Laxilef/OTGateway/assets/2D_PCB_bottom.png

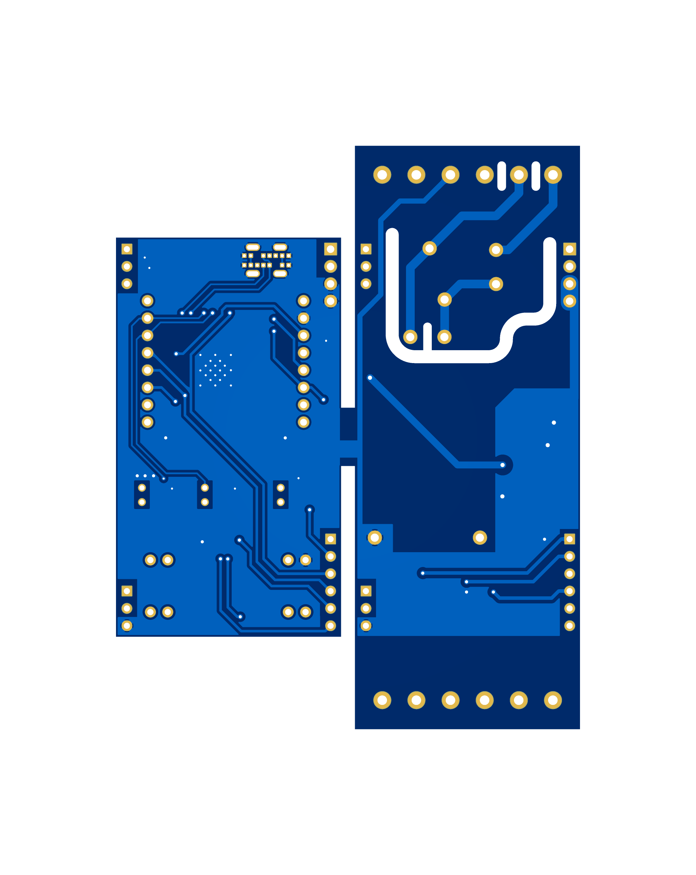
assets/2D_PCB_bottom.png
