Laxilef/OTGateway/assets/2D_PCB_top.png

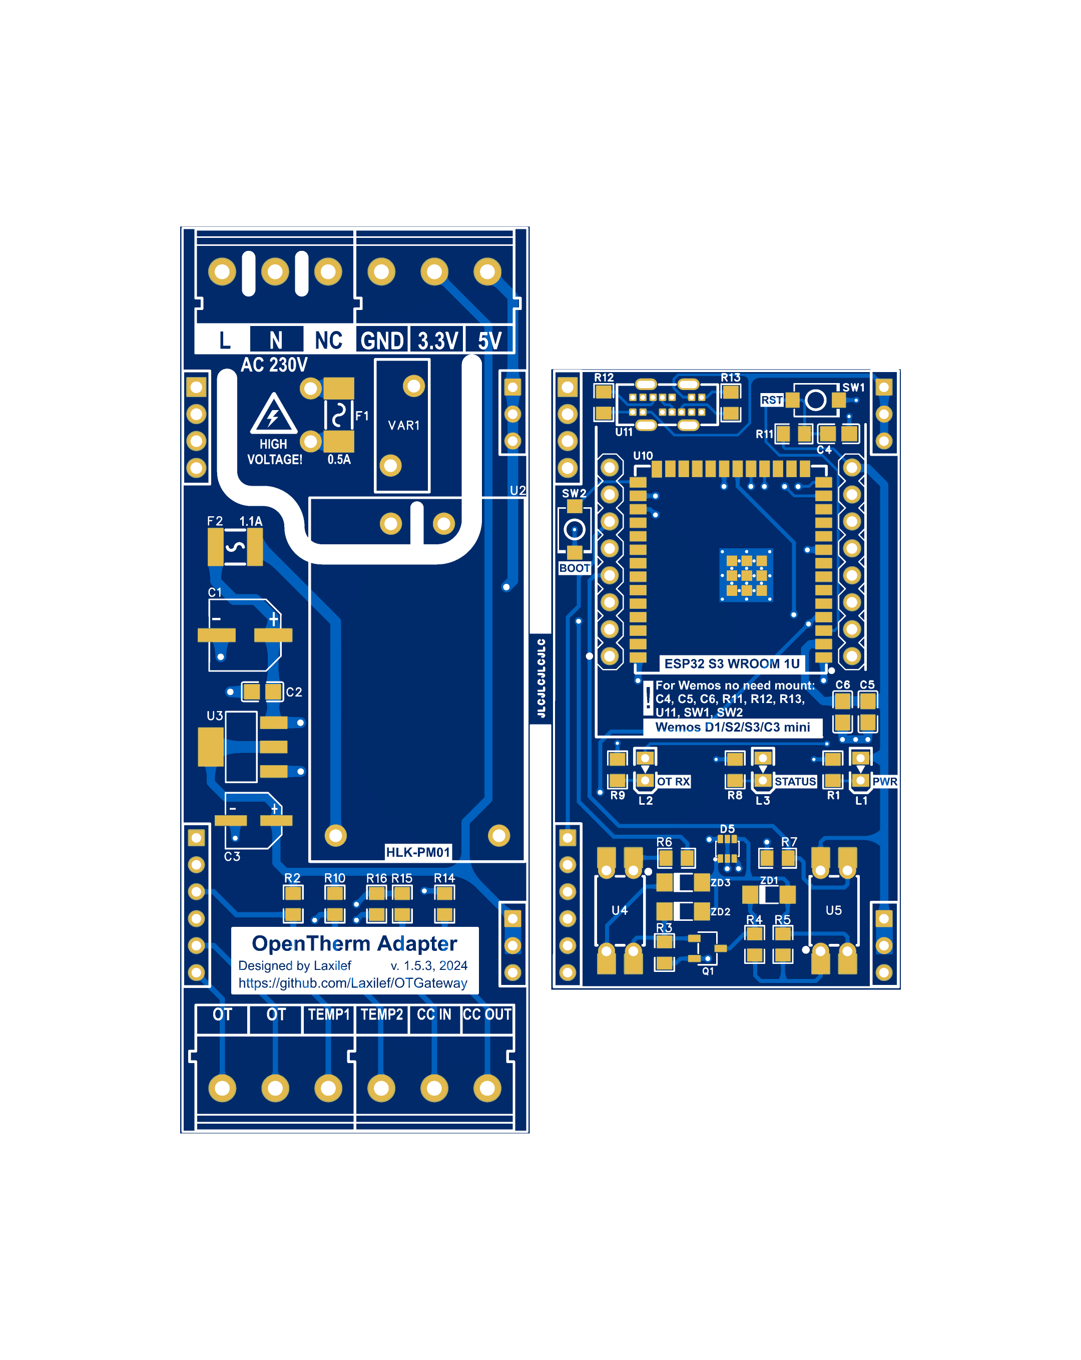
assets/2D_PCB_top.png
