Laxilef/OTGateway/assets/3D_PCB.png

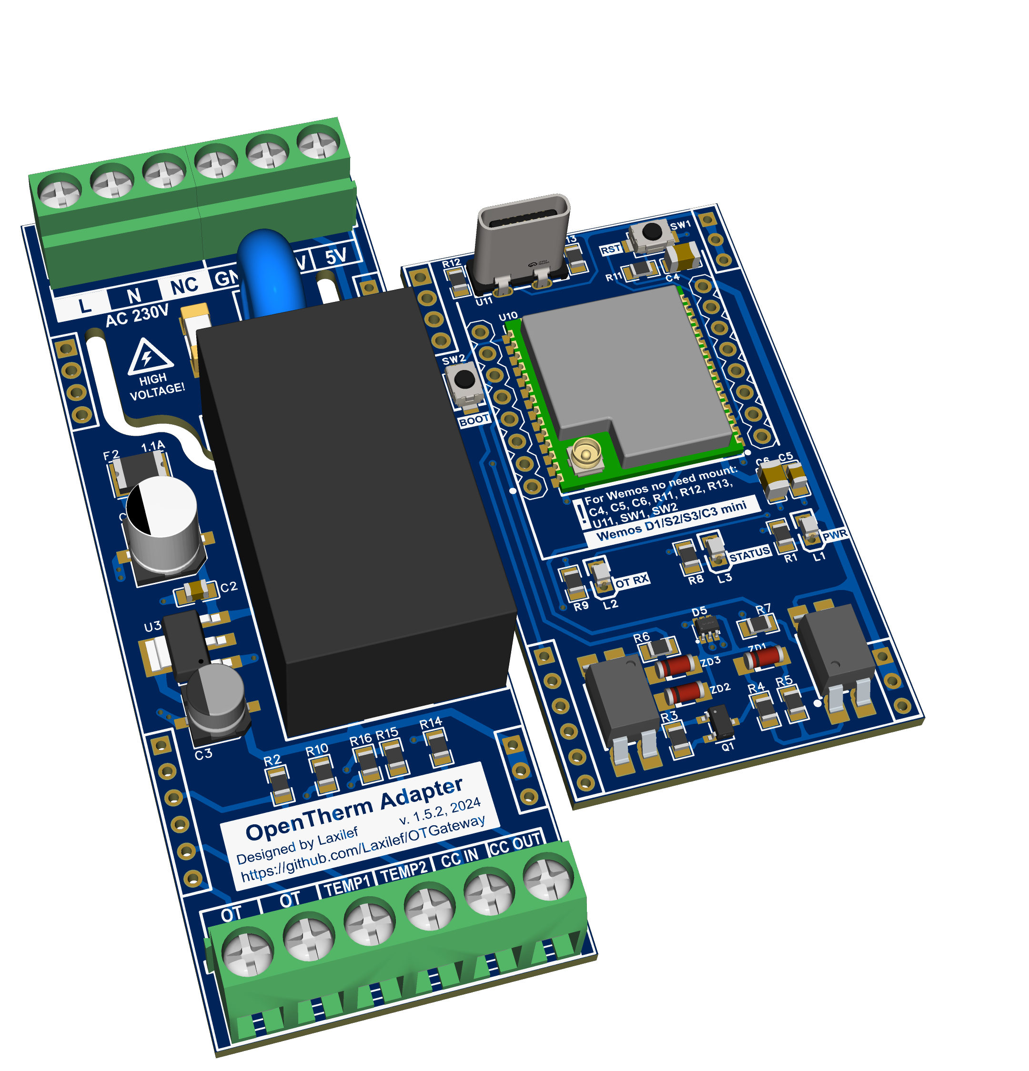
assets/3D_PCB.png
