Laxilef/OTGateway/assets/adapter_schematic_o.png

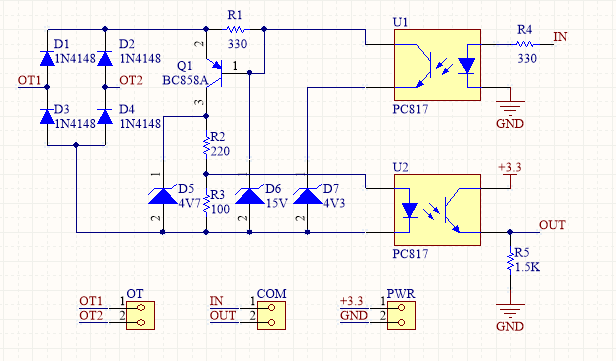
assets/adapter_schematic_o.png
