Laxilef/OTGateway/assets/connection.png

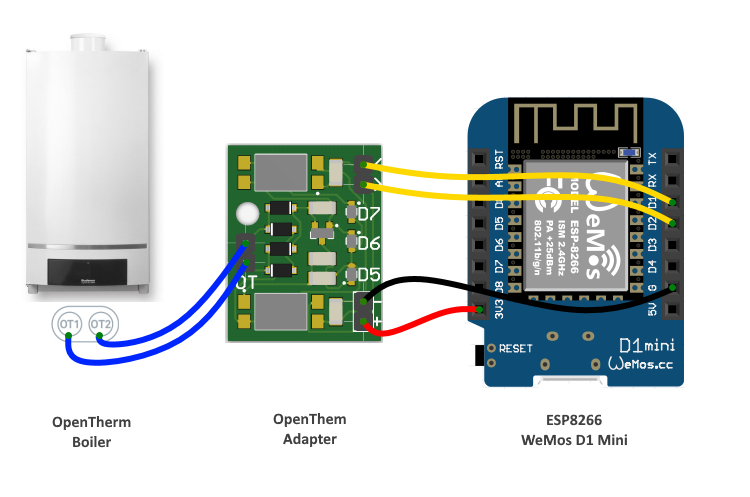
assets/connection.png
