Laxilef/OTGateway/assets/dhw_meter.png

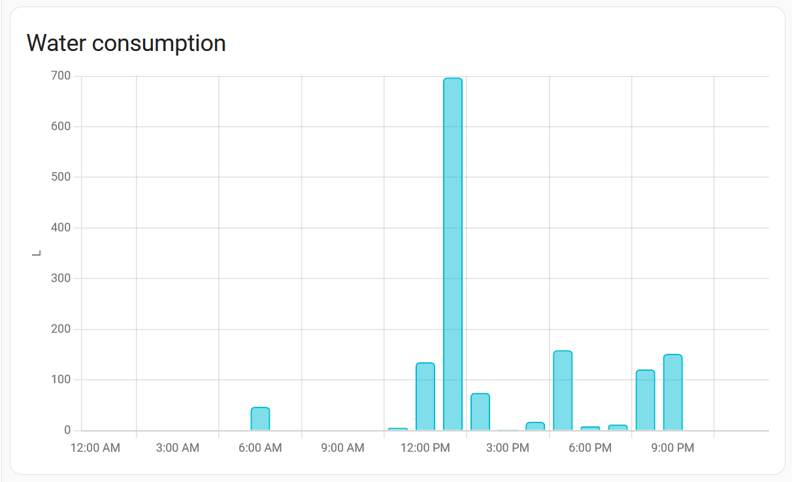
assets/dhw_meter.png
