Laxilef/OTGateway/assets/BOM.xlsx

No. | Designator | Quantity | Footprint | Value | Manufacturer Part | Supplier Part | Supplier | Comment | Add into BOM
1 | C1 | 1 | CAP-SMD_BD6.3-L6.6-W6.6-LS7.2-FD | 100uF | RVT1C101M0605 | C37308 | LCSC | 100uF | yes
2 | C2,C4,C6 | 3 | C0805 | 100nF | GRM21BR71H104KA01L | C77082 | LCSC | 100nF | yes
3 | C3 | 1 | CAP-SMD_BD5.0-L5.3-W5.3-LS6.3-FD | 22uF | RVT1V220M0505 | C72504 | LCSC | 22uF | yes
4 | C5 | 1 | C0805 | 10uF | GRM21BR61C106KE15L | C77075 | LCSC | 10uF | yes
5 | D5 | 1 | SOT-363_L2.0-W1.3-P0.65-LS2.1-TL |  | BAV99S,115 | C96225 | LCSC | BAV99S,115 | yes
6 | F1 | 1 | FUSE-SMD_L6.1-W2.5 | 0.5A | S6125-M2-0.5A | C136377 | LCSC | S6125-M2-0.5A | yes
7 | F2 | 1 | F1812 | 1.1A | MF-MSMF110/16-2 | C210834 | LCSC | MF-MSMF110/16-2 | yes
8 | L1,L2,L3 | 3 | LED0805-R-RD_GREEN |  | SZYY0805YG | C434435 | LCSC | SZYY0805YG | yes
9 | Q1 | 1 | SOT-23-3_L2.9-W1.6-P1.90-LS2.8-BR |  | BC858A | C8583 | LCSC | BC858A | yes
10 | R1,R5,R8,R9 | 4 | R0805 | 100Ω | 0805W8F1000T5E | C17408 | LCSC | 100Ω | yes
11 | R2,R10 | 2 | R0805 | 4.7kΩ | 0805W8F4701T5E | C17673 | LCSC | 4.7kΩ | yes
12 | R3,R6 | 2 | R0805 | 330Ω | 0805W8F3300T5E | C17630 | LCSC | 330Ω | yes
13 | R4,R14,R15 | 3 | R0805 | 220Ω | 0805W8F2200T5E | C17557 | LCSC | 220Ω | yes
14 | R7 | 1 | R0805 | 1.5kΩ | 0805W8F1501T5E | C4310 | LCSC | 1.5kΩ | yes
15 | R11,R12,R13,R16 | 4 | R0805 | 5.1kΩ | 0805W8F5101T5E | C27834 | LCSC | 5.1kΩ | yes
16 | SW1,SW2 | 2 | SW-SMD_L3.9-W3.0-P4.45 |  | TS-1088R-02026 | C455280 | LCSC | TS-1088R-02026 | yes
17 | U2 | 1 | PWRM-TH_HLK-PM01 |  | HLK-PM01 | C209903 | LCSC | HLK-PM01 | yes
18 | U3 | 1 | SOT-223-3_L6.4-W3.5-P2.30-LS7.0-BR |  | AMS1117-3.3 | C2992570 | LCSC | AMS1117-3.3 | yes
19 | U4,U5 | 2 | SMD-4(6.5X4.58) |  | PC817X3NIP1B | C169111 | LCSC | PC817 | yes
20 | U6,U7,U8,U9 | 4 | KLS2-300-5.00-03P-2S |  | XY126V-5.0-3P | C557647 | LCSC | XY126V-5.0-3P | yes
21 | U10 | 1 | WIRELM-SMD_ESP32-S3-WROOM-1U |  | ESP32-S3-WROOM-1U-N4 | C2980296 | LCSC | ESP32-S3-WROOM-1U-N4 | yes
22 | U11 | 1 | USB-C-TH_SHOUHAN_TYPE-C-14PLC-H10.0 |  | TYPE-C 14PLC-H10.0 | C3151746 | LCSC | TYPE-C 14PLC-H10.0 | yes
23 | VAR1 | 1 | RES-TH_L12.5-W5.1-P7.50-D1.2-S2.20 |  | VDR-10D391K | C283937 | LCSC | VDR-10D391K | yes
24 | ZD1 | 1 | SOD-80_L3.5-W1.5-RD | 4.7V | BZV55C4V7 | C545325 | LCSC | BZV55C4V7 | yes
25 | ZD2 | 1 | SOD-80_L3.5-W1.5-RD | 15V | BZV55C15 | C545332 | LCSC | BZV55C15 | yes
26 | ZD3 | 1 | SOD-80_L3.5-W1.5-RD | 4.3V | BZV55C4V3 | C545324 | LCSC | BZV55C4V3 | yes
27 | For manual assembly | 2 | PBS-4 |  | DS1023-1*4S21 |  |  |  | no
28 |  | 2 | PBS-3 |  | DS1023-1*3S21 |  |  |  | no
29 |  | 2 | PBS-8 |  | DS1023-1*8S21 |  |  |  | no
30 |  | 2 | PLS-8 |  | DS1021-1*8SF11-B |  |  |  | no
31 |  | 3 | PLS-10 |  | DS1021-1*10SF112-B |  |  | TYPE 12! Length >= 12mm | no
32 |  | 1 | BOX |  | Gainta D2MG |  |  |  | no
