Laxilef/OTGateway/assets/after_assembly.png

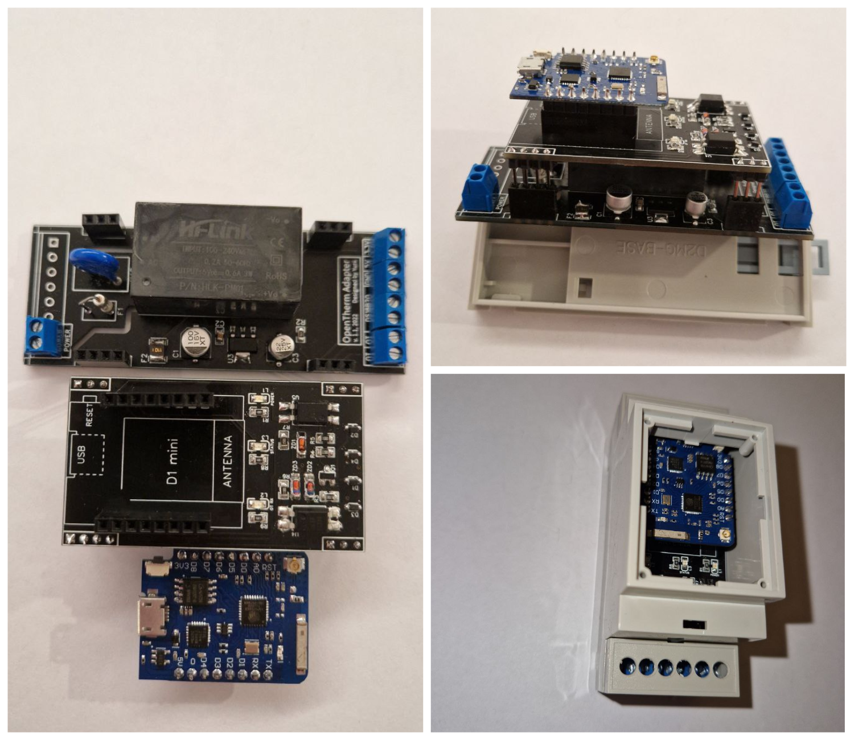
assets/after_assembly.png
