Laxilef/OTGateway/(threads)

Thread 2 (2023-09-19):

Set maximum supply temperature

theelog, 2023-09-19:
Is there a way to control the maximum central heating supply temperature.

It might be an artificial cap on the heating setpoint.
All commercially available thermostats have this feature.

OpenTherm documentatio v.2.2 states this:
`The master decides the actual range over which the control setpoint is defined. The default range is
assumed to be 0 to 100.`

I think I found it in the Settings.h, `heatingMaxTemp` (currently set to 90).

It would be perfect if it were able to be set using Home Assistant.

Laxilef, 2023-09-19:
The controller tries to get the min and max heating temperature from the boiler, if it supports it
https://github.com/Laxilef/OTGateway/blob/3cafcde58c21fbfbba2f645143a325f814e402b8/src/OpenThermTask.h#L319

In variables "vars.parameters.heatingMinTemp" & "vars.parameters.heatingMaxTemp" values by default

theelog, 2023-09-19:
Is the retrieved max reported somewhere?

Laxilef, 2023-09-19:
Via mqtt explorer
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

Laxilef, 2023-09-19:
Maybe later add entities to HA

theelog, 2023-09-19:
Nice, that's even better. I knew I've configured it in the furnace menu at one time.
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

Just sharing a quick way to get it into Home Assistant:
```
mqtt:
  sensor:
    - unique_id: opentherm_heating_max_temp
      name: Opentherm Heating Max Temp
      state_topic: "opentherm/state"
      value_template: "{{ value_json.parameters.heatingMaxTemp }}"
      device_class: temperature
      unit_of_measurement: "%C"
```

Laxilef, 2023-09-21:
Hi
I added new parameters for min and max temperature to the firmware. They now native show in Home Assistant. And now you can set them yourself, but within the limits receive from boiler.

Pls test it

Laxilef, 2023-09-21:
And if you want to receive the indoor temperature from a diyless board, you can set the "Indoor sensor pin" parameter to 14 in the settings (web). After that, in the home assistant, select "Indoor temperature source" = External

Closed 2023-10-08.

Thread 3 (2023-09-21):

Boilers compatibility

Laxilef, 2023-09-21:
Please write here the name of your boiler and its compatibility features (what works, what doesn’t work).
I will add to the table in READ ME.

This will be very useful for other people.

filipjurik, 2023-10-06:
My Baxi Nuvola DUO-TEC HT 16 boiler works well
I'm using Chinese WEMOS D1 MINI + DIYLESS ESP8266 THERMOSTAT SHIELD.
Everything works fine but I have one question.
I don't use equitherm.
Target temperature (heating) is the temperature of the water in the system.. right?

If I have heating turn on (climate.opentherm_heating), but boiler don't heating (i use ON/OFF + zone heating valves), the pump is still running.
Is possible set target temperature in the house, and when it is reached, turning off circulation pump, and using "climate.opentherm_heating" only to control and setting the heating water temperature ?

Laxilef, 2023-10-07:
> My Baxi Nuvola DUO-TEC HT 16 boiler works well
Thanks for the info!

> Is possible set target temperature in the house, and when it is reached, turning off circulation pump, and using "climate.opentherm_heating" only to manually control and set the temperature of the heating water?
Hmm, I think you can turn off the heating using automation in the home assistant. Turning off the heating should turn off the pump.

In my system, just like yours, installed electric valves to accurately regulate the temperature in the zones. And I use equitherm mode. This prevents the heating system from swinging. Try this.

dante1613, 2023-10-16:
Котел: **Ferroli DOMIcompact C 24** (плата **MF08FA**)

Master Member ID: **211**

Конфиг: [WEMOS D1 MINI](https://www.aliexpress.com/item/32863218532.html?spm=a2g0o.order_list.order_list_main.4.e2c41802oCWMlQ) + [DIYLESS Master OpenTherm Shield](https://diyless.com/product/master-opentherm-shield) + датчик [Xiaomi LYWSD03MMC](https://www.aliexpress.com/item/1005004446445069.html?spm=a2g0o.order_list.order_list_main.22.63f81802zOuhX9) (через MQTT [отсылаю](https://github.com/Laxilef/OTGateway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) температуру в топик) + [DS18B20](https://www.aliexpress.com/item/32467815969.html?spm=a2g0o.order_detail.order_detail_item.19.551bf19cngqpsI) на улице (так же в топик через MQTT). Ссылки кликабельные, для тех кто решит повторить мой опыт с таким же котлом

Логика работы: Эквитерм (PID не пробовал)

Не работающие сенсоры и кнопки: **Pressure** (показывает нули) и **Fault code** (ну или нужно дождаться появления ошибок?), **Use equitherm in emergency**

Все остальное работает корректно:

- мин и макс температура для отопления и горячей воды (как в паспорте котла)
- включение и выключение отопления отопления и горячей воды
- отключение горячей воды через выключатель
- показывает процент модуляции
- статус включения обогрева и горячей воды
- статус пламени горелки
- установка температуры для воды и отопления
- установка гистерезиса
- турбо режим (я так понимаю для его работы нужно разница как минимум 1 градус между температурой в доме и установленной на термостате в режиме эквитерм? Так как иногда кнопка отключается и не меняется точка нагрева)

Баг или фича: показывает две **Outdoor temperature source**

<details><summary>Скриншот из Home assistant</summary>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</details>

Работает просто отлично, я прям не ожидал что будет все так просто (котел то довольно старый, 2005 год, думал что вообще не заведется). Сначала прошил собранную прошивку 1.3.1, но не сохранялись настройки MQTT после перезагрузки (еще до того как вы выложили по d1 mini), потом досмотрел что это для d1 mini pro и собрал через Platformio, стало все нормально. Раньше до этого пользовался реле с сухими контактами, а сейчас уже 5 день как пользуюсь вашей прошивкой, так что статистики пока мало. Да и холодов особо не было, до 5 градусов максимум. но температуру держит хорошо, теперь главное как с расходом.
<details><summary>Оффтоп по потреблению</summary>По замерам на минимуме модуляции (2%) потребляет где-то 0.75 куба газа в час, на максимуме (100%) выходит 1.5 куба (хотя по паспорту должно до 2.73 куба, то ли газ такой сейчас в Украине, то ли так настроена подача газа в котле). Теперь как бы сделать сенсор в Home assistant, который будет рассчитывать потребление газа брав данные из сенсора модуляции, по логике: с 2% до 50% модуляции это 0,75 куба, а с 50 до 100% это уже 1.5 куба, так как счетчика отдельного на котел нет и замеры проводились с секундомером и точно не могу посчитать, так как нет возможности самому регулировать модуляцию и точно высчитать сколько газа потребляет в на каждой ступеньке с 2 до 100%, а так хоть будет примерное понимание. Сейчас сделал по <a href="https://seanblanchfield.com/2022/02/virtual-gas-meters-home-assistant">гайду</a> (настраивал еще под реле с сухими контактами) и поставил 1 куб в час при работе отопления и горелки. Кстати по его же <a href="https://seanblanchfield.com/2022/02/virtual-gas-meters-home-assistant">методике</a> балансировал радиаторы отопления</details>

<hr>

Большое спасибо за ваш труд!

Laxilef, 2023-10-16:
@dante1613 спасибо за отзыв!

Давление к сожалению не все котлы показывают. Мои Baxi тоже ничего не возвращают.
Чтобы проверить чтение ошибок можно перекрыть газ во время работы котла, котел должен упасть в ошибку, соответственно потом посмотреть в HA. Если ошибок нет, то сущность недоступна.
Use equitherm in emergency доступен только если выбран датчик уличной температуры External или Boiler. Для расчёта необходима уличная температура, а если мы её передаём из HA, то при отвале Mqtt её больше никто передавать не будет.

Селектор Outdoor temperature source должен быть один,  странно. Id у второго какой?

Что касается расхода газа, посмотрите в сторону съёма показаний с счётчика. Котел может по своим алгоритмом регулировать подачу газа несмотря на показания модуляции.

dante1613, 2023-10-17:
Проверил на чтение ошибок по вашему способу, работает. Сначала показал ошибку E00, а потом сменил статус на E01, который соответствует нужной неисправности (судя по данным с [интернета](https://www.freeboilermanuals.com/ferroli/fault-codes/), хотя там А01 указывают, возможно это для более новых моделей, не могу сказать, так как на моем котле нет экрана чтобы точно узнать). После теста отключил термостат в home assistant и включил заново, после этого котел стал работать как обычно, а Fault code сменился обратно на недоступно.
<details><summary>Скриншоты</summary>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</details>

Касаемо расхода газа, съем показаний с счетчика не подходит, так как он считает не только расход на отопление но и расход на подогрев воды, а так же газовую плиту. Мне то не так важны сами показания в home assistant, а больше как показатель работы системы отопления, чтобы смотреть какой алгоритм более комфортный и экономичный. Про opentherm вроде бы как говорят что с ним больше экономии, чем с термостатом с сухими контактами и в основном это говорилось про PID регулирование, а с ПЗА информации нет. Вот расход газа и показал бы наглядно, экономней это или на том же уровне но с большим комфортом.
А касаемо модуляции, то я в течении 5 дней смотрел и периодически замерял и точно получается что при 2 % потребление 0.75, а при 100% 1.5 куба, показания не меняются. Но эти цифры не линейные, взять 2 % 0,75 за точку отсчета не получится. Примерно с 2 до 50 % это 0,75, а с 50 до 100% уже 1,5. Опять все что не 2 и не 100, трудно выловить, так как чаще всего я вижу котел с этими процентами. По этому и появилась идея, чтобы сделать сенсор, который будет смотреть модуляцию и пересчитывать потом по формуле, но как это сделать я пока не знаю. Мне бы хватило и примерной точности, всяко лучше чем усредненный 1 куб, который сейчас считается на группе сенсоров отопления и горелки и времени их работы.

По поводу Outdoor temperature source, вот что показывает в home assistant:
<details><summary>Скриншоты</summary>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</details>

Еще хотел бы вас попросить, не могли бы вы скинуть скриншоты своих настроек эквитерм режима и графиков работы термостата, чтобы было более понятно правильно ли у меня ПЗА работает или нет. Или может мне стоит еще поиграться с выставлением N K и Т. Это все конечно индивидуально, от площади, утепления дома, температуры на улицы, но хотя бы примерно будет понятно в каком направлении оно должно работать

<details><summary>Скриншоты</summary>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</details>

На график с 11 до 18.30 не обращайте внимания, на улице было больше +15 градусов, по этому я выключил котел. Ну и там где много пробелов, это включался подогрев воды. Гистерезис стоит 0.2 (по 0.1 в каждую сторону верно?)

dante1613, 2023-10-17:
Вот что еще заметил, если к примеру у меня стоит на термостате 23 градуса и в комнате 23, котел на минимальной модуляции (2%) поддерживает температуру 43 градуса (Heating setpoint). Если повысить температуру термостата до 26 градусов, Heating setpoint поменяется на 65, котел включит горелку на 100 % и начнется набор температуры, но если поменять температуру на термостате обратно на 23 градуса, Heating setpoint вернется обратно к 43 градусам, но котел все так же продолжит набирать температуру со 100% модуляцией, помогает только выключение и включение обратно термостата, либо уменьшение температуры на термостате, к примеру с 23 до 22, тогда термостат его отключит сам. Вряд ли кто-то будет использовать в таком режиме, переключая туда-обратно, но заметил такой момент. Не понятно в чем именно причина, в прошивке или в мозгах котла или просто особенность работы такая.

dante1613, 2023-10-17:
Нашел причину, почему у меня два **Outdoor temperature source**. Перед тем как собрать прошивку через Platformio, я перепробовал все версии прошивок из релизов, от 1.2.1. до 1.3.1, думал дело в них или то что у меня глючит d1 mini, так как я ее снял с самодельного пульта для кондиционера (в запасе не было еще одной d1 mini, пульт для кондера до лета и не нужен). От в 1.2.1 и был этот селектор, а так как базовый топик один и тот же, то MQTT его сохранила, а я этого не заметил, так как когда пробовал прошивки, то только проверял их на сохранение данных MQTT и не запомнил какие именно должны быть настройки. Через MQTT Explorer нашел топик и там указана прошивка 1.2.1, после этого я уже вспомнил что менял их. Удалил этот топик, пропал селектор и больше не появляется
<details><summary>Скриншот</summary>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</details>

Balaganoff, 2023-10-17:
Котёл AEG GBA124 - все завелось с первого раза. Не показывает только давление в системе, хотя ошибку по давлению показывает. Скорее всего в котле просто датчик который выдает дискретный сигнал при понижении порогового давления, а верхний предел сбрасывает клапан.
Спасибо за работу!!
 Ждем продолжения и расширенного функционала у автономного устройства. Мало-ли что с компьютером в зиму случится )) Хотелось бы чтобы HomeAssistant выполнял контролирующие функции и автоматику. А основное бы работало на ESP. Я имею ввиду чтобы можно было регулировать и просматривать через веб интерфейс.
 Типа такого
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

Laxilef, 2023-10-17:
> Еще хотел бы вас попросить, не могли бы вы скинуть скриншоты своих настроек эквитерм режима и графиков работы термостата, чтобы было более понятно правильно ли у меня ПЗА работает или нет. Или может мне стоит еще поиграться с выставлением N K и Т. Это все конечно индивидуально, от площади, утепления дома, температуры на улицы, но хотя бы примерно будет понятно в каком направлении оно должно работать

Хорошо, когда будут морозы - выложу. Сейчас у меня котел включается раз в несколько дней, там не оч интересные графики :)
Судя по вашим графикам, у вас с N коэф. перебор. Проще всего его подобрать установив гистерезис в 0, K = 0, T = 0, установить 20 градусов и подбирать коэф. N так, чтобы стабильно поддерживалось 20 градусов. Ночные показатели оптимальнее, т.к. солнцем не догревает помещения.

После этого крутить K коэф. для поддержания температур отличных от 20 градусов. T коэф. отвечает за резкость регулирования. А после подбора этих коэф. можно включить гистерезис, чтобы отключать нагрев, когда днем солнце нагревает помещение.

> но если поменять температуру на термостате обратно на 23 градуса, Heating setpoint вернется обратно к 43 градусам, но котел все так же продолжит набирать температуру со 100% модуляцией

Котел со 100% модуляцией греет теплоноситель до 43 или до 65?

> Мало-ли что с компьютером в зиму случится )) Хотелось бы чтобы HomeAssistant выполнял контролирующие функции и автоматику. А основное бы работало на ESP.

Сейчас так и есть. Если контроллер не сможет подключиться к mqtt серверу или не сможет подключиться к wifi, то он переходит в аварийный режим (emergency mode) и будет поддерживать заданную для emergency mode температуру в заданном режиме. Но вот менять параметры температуры не получится.

Добавить регулировку температуры из веба можно, но при отвале wifi это не решит проблему)

dante1613, 2023-10-17:
> Судя по вашим графикам, у вас с N коэф. перебор

N сначала использовал по дефолту 0.7, потом до 0.8 поднял, значит нужно опустить?

> Котел со 100% модуляцией греет теплоноситель до 43 или до _65?_

До 65 градусов

Balaganoff, 2023-10-17:
> Добавить регулировку температуры из веба можно, но при отвале wifi это не решит проблему)

Почему ? ESP ведь сама в качестве точки доступа и web сервера может

Laxilef, 2023-10-17:
> N сначала использовал по дефолту 0.7 (как в рекомендации по настройке), потом до 0.8 поднял, значит нужно опустить?

Попробуйте поставить N=0.7-0.8, K = 0, T = 0. Если будет поддерживать 20 +- 0.2 ночью, тогда K уменьшать. T выше 2.5 не рекомендую, будет раскачивать систему, только если нужно резко нагреть дом, но для этого есть "турбо режим", он задирает коэф. T.

> До 65 градусов

Такого не должно быть. Возможно, котел игнорирует частую установку температуры. Добавил в мастер ветку принудительную установку температуры раз в минуту. Попробуйте скомпилить прошивку из мастер ветки и проверить.

> Почему ? ESP ведь сама в качестве точки доступа и web сервера может

Если вы постоянно находитесь рядом с контроллером, то м.б. и выход. Но в этом случае проще починить сеть и/или mqtt сервер на HA. Если не рядом, то при отключении wifi вы к хотспоту не сможете же подключиться.

menuet88, 2023-10-17:
Hello,
Basically I've use this software with custom board to control the Thermet Ecocondens Silver 35kW boiler. First impression - it works. The **boiler doesn't report the water pressure** (there is no sensor for that), all other functions works ok. In the logs also requests 126 and 127 are invalid. I've just start testing it, for sure I came back to write my suggestions.

One question: is there any particular reason why you set DHW temperature to zero when DHW is off? It would be nice to have this reading all the time, because in my case it shows the water reservoir temperature.
And suggestion: Maybe, if the boiler doesn't support some features over opentherm (report INVALID) there is a chance to count this invalid response for request and if is for example 10 then remove this request? I know that this doesn't change anything, but I don't like when something throwing errors :)

Best regards,
Menuet88

Laxilef, 2023-10-17:
@menuet88, thanks for the info!

> One question: is there any particular reason why you set DHW temperature to zero when DHW is off?

I'll fix this in the next version.

> And suggestion: Maybe, if the boiler doesn't support some features over opentherm (report INVALID) there is a chance to count this invalid response for request and if is for example 10 then remove this request? I know that this doesn't change anything, but I don't like when something throwing errors :)

I thought about it. But I decided to leave it as is. Because different boilers have different software. We can break the logic of the controller on boilers that do not fully implement the opentherm specification.

Rolex48, 2023-11-04:
Baxi duo-tec compact 1.24 пока не выходит подключить, плату проверили по схеме несколько раз - всё в норме.(собрана на макетке)
Откуда берёте "Идентификатор главного участника"? ЕСП прошилась адекватно и настроилась.
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

Laxilef, 2023-11-05:
Даже с некорректным member master id котёл должен отвечать на базовые запросы. Подбирают методом перебора, но это необходимо только в том случае, если котлом не получается управлять (менять температуру и т.п.)

Если у вас вообще котел не отвечает, проверьте в настройках пины OT. Иногда помогает поменять их местами.

bigbrother72, 2023-11-06:
> Что касается расхода газа, посмотрите в сторону съёма показаний с счётчика.

Здравствуйте
Я два года уже пользуюсь для подсчета расхода газа проектом
https://github.com/jomjol/AI-on-the-edge-device

Данные берутся с фото счетчика, оцифровываются и выгружаются по mqtt в HA. Можно смотреть статистику по часам, дням, неделям, месяцам, годам..

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

По OTGateway.
Можно добавить в список совместтимости BAXI LUNA-3.

Данные о внешней температуре получаю с датчика котла.
Внутренняя температура через автоматизацию в HA с датчика esphome.

Также немного переделал код в части встроенного датчика температуры на контроллере Opentherm. У меня DS18B20 примотан к трубе обратки около самого котла и в HA передается температура обратки тоже.
Было бы неплохо ка-то предусмотреть в проекте такой вариант.

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

Laxilef, 2023-11-06:
@bigbrother72, благодарю за информацию. А зачем снимать температуру обратки, если мы на нее нигде не ориентируемся?

aurelmarius, 2023-11-20:
Viessmann Vitodens 0-50w, working nicely.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

Laxilef, 2023-11-22:
@aurelmarius thanks for the info!

kulisau, 2023-11-23:
Boiler: **Radiant r2k 24**
Everything but the pressure sensor works.
DHW is working without the heating on only if the following settings are disabled:
- Opentherm CH2 enabled
- Opentherm heating CH1 to CH2
- Opentherm DHW to CH2

And the following enabled:
- Opentherm DHW present
- Opentherm summer/winter mode

kerajkeraj, 2023-11-23:
Hello All,
i am using gas boiler BAXI duotec 24, current setup is:
dyiless gateway hw - master, slave and wemos d1 mini esp8266.
Boiler part and master part works as expected - i can manage temp of CH and DHW in homeassistant.

I am facing issues with existing thermostat BAXI connected to slave shield - it reports error 83 as can be seen on attached photos:

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

Anyone could help on slave-thermostat side?

Thank you for your help

Laxilef, 2023-11-26:
@kerajkeraj it won't work the way you want.  The baxi thermostat is the master, the firmware from this repository is also the master, and the boiler is the slave.
2 masters will conflict. Because in this firmware use algorithms to calculate the heating temperature. But your thermostat doesn't know about it. And the thermostat will try to overwrite the temperature that the controller set.

kulisau, 2023-11-28:
Boiler: Radiant R2KA
Central heating works out of the box, DHW requires the "Modulation sync with heating" setting toggled in controller's settings.
The pressure and DHW flow sensors are unavailable.

michielbeijer, 2023-12-06:
Intergas Kombi Kompakt working fine with Diyless Thermostat shield. Combi boiler, so hot water is on demand only. All parameter (relevant to me) reporting / being set correctly. Master ID = 0.

strk90, 2023-12-10:
Baltur Tesis 24 works.
Сontrol board - Nordgas 5002001904.
Thank a lot!

MikelillOi, 2023-12-12:
I have assembled a DIYLESS Thermostat shield with a D1 Mini and installed version 1.3.3

It works with my Domusa Bioclass HM 16 pellet boiler. I have left the master ID with value 0 (default)

Almost everything works, DHW, correct. Diagnostics, fault messages, etc. ok. But I don't see the % modulation, my old Tado showed me that value. Is there any way to see it? I'm interested to see if the modulation works well. I don't see the value of pressure either.

On the other hand, wouldn't it be more correct to show the HW controller in HA as water_heater entity and not as climate?

Laxilef, 2023-12-12:
@MikelillOi modulation and pressure entities are not activated by default. You need to [activate them](https://github.com/Laxilef/OTGateway/wiki/FAQ-&-Troubleshooting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) in Home Assistant.

MikelillOi, 2023-12-12:
> @MikelillOi thanks for the info! Modulation and pressure entities are not activated by default. You need to [activate them](https://github.com/Laxilef/OTGateway/wiki/FAQ-&-Troubleshooting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) in Home Assistant.

Thank you! Now I see both data. But modulation still at 0. An the boiler heating is always turning on, and off

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

I read about "Modulation sync with heating" parameter, but I can´t find it. Will this solve the problem I mentioned?

Laxilef, 2023-12-12:
When the burner is on, the entity "flame" is displayed on?
Does the burner really turn off when the status is heating=off?

Suxsem, 2023-12-12:
Ferroli Kalis 24C, ALL SENSORS AND CONFIGS work perfectly. Default master member id. Boiler does not have a builtin external temperature sensor so I'm using weather forecasts with automation to copy the external temperature value.

Awesome project, I just replaced (and sold) my 150€ "ferroli connect" thermostat with a 15€ board that gives me lots of flexibility, thank you!!

MikelillOi, 2023-12-12:
> When the burner is on, the entity "flame" is displayed on? Does the burner really turn off when the status is heating=off?

i'm not at home now and I can't check if the boiler really turn off. Then, when I arrive at home I will make some tests.

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

Here you have the 3 sensors, heating, flame and modulation

Laxilef, 2023-12-12:
Your "flame" is always on, even when heating = off.
I don't know why this could be, but it's not right. The request for get modulation is standard.  If it is always 0, then the boiler does not support this request.

MikelillOi, 2023-12-12:
> Your "flame" is always on, even when heating = off. I don't know why this could be, but it's not right. The request for get modulation is standard. If it is always 0, then the boiler does not support this request.

I can confirm that the boiler continues to work even though it appears as off in the integration.

The comercial Tado thermostat showed the modulation percentage correctly. Can we read any log or something to investigate it?

DeadlySin2, 2024-01-19:
> Также немного переделал код в части встроенного датчика температуры на контроллере Opentherm. У меня DS18B20 примотан к трубе обратки около самого котла и в HA передается температура обратки тоже. Было бы неплохо ка-то предусмотреть в проекте такой вариант.
>
А можно спросить где конкретно и какой код правили?

hoddl, 2024-01-29:
Thank you for the Projekt. Very Helpfull.
It works at an Remeha Avanta Plus, an older Gateway Module from DIYLESS with  D1 Mini.
My DHW has no tank, it works as flow heatig  so wenn the DHW themp is set to 40° and on, the heating try to reach 40° so i have to switch off the DHW or is ther any chance to report the temperatur of the flow DHW?

Pressure sensor is not supported. (I found the entity and activated it)
I didn't found the DHW flow entity?

Laxilef, 2024-01-30:
@hoddl try unchecking "CH2 always enabled". DHW flow rate is supported from 1.4.0, you can build the firmware [from sources](https://github.com/Laxilef/OTGateway/wiki#build-firmware).

DeadlySin2, 2024-01-31:
Can confirm that this firmware works with Baxi Luna 3 Comfort.
I have three-way valve instaled with with an indirect heating boiler so i swithced the folowing parametrs:
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

hoddl, 2024-01-31:
Thank you. I try to build version 1.4.0-rc-12 from Github. At the configuration screen at 192.168.4.1 comes "The Filesystem is not flashed". The precompiled version 1.3.3 works fine.

PavelTelnov, 2024-01-31:
Можно добавbть Navien NCB700
Собрал плату, прошил, подключил к котлу, подключил к HA. Наблюдаю работу в Grafana.
Котел регулирует температуру по обратке.
Панель Opentherm Gateway Heating - при изменении настроек температуры, на дисплее котла ничего не меняется.
Панель Opentherm Gateway DHW - при изменении настроек температуры, на дисплее котла ничего не меняется.
Так и должно быть?
Задача: управлять температурой горячей воды через HA. Стоит планшет в ванной, для себя хочу налить погорячее, для детей похолоднее. Не хочется бегать в котельную.
Вопрос 2: отображение температуры обратки можно реализовать?
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

Maximper, 2024-02-01:
Пробую с котлом Buderus u072 24. Собирал в platformioпоследнюю версию.  Плата ESP32-WROOM-32D. Подключился, можно устанавливать температуру отопления и бойлера. Вижу температуру контура отопления, с датчика бойлера через котел информация не приходит. Через некоторое время связь отвалилась, попробовал старый ot адаптер который стоял до этого с версией esphome и точно работал, тоже самое.
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

Laxilef, 2024-02-01:
@DeadlySin2 thanks for info!

@Maximper попробуйте сейчас собрать прошивку, поправил тайминги в последних коммитах. О проблемах лучше в отдельном issue.

Laxilef, 2024-02-04:
@andrey150960 после изменения флагов ESP перезагружали? Откройте отдельный issue.

andrey150960, 2024-02-04:
https://github.com/Laxilef/OTGateway/issues/3#issuecomment-1925822816
После д.бого изменения делал перезагрузку. В настройках котла поставил режим "1" -это термостат или ПДУ.
При отключенном ПДУ ( без ESP32) термостат (сухой контакт)  работает.

Maximper, 2024-02-06:
Buderus U072 18 и Buderus U072 24 прекрасно работают! Спасибо! пробовал и на esp32 и на wemos d1 mini. Можно ставить в совместимость. Работает управление отоплением полностью, воды только выставляем температуру до которой греется, датчика бойлера не видно. Максимальные и минимальные значения температуры отопления/гвс только в режиме просмотра. Показывает % модуляции. Можно просмотреть и сбросить ошибку котла.

Druid336, 2024-02-12:
Котел Baxi ECO Life 1.24F работает прекрасно на прошивке 1.4.0 rc14
надо поиграться с настройками ПЗА и вывести на идеал, очень доволен. Спасибо за быстрый отклик в телеграм-канале и решение проблем.
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

DeadlySin2, 2024-02-13:
Changed parametrs for Baxi Luna3 Comfort на Dublicate DHW to CH2. With previous hot warter does'nt work when heating is disabled. (I have edited my previous message)

MrDogYar, 2024-02-29:
Работает.
Котел bosch gaz 6000 w wbn 6000-24
(Wemos D1 mini) - firmware_d1_mini_1.4.0-rc.13
Внешние датчики температуры

На 15 релизе не работает. Датчики уличной и комнатной температуры каждые 5 секунд обнуляються.
Котел каждые 2 секунды включаеться и выключаеться.

Laxilef, 2024-02-29:
@MrDogYar спасибо за информацию! Проблема с датчиками исправлена в rc16.

MrDogYar, 2024-03-10:
BAXI eco4s не завелось :-(
Invalid response after setBoilerStatus: TIMEOUT
Беглый опрос гугл показал, что там protocol OpenTherm v2.2

Laxilef, 2024-03-11:
@MrDogYar откройте issue и приложите логи с момента старта esp, напишите какой адаптер, какая esp и какая версия прошивки. Протокол от версии к версии не менялся настолько, чтобы сломать обратную совместимость. TIMEOUT - нет ответа от котла.

MrDogYar, 2024-03-11:
Добрый день!
Завел Issue по проблеме отсутствия связи с котлом.
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

Thread 4 (2023-10-09):

ESP32 compatibility

Nedjumiiro, 2023-10-09:
Will there be ESP32 support?

Laxilef, 2023-10-09:
Didn't check. I think it won't work because the ESP8266Scheduler library is used

Closed 2023-10-17.

Thread 5 (2023-10-10):

Работа в режиме PID

bigbrother72, 2023-10-10:
Если включен PID режим, то температура вычисляется, только когда котел набирает температуру
Функция getPidTemp() вызывается только в одну сторону.
```

    if (settings.pid.enable && vars.states.heating) {
      float pidResult = getPidTemp(....

```
По достижении температуры, котел просто отключается, и setpoint далее не меняется.

Потом когда температура в помещении упадет меньше заданной, то котел  опять включается и начинает работать с предыдущей температуры - т.е .просто дискретный термостат on/off

И это еще не всё. После нескольких циклов что-то зависает и далее просто не включается отопление.

Установлено 21 градусов целевая температура.
Сегодня утром проснулся. Дома холодно - 20.4 градусов,

Перезагрузил openterm  контроллер около 10 утра

В течении дня несколько раз набирало эту температур.
Сейчас до +20,8 уже упало.
Через telnet вижу, что
[INFO] Heating enabled: 1

Но отопление не включается

Все видно на графиках

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

Скорее всего в коде openthermtask.h не работает ветка, так как heatingSetpoint  постоянно один и тот же

    // Температура отопления
    if (heatingEnable && fabs(vars.parameters.heatingSetpoint - currentHeatingTemp) > 0.0001) {
      INFO_F("Setting heating temp = %u \n", vars.parameters.heatingSetpoint);

      // Записываем заданную температуру
      if (ot->setBoilerTemperature(vars.parameters.heatingSetpoint)) {
        currentHeatingTemp = vars.parameters.heatingSetpoint;

      } else {
        WARN("Failed set heating temp");
      }
    }

После того как я поменял через температуру с +75 обогрева на 72 градуса, то сработала эта ветка и в телнете увидел:
[INFO] Setting heating temp = 72
[INFO] Heating enabled: 1

и обогрев начался.

Laxilef, 2023-10-11:
Какой у вас котёл? Какое значение параметра hysteresis?
Предполагается, что vars.states.heating должен быть true даже если горелка котла выключена.

Laxilef, 2023-10-11:
Проверьте

https://github.com/Laxilef/OTGateway/releases/tag/1.3.1

bigbrother72, 2023-10-11:
> Какой у вас котёл? Какое значение параметра hysteresis? Предполагается, что vars.states.heating должен быть true даже если горелка котла выключена.

Котел Baxi Luna 3.
hysteresis =0.1

Еще вопрос:

В нижеуказанном коде наверное надо поменять лимиты 0-100 на vars.parameters.heatingMinTemp, vars.parameters.heatingMaxTemp, так как котел не может выдавать от 0 до 100 градусов температуру отопления.
```
    newTemp = round(newTemp);
    newTemp = constrain(newTemp, 0, 100);
    return newTemp;
```

bigbrother72, 2023-10-11:
> Проверьте. Должно быть исправлено. После обновления настройки сбросятся на дефолтные, сохраните их перед обновлением, чтобы потом заново выставить.
>
> https://github.com/Laxilef/OTGateway/releases/tag/1.3.1

завтра попробую.

Laxilef, 2023-10-11:
> В нижеуказанном коде наверное надо поменять лимиты 0-100 на vars.parameters.heatingMinTemp, vars.parameters.heatingMaxTemp, так как котел не может выдавать от 0 до 100 градусов температуру отопления.

Там несколько лимитов дальше идет, последний:
https://github.com/Laxilef/OTGateway/blob/6d3172b73b2033a36a3b7c643ee0d3380d3fc5f4/src/RegulatorTask.h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

Symon84, 2025-01-22:
Hello, in my case I have both the PID and EQUITHERM active..
The hysteresis value is set to 0.5.I note that the PID calculates the value with respect to the setpoint temperature, i.e.: 20.5 degrees. Therefore, when the ambient temperature drops to 20.4 degrees, the PID increases the supply setpoint, but the boiler still has to start because it will start at 20 degrees.
As a result, every time the boiler turns on at 20 degrees, the flow temperature setpoint is always at maximum (PID + EQUITHERM), and then gradually lowers as the ambient temperature rises.
Is it possible to synchronize the PID with the boiler start-up?
Or with the desired room temperature setpoint - the hysteresis value?
It would be great if this thing could be enabled with a flag like "PID hysteresis sync"

Laxilef, 2025-01-23:
Hi @Symon84
Can you show the graph of ``sensor.opentherm_heating_temp``, ``sensor.opentherm_heating_setpoint_temp`` and ``binary_sensor.opentherm_flame``?

Symon84, 2025-01-23:
> Hi [@Symon84](https://github.com/Symon84) Can you show the graph of `sensor.opentherm_heating_temp`, `sensor.opentherm_heating_setpoint_temp` and `binary_sensor.opentherm_flame`?

Yes:

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

and this is a detail with indoor temp:

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

Closed 2023-10-21.

Thread 6 (2023-10-13):

Проблемы с настройками.

Balaganoff, 2023-10-13:
С моим котлом AEG GBA124 прошивка не работает. Хотя другие (тасмота+опентерм и пр.) видят мой котел и регулируют.
Тут использована какая-то урезанная библиотека ?

Вот ниже прилагаю лог из работающей Tasmota+opentherm

16:10:29.055 MQT: Подписаться на cmnd/tasmota_FD7A71/#
16:10:29.056 MQT: Подписаться на cmnd/tasmotas/#
16:10:29.058 MQT: Подписаться на cmnd/DVES_FD7A71_fb/#
16:10:29.061 MQT: tele/tasmota_FD7A71/INFO1 = {"Info1":{"Module":"Generic","Version":"13.1.0(TasmoCompiler-esp82664M)","FallbackTopic":"cmnd/DVES_FD7A71_fb/","GroupTopic":"cmnd/tasmotas/"}}
16:10:29.070 MQT: tele/tasmota_FD7A71/INFO2 = {"Info2":{"WebServerMode":"Admin","Hostname":"tasmota-FD7A71-6769","IPAddress":"192.168.1.4"}}
16:10:29.084 MQT: tele/tasmota_FD7A71/INFO3 = {"Info3":{"RestartReason":"Software/System restart","BootCount":5}}
16:10:29.096 TFS: File 'autoexec.bat' not found
16:10:29.222 [OTH]: perform handshake
16:10:29.665 [OTH]: Processing response. Status=SUCCESS, Response=0xC0030129
16:10:29.666 [OTH]: getLastResponseStatus SUCCESS. Slave Cfg: C0030129
16:10:30.122 SRC: MQTT
16:10:30.124 CMD: Grp 0, Cmd 'STATUS', Idx 1, Len 1, Pld 1, Data '1'
16:10:30.130 MQT: stat/tasmota_FD7A71/STATUS1 = {"StatusPRM":{"Baudrate":115200,"SerialConfig":"8N1","GroupTopic":"tasmotas","OtaUrl":"","RestartReason":"Software/System restart","Uptime":"0T00:00:08","StartupUTC":"2023-10-13T15:10:22","Sleep":50,"CfgHolder":4617,"BootCount":4,"BCResetTime":"2023-10-13T15:52:54","SaveCount":14,"SaveAddress":"1000"}}
16:10:30.172 SRC: MQTT
16:10:30.175 CMD: Grp 0, Cmd 'STATUS', Idx 1, Len 2, Pld 11, Data '11'
16:10:30.181 MQT: stat/tasmota_FD7A71/STATUS11 = {"StatusSTS":{"Time":"2023-10-13T16:10:30","Uptime":"0T00:00:08","UptimeSec":8,"Heap":23,"SleepMode":"Dynamic","Sleep":50,"LoadAvg":28,"MqttCount":1,"Wifi":{"AP":1,"SSId":"MiHome","BSSId":"74:4D:28:BF:88:1C","Channel":11,"Mode":"11n","RSSI":54,"Signal":-73,"LinkCount":1,"Downtime":"0T00:00:05"}}}
16:10:30.316 QPC: Reset
16:10:30.351 [OTH]: Processing response. Status=SUCCESS, Response=0x40000200
16:10:30.354 SRC: MQTT
16:10:30.357 CMD: Grp 0, Cmd 'STATUS', Idx 1, Len 2, Pld 10, Data '10'
16:10:30.365 MQT: stat/tasmota_FD7A71/STATUS10 = {"StatusSNS":{"Time":"2023-10-13T16:10:30","DS18B20":{"Id":"00000215ECB7","Temperature":24.9},"OPENTHERM":{"conn":"READY","settings":3,"SLAVE":{"FAULT":0,"CH":0,"DHW":0,"FL":0,"COOL":0,"CH2":0,"DIAG":0,"RAW":1073742336}},"TempUnit":"C"}}
16:10:30.452 [OTH]: Setting Boiler Temp. Old: 0, New: 85, Force: N
16:10:30.903 [OTH]: Processing response. Status=SUCCESS, Response=0xD0015500
16:10:31.005 [OTH]: Setting Hot Water Temp. Old: 0, New: 36
16:10:31.489 [OTH]: Processing response. Status=SUCCESS, Response=0xD0382400
16:10:32.095 [OTH]: Processing response. Status=SUCCESS, Response=0xC0050000
16:10:32.195 APP: Количество загрузок 5
16:10:32.952 CFG: Сохранено во флэш-память 3FB, Подсчет 15, Байт 4096
16:10:32.959 [OTH]: Processing response. Status=INVALID, Response=0x70730000
16:10:33.165 MQT: tele/tasmota_FD7A71/STATE = {"Time":"2023-10-13T16:10:33","Uptime":"0T00:00:11","UptimeSec":11,"Heap":23,"SleepMode":"Dynamic","Sleep":50,"LoadAvg":55,"MqttCount":1,"Wifi":{"AP":1,"SSId":"MiHome","BSSId":"74:4D:28:BF:88:1C","Channel":11,"Mode":"11n","RSSI":58,"Signal":-71,"LinkCount":1,"Downtime":"0T00:00:05"}}
16:10:33.196 MQT: tele/tasmota_FD7A71/SENSOR = {"Time":"2023-10-13T16:10:33","DS18B20":{"Id":"00000215ECB7","Temperature":24.9},"OPENTHERM":{"conn":"BUSY","settings":3,"SLAVE":{"FAULT":0,"CH":0,"DHW":0,"FL":0,"COOL":0,"CH2":0,"DIAG":0,"RAW":1073742336},"BTMP":{"FAULT":0,"REQ":85.0,"ACT": 85.0},"HWTMP":{"REQ":36.0,"ACT": 36.0},"ASFF":{"FC":0,"OFC":0}},"TempUnit":"C"}
16:10:33.583 [OTH]: Processing response. Status=SUCCESS, Response=0xC0110000
16:10:33.640 HTP: Управление
16:10:34.135 [OTH]: Processing response. Status=SUCCESS, Response=0x40191800
16:10:34.736 [OTH]: Processing response. Status=SUCCESS, Response=0x401A1700
16:10:35.340 [OTH]: Processing response. Status=INVALID, Response=0x601B0000
16:10:35.748 HTP: Консоль
16:10:35.971 [OTH]: Processing response. Status=INVALID, Response=0x701C0000
16:10:36.521 [OTH]: Processing response. Status=SUCCESS, Response=0x40382400
16:10:37.126 [OTH]: Processing response. Status=SUCCESS, Response=0xC0390000
16:10:37.734 [OTH]: Processing response. Status=SUCCESS, Response=0xC00A0C00
16:10:38.204 MQT: tasmota/discovery/3C6105FD7A71/config = {"ip":"192.168.1.4","dn":"Tasmota","fn":["Tasmota",null,null,null,null,null,null,null],"hn":"tasmota-FD7A71-6769","mac":"3C6105FD7A71","md":"Generic","ty":0,"if":0,"ofln":"Offline","onln":"Online","state":["OFF","ON","TOGGLE","HOLD"],"sw":"13.1.0","t":"tasmota_FD7A71","ft":"%prefix%/%topic%/","tp":["cmnd","stat","tele"],"rl":[0,0,0,0,0,0,0,0,0,0,0,0,0,0,0,0,0,0,0,0,0,0,0,0,0,0,0,0,0,0,0,0],"swc":[-1,-1,-1,-1,-1,-1,-1,-1,-1,-1,-1,-1,-1,-1,-1,-1,-1,-1,-1,-1,-1,-1,-1,-1,-1,-1,-1,-1],"swn":[null,null,null,null,null,null,null,null,null,null,null,null,null,null,null,null,null,null,null,null,null,null,null,null,null,null,null,null],"btn":[0,0,0,0,0,0,0,0,0,0,0,0,0,0,0,0,0,0,0,0,0,0,0,0,0,0,0,0,0,0,0,0],"so":{"4":0,"11":0,"13":0,"17":0,"20":0,"30":0,"68":0,"73":0,"82":0,"114":0,"117":0},"lk":0,"lt_st":0,"bat":0,"dslp":0,"sho":[],"sht":[],"ver":1} (нераспред.)
16:10:38.218 MQT: tasmota/discovery/3C6105FD7A71/sensors = {"sn":{"Time":"2023-10-13T16:10:38","DS18B20":{"Id":"00000215ECB7","Temperature":24.9},"OPENTHERM":{"conn":"BUSY","settings":3,"SLAVE":{"FAULT":0,"CH":0,"DHW":0,"FL":0,"COOL":0,"CH2":0,"DIAG":0,"RAW":1073742336},"BTMP":{"FAULT":0,"REQ":85.0,"ACT": 85.0},"HWTMP":{"REQ":36.0,"ACT": 36.0},"ASFF":{"FC":0,"OFC":0},"FLM":0.0,"TB":24.0,"TDHW":23.0,"DHWS":36.0,"TMAX":0.0,"OT10":{"lo":0,"hi":0}},"TempUnit":"C"},"ver":1} (нераспред.)
16:10:38.336 [OTH]: Processing response. Status=INVALID, Response=0xF00C0000
16:10:38.942 [OTH]: Processing response. Status=INVALID, Response=0x700E0000
16:10:39.545 [OTH]: Processing response. Status=INVALID, Response=0xF00F0000
16:10:40.149 [OTH]: Processing response. Status=INVALID, Response=0xF0120000
16:10:40.753 [OTH]: Processing response. Status=INVALID, Response=0x70130000
16:10:41.359 [OTH]: Processing response. Status=INVALID, Response=0xF0210000
16:10:41.972 [OTH]: Processing response. Status=INVALID, Response=0xF0740000
16:10:42.533 [OTH]: Processing response. Status=INVALID, Response=0x70750000
16:10:43.139 [OTH]: Processing response. Status=INVALID, Response=0xF0780000
16:10:43.744 [OTH]: Processing response. Status=INVALID, Response=0x70790000
16:10:44.416 [OTH]: Processing response. Status=SUCCESS, Response=0x40000200
16:10:45.253 [OTH]: Processing response. Status=SUCCESS, Response=0xC0050000
16:10:45.864 [OTH]: Processing response. Status=INVALID, Response=0x70730000
16:10:46.415 [OTH]: Processing response. Status=SUCCESS, Response=0xC0110000
16:10:47.020 [OTH]: Processing response. Status=SUCCESS, Response=0x40191800
16:10:47.623 [OTH]: Processing response. Status=SUCCESS, Response=0xC01A1600
16:10:47.811 WIF: Проверка соединения...
16:10:48.227 [OTH]: Processing response. Status=INVALID, Response=0x601B0000
16:10:48.835 [OTH]: Processing response. Status=INVALID, Response=0x701C0000
16:10:49.423 [OTH]: Processing response. Status=SUCCESS, Response=0x40382400
16:10:50.054 [OTH]: Processing response. Status=SUCCESS, Response=0xC0390000

Я правильно понял - можно по-русски?

Laxilef, 2023-10-13:
Опишите что не работает: не регулирует температуру, не получает значения с датчиков и т.д.
У тасмоты такая же библиотека от Игоря Мельника.
Пины правильные в настройках вписаны?

Balaganoff, 2023-10-13:
Спасибо за ответ разобрался ! У меня пины не так распаяны (осталось от другого проекта) как на вашей схеме.
В настройках изменения не сохраняются. По крайней мере как я ни старался не получилось. Пришлось пересобрать из исходников по свои пины и котел ответил ! Я почти счастлив ! ))
Еще один вопрос - как заставить работать 18b20 чтобы температуру внутри помещения учитывало именно с него ?
Датчик точно подключен правильно и работает.
struct {
      // 1 - manual, 2 - ds18b20
      byte type = 2;
      byte pin = 12;
      float offset = 0.0f;
    } indoor;

Я даже попытался установить тип 2 , но это мне не помогло.
opentherm_indoor_temp можно регулировать только вручную, а хотелось-бы с подключенного датчика
(так скоро освою программирование на старости лет :)))

Laxilef, 2023-10-14:
После сборки из исходников настройки сохраняются?

Balaganoff, 2023-10-14:
> После сборки из исходников настройки сохраняются?

Я не пробовал ( Я просто поправил в исходниках под свои пины и все заработало.
Буду рядом еще раз попробую и доложу результат.  Ждем новых версий ! Спасибо за работу !

Laxilef, 2023-10-14:
Выложил билды для разных esp8622: https://github.com/Laxilef/OTGateway/releases/tag/1.3.1
Возможно у вас wemos с 4мб памяти, а вы залили билд для wemos 16мб, поэтому и не сохраняются настройки :)
Попробуйте залить firmware_d1_mini.bin или, если не поможет, firmware_d1_mini_lite.bin

Напишите потом пожалуйста по результатам.

Balaganoff, 2023-10-16:
> Выложил билды для разных esp8266: https://github.com/Laxilef/OTGateway/releases/tag/1.3.1 Возможно у вас wemos с 4мб памяти, а вы залили билд для wemos 16мб, поэтому и не сохраняются настройки :) Попробуйте залить firmware_d1_mini.bin или, если не поможет, firmware_d1_mini_lite.bin
>
> Напишите потом пожалуйста по результатам.

Да, у меня wemos d1 mini  с 4мб. Пока перезаписать прошивку нет возможности.
А кроме несохранения настроек различия в объеме памяти еще на что-то влияет?

Laxilef, 2023-10-16:
Нет, не влияет. Но сохранение настроек - весьма важная функция :)

Laxilef, 2023-10-16:
По работе с котлом AEG GBA124 все нормально? Могу в список совместимых добавить?

ananyevgv, 2023-10-17:
Baxi Nuvola-3 необходимо включить ch_2,  иначе горячая вода не работает

Balaganoff, 2023-10-17:
> По работе с котлом AEG GBA124 все нормально? Могу в список совместимых добавить?

Да этот котел все отображает (кроме давления)  и реагирует корректно.

Laxilef, 2023-10-17:
> Baxi Nuvola-3 необходимо включить ch_2, иначе горячая вода не работает

Он всегда включен:
```c++
    localResponse = ot->setBoilerStatus(
      heatingEnabled,
      settings.opentherm.dhwPresent && settings.dhw.enable,
      false, false, true/* <<< ch2 */, false, false
    );
```

Closed 2023-11-05.

Thread 7 (2023-10-14):

FAQ

Balaganoff, 2023-10-14:
1. Какая логика в подключении датчиков,
  - Экспериментально я выяснил так:
  **External** - это датчик непосредственно подключенный к ESP
  **Boiler**  - ??
  **Manual**  - это внешний датчик, привязываемый через автоматизацию Home Assistant.  Не совсем понят смыл ручной регулировки. Зачем это сделано? Ведь при просмотре со смартфона можно нечаянно установить неверную температуру и нарушить логику работы.

Я правильно понял или где-то можно подробнее прочитать?

Laxilef, 2023-10-14:
External - внешний DS18B20 или аналог, который физически подключен
Boiler - съем с котла по opentherm. Некоторые котлы позволяют подключать датчик внешней температуры или имеют датчик на приточке
Manual - для передачи температуры контроллеру через автоматизацию, например с zigbee датчика,  который висит на улице
Сбить можно,  но автоматизация должна потом все равно установить реальную температуру

Balaganoff, 2023-10-16:
> Manual - для передачи температуры контроллеру через автоматизацию, например с zigbee датчика, который висит на улице
> Сбить можно, но автоматизация должна потом все равно установить реальную температуру.

А зачем это это реализовано ? Если все равно установится реальная температура. Мое - мнение ручная регулировка лишняя и вводит в заблуждение.

Balaganoff, 2023-10-16:
Шаг изменения температуры отопления в 1градус - это слишком грубо. Порог температурной чувствительности человека по разным источникам считается 0.2-0.4 градуса. Измерять мы можем с точностью 0.1. Почему-бы не использовать эту возможность?

В аналогичных теморегуляторах устанавливается с точностью от 0.1 до 0.5 градуса. (зависит от производителя)

Balaganoff, 2023-10-17:
Есть какой-то канал общения кроме гитхаба ? Форум или телеграмм ?

Laxilef, 2023-10-17:
@Balaganoff, пока только тут и на [форуме baxi](https://forum.baxi.ru/viewtopic.php?p=80598)

bigbrother72, 2023-10-19:
> Для climate.opentherm_heating установлен шаг 0.5 градуса.

пытался поменять в publishClimateHeating()

    doc[F("temp_step")] = 0.1;
    doc[F("target_temp_step")] = 0.1;

Не  помогает.

Balaganoff, 2023-10-19:
> Не помогает. Только на один градус шаг регулировки. А мне например 21 градус холодно, а 22 градуса уже жарко

Я для себя нашел выход - через автоматизаию пихаю нужное значение в number.opentherm_heating_target - тогда воспринимает половину градуса и работает по этому значению. Правда на карточке объекта округляет.
Вот пример установки 24.5 и ночной 22. ( такие высокие значения т.к. датчик пока стоит у котла)
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

RYZHOP, 2023-10-19:
А можешь скинуть файл .yaml со всеми настроенными датчиками.

Laxilef, 2023-10-19:
Попробуйте [mini-climate-card](https://github.com/artem-sedykh/mini-climate-card), через HACS ставится.
Конфиг:
```yaml
type: custom:mini-climate
entity: climate.opentherm_heating
target_temperature:
  step: 0.5
secondary_info:
  type: hvac-action
fan_mode:
  hide: true
hvac_mode:
  hide: true
  source:
    heat:
      name: Включено
    'off':
      name: Выключено
buttons:
  boost:
    icon: mdi:rocket-launch-outline
    location: bottom
    state:
      attribute: preset_mode
      mapper: 'state => (state == ''boost'' ? ''on'': ''off'')'
    toggle_action: >
      (state, climate_entity) => this.call_service('climate', 'set_preset_mode',
      { entity_id: climate_entity.entity_id, preset_mode:
      (this.toggle_state(state) == 'on' ? 'boost' : 'none') })
  heat:
    icon: mdi:power
    location: bottom
    state:
      mapper: 'state => (state == ''heat'' ? ''on'': ''off'')'
    toggle_action: >
      (state, entity, climate_entity) => this.call_service('climate',
      'set_hvac_mode', { entity_id: climate_entity.entity_id, hvac_mode:
      (this.toggle_state(state) == 'on' ? 'heat' : 'off') })

```

Balaganoff, 2023-10-20:
> Попробуйте [mini-climate-card](https://github.com/artem-sedykh/mini-climate-card), через HACS ставится.
Да. регулирует с шагом 0.5
Правда на основной карточке округляет, что не очень красиво ;)
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

Balaganoff, 2023-10-20:
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

После этого наверное надо добавить:
name: Отопление

Laxilef, 2023-10-20:
В стандартной карточке шаг будет работать в следующей версии.

Rolex48, 2023-11-03:
Подскажите почему минимальный порог кривой "N" с 0.3 ? Есть возможность начинать с 0.1? (дело в том что отопление тёплыми полами котлом без подмеса в диапазоне 25-40°)

"N - heating curve coefficient. The coefficient is selected individually, depending on the insulation of the room, the heated area, etc.
Range: 0.3...10, default: 0.7, step 0.01"

Laxilef, 2023-11-03:
Через HA можете установить любое значение, начиная с 0.001.
В документации исправлю.

filipjurik, 2023-11-17:
Hi,
I have one question.
Would it be possible to control the modulation level ?

Laxilef, 2023-11-17:
Hi,
@filipjurik no, the modulation is controlled by the boiler software. Openterm supports limiting the modulation level. But not all boilers support this function.

filipjurik, 2023-11-17:
Being able to limit the modulation would help me quite a bit. My boiler starts the flame and modulates to 50% and does not have time to adjust the modulation to maintain the temperature of the water in the heating, so the flame goes out. the boiler cycles. I would need to start it with 10-20% modulation and add it later as needed.How i do this?thakns for you replyFilip ***@***.***ňa 17. 11. 2023 o 16:07 užívateľ Laxilef ***@***.***> napísal:
Hi,
@filipjurik no, the modulation is controlled by the boiler software. Openterm supports limiting the modulation level. But not all boilers support this function.

—Reply to this email directly, view it on GitHub, or unsubscribe.You are receiving this because you were mentioned.Message ID: ***@***.***>

Laxilef, 2023-11-17:
I will try to add this setting in the next version. But, if I’m not mistaken, this parameter can be changed through the boiler’s engineering menu.

filipjurik, 2023-11-18:
Thank you for your response. yes, it is possible to change the maximum allowed heating power in the boiler, but I only need to change it in certain cases. I already have it set to 50%, but I need to temporarily set it to less.

Laxilef, 2023-12-16:
@filipjurik, this feature will appear in release 1.4.0, but now it is already in the master branch. Pls test it.

filipjurik, 2023-12-16:
Thanks, I'll test it and let you know if it works

Closed 2024-01-06.

Thread 8 (2023-11-04):

Wemos S2 mini (ESP32) support?

mutasim, 2023-11-04:
Does this project support ESP32 boards? I have the DIYLESS adapter and an S2 mini ESP32 board

Laxilef, 2023-11-04:
Didn't check. I think it won't work because used ESP8266Scheduler library

Laxilef, 2023-11-06:
I think I'll add support for esp32 soon

kotjaraxx, 2023-11-08:
> Думаю, скоро я добавлю поддержку esp32. Сейчас у меня нет платы ESP32. Если вы готовы протестировать свою плату, я могу опубликовать прошивку здесь.

Я сегодня вечером получу свой адаптер, готов тестировать

kotjaraxx, 2023-11-08:
Это готовый контролер Smarttherm, контролер используется Esp-wroom-32, но бывает так же на 8266, тот работает на вашей прошивке

kotjaraxx, 2023-11-08:
https://github.com/Evgen2/SmartTherm
Вот проект на гит

Laxilef, 2023-11-08:
Ок. Попробуйте зашить. Пины OT не забудьте настроить и перезагрузить.

[firmware_nodemcu_32s_1.3.3.zip](https://github.com/Laxilef/OTGateway/files/13299148/firmware_nodemcu_32s_1.3.3.zip)

kotjaraxx, 2023-11-09:
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

Пока неуспешно, прошилась плата без ошибок, но на связь не выходит теперь, ну тут наверное я где то ошибся. Какие только прошивки не заливал, теперь она, не коннектится к wifi. Вечером сегодня продолжу эксперименты

Laxilef, 2023-11-09:
Странно. Вот билд с выводом всех сообщений в сериал порт. Скиньте логи после загрузки esp.

[firmware_nodemcu_32s_1.3.3_debug.zip](https://github.com/Laxilef/OTGateway/files/13305331/firmware_nodemcu_32s_1.3.3_debug.zip)

kotjaraxx, 2023-11-09:
> Странно. Вот вывод всех сообщений в последовательный порт, а не в телнет. Скиньте логи после загрузки, особенно.
>
> [прошивка_nodemcu_32s_1.3.3_debug.zip](https://github.com/Laxilef/OTGateway/files/13306150/firmware_nodemcu_32s_1.3.3_debug.zip)

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

Laxilef, 2023-11-09:
Это лог процесса прошивки) Нужен лог из сериал порта. Если platformio или arduino ide нет, можно через putty, скорость 115200.

p.s. попробуйте прошиться через https://github.com/marcelstoer/nodemcu-pyflasher/releases
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

kotjaraxx, 2023-11-10:
> Это регистрация процесса прошивки) Нужен лог из порта порта. Если Platformio или arduino ide нет, можно через putty, скорость 115200.
>
> ps форма прошиться через https://github.com/marcelstoer/nodemcu-pyflasher/releases 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

Command: esptool.py --port COM5 --baud 115200 --after no_reset write_flash --flash_size detect --flash_mode dio 0x00000 C:\firmware_nodemcu_32s_1.3.3.bin --erase-all

esptool.py v3.0
Serial port COM5
Connecting....
Detecting chip type... ESP32
Chip is ESP32-D0WD-V3 (revision 3)
Features: WiFi, BT, Dual Core, 240MHz, VRef calibration in efuse, Coding Scheme None
Crystal is 40MHz
MAC: 48:e7:29:ac:ae:7c
Uploading stub...
Running stub...
Stub running...
Configuring flash size...
Auto-detected Flash size: 4MB
Erasing flash (this may take a while)...
Chip erase completed successfully in 9.5s
Compressed 994752 bytes to 608303...
Wrote 994752 bytes (608303 compressed) at 0x00000000 in 53.7 seconds (effective 148.2 kbit/s)...
Hash of data verified.

Leaving...
Staying in bootloader.

Firmware successfully flashed. Unplug/replug or reset device
to switch back to normal boot mode.

kotjaraxx, 2023-11-10:
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

kotjaraxx, 2023-11-10:
Вот что шлет прошитая плата в Arduino IDE

07:31:08.298 -> rst:0x10 (RTCWDT_RTC_RESET),boot:0x13 (SPI_FAST_FLASH_BOOT)
07:31:08.343 -> invalid header: 0x69646172
07:31:08.389 -> invalid header: 0x69646172
07:31:08.436 -> invalid header: 0x69646172
07:31:08.483 -> invalid header: 0x69646172
07:31:08.530 -> invalid header: 0x69646172
07:31:08.577 -> invalid header: 0x69646172
07:31:08.631 -> invalid header: 0x69646172
07:31:08.671 -> invalid header: 0x69646172
07:31:08.671 -> ets Jul 29 2019 12:21:46

Laxilef, 2023-11-10:
Я думаю у вас что-то с платой или с памятью на плате. Сегодня мне пришла плата nodemcu c модулем еsр-wrооm-32е, прошил через platformio, у меня работает. Но opentherm смогу проверить позже.

Laxilef, 2023-11-10:
Прошу прощения, бинарь не содержал загрузчик и разделы.
Объединил. Шить через [ESP Flash Download Tool](https://www.espressif.com/en/support/download/other-tools) в адрес 0x0. Telnet в этом билде не используется.
[firmware_nodemcu_32s_1.3.3_debug_full.zip](https://github.com/Laxilef/OTGateway/files/13322571/firmware_nodemcu_32s_1.3.3_debug_full.zip)

kotjaraxx, 2023-11-11:
> Прошу прощения, бинарь не содержал загрузчик и разделы. Объединил. Шить можно через тот же NodeMCU PyFlasher или через [ESP Flash Download Tool](https://www.espressif.com/en/support/download/other-tools) в адрес 0x0.
>
> [build.zip](https://github.com/Laxilef/OTGateway/files/13323960/build.zip)

Спасибо, завтра протестирую, отпишусь о результате)

Laxilef, 2023-11-11:
Ок. Свежий билд.
[build.zip](https://github.com/Laxilef/OTGateway/files/13326242/build.zip)

kotjaraxx, 2023-11-12:
> Ок. Свежий билд. [build.zip](https://github.com/Laxilef/OTGateway/files/13327137/build.zip)

18:03:01.097 -> ets Jul 29 2019 12:21:46
18:03:01.097 ->
18:03:01.097 -> rst:0x1 (POWERON_RESET),boot:0x13 (SPI_FAST_FLASH_BOOT)
18:03:01.097 -> configsip: 0, SPIWP:0xee
18:03:01.097 -> clk_drv:0x00,q_drv:0x00,d_drv:0x00,cs0_drv:0x00,hd_drv:0x00,wp_drv:0x00
18:03:01.097 -> mode:DIO, clock div:2
18:03:01.097 -> load:0x3fff0030,len:1184
18:03:01.097 -> load:0x40078000,len:13232
18:03:01.097 -> load:0x40080400,len:3028
18:03:01.097 -> entry 0x400805e4

Результат загрузки последнего релиза

Laxilef, 2023-11-12:
Ошибок нет. Должна появиться точка доступа, подключитесь к ней и дальше по инструкции из readme.

kotjaraxx, 2023-11-14:
> Ошибок нет. Должна появиться точка доступа, подключитесь к ней и дальше по инструкции из readme.

Теперь все работает, ну плата у меня все равно какая то кривая)) Wifi ловит максимум на расстоянии метра от роутера. Разбираюсь теперь с этим

kotjaraxx, 2023-11-15:
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

OpenTherm да, работает, ну о корректности не могу судить пока) Температуру воды и отопления, регулирует. Не видно датчиков температуры внешних, вроде пины корректно выставил в прошивке..

kotjaraxx, 2023-11-15:
Сразу вопрос задам, отключение опентерм как производить? Не отключая питания дёрнул провод, получил ошибку е31, ну по питанию перезагрузил, все заработало. Кнопки управления котлом не работают когда провод подключен, поэтому с кнопки выключить не смог)

Laxilef, 2023-11-15:
Ок, благодарю за информацию.

> Не видно датчиков температуры внешних, единственное что, хотя вроде пины корректно выставил в прошивке..

15 и 26 пины установили? В настройках External поставили?

> Сразу вопрос задам, отключение опентерм как производить? Не отключая питания дёрнул провод, получил ошибку е31, ну по питанию перезагрузил, все заработало. Кнопки управления котлом не работают когда провод подключен, поэтому с кнопки выключить не смог)

Все обесточить и вернуть как было. Программно - никак. Котел без перемычки будет слейвом и управляться через с родной панели вряд ли будет.

kotjaraxx, 2023-11-16:
> External

External выставил, заработал датчик)
Котел у меня Baxi Eco Home 24f, получается что все работает.

kotjaraxx, 2023-11-16:
> > External
>
> External выставил, заработал датчик) Котел у меня Baxi Eco Home 24f, почему то не работает диагностика
![Uploading Screenshot_20231116_071759_Home Assistant.jpg…]()

Laxilef, 2023-11-16:
Скрин не грузится

kotjaraxx, 2023-11-16:
> Скрин не грузится

Поправил

Laxilef, 2023-11-16:
На baxi ampera у меня так же было изначально. С чем связано не разобрался, ни на что не влияет.

kotjaraxx, 2023-11-24:
Я решительно не понимаю что происходит)
У меня оставалась единственная нерешеная проблема, не был виден второй датчик температуры, при этом на родной прошивке производителя моего устройства-все работало.
Пока все это делал, все поломалось, wifi не работал, и прочее. Ну там были проблемы по питанию ESP32, теперь все хорошо с этим, НО. Ваша прошивка теперь не видит ни датчики температуры, ни OT. При этом прошивка производителя железа-работает.
Я не исключаю что я не то прошиваю, можете скинуть последнюю рабочую прошивку для ESP32?

Laxilef, 2023-11-24:
Здравствуйте
1.3.3 была рабочей на esp32. Датчики температуры, однако, не проверял - жду s2 mini.

По обоим датчикам нужно использовать External, если это DS18B20

kotjaraxx, 2023-11-26:
> Здравствуйте 1.3.3 была рабочей на esp32. Датчики температуры, однако, не проверял - жду s2 mini.
>
> По обоим датчикам нужно использовать External, если это DS18B20

Да, датчики температуры я выставлял, и одме из них работал, до того как я перепрошил его.
Я могу предпринять что то, чтоб вы помогли мне?

kotjaraxx, 2023-11-26:
> Напишите свой логин в telegram.

@AVL87

SimplyKot, 2023-12-06:
Нет, у меня плата собственной разработки на D1 mini . Пробросил в Умный Дом Яндекса, все через колонку тоже отлично управляется.

DeadlySin2, 2024-01-28:
Плата Smartherm, такая же как на фото выше. Почему-то не работает с Baxi Luna-3 комфорт. Светодиод мигает 3 раза, а значит проблема в Opentherm. При этом подключено все внрно, т.к. с родной прошивкой протокол виден и работает. Может я шью как-то неправильно или не той прошивкой? Шил NodeMCU Pyflasher. Прошивка -

Laxilef, 2024-01-28:
@DeadlySin2 прошейте 1.4.0 из мастер ветки.

DeadlySin2, 2024-01-28:
А можно ссылочку или инструкцию. Не могу найти :(

Laxilef, 2024-01-28:
https://github.com/Laxilef/OTGateway/wiki#build-firmware

DeadlySin2, 2024-01-29:
Не смог сделать прошивку. Выбираю Nodemcu32 выбираю Build. Дальше папку built найти не могу, вернее могу, но в папке .pio/built. Видимо я должен прошить Firmware.factory.bin, но после прошивки вместо привычной веб морды вижу The filesystem is not flashed. Видимо я что-то делаю не так.

yanhanxing, 2024-02-18:
> Здравствуйте 1.3.3 была рабочей на esp32. Датчики температуры, однако, не проверял - жду s2 mini.
>
> По обоим датчикам нужно использовать External, если это DS18B20

Your project is fantastic. I am currently using the ESP32-WROOM version to burn the code for ESP32-S. Currently, during the testing phase, I have not yet connected the wall mounted boiler. During the testing, I encountered the following issues. I am not sure if it is due to the wrong firmware version I have selected or a setup issue? I will provide the firmware for the most commonly used development version of ESP32.
I connected the DS18B20 temperature sensor to the GPIO-18 pin and was able to view the temperature value normally in the OpenTherm gateway. However, displaying the outdoor temperature sensor as unavailable in homeassist.
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

Laxilef, 2024-02-18:
Hi @yanhanxing
Thanks! I looked, it's a bug in the code. The temperature entity is not available if there is no connection to opentherm, I will fix this later.

yanhanxing, 2024-02-19:
Okay, I look forward to your revised version and I will continue testing it.

Laxilef, 2024-02-20:
Hi @yanhanxing
Try [rc15](https://github.com/Laxilef/OTGateway/releases/tag/1.4.0-rc.15)

Laxilef, 2024-02-29:
Hi @yanhanxing
Try [rc16](https://github.com/Laxilef/OTGateway/releases/tag/1.4.0-rc.16)

Closed 2024-04-06.

Thread 10 (2023-11-11):

Begginer's frustration...

kulisau, 2023-11-11:
Hi,
I very recently started using the Home assistant and bought Igor's wemos hat, assembled it and was about to install it and then it clicked that I don't even know how to set the desired room temperature using OpenTherm.
I can't find any quides online for OpenTherm in particular. I was looking at DYILESS guide, but they assume I have an MQQT sensor.
My current setup is a Shelly relay inside of my boiler and Sonoff zigbee thermometer in my living room working in ZHA mode .
From my understanding generic_thermostat isn't suitable for the OpenTherm as it's just a relay controller.

Apologies if this is something obvious :)

Laxilef, 2023-11-11:
Hi,
Does your boiler support OpenTerm?
If it is supported, you can flash your ESP8266 with this firmware and the boiler will be integrated into your home assistant.

Just don't forget to install Mosquitto broker :)

kulisau, 2023-11-11:
Yes, it does :)
My boiler is Radiant R2KA.
I already have flashed the wemos and soldered all the headers needed.
I do have mosquitto container running.
My question is how can I setup a card/thermometer to set the desired temperature at the room?

Laxilef, 2023-11-11:
If I understand correctly, then you need to create a "thermostat" card and select the entity "climate.opentherm_heating" there

kulisau, 2023-11-11:
Can you please provide any example how to use that with a zigbee thermometer in mind?

Laxilef, 2023-11-11:
Have you created an automation that transfers temperature from a zigbee sensor to a controller?

kulisau, 2023-11-11:
Not yet. I haven't even connected the OT solution to my boiler as I don't understand how to set the desired inside temp up.

Laxilef, 2023-11-11:
You need to flash your ESP, configure it: set pins and mqtt (server IP, login and password). Then create automation as written in the example and configure the PID or equitherm algorithm in the device settings in HA.

The controller itself will maintain the set temperature in the house by adjusting the coolant temperature.

bigbrother72, 2023-11-12:
Hi
I think you need to disconnect Shelly  relay and connect the Opentherm controller instead.
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

After that you must connect to Opentherm contorller and make some settings for MQTT etc
https://github.com/Laxilef/OTGateway#quick-start

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

After that in HA go to MQTT intergartions
192.168.xxx.xxx:8123/config/integrations/dashboard

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

Then MQTT

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

Then Devices

Choose Opentherm controller

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

Then add controls to dashboard:
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

kulisau, 2023-11-12:
Thank you for your answers!
The biggest question is how to set the desired temperature of the room. Is it possible to use a card like generic_thermostat to set the temperature?
Or maybe this isn't possible at all and the software always tries to keep 23 degrees?

Laxilef, 2023-11-12:
You can change the temperature using the thermostat "climate.opentherm_heating"

bigbrother72, 2023-11-12:
you will see the control elements after completing the last point of my previous message.

like this:
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

kulisau, 2023-11-18:
I just now found some time to get back to this...
So I do have another problem. I can flash D1 mini firmware no problem, the device boots ok, I connect to it and setup wifi, so far so good, however, as soon as I set MQQT and pins (D5 out and D6 in) for OT communication device keeps boot looping. I tried different firmwares but to no avail. My board is cheap Wemos D1 mini clone from the Aliexpress. I can confirm the board is  working as I also tried Tasmota firmware and it managed to communicate with the boiler ok.

Laxilef, 2023-11-18:
What firmware file did you flash?

Can you attach a log from the serial port at the time of the cyclic reboot?

kulisau, 2023-11-18:
I tried 1.3.3, 1.3.2 and one older for d1 mini lite and pro versions.
The output is a bit mangled (not really sure which port speed I should use. 115200 seemed the best fit):
`▒▒▒g▒{▒▒g|▒l
▒d`c▒
|{▒d▒o▒▒n▒
l`▒▒;▒d▒l▒
▒
 ets Jan  8 2013,rst cause:4, boot mode:(3,6)

wdt reset
load 0x4010f000, len 3424, room 16
tail 0
chksum 0x2e
load 0x3fff20b8, len 40, room 8
tail 0
chksum 0x2b
csum 0x2b
v000703c0
~ld
▒▒▒'▒r▒▒o|▒
l▒
l c▒▒|s▒l▒n▒
▒g▒$`▒▒{▒l▒d▒
`

Laxilef, 2023-11-19:
Hmm, this is strange. Try flashing this build and please send the logs from the serial port here.
[firmware_d1_mini_1.3.4_debug.zip](https://github.com/Laxilef/OTGateway/files/13402706/firmware_d1_mini_1.3.4_debug.zip)

kulisau, 2023-11-19:
Flashed it, configured PINs and MQQT. Serial output:
%▒▒w▒B▒Y.+▒h▒

             )▒\5▒▒PKT- )dУ▒    5Y
                                  )L▒A▒ ▒▒T▒/▒[▒P9▒▒Z%  )l▒@▒▒!NZ       HHi▒9▒D▒ҭ9▒F▒PED ▒▒
                                                                                           rf cal sector: 1020
freq trace enable 0
rf[112] : 0▒

Laxilef, 2023-11-19:
This is not the full log. Without a full log, I can’t understand where to look for the error.

kulisau, 2023-11-19:
I turned off flow control and getting this now:

 ets Jan  8 2013,rst cause:4, boot mode:(3,6)

wdt reset
load 0x4010f000, len 3424, room 16
tail 0
chksum 0x2e
load 0x3fff20b8, len 40, room 8
tail 0
chksum 0x2b
csum 0x2b
v00070090
~ld
▒▒▒▒n▒s▒▒o|▒d
▒d`c▒
|;▒d▒g▒▒o▒
d`▒▒s▒$▒l
▒

kulisau, 2023-11-19:
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

Laxilef, 2023-11-19:
Ooops. I made a mistake. This build (new) should display all logs.
[firmware_d1_mini_1.3.4_debug.zip](https://github.com/Laxilef/OTGateway/files/13402899/firmware_d1_mini_1.3.4_debug.zip)

kulisau, 2023-11-19:
a step further now...
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
I have extremely long MQTT pass, might that be a problem?

Laxilef, 2023-11-19:
Maybe. The password in the config is limited to 32 characters:
```
    char user[32];
    char password[32];
```

kulisau, 2023-11-19:
dang it :D
About a month or so ago when I installed MQTT and tried to attach a Tasmota switch with short (5-6 chars) pass, Tasmota refused to work. I read somewhere that the pass is suppose to be super long...
I'll give a shorter pass a try and will let you know how that went

kulisau, 2023-11-19:
It connected to MQTT now, however, it still boot looping...
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

Laxilef, 2023-11-19:
I think this is a problem with the library PubSubClient =\
If I'm right, then this build will work.
[firmware_d1_mini_1.3.4_debug.zip](https://github.com/Laxilef/OTGateway/files/13402954/firmware_d1_mini_1.3.4_debug.zip)

kulisau, 2023-11-19:
still the same...

Laxilef, 2023-11-19:
Ok, I need to think. I'll come back here a little later.

kulisau, 2023-11-19:
I re-flashed the board again. This time I haven't changed MQTT settings at all, just changed PIN accordingly and it started boot looping.
Can it be that some GPIOs are in-use and overlaps with those PINs I describe?
I use the Ihor's Melnyk master shield. Reboots takes place regardless shield is installed on the Wemos board or not

Laxilef, 2023-11-19:
What pins do you use?

kulisau, 2023-11-19:
Out - 5
In - 6
Internal temp - 7
External temp - I leave as is

Laxilef, 2023-11-19:
But on the wemos d1 mini there is no pin number 6 & 7: https://www.wemos.cc/en/latest/d1/d1_mini.html

Or did you mean D5 and D6?

Laxilef, 2023-11-19:
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
D5 = GPIO14
D6 = GPIO12
D7 = GPIO13

kulisau, 2023-11-19:
Yes, I meant D5, D6 and D7. What has to be provided in PIN fields, D or GPIO values?

Laxilef, 2023-11-19:
GPIO

kulisau, 2023-11-19:
I adjusted GPIO values and it no longer reboots! Thanks!
Will try to connect the shield to the boiler later today.
P.S. I'd suggest using GPIO instead of PIN in the settings to avoid confusion 😀

kulisau, 2023-11-19:
Great success!
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

Laxilef, 2023-11-19:
Nice)

kulisau, 2023-11-19:
Something interesting is happening at home 😀 I can't get the boiler to calm down. Initially I turned on the Equitherm and PID and the HA decided to turn my flat into a terrarium (30+ C). I understand it  probably was required for PID calculations. I turned both of these options off.
I read that a super precise thermometer is required for this PID tuning, right?
Mine is a sonoff zigbee one with a display. What temperature sensor would you recommend? I heard the xiomi ble could be a good choice.
And one more question. Now that I turned off both of those options I can only select a heating setpoint. Is it still possible to use this opentherm solution as a dumb thermostat until I get a proper temp sensor in my possession?

Laxilef, 2023-11-20:
The maximum temperature can be configured through the entity "number.opentherm_heating_max_temp".  If it is not activated, then it must be activated in the entity settings.

kulisau, 2023-11-20:
It worked. Thanks!

Laxilef, 2023-11-20:
I saw your post regarding the overheating of the house.
Start by setting the equitherm mode. In most cases it regulates better than PID.
There is no need for any precise temperature sensors. You can read how to set up equitherm mode in the readme.

kulisau, 2023-11-20:
Will try that, thanks!
Btw, I noticed that when DHW is being used, the flame modulation varies between 50-70%, however, when the heating kicks in, it's always 100%. Does it depend on Equitherm/PID settings or something else?
I was under the impression that the OpenTherm should regulate the modulation to keep it as low as possible.

Laxilef, 2023-11-20:
Modulation is controlled by the boiler software

kulisau, 2023-11-21:
First of all, the excel spreadsheet is amazing! I hope I understood it correctly, though 😄
Not sure what's wrong, but second night in the row the software just gives up during the night. Last night I had to physically pull the plug of the boiler out of the socket because the wemos (it's connected internally inside of the boiler) wasn't responding, this morning I woke up by 17 degrees in the room. Had to turn the turbo heating to bring the temperature to somewhat liveable. I can't figure out why
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

Laxilef, 2023-11-21:
Does the controller continue to send data to the mqtt server?  Show graphs "Heating setpoint", "Heating temperature", "Heating" (on/off)

Laxilef, 2023-11-21:
> P.S. I use automations to update internal and external temperatures.

And graphs of external and internal temperatures.

kulisau, 2023-11-21:
Outdoor temp:
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
Indoor temp:
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
I enabled the heating setpoint only yesterday, hence less data:
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
Heating temp:
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

Laxilef, 2023-11-21:
This is interesting :)
Although I see that setpoint is correct.

Can you also show a graph of the "binary_sensor.opentherm_heating" entity?

kulisau, 2023-11-21:
binary_sensor.opentherm_heating has no graphs, only log. You're probably looking for this one. Let me know if that's not the case
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

kulisau, 2023-11-21:
Any idea why those intermittent dips to 0 takes place in previous graphs?

Balaganoff, 2023-11-21:
У меня тоже такие "прострелы" до нуля на графиках температур как у автора выше ((
Из-за этого увеличивается масштаб и плохо видно реальные изменения. Надо наверное какие-то фильтры-условия при сохранении прописать .
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

Laxilef, 2023-11-21:
Please make such a data sample. This can be done on the "history" tab.
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

Balaganoff, 2023-11-21:
> @Balaganoff перезагрузок esp не было? Аптайм посмотрите на вкладке Info.

Да именно тогда и была перезагрузка. Непонятно почему. Все остальное не перезагружалось.

Laxilef, 2023-11-21:
Last reset reason на той же вкладке

kulisau, 2023-11-21:
Here you go:
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
I haven't checked my wemos uptime, but there's no point of doing that as I manually had to reboot the whole boiler, but I'll keep an eye on it. In my case I have installed inline power socket (single socket power extension thingy), then plugged iphone charger into it, then USB-A to USB-C cable and just then it connects to the wemos board. I have a feeling that socket is dodgy as I had to wiggle the charger one time for it to work.
It looks like this:
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

kulisau, 2023-11-21:
I edited the post with added heating and flame entities. You might have seen the non-updated version.
Which entities you're missing?

Laxilef, 2023-11-21:
I see it, thanks. For some reason, your boiler has stopped heating the coolant, although a command to heat was sent to the boiler.
I will check the code, thank you.

Do you think the boiler could display an error after the ESP was rebooted?

kulisau, 2023-11-21:
Hmm.. I don't think it displays/generates any error. The only think differs on the display when the controller is inaccessible by the boiler is missing "recycling" icon (indicates the OT connectivity) and that's it. The boiler falls back to the manual working mode and restores heating and DHW (temp) settings to the previously set ones. I will monitor the uptime. Thanks

Laxilef, 2023-11-21:
Try to simulate the loss of connection with the ESP.
When the burner is running on the boiler, reboot the ESP and check whether the boiler will heat the water after resetting the ESP.

kulisau, 2023-11-21:
I just tried to restart via the wemos via the browser while it was in action. It took a minute or so and it resumed heating without a hiccup. Another thing I observe is now for whatever reason it does not reach the desired temp at home.

kulisau, 2023-11-22:
It happened again this night. The board disappeared from the ether at 4:35 in the morning. Boiler didn't indicate OT connection. Had to physically disconnect the boiler from the mains power.
I'm thinking maybe this night I should run power to the board from the laptop, run putty to log what's happening.

Laxilef, 2023-11-22:
It is not normal.
Do you have the opportunity to test this with another ESP8266/ESP32 board?
If the board freezes, WDT must reboot it. And I couldn’t get my boards to behave the same way as yours.

Laxilef, 2023-11-22:
If you want to check on this board, you can flash this build, enable debug ("switch.opentherm_debug" entity in HA) and connect via telnet.
[build.zip](https://github.com/Laxilef/OTGateway/files/13441395/build.zip)

Balaganoff, 2023-11-22:
> Last reset reason на той же вкладке

Last reset reason
    Hardware Watchdog

Зачем произошла перезагрузка? И опять появилась нулевая температура внешнего датчика

Laxilef, 2023-11-22:
> Last reset reason Hardware Watchdog
>
> Зачем произошла перезагрузка? И опять появилась нулевая температура внешнего датчика

Watchdog перезагружает МК. Что-то вызывает зависание. Попробуйте билд из поста выше залить.

kulisau, 2023-11-22:
It turns out there was a reason why my mom stopped using that power adapter. The usb socket was flaky. Even a slightest movement interrupted power. I replaced it with a new one and I have high hopes this was the culprit

Balaganoff, 2023-11-22:
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

ОК! Залил.  Понаблюдаю.

Laxilef, 2023-11-22:
> It turns out there was a reason why my mom stopped using that power adapter. The usb socket was flaky. Even a slightest movement interrupted power. I replaced it with a new one and I have high hopes this was the culprit

Hmm. Power quality is quite important for an ESP board. If there is a voltage drop, a freeze may occur.

Balaganoff, 2023-11-22:
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

Вернул назад на 1.3.3
С 1.3.4 opentherm_heating_setpoint установился в ноль и ни на какие регулировки не реагировало.

Laxilef, 2023-11-22:
> С 1.3.4 opentherm_heating_setpoint установился в ноль и ни на какие регулировки не реагировало.
Min/max heating temp поменяйте и max modulation = 100

@kulisau after upgrade to 1.3.4 you need to change the min/max heating temperature entities and the modulation level = 100. If these entities are turned off, turn them on.

kulisau, 2023-11-22:
I probably will hit every edge case possible 😀 now the DHW does work. The room has finally reached the set temperature and DHW just refuses to heat up. For some reason DHW and heating temperatures correlate a lot. As soon as I turn open the tap, water temp dropped from ~40 to 28C. The boiler pretends that it tries to heat the water, turns the flame at minimum power, but the water remains barely warm.
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

Balaganoff, 2023-11-22:
> > С 1.3.4 opentherm_heating_setpoint установился в ноль и ни на какие регулировки не реагировало.
>
> Min/max heating temp поменяйте и max modulation = 100

Это не помогло. И еще заметил выставил min max допустим 40 и 70. Через время max = "пусто"  min=90
Повторил несколько раз. Отопление не включается
В терминале периодически только это

[MAIN][INFO] Settings updated (EEPROM) - Это не вредно для памяти так часто перезаписывать ?
[OT][DHW][INFO] Set temp = 55  Почему все время передается если ничего не менялось?
[OT][HEATING][INFO] Set temp = 0
[OT][DHW][INFO] Set temp = 55
[OT][HEATING][INFO] Set temp = 0
[OT][DHW][INFO] Set temp = 55
[OT][HEATING][INFO] Set temp = 0

Laxilef, 2023-11-22:
Ok guys, changing the settings structure was a bad idea :) Please check this build. After upgrade pls check the min/max heating temperature entities and the modulation level.
[build.zip](https://github.com/Laxilef/OTGateway/files/13444100/build.zip)

kulisau, 2023-11-22:
The DHW is set to 47 degrees, btw.
I just set the desired room temperature to above than it really is to turn the heating on and boom, the DHW started running hot as it should, reduced heating temperature to below than it is and DHW started running cold. 🤦‍♂️

Laxilef, 2023-11-22:
WTF. Post the log (from telnet)

Balaganoff, 2023-11-22:
> Ok guys, changing the settings structure was a bad idea :) Please check this build. After upgrade pls check the min/max heating temperature entities and the modulation level. [build.zip](https://github.com/Laxilef/OTGateway/files/13444100/build.zip)

С этим релизом все встало на место с регулировками !

[REGULATOR][INFO] New target: 25.000000
[REGULATOR][EQUITHERM][INFO] New result: 51 (50.509998)

opentherm_heating_**min/ma**x_temp и модуляция тоже нормально сохраняет !

Laxilef, 2023-11-22:
Ok.

> [MAIN][INFO] Settings updated (EEPROM) - Это не вредно для памяти так часто перезаписывать ?

Вредно. Как и все в нашем мире. Но там запись в память не чаще 1 раза в 30 секунд.

> [OT][DHW][INFO] Set temp = 55 Почему все время передается если ничего не менялось?

Некоторые котлы требуют присылать температуру раз в какой-то интервал времени. Тут реализовано раз в минуту.

kulisau, 2023-11-22:
`[OT][TRACE] OT REQUEST ID:   57   Request: 90394100   Response: 50394100   Attem                                                                             pt:  1   Status: SUCCESS
[OT][TRACE] OT REQUEST ID:   18   Request:   120000   Response: f0120000   Attem                                                                             pt:  1   Status: INVALID
[OT][TRACE] OT REQUEST ID:   17   Request:   110000   Response: c0110000   Attem                                                                             pt:  1   Status: SUCCESS
[OT][TRACE] OT REQUEST ID:   26   Request: 801a0000   Response: 401a1a4c   Attempt:  1   Status: SUCCESS
[OT][TRACE] OT REQUEST ID:   25   Request: 80190000   Response: c0191be6   Attempt:  1   Status: SUCCESS
[OT][DHW][INFO] Set temp = 48
[OT][TRACE] OT REQUEST ID:    3   Request:    30000   Response: c0030129   Attempt:  1   Status: SUCCESS
[OT][TRACE] OT REQUEST ID:    2   Request: 90020029   Response: 50020029   Attempt:  1   Status: SUCCESS
[OT][TRACE] Slave member id code: 41
[OT][TRACE] Master member id code: 41
[OT][TRACE] OT REQUEST ID:    0   Request:     1200   Response: c0001200   Attempt:  1   Status: SUCCESS
[OT][TRACE] OT REQUEST ID:   14   Request: 100e0000   Response: d00e0000   Attempt:  1   Status: SUCCESS
[OT][TRACE] OT REQUEST ID:   18   Request:   120000   Response: f0120000   Attempt:  1   Status: INVALID
[OT][TRACE] OT REQUEST ID:   17   Request:   110000   Response: c0110000   Attempt:  1   Status: SUCCESS
[OT][TRACE] OT REQUEST ID:   26   Request: 801a0000   Response: 401a1a4c   Attempt:  1   Status: SUCCESS
[OT][TRACE] OT REQUEST ID:   25   Request: 80190000   Response: c0191be6   Attempt:  1   Status: SUCCESS
[OT][TRACE] OT REQUEST ID:    3   Request:    30000   Response: c0030129   Attempt:  1   Status: SUCCESS
[OT][TRACE] OT REQUEST ID:    2   Request: 90020029   Response: 50020029   Attempt:  1   Status: SUCCESS
[OT][TRACE] Slave member id code: 41
[OT][TRACE] Master member id code: 41
[OT][TRACE] OT REQUEST ID:    0   Request:     1200   Response: c0001200   Attempt:  1   Status: SUCCESS
[OT][TRACE] OT REQUEST ID:   14   Request: 100e0000   Response: d00e0000   Attempt:  1   Status: SUCCESS
[OT][TRACE] OT REQUEST ID:   18   Request:   120000   Response: f0120000   Attempt:  1   Status: INVALID
[OT][TRACE] OT REQUEST ID:   17   Request:   110000   Response: c0110000   Attempt:  1   Status: SUCCESS
[OT][TRACE] OT REQUEST ID:   26   Request: 801a0000   Response: c01a1a66   Attempt:  1   Status: SUCCESS
[OT][TRACE] OT REQUEST ID:   25   Request: 80190000   Response:        0   Attempt:  1   Status: TIMEOUT
[OT][TRACE] OT REQUEST ID:   25   Request: 80190000   Response: c0191be6   Attempt:  2   Status: SUCCESS
[OT][TRACE] OT REQUEST ID:    3   Request:    30000   Response: c0030129   Attempt:  1   Status: SUCCESS
[OT][TRACE] OT REQUEST ID:    2   Request: 90020029   Response: 50020029   Attempt:  1   Status: SUCCESS
[OT][TRACE] Slave member id code: 41
[OT][TRACE] Master member id code: 41
[OT][TRACE] OT REQUEST ID:    0   Request:     1200   Response: c0001200   Attempt:  1   Status: SUCCESS
[OT][TRACE] OT REQUEST ID:   14   Request: 100e0000   Response: d00e0000   Attempt:  1   Status: SUCCESS
[OT][TRACE] OT REQUEST ID:   18   Request:   120000   Response: f0120000   Attempt:  1   Status: INVALID
[OT][TRACE] OT REQUEST ID:   17   Request:   110000   Response: c0110000   Attempt:  1   Status: SUCCESS
[OT][TRACE] OT REQUEST ID:   26   Request: 801a0000   Response: c01a1be6   Attempt:  1   Status: SUCCESS
[OT][TRACE] OT REQUEST ID:   25   Request: 80190000   Response: c0191be6   Attempt:  1   Status: SUCCESS
[OT][TRACE] OT REQUEST ID:    3   Request:    30000   Response: c0030129   Attempt:  1   Status: SUCCESS
[OT][TRACE] OT REQUEST ID:    2   Request: 90020029   Response: 50020029   Attempt:  1   Status: SUCCESS
[OT][TRACE] Slave member id code: 41
[OT][TRACE] Master member id code: 41
[OT][TRACE] OT REQUEST ID:    0   Request:     1200   Response: 40001204   Attempt:  1   Status: SUCCESS
[OT][TRACE] OT REQUEST ID:   14   Request: 100e0000   Response: d00e0000   Attempt:  1   Status: SUCCESS
[OT][TRACE] OT REQUEST ID:   18   Request:   120000   Response: f0120000   Attempt:  1   Status: INVALID
[OT][TRACE] OT REQUEST ID:   17   Request:   110000   Response: c0110000   Attempt:  1   Status: SUCCESS
[OT][TRACE] OT REQUEST ID:   26   Request: 801a0000   Response: 401a1c19   Attempt:  1   Status: SUCCESS
[OT][TRACE] OT REQUEST ID:   25   Request: 80190000   Response: 40191c4c   Attempt:  1   Status: SUCCESS
[OT][TRACE] OT REQUEST ID:    3   Request:    30000   Response: c0030129   Attempt:  1   Status: SUCCESS
[OT][TRACE] OT REQUEST ID:    2   Request: 90020029   Response: 50020029   Attempt:  1   Status: SUCCESS
[OT][TRACE] Slave member id code: 41
[OT][TRACE] Master member id code: 41
[OT][TRACE] OT REQUEST ID:    0   Request:     1200   Response: 40001204   Attempt:  1   Status: SUCCESS
^C[OT][TRACE] OT REQUEST ID:   14   Request: 100e0000   Response: d00e0000   Attempt:  1   Status: SUCCESS
[OT][TRACE] OT REQUEST ID:   18   Request:   120000   Response: f0120000   Attempt:  1   Status: INVALID
[OT][TRACE] OT REQUEST ID:   17   Request:   110000   Response: c0110000   Attempt:  1   Status: SUCCESS
[OT][TRACE] OT REQUEST ID:   26   Request: 801a0000   Response: 401a1b66   Attempt:  1   Status: SUCCESS
[OT][TRACE] OT REQUEST ID:   25   Request: 80190000   Response: c0191acc   Attempt:  1   Status: SUCCESS
[OT][TRACE] OT REQUEST ID:    3   Request:    30000   Response: c0030129   Attempt:  1   Status: SUCCESS
[OT][TRACE] OT REQUEST ID:    2   Request: 90020029   Response: 50020029   Attempt:  1   Status: SUCCESS
[OT][TRACE] Slave member id code: 41
[OT][TRACE] Master member id code: 41
[OT][TRACE] OT REQUEST ID:    0   Request:     1200   Response: c0001200   Attempt:  1   Status: SUCCESS
[OT][TRACE] OT REQUEST ID:   14   Request: 100e0000   Response: d00e0000   Attempt:  1   Status: SUCCESS
[OT][TRACE] OT REQUEST ID:   18   Request:   120000   Response: f0120000   Attempt:  1   Status: INVALID
[OT][TRACE] OT REQUEST ID:   17   Request:   110000   Response: c0110000   Attempt:  1   Status: SUCCESS
[OT][TRACE] OT REQUEST ID:   26   Request: 801a0000   Response: 401a1b66   Attempt:  1   Status: SUCCESS
[OT][TRACE] OT REQUEST ID:   25   Request: 80190000   Response: c0191a66   Attempt:  1   Status: SUCCESS
[OT][TRACE] OT REQUEST ID:    3   Request:    30000   Response: c0030129   Attempt:  1   Status: SUCCESS
[OT][TRACE] OT REQUEST ID:    2   Request: 90020029   Response: 50020029   Attempt:  1   Status: SUCCESS
[OT][TRACE] Slave member id code: 41
[OT][TRACE] Master member id code: 41
[OT][TRACE] OT REQUEST ID:    0   Request:     1200   Response: c0001200   Attempt:  1   Status: SUCCESS
[OT][TRACE] OT REQUEST ID:   14   Request: 100e0000   Response: d00e0000   Attempt:  1   Status: SUCCESS
[OT][TRACE] OT REQUEST ID:   18   Request:   120000   Response: f0120000   Attempt:  1   Status: INVALID
[OT][TRACE] OT REQUEST ID:   17   Request:   110000   Response: c0110000   Attempt:  1   Status: SUCCESS
[OT][TRACE] OT REQUEST ID:   26   Request: 801a0000   Response: 401a1b66   Attempt:  1   Status: SUCCESS
[OT][TRACE] OT REQUEST ID:   25   Request: 80190000   Response: c0191acc   Attempt:  1   Status: SUCCESS
[OT][TRACE] OT REQUEST ID:    3   Request:    30000   Response: c0030129   Attempt:  1   Status: SUCCESS
[OT][TRACE] OT REQUEST ID:    2   Request: 90020029   Response: 50020029   Attempt:  1   Status: SUCCESS
[OT][TRACE] Slave member id code: 41
[OT][TRACE] Master member id code: 41
[OT][TRACE] OT REQUEST ID:    0   Request:     1200   Response: c0001200   Attempt:  1   Status: SUCCESS
[OT][TRACE] OT REQUEST ID:   14   Request: 100e0000   Response: d00e0000   Attempt:  1   Status: SUCCESS
[MAIN][VERB] Free heap size: 18208 of 81920 bytes, min: 11040 bytes (diff: 0 bytes)
[OT][TRACE] OT REQUEST ID:   18   Request:   120000   Response: f0120000   Attempt:  1   Status: INVALID
[OT][TRACE] OT REQUEST ID:   17   Request:   110000   Response: c0110000   Attempt:  1   Status: SUCCESS
[OT][TRACE] OT REQUEST ID:   26   Request: 801a0000   Response: c01a1b80   Attempt:  1   Status: SUCCESS
[OT][TRACE] OT REQUEST ID:   25   Request: 80190000   Response: 40191a80   Attempt:  1   Status: SUCCESS
[OT][TRACE] OT REQUEST ID:    3   Request:    30000   Response: c0030129   Attempt:  1   Status: SUCCESS
[OT][TRACE] OT REQUEST ID:    2
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

Thread 11 (2023-11-22):

Wishes

Balaganoff, 2023-11-22:
У платы Wemos / ESP осталось много свободных портов. В связи с этим есть такое пожелание на будущее.
1. Подключить по IC2 OLED дисплей на который вывести хотя-бы основные 4цифры - заданные температуры ГВС и отопления и текущие данные. Библиотеки как я понимаю под это дело уже готовы. Ну и из фантастики поуправлять автономно этими цифрами спомощью кнопок  ))
2. Управлять насосами. Хотелось-бы отключать насосы во время остановки обогрева.

Laxilef, 2023-11-22:
Если говорить про esp8266, то не все они безопасны для использования: https://randomnerdtutorials.com/esp8266-pinout-reference-gpios/
И в рамках esp8266, там уже размер кучи (RAM) критично мал, т.к. используются task'и для параллельной работы. Когда остается менее 10кб esp8266 работает не очень стабильно.

Для управления насосами нужны реле или мощные мосфеты, это лучше выносить отдельным блоком с отдельным питанием на какой-нибудь attiny и общаться по i2c/spi с esp8266.
На esp32 можно сделать, но у меня таких задач пока нет, можете добавить PR с реализацией.

Balaganoff, 2023-11-22:
> Для управления насосами нужны реле или мощные мосфеты, это лучше выносить отдельным блоком ...... из HA с помощью автоматизации вкл/выкл их, отслеживая статус parameters.heatingEnabled.

Связка разных блоков через HA  делает систему более нестабильной.  ИМХО роль HA должна быть в дополнительном сервисе, анализе и регулирования. А все остальное блок должен делать автономно.  В конце концов я почти уверен "переезд" с 8266 на esp32 не станет "камнем преткновения" ни в финансовом, ни в техническом вопросе, - ни в первом, ни во втором сложностей не должно возникнуть.

Balaganoff, 2023-11-22:
А у светодиода L3 "Status" какая логика работы?
Я лампочки не задействовал и может это то что нужно мне для управления дополнительным насосом ?

Laxilef, 2023-11-22:
https://github.com/Laxilef/OTGateway#leds

Balaganoff, 2023-11-22:
> https://github.com/Laxilef/OTGateway#leds
>
> Я могу добавить пин, который будет подтянут к питанию, когда котёл должен греть теплоноситель. Но не оч рекомендую без опторазвязки туда что-то подключать.

Это было-бы здорово!
А по поводу развязки - все реализовано внутри недорогих твердотельных реле на семисторах
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

Laxilef, 2023-11-22:
Ок. Но вам нужно будет собрать прошивку самостоятельно через platformio.

Laxilef, 2023-11-22:
Добавил в мастер ветку.

Сборка в вашем случае будет с доп build_flags: -D HEATING_STATUS_PIN=НОМЕР_GPIO, т.е. например:
```yaml
[env:d1_mini]
platform = ${esp8266_defaults.platform}
board = d1_mini
lib_deps = ${esp8266_defaults.lib_deps}
lib_ignore = ${esp8266_defaults.lib_ignore}
extra_scripts = ${esp8266_defaults.extra_scripts}
build_flags =
	${esp8266_defaults.build_flags}
	-D OT_IN_PIN_DEFAULT=4
	-D OT_OUT_PIN_DEFAULT=5
	-D SENSOR_OUTDOOR_PIN_DEFAULT=12
	-D SENSOR_INDOOR_PIN_DEFAULT=14
	;-D LED_STATUS_PIN=13
	;-D LED_OT_RX_PIN=15
	-D USE_TELNET=1
	-D HEATING_STATUS_PIN=13
```

Balaganoff, 2023-11-23:
> Ок. Но вам нужно будет собрать прошивку самостоятельно через platformio.

Я думаю, что смогу это сделать )  Спасибо! Буду пробовать.

Laxilef, 2023-12-06:
@Balaganoff добавил нормальное управление внешним насосом. На странице сетап новые параметры:
* Use external pump
* External pump GPIO
* External pump post circulation time (время в секундах)
* External pump anti stuck interval (время в секундах)
* External pump anti stuck time (время в секундах)

Скомпилируйте из мастер ветки, проверьте у себя. После обновления сбросятся настройки, сохраните их перед обновлением.

Balaganoff, 2023-12-07:
> @Balaganoff добавил нормальное управление внешним насосом. На странице сетап новые параметры:
...
> Скомпилируйте из мастер ветки, проверьте у себя. После обновления сбросятся настройки, сохраните их перед обновлением.

Спасибо ! Вечером попробую!

Laxilef, 2023-12-07:
Проверьте режим выбега насоса после отключения отопления и режим антизалипания. Для проверки тайминги можно временно установить меньше.

Balaganoff, 2023-12-07:
> Проверьте режим выбега насоса после отключения отопления и режим антизалипания. Для проверки тайминги можно временно установить меньше.

Выбег и интервальные запуски нормально работают! НО! Прошивка получилась нестабильна. Через время появляются перезапуски - это я увидел по графику температуры, а потом устройство вообще пропадает из сети и свою точку не поднимает. При этом котел видит связь и даже происходит регулирование. Помогает только ручной перезапуск.
Включу debug режим и попробую поймать этот момент в терминале

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

Laxilef, 2023-12-07:
У себя тоже наблюдаю перезагрузки. Похоже, что из-за телнета. Попробуйте собрать прошивку без него и понаблюдайте.

Balaganoff, 2023-12-07:
Все ! Без включенного "Debug" завис через несколько минут

Laxilef, 2023-12-07:
Поправил одну мелочь, может быть поможет. Проверьте у себя пожалуйста.

Balaganoff, 2023-12-07:
> Поправил одну мелочь, может быть поможет. Проверьте у себя пожалуйста.

ок ! Телнет включить при сборке ?

Laxilef, 2023-12-07:
Нужно через сериал порт смотреть что там происходит.
Займусь на выходных.

Laxilef, 2023-12-09:
Проверьте пожалуйста у себя с учетом последних коммитов.

Closed 2023-12-30.

Thread 12 (2023-11-25):

Diyless Thermostat with Wemos D1 Mini ESP32

mennodegraaf, 2023-11-25:
Great project! I would love to make it run on my Diyless Thermostat, which uses a Wemos D1 Mini ESP32. After adjusting the `platformio.ini` file to use `wemos_d1_mini32` it compiles. I have adjusted the pin mapping to use `OT_IN_PIN_DEFAULT=21`, `OT_OUT_PIN_DEFAULT=22` and `SENSOR_INDOOR_PIN_DEFAULT=18`, which should be correct as I have tested it with https://github.com/diyless/esp32-wifi-thermostat.

I noticed some issues however:
* OpenTherm does not work, it times out, although it is connected and configured correctly
* The DS18B20 temp sensor does not give output
* Settings `USE_TELNET=1` does not work at all (exception after startup)

Can you point me in some direction what I can try to get it to work?

Laxilef, 2023-11-25:
Thanks! Try using the build "firmware_nodemcu_32s_1.3.3.factory.bin" from the releases page.
You can set up pins on the "setup" page. If the OT does not respond, try swapping the input and output pins in the settings.
To read temperature from DS18B20 sensors in the device settings in Home Assistant, you need to select “External” for temperature sensors.

mennodegraaf, 2023-11-25:
I tried release `firmware_nodemcu` before, but that did not work on the Wemos D1 Mini32. So I compiled it myself after adding the following section to `platformio.ini`:

```
[env:wemos_d1_mini32]
platform = ${esp32_defaults.platform}
board = wemos_d1_mini32
lib_deps = ${esp32_defaults.lib_deps}
lib_ignore = ${esp32_defaults.lib_ignore}
extra_scripts = ${esp32_defaults.extra_scripts}
build_flags =
	${esp32_defaults.build_flags}
	-D OT_IN_PIN_DEFAULT=21
	-D OT_OUT_PIN_DEFAULT=22
	-D SENSOR_INDOOR_PIN_DEFAULT=18
	;-D WOKWI=1
	-D USE_TELNET=0
	;-D DEBUG_BY_DEFAULT=1
	;-D WM_DEBUG_MODE=3
```

Laxilef, 2023-11-25:
Hmm, it should work.
But I don't have this board to check.
I think we need to start by checking the GPIO. Upload a photo of the board with the shield installed.

mennodegraaf, 2023-11-25:
I will and can make a PR of the changes to `platformio.ini` if that helps. I can also provide some output of the error cases.

Laxilef, 2023-11-25:
That would be great!

Laxilef, 2023-11-26:
I think it would be better if you make a fork on Github, make changes and create a PR.

mennodegraaf, 2023-11-26:
Today I spent some more time on it. I also tested the same code on a Wemos D1 mini ESP8266 and Opentherm was working there. Comparing the ESP32 with ESP8266 over the web interface and Telnet, it turned out that the ESP32 version was very very slow. So it might have to do with some issues in the ESP32 scheduler.

mennodegraaf, 2023-11-27:
Indeed, Opentherm does NOT work on the D1 mini ESP32, but does work on the D1 mini ESP8266. As said, the difference might be caused by the scheduler as the ESP32 is very slow.

Laxilef, 2023-11-27:
OK thanks. I'll check this out soon.

mennodegraaf, 2023-11-27:
Great, btw I also noticed that when building with DEBUG_BY_DEFAULT it is stored in `settings.debug` and put in EEPROM once. At time at startup, this variable is retrieved from EEPROM. However, there is no way to change the configuration from the web interface, so if you have once set it to `false` or `true`, you can not change it later anymore with the build flag.

Laxilef, 2023-11-28:
You can change the debug value in the device settings in the Home Assistant

mennodegraaf, 2023-11-28:
Enabled debug and noticed an issue with shared data on the ESP32. The telnet output is very hard to read, which I think is caused by the ESP32 having 2 cores so the different tasks really run in parallel and may access shared data simultaneously unless this is prevented with a mutex. This happens a lot with the `TinyLogger::print` functions, but may also happen with other data shared between tasks (like data shared between OT and MQTT task).

Laxilef, 2023-11-29:
You're right. ESP32Scheduler was written only for code compatibility with the ESP32 platform. I really didn’t go deep into mutex and other features FreeRTOS, because the tasks code is not very related to each other.

I'll fix the logger, thanks.

mennodegraaf, 2023-12-01:
@Laxilef I managed to get the Opentherm functionality working! After investigating the interval and cycle times of the various tasks, it did not make sense (some tasks like OT were never executed). After I changed `xTaskCreatePinnedToCore()` to `xTaskCreate()` hereby letting the scheduler determine itself how to distribute the tasks over the cores it was ok. So there seems to be an issue with the `PinnedToCore` method.

Laxilef, 2023-12-01:
Hmm, that's interesting! Am I correct in understanding that the Opentherm Task was never executed on your board? Were there messages in the logs from Opentherm Task with debug enabled?

mennodegraaf, 2023-12-01:
Indeed, the Opentherm task was (almost) never executed. And the funny thing is that the same happened also to the MQTT task, so I could not enable debug.

I am not sure if changing the delay from 10ms to 1ms makes such a difference as another task will be executed anyway which likely take a bit longer than that. Btw, by not setting a yield callback it will use `yield` by default.

mennodegraaf, 2023-12-01:
If you are interested, I stored the `millis()` in `Task.h` before entering `loop()` and computed cycle time (time that loop is busy) and interval time (between current and previous start of loop) and logged the result. This is how it should be with `xTaskCreate` and you can see clearly that tasks are allocated to different cores (whatever is available).
```
[OpenTherm][TRACE] Loop on core 1, interval [6082/7035]
[Main][TRACE] Loop on core 1, interval [6/115]
[WifiManager][TRACE] Loop on core 1, interval [2/118]
[Mqtt][TRACE] Loop on core 1, interval [606/106]
[Main][TRACE] Loop on core 0, interval [5/114]
[WifiManager][TRACE] Loop on core 1, interval [2/113]
[Mqtt][TRACE] Loop on core 1, interval [0/712]
[Main][TRACE] Loop on core 0, interval [3/112]
[WifiManager][TRACE] Loop on core 0, interval [2/111]
[Mqtt][TRACE] Loop on core 1, interval [0/107]
[Main][TRACE] Loop on core 0, interval [3/110]
```

Laxilef, 2023-12-01:
Hmm. MqttTask had to run on core 0, together with WifiManagerTask. And other tasks on 1 core. It's strange that only MqttTask and OpenThermTask were not executed. However, I was unable to achieve this behavior on my nodemcu 32s.

Laxilef, 2023-12-01:
Yes, there is, but I did not connect it to the boiler, I am waiting for the delivery of the mini version.
It is impossible to assign higher priority to tasks, they block the core and the watchdog is triggered, because some tasks are executed without interval.
Of course, we can run tasks on both cores and let the scheduler independently decide on which core to run the tasks. I'll probably do that, thanks for the info!

Laxilef, 2023-12-02:
I found S2 mini for testing. Indeed, some tasks are never performed or are rarely performed. It’s strange that on nodemcu 32s it works differently, as if there is a built-in algorithm for interleaving tasks with the same priority. Most likely I need to correct the scheduler and add queues there.

Laxilef, 2023-12-02:
It looks like I understand what the problem is. Since freertos uses time slicing, if task1 used 100ms of CPU time, then until other tasks with the same priority also use 100ms of CPU time, the scheduler will not start task1.
Even though I try to switch context in long tasks, there are third party libraries that block the task until the action is completed. For example, a library for working with mqtt. It contains functions that send data to the mqtt server, and it’s probably impossible to switch the context in the write cycle.
Based on this information, we need to make task switching a simple interleaving method. However, when time slicing is disabled, the scheduler will simply launch any task that is ready without interleaving, which also does not suit us. Changing task priorities did not produce the desired result.

@mennodegraaf do you have any ideas?

mennodegraaf, 2023-12-02:
If I look at the source code, it seems the cooperative way of scheduling is assumed and tasks are not preempted by the scheduler, but they execute a `yield` or `delay` themselves after the `loop` (and some tasks even do it during the loop). Not sure if and how that could be adjusted on ESP-IDF?!

I would expect that tasks with strict timing requirements (like sensor, opentherm, regulator) need to run at a higher priority, so the scheduler first selects them when they are `Ready` to run. It is vital for these high prio tasks that they are periodic and the execution time is very limited, so there is enough time left to run low prio tasks (like wifi and mqtt). I have played a bit with this, but did not get it working well enough. Reasons could be:

- The execution time of the opentherm task is very high at the moment, which might be caused by waiting for results from an interrupt routine that checks the OT pin changes.
- There is a high number of yields in this task, which transfers control back to the scheduler (however if the prio is high I would expect that the scheduler than selects the OT task again immediately).
- The Logger is executed at the priority of the task that calls it, maybe a separate (low prio) tasks for that would be better.

Laxilef, 2023-12-02:
Yeah, you were right about priorities. I managed to run all the tasks on the c2 mini and, looking at the logs, everything works fine.
I've committed the changes, but now I need to check that openterm is working. You can also check it yourself using the latest version of the code.

Laxilef, 2023-12-02:
For debug the scheduler i used this task code:
```C++
#pragma once
#include <Arduino.h>
#include "AbstractTask.h"

class Task : public AbstractTask {
public:
  Task(bool enabled = true, unsigned long interval = 0) : AbstractTask(enabled, interval) {}

  void enable() override {
    AbstractTask::enable();
    begin();
    vTaskResume(tHandle);
  }

  void disable() override {
    AbstractTask::disable();
    vTaskSuspend(tHandle);
  }

  void yield() override {
    //Serial.printf("TASK '%s' YIELD START, CORE: %d, PRIORITY: %d\r\n", this->getTaskName(), xPortGetCoreID(), uxTaskPriorityGet(this->tHandle));

    this->estimated += micros() - this->loopStart;
    taskYIELD();
    this->entryCount++;

    if (millis() - this->prevReportYield > 1000) {
      Serial.printf("TASK '%12s' YIELD END\tCORE: %2d PRIORITY: %2d, ESTIMATED: %d\r\n", this->getTaskName(), xPortGetCoreID(), uxTaskPriorityGet(this->tHandle), (unsigned long) (this->estimated / 1000));
      this->prevReportYield = millis();
    }

    this->loopStart = micros();
  }

  void delay(unsigned long ms) override {
    //Serial.printf("TASK '%s' DELAY START, CORE: %d, PRIORITY: %d\r\n", this->getTaskName(), xPortGetCoreID(), uxTaskPriorityGet(this->tHandle));
    this->estimated += micros() - this->loopStart;
    vTaskDelay((ms == 0 || ms < portTICK_PERIOD_MS) ? 1 : ms / portTICK_PERIOD_MS);
    this->entryCount++;

    if (millis() - this->prevReportDelay > 1000) {
      Serial.printf("TASK '%12s' DELAY END\tCORE: %2d PRIORITY: %2d, ESTIMATED: %d\r\n", this->getTaskName(), xPortGetCoreID(), uxTaskPriorityGet(this->tHandle), (unsigned long) (this->estimated / 1000));
      this->prevReportDelay = millis();
    }

    this->loopStart = micros();
  }

protected:
  virtual const char* getTaskName() {
    return "";
  }

  virtual BaseType_t getTaskCore() {
    return tskNO_AFFINITY;
  }

  virtual uint32_t getTaskStackSize() {
    return 10000;
  }

  virtual int getTaskPriority() {
    return 1;
  }

  void static xLoopWrapper(void* pvParameters) {
    Task* task = static_cast<Task*>(pvParameters);
    while (true) {
      task->loopWrapper();
    }
  }

  void begin() override {
    if (!enabled || tHandle != nullptr) {
      return;
    }

    BaseType_t coreId;
    if (getTaskCore() == tskNO_AFFINITY || ESP.getChipCores() == 1 || getTaskCore() > (ESP.getChipCores() - 1)) {
      coreId = tskNO_AFFINITY;

    } else {
      coreId = getTaskCore();
    }

    xTaskCreatePinnedToCore(
      this->xLoopWrapper,
      getTaskName(),
      getTaskStackSize(),
      this,
      getTaskPriority(),
      &tHandle,
      coreId
    );
  }

  void loopWrapper() override {
    if (!setupDone) {
      setup();
      setupDone = true;
      yield();
    }

    if (millis() - this->prevReport > 1000) {
      Serial.printf("TASK '%12s' LOOP START\tCORE: %2d PRIORITY: %2d\r\n", this->getTaskName(), xPortGetCoreID(), uxTaskPriorityGet(this->tHandle));
    }
    this->estimated = 0;
    this->loopStart = micros();
    loop();
    this->estimated += micros() - this->loopStart;
    if (millis() - this->prevReport > 1000) {
      Serial.printf("TASK '%12s' LOOP END\tCORE: %2d PRIORITY: %2d, ENTRY COUNT: %d, ESTIMATED: %d\r\n", this->getTaskName(), xPortGetCoreID(), uxTaskPriorityGet(this->tHandle), this->entryCount, (unsigned long) (this->estimated / 1000));
      this->prevReport = millis();
    }

    if (interval == 0) {
      yield();

    } else {
      delay(interval);
    }
  }

private:
  TaskHandle_t tHandle = nullptr;
  unsigned int entryCount = 0;
  unsigned long prevReport = 0;
  unsigned long prevReportYield = 0;
  unsigned long prevReportDelay = 0;
  unsigned long estimated = 0;
  unsigned long loopStart = 0;
};
```

Laxilef, 2023-12-02:
Yes! I see that it works. But not ideal: many requests with a timeout response.

Laxilef, 2023-12-03:
As I continued debugging, I noticed some unusual behavior. If we switch context using yield() or delay(10) in a CustomOpenTherm::sendRequest() loop, then most requests fail. However, if we use delayMicroseconds(10000), then everything starts to work correctly.
Now I see that when switching context, interrupts are not processed or some interrupts are skipped.

Laxilef, 2023-12-04:
Any task is just an endless loop. At the end of each iteration, yield/delay is called to perform other tasks, that is, at the end of each iteration there is a context change (almost always). When we see that the iteration may take a long time, we call yield/delay and give control to the scheduler.
However, interrupts have higher priority. Any task must be suspended at the moment of interruption. This should happen, but I see that after a context switch the interrupt handler is not called/is not always called.

A few days ago I tried enabling/disabling configUSE_PREEMPTION, configUSE_TIME_SLICING, configIDLE_SHOULD_YIELD. This does change the behavior of the scheduler, but espressif does not recommend doing this.

mennodegraaf, 2023-12-05:
Well done! I hope to give it a try this evening.

mennodegraaf, 2023-12-05:
Gave it a try and it seems no OT timeouts are present anymore.
```
[SENSORS][INDOOR][INFO] New temp: 24.940001
[MAIN][VERB] Free heap size: 150972 of 291436 bytes, min: 150972 bytes (diff: 140464 bytes)
[OT][TRACE] OT REQUEST ID:    0   Request: 80000100   Response: 4000010a   Attempt:  1   Status: SUCCESS
[MAIN][VERB] Free heap size: 149960 of 291436 bytes, min: 149960 bytes (diff: 1012 bytes)
[OT][TRACE] OT REQUEST ID:   17   Request:   110000   Response: 40111f00   Attempt:  1   Status: SUCCESS
[MAIN][VERB] Free heap size: 147580 of 291436 bytes, min: 147580 bytes (diff: 2380 bytes)
[OT][TRACE] OT REQUEST ID:   25   Request: 80190000   Response: c0192000   Attempt:  1   Status: SUCCESS
[MAIN][VERB] Free heap size: 145264 of 291436 bytes, min: 145264 bytes (diff: 2316 bytes)
[SENSORS][INDOOR][TRACE] Raw temp: 25.062500
[MAIN][VERB] Free heap size: 145140 of 291436 bytes, min: 145140 bytes (diff: 124 bytes)
[OT][TRACE] OT REQUEST ID:    0   Request: 80000100   Response: 4000010a   Attempt:  1   Status: SUCCESS
[MAIN][VERB] Free heap size: 143560 of 291436 bytes, min: 143560 bytes (diff: 1580 bytes)
[OT][TRACE] OT REQUEST ID:   17   Request:   110000   Response: 40111f00   Attempt:  1   Status: SUCCESS
[OT][TRACE] OT REQUEST ID:   25   Request: 80190000   Response: c0192000   Attempt:  1   Status: SUCCESS
[OT][HEATING][INFO] Set temp = 35
[OT][TRACE] OT REQUEST ID:    1   Request: 90012300   Response: 50012300   Attempt:  1   Status: SUCCESS
[OT][TRACE] OT REQUEST ID:    0   Request: 80000100   Response: 4000010a   Attempt:  1   Status: SUCCESS
[SENSORS][INDOOR][TRACE] Raw temp: 25.062500
[OT][TRACE] OT REQUEST ID:   17   Request:   110000   Response: 40111f00   Attempt:  1   Status: SUCCESS
[OT][TRACE] OT REQUEST ID:   25   Request: 80190000   Response: c0192000   Attempt:  1   Status: SUCCESS
```

mennodegraaf, 2023-12-05:
A few observations still:

- The OT task does not run close to every 1s, but more like once every 5s
- Setting master/slave version on my boiler fails, same for setting master config. Does that matter much?
- The TelnetStream logger seems to be (a lot) slower on ESP32 than on ESP8266
- Having (relative) timestamps in the log would be very helpful for debugging

mennodegraaf, 2023-12-05:
Another thought. My DS18B20 temp sensor reports a way too high temperature (more than 6 deg too high). The ESP32 has bluetooth support and the Diyless thermostat comes with an accurate BLE temperature sensor. Would it be interesting to add support for Bluetooth sensors?

Laxilef, 2023-12-05:
> The OT task does not run close to every 1s, but more like once every 5s

That's right. Executing requests does take time, after each request there is a task switch so that other tasks execute correctly.

> Setting master/slave version on my boiler fails, same for setting master config. Does that matter much?

If your boiler does not support these IDs, then they are not important to it.

> The TelnetStream logger seems to be (a lot) slower on ESP32 than on ESP8266

I noticed this too. I think this is a feature of the TCPServer implementation on ESP32. It may be worth adding a buffer, because now it is sending one character at a time. The same thing happened with the mqtt client, and when I added a buffer, the speed of sending the response increased greatly.

> Having (relative) timestamps in the log would be very helpful for debugging

Good idea

> My DS18B20 temp sensor reports a way too high temperature (more than 6 deg too high).

To correct the temperature you can use **number.opentherm_outdoor_sensor_offset** and **number.opentherm_indoor_sensor_offset**

> The ESP32 has bluetooth support and the Diyless thermostat comes with an accurate BLE temperature sensor. Would it be interesting to add support for Bluetooth sensors?

That would be great, but I have no experience with BLE.

mennodegraaf, 2023-12-06:
> That would be great, but I have no experience with BLE.

I can have a look into the BLE temp sensor.

mennodegraaf, 2023-12-06:
Another feature that is of great interest to me, is multi-zone support. So, one OT interface, but multiple rooms each with a sensor and a regulator class. The heat demand of each room is combined and sent over OT. With the possibility to control a valve (on a radiator or underfloor divider) the heat can be sent only to the rooms that need it.

Do you have some thoughts on this?

Laxilef, 2023-12-06:
> The heat demand of each room is combined and sent over OT.

How? Using OT, we can simply transmit the desired coolant temperature.

Additional adjustments in rooms can be made using the generic thermostat integration in the Home Assistant.
How I did it:
1. A zigbee temperature sensor is installed in each room
2. There is an individual pipe from the collector for each room
3. STOUT STE-0010 valves are installed on the collector for pipe each room
4. Valves are connected to a multichannel zigbee relay. For example 8 channel DIY relay from modkam
5. Generic thermostats are created for each valve in the home assistant.

mennodegraaf, 2023-12-07:
> I can have a look into the BLE temp sensor.

I managed to read the battery level, temperature and humidity from the BLE sensor. The default BLE stack size is huge however, so it does not fit in flash and ram anymore. Switching to NimBLE instead and try to get it to fit all together.

martinarva, 2023-12-21:
I have the Diyless kit: https://diyless.com/product/opentherm-thermostat

Managed to flash it to the latest OTGateway. Everything except OT works.

From debug:
```
 2   Status: TIMEOUT                                                    
[DEBUG] OT REQUEST ID:    3   Request:    30000   Response:        0   Attempt:
 3   Status: TIMEOUT                                                    
```
Tried to swap the in and out pins in the settings but no luck.

Laxilef, 2023-12-21:
1.3.3? Build the firmware from the master branch and flash your esp.

martinarva, 2023-12-21:
I used this: [firmware_nodemcu_32s_1.3.3.factory.bin](https://github.com/Laxilef/OTGateway/releases/download/1.3.3/firmware_nodemcu_32s_1.3.3.factory.bin)

Laxilef, 2023-12-21:
Build the firmware from sources via platformio. Or wait for the release of 1.4.0

martinarva, 2023-12-21:
I don't know if its important, but just checked whats under the cover and it's ESP-WROOM-32 not D1 Mini.

martinarva, 2023-12-21:
And seems that i'm not up to task building firmware my own. Would it be possible you can do this for me @Laxilef?

Laxilef, 2023-12-21:
> I don't know if its important, but just checked whats under the cover and it's ESP-WROOM-32 not D1 Mini.

Upload the board photo

martinarva, 2023-12-21:
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

Thanks! Everything works now!

martinarva, 2024-11-21:
Hi! Old topic, but i tried to upgrade my ESP-WROOM-32 (D1 mini?) to new version.

I used the factory firmware for filesystem: v3.4.0.0 ESP32-MINI-1-AT-V3.4.0.0.zip (Recommended)

and latest firmware: firmware_d1_mini32_1.4.6.factory.bin

It did flash correctly and everyhting was verified, but device has only red light and the hotspot is not available.

@Laxilef , could you please check into it? Maybe i use wrong image or some other issue? As you can see here, last time you sent the correct firmware and it was working for more than a year.

Laxilef, 2024-11-22:
Hi @martinarva,

> I used the factory firmware for filesystem: v3.4.0.0 ESP32-MINI-1-AT-V3.4.0.0.zip (Recommended)

What is this? You need to use the filesystem file from the release 1.4.6:
https://github.com/Laxilef/OTGateway/releases/download/1.4.6/filesystem_d1_mini32_1.4.6.bin

martinarva, 2024-11-23:
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

I was reffering this quide https://github.com/Laxilef/OTGateway/wiki#build-firmware and specifically this "For ESP32 use factory images!"

now tried with
filesystem_d1_mini32_1.4.6.bin 0x0
firmware_d1_mini32_1.4.6.bin 0x3700

What steps i did:

1. Erase - esptool.py --chip esp32 --port /dev/tty.wchusbserial567E0542441 erase_flash
     This went well
2. esptool.py --chip esp32 --port /dev/tty.wchusbserial567E0542441 write_flash -z 0x0 ~/Downloads/esp/filesystem_d1_mini32_1.4.6.bin
     This went well
 3. esptool.py --chip esp32 --port /dev/tty.wchusbserial567E0542441 write_flash -z 0x370000 ~/Downloads/esp/firmware_d1_mini32_1.4.6.bin
    `A fatal error occurred: File /Users/martinarva/Downloads/esp/firmware_d1_mini32_1.4.6.bin (length 1500464) at offset 3604480 will not fit in 4194304 bytes of flash. Use --flash-size argument, or change flashing address.`

 my system
 Chip is ESP32D0WDQ5 (revision 3)
Features: WiFi, BT, Dual Core, 240MHz, VRef calibration in efuse, Coding Scheme None
Crystal is 40MHz
MAC: e0:5a:1b:d0:81:20
Uploading stub...
Running stub...
Stub running...
Manufacturer: 5e
Device: 4016
Detected flash size: 4MB

Looks like i have 4mb version and it runs out of memory. Could it be possible to have lower the adress offset to something lower than 0x370000 or is my 4b just too low to run OT Gateway?

Laxilef, 2024-11-24:
For the firmware need to use address ``0x0``, and for the filesystem address ``0x370000``. Not the other way around. Factory images can be found on the releases page.

Closed 2024-01-10.

Thread 14 (2023-11-28):

Request: Send MSG ID24 Room Temperature and ID27 Outside Temperature

aurelmarius, 2023-11-28:
Hello,
Do you think is possible to send Room Temperature and Outside Temperature from HA to opentherm ? I'm running nodoshop's opentherm gateway in conjuction with your OTGateway and it supports ID24 and 27 from master device.
Also MsgID 57 Max CH water Setpoint that i set in OTGateway it is not sent to boiler, i had to set it manualy.
Thanks.
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

Laxilef, 2023-11-28:
Hi,
Yes, ID 23 and 24 can be sent. But why is this necessary?
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

ID57 must be sent:
https://github.com/Laxilef/OTGateway/blob/ead8c64e925812ef27b3dc7517a04b07b2e89b5b/src/OpenThermTask.h#L216

Laxilef, 2023-11-28:
I think this can be added.
P.S. What kind of display?

aurelmarius, 2023-11-28:
It is a waveshare epaper 7.5 screen hooked up to esp32.
If it is too hard to implement this, i will eventualy flash the screen with esphome and get sensor data from homeassistant.

Closed 2023-12-24.

Thread 15 (2023-12-01):

Adapter compatibility ESP32 S3 + DIYLESS

critictidier, 2023-12-01:
Great project, thank you!

I’m currently using https://diyless.com/product/opentherm-thermostat2 based on ESP32 S3 and original firmware.

Please advise if I can use your latest release in that setup? I wouldn’t expect the display of that board to be compatible and it’s not important in my scenario.

Laxilef, 2023-12-01:
Hi, thanks!
Now I'm working on stability on the esp32 platform. It should work on S3 too, but I haven't tested it. When the next version comes out, you can test it. But the display and BLE sensors are not supported.

For tests, you need to find out which GPIOs are connected to opentherm.

Closed 2024-01-10.

Thread 16 (2023-12-07):

Report temperature from forecast doesn't work

SimplyKot, 2023-12-07:
Use this instruction:
https://github.com/Laxilef/OTGateway/wiki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

On saving integration get error:
"Message malformed: Entity {{ source_entity }} is neither a valid entity ID nor a valid UUID for dictionary value @ data['entity_id'"

Attributes is present:
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

Делаю по инструкции и после копирования и редактирования скрипта автоматизации получаю ошибку:
"Message malformed: Entity {{ source_entity }} is neither a valid entity ID nor a valid UUID for dictionary value @ data['entity_id'"

При этом атрибуты в объекте weather.home есть.

Версия HA core 2023.2.2

telegram: @simply_kot

Laxilef, 2023-12-07:
Обновил

SimplyKot, 2023-12-07:
Сохранился нормально.
При ручном запуске срабатывает норамльно, но при автоматическом запуске не выполнятеся.
Спотыкается о
`condition:
  - condition: template
    value_template: "{{ has_value(source_entity) and has_value(target_entity) }}"`

С формулировкой
Error: In 'template' condition: UndefinedError: 'has_value' is undefined

Трассировка:
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

Laxilef, 2023-12-07:
Какая версия HA? Функция has_value появилась с 2023.4

SimplyKot, 2023-12-07:
Версия HA core 2023.2.2
На праздниках обновлюсь. Спасибо.

Laxilef, 2023-12-07:
has_value можно заменить временно на
```
source_entity not in ['0', 'unavailable']
```
Аналогично в других участках кода.

Laxilef, 2023-12-07:
обновил, вернул совместимость с предыдущими версиями HA

Closed 2023-12-07.

Thread 18 (2023-12-08):

In some conditions OTGateway reports 0 for setpoint and outdoor temperature

SimplyKot, 2023-12-08:
In some conditions OTGateway reports 0 for setpoint and outdoor temperature

При некоторых условиях с контроллера проходят нули в параметрах "Установленная темпервтура" и  "Вненшяя температура".
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

SimplyKot, 2023-12-11:
Прошивка 1.3.3
Данные о внешней темературе переправлены с gismeteo
Ошибка наблюдается при первом вклбчении шлюза.

Кроме того, есть проблема в определении досупности шлюза.

При потери wifi переходит в аварийный режим с предустановленной температурой (что просто отлично), но  в HA остается активным.
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
Тут в 15-00 отлючен роутер.

При этом термостат отображается активным и показывает постоянный нагрев.
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

SimplyKot, 2023-12-11:
Провел тестирование на отсутствие связи и на отсутствие питания
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

Вывод - OpenTherm Status - всегда выдает ОК, хотя Status определяет состояние правильно.

Laxilef, 2023-12-11:
Спасибо! Поправлю.

Laxilef, 2023-12-15:
Исправлено в мастер ветке, проверьте.

Closed 2024-01-12.

Thread 20 (2023-12-09):

Opentherm Gateway Heating

strk90, 2023-12-09:
Подскажите как установить на термостате Heating  целевую температуру 23,0 °C?
На термостате можно установить минимальную температуру 35°C.
Термостат контролирует температуру теплоносителя (heating temperature),  а не температуру в доме (indoor)?

(https://github.com/Laxilef/OTGateway/assets/119970190/9fda951b-f219-4945-a931-cf3f69fa9acc)

Laxilef, 2023-12-09:
Как и любой другой термостат, он регулирует температуру теплоносителя. Для расчета температуры теплоносителя для поддержки желаемой температуры в доме используется ПЗА (погодозависимое регулирование, equitherm) или PID.
Если ни один из этих режимов не включен, то температуру теплоносителя нужно устанавливать самостоятельно.
Почитайте quick start в wiki.

strk90, 2023-12-09:
Поскажите как задать желаемую температуру в доме?
Нужно какой-то дополнительный термостат написать?

Laxilef, 2023-12-09:
Включить и настроить Equitherm, настроить датчики внешней и внутренней температуры и установить желаемую температуру в термостате в home assistant.
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

strk90, 2023-12-09:
Все я так сделал.
Почему-то у меня целевой параметр, который отвечает за желаемую температуру, устанавливает желаемую температуру теплоносителя.
Может проблема в моем котле?
Модель котла baltur tesis 24.

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

strk90, 2023-12-09:
> Включить и настроить Equitherm, настроить датчики внешней и внутренней температуры и установить желаемую температуру в термостате в home assistant. 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

Буду разбираться.
Спасибо!

Laxilef, 2023-12-09:
Странно, после включения Equitherm через некоторое время конфигурация термостата ``climate.opentherm_heating`` должна была обновиться, в т.ч. нижний и верхний предел устанавливаемых температур. Попробуйте esp перезагрузить.
Версия 1.3.3 прошита?

strk90, 2023-12-09:
Да, версия 1.3.3.
Попробую прошить другую esp.

Laxilef, 2023-12-09:
Это последняя стабильная версия, всё нормально.
Попробуйте esp перезагрузить. После перезагрузки вся конфигурация сущностей должна обновиться.

strk90, 2023-12-10:
Заработало!
Спасибо!

Closed 2023-12-10.

Thread 21 (2023-12-13):

Domusa Bioclass HM 16

Laxilef, 2023-12-13:
I have assembled a DIYLESS Thermostat shield with a D1 Mini and installed version 1.3.3

It works with my Domusa Bioclass HM 16 pellet boiler. I have left the master ID with value 0 (default)

Almost everything works, DHW, correct. Diagnostics, fault messages, etc. ok. But I don't see the % modulation, my old Tado showed me that value. Is there any way to see it? I'm interested to see if the modulation works well. I don't see the value of pressure either.

On the other hand, wouldn't it be more correct to show the HW controller in HA as water_heater entity and not as climate?

_Originally posted by @MikelillOi in https://github.com/Laxilef/OTGateway/issues/3#issuecomment-1851397379_

> Your "flame" is always on, even when heating = off. I don't know why this could be, but it's not right. The request for get modulation is standard. If it is always 0, then the boiler does not support this request.

I can confirm that the boiler continues to work even though it appears as off in the integration.

The comercial Tado thermostat showed the modulation percentage correctly. Can we read any log or something to investigate it?

Laxilef, 2023-12-13:
@MikelillOi I think we should continue in another issue.
You can listen to the communication between the boiler and thermostat using the firmware monitor from Ihor Melnyk: https://github.com/ihormelnyk/opentherm_library/blob/master/examples/OpenThermGatewayMonitor_Demo/OpenThermGatewayMonitor_Demo.ino

Your boiler may be using non-specific IDs for communication.

MikelillOi, 2023-12-14:
Thank you for open a new issue.

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

Here you have 4 sensor history graphic. Heater, DHW, Flame and modulation.

In my old Tado, there was only one option to configure OpenTherm, which makes me think that the boiler will use the predefined message to indicate the modulation.

Another strange thing, as we saw, is that the "heating" sensor turns off and on, and the boiler doesn't really stop.

At the afternoon, I will make somo test with OTMonitorDemo, and compiling the latest build of yout project.

Laxilef, 2023-12-14:
> Another strange thing, as we saw, is that the "heating" sensor turns off and on, and the boiler doesn't really stop.

Try turning on "Modulation sync with heating"

Laxilef, 2023-12-19:
I think you should start by listening to the communication between the boiler and the Tado thermostat.

MikelillOi, 2023-12-20:
> I think you should start by listening to the communication between the boiler and the Tado thermostat.

Can I do it with Tasmota or other firmware?  So I don't have to buy more hardware

Laxilef, 2023-12-20:
No, the slave needs another board.

Closed 2024-01-09.

Thread 23 (2023-12-15):

Предложения по работе с PID

bigbrother72, 2023-12-15:
Здравствуйте

У меня включена работа по ПЗА и ПИД.

По ПЗА температура выставляется достаточно грубо в зависимости только от температуры внешней. Не учитывается ветер, влажность итд.  Т.е. у меня в доме например при -25 градусах на улице и без ветра температура в СО может быть 60-65 градусов для температуры в комнате где стоит термосенсор.
А если с ветром - то и +75 можно загонять в батареи, чтобы было дома +21 градус.  Поэтому более точная регулировка осуществляется через PID.

В ваш код добавил немного модификаций.

1. Для того, чтобы PID не вычислялся каждые несколько секунд, нужно ввести задержку в несколько минут, так как процесс сильно инерционный и D коэффициент не отрабатывает, если вызывать слишком быстро расчет ПИД . Я у себя поставил раз в три минуты вызов вычисления пид .

В функции
```
  float getPidTemp(int minTemp, int maxTemp) {
    pidRegulator.Kp = settings.pid.p_factor;
    pidRegulator.Ki = settings.pid.i_factor;
    pidRegulator.Kd = settings.pid.d_factor;

// задержка для вычисления пид 3 минуты
    pidRegulator.setDt(180000);

......

//заменяем getResultNow на getResultTimer
    //return pidRegulator.getResultNow();
    return pidRegulator.getResultTimer();
```

И в src\MqttTask.h и в src\HomeAssistantHelper.h надо расширить диапазон возможных значений для P,I,D.
У меня например P=50, I=0.006, D=10000

Также установить гистерезис побольше например 1 градус - ПИД сам будет держать заданную температуру, без отключения котла по превышению гистерезиса.

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

Laxilef, 2023-12-15:
Изучу, спасибо!

Laxilef, 2023-12-15:
pidRegulator.setDt(180000) не сработает, он принимает тип signed short, куда влезает [-32767, +32767]. Надо в репо открыть issue, чтобы поменяли тип на unsigned int

Laxilef, 2023-12-15:
> По ПЗА температура выставляется достаточно грубо в зависимости только от температуры внешней. Не учитывается ветер, влажность итд. Т.е. у меня в доме например при -25 градусах на улице и без ветра температура в СО может быть 60-65 градусов для температуры в комнате где стоит термосенсор.
> А если с ветром - то и +75 можно загонять в батареи, чтобы было дома +21 градус. Поэтому более точная регулировка осуществляется через PID.

А вы комнатный датчик не используете? ПЗА же корректирует температуру теплоносителя в т.ч. и по комнатному датчику.

bigbrother72, 2023-12-16:
> pidRegulator.setDt(180000) не сработает, он принимает тип signed short, куда влезает [-32767, +32767]. Надо в репо открыть issue, чтобы поменяли тип на unsigned int

да. забыл про это написать. я уже месяц примерно назад это сделал.
там тоже поставил другой тип.
Может быть даже поставить изменяемый через интерфейс HA параметр - Интервал подсчета ПИД. А то у каждого он может быть разный. Я начинал от 10 минут, потом 5 минут. Остановился на трех минутах - за это время есть какая-то осмысленная разница между предыдущим значением и текущим и проходит достаточно времени, чтобы ПИД понять мог.

bigbrother72, 2023-12-16:
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

Комнатный датчик на esphome у меня стоит в самой холодной комнате. Через автоматизацию в HA потом передаю в opentherm контролер. Насколько понял эта температура не учитывается в эквитермических функциях. Только наружная учитывается.

Laxilef, 2023-12-16:
> Насколько понял эта температура не учитывается в эквитермических функциях. Только наружная учитывается.

Очень даже учитывается. Коэф. Т.

Laxilef, 2023-12-20:
@bigbrother72 добавил в мастер ветку возможность редактирования Dt и, надеюсь временно, заменил библиотеку на форк для корректной работы с Dt свыше 32 секунд. Протестируйте у себя.

bigbrother72, 2024-01-03:
вы добавили определение
GyverPID<int, unsigned long> pidRegulator(0, 0, 0);

а надо
GyverPID<float,  unsigned long> pidRegulator(0, 0, 0);

иначе в целых числах там идет расчет

Closed 2024-01-12.

Thread 25 (2023-12-21):

Gas Consumption over OpenTherme

martinarva, 2023-12-21:
I have Vitodens 100W gas heater and just have set up OTGateway. Great work and thank you for that. I have both gas heater and heat-water pump and now i'm able to automate between them so i can head my house most cost effective way.

Opening my gas heater to smart world made me think that is there a way to get gas consumption information from Vitodens over opentherm?

Laxilef, 2023-12-21:
Hi, thanks!
The boiler does not report gas consumption. You can try to calculate the gas consumption using the modulation level.

martinarva, 2023-12-21:
> Hi, thanks! The boiler does not report gas consumption. You can try to calculate the gas consumption using the modulation level.

Modulation is an option yes, but i don't have a clue how much it consumes in different levels.

Laxilef, 2023-12-21:
In the specification for the boiler you can see the gas consumption at 100% modulation :)

martinarva, 2023-12-22:
> In the specification for the boiler you can see the gas consumption at 100% modulation :) If the values are linear, then you can create a sensor in Home Assistant.

great idea, i'll look into it

martinarva, 2023-12-23:
@Laxilef , can i pick your brain a little bit?

It was not easy to find information about gas consumption of my gas heater but i found somehting:

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

So do i understand correctly that in 100% modulation consumption is 3.31 m2/h?

Laxilef, 2023-12-23:
Yes, it looks like it
Check this with your gas meter. You can look at the consumption per minute at 100% modulation and multiply this value by 60.
To check linearity, repeat this for modulation 75, 50, 25%

martinarva, 2024-02-21:
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

I did it like this:

`#Gas heater consumption and cost

  - platform: template
    sensors:
      current_gas_consumption:
        friendly_name: "Current Gas Consumption"
        unit_of_measurement: 'W'
        value_template: >-
          {% set modulation_level = states('sensor.opentherm_modulation_level') %}
          {% set max_power = 3310 %}
          {% if modulation_level not in ['unknown', 'unavailable', 'none'] and modulation_level | float >= 0 %}
            {{ (max_power * modulation_level | float / 100) | round(0) }}
          {% else %}
            0
          {% endif %}

  - platform: template
    sensors:
      current_gas_cost:
        friendly_name: "Current Gas Cost"
        unit_of_measurement: 'EUR'
        value_template: >-
          {% set price_per_kwh = states('sensor.total_gas_price_kwh_vat') %}
          {% set current_power = states('sensor.current_gas_consumption') %}
          {% if price_per_kwh not in ['unknown', 'unavailable', 'none'] and current_power not in ['unknown', 'unavailable', 'none'] %}
            {{ (price_per_kwh | float * current_power | float / 1000) | round(2) }}
          {% else %}
            0
          {% endif %}`
  
First sensor calculates the current gas consumption in watts (W) based on the modulation level of the gas heater. It uses the OpenTherm modulation level as a reference to determine the current power output, with a maximum power parameter set at 3310W, which is my heater max on full load (perumably 100% modulation).

Complementing the consumption sensor, the Current Gas Cost sensor provides an estimation of the current cost of gas consumption in euros (EUR). It calculates the cost by taking the current gas consumption data and the price per kilowatt-hour (kWh), including VAT, to provide a real-time estimation of gas expenses.

But seems that this method does not work and consumption is off. Here is comparison with my gas provider numbers:
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

Laxilef, 2024-02-21:
Template:
```yaml
{% set level = 3 %}
{% set matrix = {
100: 3.60,
95: 3.47, 90: 3.27,
85: 3.10, 80: 2.97,
75: 2.79, 70: 2.62,
65: 2.43, 60: 2.28,
55: 2.09, 50: 1.92,
45: 1.74, 40: 1.57,
35: 1.43, 30: 1.27,
25: 1.06, 20: 0.88,
15: 0.70, 10: 0.52,
5: 0.33, 1: 0.23,
0: 0.00
}
%}
{% set ns = namespace(consumption = 0, prevValue = 0, prevModLevel = 0) %}
{% if level in matrix %}
  {% set ns.consumption = matrix[level] %}
{% else %}
  {% for modLevel in matrix|sort(reverse = False) %}
    {% set value = matrix[modLevel] %}

    {% if ns.consumption == 0 %}
      {% if level > modLevel %}
        {% set ns.prevValue = matrix[modLevel] %}
        {% set ns.prevModLevel = modLevel %}
      {% else %}
        {% set dividend = value - ns.prevValue %}
        {% set divisor = modLevel - ns.prevModLevel %}
        {% set delta = level - ns.prevModLevel %}
        {% set ns.consumption = (delta * dividend) / divisor + ns.prevValue %}
      {% endif %}
    {% endif %}
  {% endfor %}
{% endif %}

{{ ns.consumption|round(2) }}
```

vespadrift, 2024-02-21:
@Laxilef, it works, thank you!

martinarva, 2025-02-14:
Old topic, but i can see that there is a power entity in the newer versions
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

@Laxilef , can you plese tell what it is and can I use it to calculate the gas consumption?

Closed 2023-12-22.

Thread 26 (2023-12-22):

Heating max temp is not set

martinarva, 2023-12-22:
Hi!

I have set the heating max temp to 45 degrees, as i have under floor heating and more is not recommenced.

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

But in the diagnostic section it's still 80 degrees
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

Using the latest 1.4.0-rc.5

Laxilef, 2023-12-22:
The "Current heating max temp" is the maximum temperature that can be set in the boiler.  Often the value of this parameter can be changed through the boiler service menu.

However, "Heating max temp" will be used when calculating the heating temperature. This is easy to test: set the temperature to 30 degrees with PID/Equitherm enabled and see what maximum temperature is set in the "Heating setpoint".

These 2 parameters are not related to each other.  Except that you cannot set "Heating max temp" greater than "Current heating max temp".

Closed 2024-01-11.

Thread 27 (2023-12-23):

Hot Water start and stop

martinarva, 2023-12-23:
I have set domestic hot water to 46 degrees. It stopped heating on 49.5 degrees
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

In my heat pump i can set heating start and stop. For example start heating when it's under 42 and stop at 46.

What is the logic here with this? When I select 46 on the thermostat in HA, what are the start and stop degrees in OTGateway and Gas Heater?

Laxilef, 2023-12-23:
When you set 46 degrees, the controller simply send this value to the boiler. The boiler itself decides when to turn on and off DHW heating.

blitzu, 2023-12-27:
I have noticed a strange behavior: if the set temperature for domestic hot water (DHW) is lower than the set temperature for heating supply, when the set DHW temperature is exceeded, the flame stops because the DHW temperature has reached its limit. Normally, the heating of the thermal agent should continue until the set room temperature is reached.

Laxilef, 2023-12-27:
The burner is controlled by the boiler, not the controller. However, on a boiler, DHW most often has a higher priority than heating if DHW is turned on (DHW tap is open).

blitzu, 2023-12-27:
> The burner is controlled by the boiler, not the controller. However, on a boiler, DHW most often has a higher priority than heating if DHW is turned on (DHW tap is open).

the behavior appears with tap closed

Laxilef, 2023-12-28:
@blitzu hmm, that's strange. Which version are you using?

Closed 2024-01-17.

Thread 28 (2023-12-23):

Monitoring mode only ?

0BuRner, 2023-12-23:
Hello,
Just wanted to know if it's possible to avoid sending any data to the data bus, but only listening on it ?
I don't want to interfere with my manual wireless thermostat that comes with my boiler...
I'm using this OT gateway: https://diyless.com/product/esp8266-opentherm-gateway with Wemos D1 Mini ESP32

Laxilef, 2023-12-24:
Hi,
No, it's not implemented, but I was thinking about it

0BuRner, 2024-01-02:
Do you think it will require lot of work ?
If you already had an idea on how to do it, maybe you can describe here what's your vision on how to implement that and I can give it a try in my free times

Laxilef, 2024-01-02:
It is not difficult. But this requires additional hardware, which I don’t have: a slave shield and a thermostat.

I think it should work like this:
* a thermostat must be connected to the slave shield
* the boiler must be connected to the master shield

The controller receives commands from the thermostat and sends them to the boiler, having received a response from the boiler, the controller sends it to the thermostat. This can be done in the ``OpenthermTask``.

However, I wouldn't want to just do a transparent proxy of commands. We need to leave the option to use PID and Equitherm modes. To do this, you need to filter the commands received from the thermostat.

Thus, if one of these modes is enabled on the controller, having received a command from the thermostat to set the temperature, we must either ignore this command or set this value as the desired room temperature.

7oxicshadow, 2024-01-11:
+1 on this. I have the same gateway board as @0BuRner and it sounds like we have the same goal. To be able to monitor the opentherm traffic between a thermostat and boiler without interference from the arduino interface.

I will also take a look at the source to see if I can understand how Tx and Rx are working.

0BuRner, 2024-04-13:
Hi,
Any news on this ? I looked a bit to the code the other day but unfortunately I'm not comfortable enough with it to be able to make such change...

Laxilef, 2024-04-13:
Hi,
No news. I do not have a thermostat and slave shield for testing.

7oxicshadow, 2024-04-13:
@0BuRner I have created a basic project which seems stable over the past couple of months usage. Its a bit bare bones and was not designed with flexibility in mind but might be good enough as a reference project for you.

I am afraid it is customised to my boiler (baxi)  / stat (ESi) combination

https://github.com/7oxicshadow/openThermGateway_HA

Closed 2024-01-31.

Thread 29 (2024-01-07):

Start/stop heating with HA automation instead of temp control

martinarva, 2024-01-07:
I hav now used OTGetaway for few weeks with equitherm logic and it works well.

However I have floor heating and using Uponor Smatrix collector control solution which is quite smart and can predict thermal inertia etc.

When collectors are in closed state it’s does not have a point for gas heater to be on as the hot water is not flowing in the under floor heating.

So I would like to turn on gas heater only when any of the floor heating contours are in open state. I have this information in Home Assitant. For example one:
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

Idle means off and heating means on. I can group all contours together so that if any of them is on I can make automation to turn on the gas heater.

But now I need some idea for a solution to turn gas heater on/off but at same time retain the heating temp vs outside temp logic. So basically use only heating curve and gas heater on/off will be controlled by automation.

martinarva, 2024-01-07:
Here are all my collectors and as you can se the need for heat is quite different
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

at the moment only living room temp is used in OTgateway.

Would be nice to switch heating on from any of the collectors instead

martinarva, 2024-01-07:
workaround for time being.

I made a template sensor that will show state "heating" if any of the collectors are heating and "idle" if none. Also added "error" state if collectors are for some reason unavailable.
`  - platform: template
    sensors:
      overall_hvac_action:
        friendly_name: "Collectors Overall HVAC Action"
        value_template: >
          {% set error_states = ['unknown', 'unavailable'] %}
          {% if is_state('sensor.alumine_korrus_hvac_action', 'heating')
             or is_state('sensor.saun_hvac_action', 'heating')
             or is_state('sensor.garaaz_hvac_action', 'heating')
             or is_state('sensor.2_korruse_trepihall_hvac_action', 'heating')
             or is_state('sensor.vannituba_hvac_action', 'heating')
             or is_state('sensor.magamituba_hvac_action', 'heating')
             or is_state('sensor.marloni_tuba_hvac_action', 'heating')
             or is_state('sensor.mathiase_tuba_hvac_action', 'heating') %}
            heating
          {% elif is_state('sensor.alumine_korrus_hvac_action', error_states)
             or is_state('sensor.saun_hvac_action', error_states)
             or is_state('sensor.garaaz_hvac_action', error_states)
             or is_state('sensor.2_korruse_trepihall_hvac_action', error_states)
             or is_state('sensor.vannituba_hvac_action', error_states)
             or is_state('sensor.magamituba_hvac_action', error_states)
             or is_state('sensor.marloni_tuba_hvac_action', error_states)
             or is_state('sensor.mathiase_tuba_hvac_action', error_states) %}
            error
          {% else %}
            idle
          {% endif %}`

When collectors are heating i raise the climate.opentherm_heating to 25 degrees, so it's quite sure heating kicks in. When idle, I lower climate.opentherm_heating to 20 degrees, so its quite sure heating will stop. When error i put it to 22 degrees so that normal heating will continue. Also added a trigger for home assistant restart to check what to do.

`alias: Gas Heater Collectors Automation
description: Turn on/off gas heater from collectors states
trigger:
  - platform: state
    entity_id:
      - sensor.overall_hvac_action
    to: heating
    id: heating
  - platform: state
    entity_id:
      - sensor.overall_hvac_action
    to: idle
    id: idle
  - platform: state
    entity_id:
      - sensor.overall_hvac_action
    to: error
    id: error
  - platform: homeassistant
    event: start
    id: restart
condition: []
action:
  - choose:
      - conditions:
          - condition: trigger
            id:
              - heating
        sequence:
          - service: climate.set_temperature
            metadata: {}
            data:
              temperature: 24
            target:
              entity_id: climate.opentherm_heating
      - conditions:
          - condition: trigger
            id:
              - idle
        sequence:
          - service: climate.set_temperature
            metadata: {}
            data:
              temperature: 21
            target:
              entity_id: climate.opentherm_heating
      - conditions:
          - condition: trigger
            id:
              - error
        sequence:
          - service: climate.set_temperature
            metadata: {}
            data:
              temperature: 22
            target:
              entity_id: climate.opentherm_heating
          - service: notify.mobile_app_iphone
            metadata: {}
            data:
              title: HVAC
              message: Collectors Error, switching Gas Heater to 22c
      - conditions:
          - condition: trigger
            id:
              - restart
        sequence:
          - choose:
              - conditions:
                  - condition: state
                    entity_id: sensor.overall_hvac_action
                    state: heating
                sequence:
                  - service: climate.set_temperature
                    metadata: {}
                    data:
                      temperature: 25
                    target:
                      entity_id: climate.opentherm_heating
              - conditions:
                  - condition: state
                    entity_id: sensor.overall_hvac_action
                    state: idle
                sequence:
                  - service: climate.set_temperature
                    metadata: {}
                    data:
                      temperature: 19.8
                    target:
                      entity_id: climate.opentherm_heating
              - conditions:
                  - condition: state
                    entity_id: sensor.overall_hvac_action
                    state: error
                sequence:
                  - service: climate.set_temperature
                    metadata: {}
                    data:
                      temperature: 22
                    target:
                      entity_id: climate.opentherm_heating
                  - service: notify.mobile_app_iphone
                    metadata: {}
                    data:
                      title: HVAC
                      message: Collectors Error, switching Gas Heater to 22c
mode: single
`

This should cover my needs for now. I also changed Equitherm factors to quite minimum (k=0.1, t=0.1), as my collectors will handle the on/off and heatcurve N to 0.2 which shoul be enough looking at the heat curve. If needed i will raise it.

Laxilef, 2024-01-23:
Try this:
1. Send the temperature inside the house to the controller from this sensor:
```yaml
- platform: min_max
  name: min_temperature_rooms
  unique_id: min_temperature_rooms
  type: min
  entity_ids:
    - sensor.room1
    - sensor.room2
    - sensor.room3
    - sensor.room4
    - sensor.room5
    - sensor.room6
```
2. Send to the controller the value of this sensor as the desired temperature:
```yaml
- platform: min_max
  name: max_desired_temperature_rooms
  unique_id: max_desired_temperature_rooms
  type: max
  entity_ids:
    - sensor.room1_setpoint
    - sensor.room2_setpoint
    - sensor.room3_setpoint
    - sensor.room4_setpoint
    - sensor.room5_setpoint
    - sensor.room6_setpoint
```

Of course, the code needs to be modified to suit your config. But I think the algorithm is clear. In this algorithm, you should not use very cold rooms such as a garage.

Closed 2024-02-13.

Thread 30 (2024-01-12):

Wifi Watchdog

blitzu, 2024-01-12:
Hello, is possible to implement an watchdog for wifi or maybe for mqtt connection? If it cant't connect to mqtt for some time the board should reboot.

Laxilef, 2024-01-12:
Hi. What for? The board will connect automatically when possible.
In addition, this will disrupt the emergency mode.

blitzu, 2024-01-13:
Because is second time when my device get offline. It doesn't connect back even if restarted my wifi router. The signal is high. The device reconnected after power cycle

Laxilef, 2024-01-13:
Version 1.3.3?

blitzu, 2024-01-13:
V 1.4.0-rc 5

Laxilef, 2024-01-13:
Can you test this on version 1.4.0-rc.9?

aurelmarius, 2024-01-13:
> Can you test this on version 1.4.0-rc.9?

Compiled 1.4.0-rc.9, can't connect to wifi hotspot anymore. I had to manually reflash esp with older version.
![Uploading Screenshot 2024-01-13 at 10.51.50.png…]()

Laxilef, 2024-01-13:
Oh, I forgot to say that starting from version rc9 it is necessary to flash the file system via platformio.

aurelmarius, 2024-01-13:
> Oh, I forgot to say that starting from version rc9 it is necessary to flash the file system via platformio.

There is separate file for fs or flash just bin via platformio ?

Laxilef, 2024-01-13:
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

aurelmarius, 2024-01-14:
> 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
>
>

Future versions after 1.4.0-rc.9 will support ota ?

Laxilef, 2024-01-14:
Yes. There is already an "Upgrade" page there.

aurelmarius, 2024-01-15:
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
Up and running. Thanks for the info.

aurelmarius, 2024-01-15:
After 4 hours it became unavailable and boiler reported F95 error (no ot connection). Running on d1_mini. Moved back to rc5 for now. I also noticed i get random reboots with rc5 but not hang ups.
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

aurelmarius, 2024-01-16:
> Can you save the logs on the latest version and upload them here? I'm interested in what happens at the moment of freezing and after.

Sure, but i don’t know how to get the logs.

Laxilef, 2024-01-16:
You need to connect the ESP to your computer via USB, connect to the port using a serial client and configure recording to a file.
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

Laxilef, 2024-01-16:
I also noticed that some users have similar problems when using DHCP. Can you try using a static ip for your esp?

Closed 2024-02-06.

Thread 31 (2024-01-16):

Intergrating TRV's

nekocentral, 2024-01-16:
At the moment i'm looking at replacing my Tado thermostat with the OTGateway mainly as i want to be able to intergrate heating a bit more with zigbee TRV's, do you have some idea's on how to do this or i can just make a heating call using home assistant but ignore the temp sensor?

Laxilef, 2024-01-17:
Zigbee trv are not good regulators as they rely on a temperature sensor that is installed in them. The temperature near radiators will always be higher than in the rest of the room.
To delicately regulate the temperature in the rooms, I use thermal heads installed on the collector group. These thermal heads are connected to relays, and the relays are controlled by the ``generic_thermostat`` component in the home assistant.
In this config, thermal heads and OTGateway are not connected to each other. OTGateway still controls the temperature in the house, but the thermal heads allow you to slightly reduce or increase the temperature in individual rooms.

nekocentral, 2024-01-17:
Interesting
I was thinking of using 2 sensors per room the trv and a secondary sensor on the other side. And maybe make it so I can use the average of them to trigger heating on or off. Or even set a temperature offset calculated of the second one.

Laxilef, 2024-01-17:
You have to try. But I was unable to get any of the zigbee trvs available on Aliexpress to work properly.

nekocentral, 2024-01-17:
> You have to try. But I was unable to get any of the zigbee trv available on Aliexpress to work properly.

I'm going to try the sonoff trv's just need to see if I can tell my radiator to just keep pumping heat untill I say stop

Laxilef, 2024-01-17:
Despite the convenience of using zigbee trv, I would recommend using electric thermal heads with relays.
I used zigbee trv in my apartment for about 2 years, but they did not maintain the normally set temperature and I had to change the batteries 2 times during the winter. If there are only 2-3 radiators in the house, then this is probably acceptable, but when there are 10 or more, it’s tiring :)

nekocentral, 2024-01-17:
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

I need to check if I can even properly do that due to the design of the heating in my house,
All rooms atm have a radiator with a complete dumb valve and I can't sadly run power to all of them across multiple floors.

Laxilef, 2024-01-17:
Hmm. Do you have a collector group installed?
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

nekocentral, 2024-01-18:
> Hmm. Do you have a collector group installed?
> 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
>

Not exactly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

This is how the lines from my boiler leave
One is to all radiators, other one return
And the only lvl of controll per room I have is this
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

Laxilef, 2024-01-18:
In this case, it makes sense to try zigbee trv. But you shouldn’t expect precise regulation from them :)
p.s. It seems you have taps installed, not valves. They may not fit the thermal heads.

Closed 2024-02-07.

Thread 32 (2024-01-17):

CPL file for PCB order

tkolik, 2024-01-17:
Hello.

Can I ask for CPL file to share? I was not able to find it unfortunately. It is not possible to order PCB assembly without this file.

Thanks in advance for sharing.

Laxilef, 2024-01-17:
Hi,
Uploaded to ``assets`` folder.
Pay great attention to the selection of components. Some of them can be replaced by cheaper ones of a suitable form factor.

Thread 33 (2024-01-18):

Можно ли использовать как замену термостату?

DeadlySin2, 2024-01-18:
В данный момент на котле Baxi Luna-3 Comfort стоит панель (штатная на котле) и HomeAssistant через умную розетку и реле с сухим контактом управляет термостатом в котле.
Логика простая - если никакая батарея не греет в текущий момент - терморегулятор выключается, если какая-либо включена - терморегулятор включается.
Есть несколько вопросов:
1. Возможно ли управлять термостатом оборудованием с данной прошивкой?
2. Если поставить OTGGateway будет ли работать штатная панель или ее необходимо будет отключить?
3. Будет ли работать OTGGateway совместно с терморегулятором (как сейчас, только информация по работе котла будет в НА)

DeadlySin2, 2024-01-19:
У меня по другому не получится. В разьем на котле вставлен штекер в который подключена панель. Тут или параллельно подключать блок или отключать панель и подключать блок.
Я думаю отключить панель, чтобы что-нибудь не случилось...

Laxilef, 2024-01-19:
На сайте зонта есть [схема подключения](https://www.tvp-electro.ru/wp-content/uploads/2023/05/baxi-luna-3-tsifrovoe-podklyuchenie-smart-i-smart-2.0-dineco-1.jpg) вашего котла. Тут она тоже применима.

DeadlySin2, 2024-01-19:
Спасибо. Читал, у меня немного по другому но разберусь. Прибор заказал буду экспериментировать. Спасибо еще раз

alexkoh1, 2024-01-22:
А будет ли возможность управлять котлом прямо из веб интерфейса прошивки, без ha? :) Задать целевые значения, посмотреть статус.

alexkoh1, 2024-01-22:
> Если у вас есть возможность, можете создать отдельную страницу dashboard с необходимыми полями для настройки всех значений и открыть PR. Все параметры, которые можно менять через mqtt, можно менять и через http api.

А можете примерно подсказать в какую сторону ковырять? :) Возможно справлюсь!

Laxilef, 2024-01-22:
В data лежат html файлы страниц, в src_data/app.js есть готовые функции загрузки данных и функции сохранения форм, в PortalTask.h handler'ы страниц.

Closed 2024-02-11.

Thread 34 (2024-01-26):

Opentherm gateway Homeassistant parametars

DeadlySin2, 2024-01-26:
It is not a bug, but i can't understant some parametrs in HomeAssistant:

1. Emergency target tempetature - as i anderstand it is a temperature when the boilel starts heating if the Use Emergency slider is on?
Like Frost Protection mode in Baxi???
2. Turning slader - What this function is suppose to do?
3. Turning regulator - What this function is suppose to do?
4. Use equitherm in emergency - What this function is suppose to do?

Laxilef, 2024-01-27:
> Emergency mode. If the Wi-Fi connection is lost or the gateway cannot connect to the MQTT server, the mode will turn on. This mode will automatically maintain the set temperature and prevent your home from freezing. In this mode it is also possible to use equithermal curves (weather-compensated control).

Closed 2024-02-16.

Thread 35 (2024-01-30):

Invalid values for number.opentherm_pid_p and number.opentherm_pid_d

Pajuris, 2024-01-30:
Logger: homeassistant.components.mqtt.number
Source: components/mqtt/number.py:194
Integration: MQTT ([documentation](https://www.home-assistant.io/integrations/mqtt), [issues](https://github.com/home-assistant/core/issues?q=is%3Aissue+is%3Aopen+label%3A%22integration%3A+mqtt%22))
First occurred: 07:38:02 (382 occurrences)
Last logged: 10:07:49

    Invalid value for number.opentherm_pid_p: 50.0 (range 0.001 - 10.0)
    Invalid value for number.opentherm_pid_d: 10000.0 (range 0.0 - 10.0)

Device: https://diyless.com/product/opentherm-thermostat
Firmware: firmware_nodemcu_32s_1.4.0-rc.5
Boiler Wiessmann Vitodens 100-W B1KC 26 kW

I use 1.4.0 firmware because 1.3.3 firmware does not have Summer/winter mode, Heating CH1 to CH2 and Modulation sync with heating options. Without these options my boiler does not respond to setting the heating temperature.

Laxilef, 2024-01-30:
This has been fixed in the latest RC. Build the firmware [from sources](https://github.com/Laxilef/OTGateway/wiki#build-firmware).

Pajuris, 2024-01-30:
Buid, install... but something is wrong. Can not connect to OpenTherm Gateway with password otgateway123456.

Laxilef, 2024-01-30:
Why? Did you flash the filesystem?

Pajuris, 2024-01-30:
I dont know why :) Yes, I flashed system with the new firmware and after reboot device lost connection to my wifi and appears wifi name: OpenTherm Gateway.  And I can not connect to OpenTherm Gateway with password otgateway123456. (WIndows or Mac show, the password is wrong).

Laxilef, 2024-01-30:
In addition to the firmware, you need to flash the file system. Has it been done?

Pajuris, 2024-01-30:
Ups... no... sorry... :)

Pajuris, 2024-01-30:
file system image is littlefs.bin?
Error: Detected overlap at address: 0x37 for file .... /littlefs.bin

Pajuris, 2024-01-30:
Flashed file system image via PlatformIO.
Blogadariu za pomasc, Laxilef. :)

DeadlySin2, 2024-01-31:
Can confirm this issue. The only way to flash the filesystem file is to use PlatformIO, anothe flashers send an error message

Laxilef, 2024-02-01:
documentation fixed.

Thread 36 (2024-01-31):

navien NCB700 конденсатный

PavelTelnov, 2024-01-31:
Спасибо за проделанную работу.
Собрал плату, прошил, подключил к котлу, подключил к HA. Наблюдаю работу в Grafana.
 Данные которые получаю с котла в приложении.
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
Котел регулирует температуру по обратке.
Панель Opentherm Gateway Heating - при изменении настроек температуры, на дисплее котла ничего  не меняется.
Панель Opentherm Gateway DHW - при изменении настроек температуры, на дисплее котла ничего  не меняется.
Так и должно быть?
Задача: управлять температурой горячей воды через HA. Стоит планшет в ванной, для себя хочу налить погорячее, для детей похолоднее. Не хочется бегать в котельную.
Вопрос 2: отображение температуры обратки можно реализовать?

Laxilef, 2024-02-01:
> Так и должно быть?

Скорее всего да. Если температура ГВС и отопления меняется согласно установленным в HA. При подключении термостатов по opentherm через панель, как правило, нельзя менять температуру, только зайти в сервисный режим.

> Вопрос 2: отображение температуры обратки можно реализовать?

Еще не встречал, чтобы хоть один котел эту температуру возвращал по OT. Поэтому еще на первых версиях удалил этот параметр для опроса.

Closed 2024-01-31.

Thread 37 (2024-02-03):

'L/min' is not a valid unit for the device class ('volume')

Pajuris, 2024-02-03:
In every start, HA reporting there two warnings:

Firmware compiled few days ago.

Logger: homeassistant.components.sensor
Source: components/sensor/init.py:551
Integration: Jutiklis ([documentation](https://www.home-assistant.io/integrations/sensor), [issues](https://github.com/home-assistant/core/issues?q=is%3Aissue+is%3Aopen+label%3A%22integration%3A+sensor%22))
First occurred: 17:38:04 (1 occurrences)
Last logged: 17:38:04
Entity sensor.opentherm_dhw_flow_rate (<class 'homeassistant.components.mqtt.sensor.MqttSensor'>) is using state class 'measurement' which is impossible considering device class ('volume') it is using; expected None or one of 'total', 'total_increasing'; Please update your configuration if your entity is manually configured, otherwise create a bug report at https://github.com/home-assistant/core/issues?q=is%3Aopen+is%3Aissue+label%3A%22integration%3A+mqtt%22

and

Logger: homeassistant.components.sensor
Source: components/sensor/init.py:714
Integration: Jutiklis (documentation, issues)
First occurred: 17:38:04 (1 occurrences)
Last logged: 17:38:04

Entity sensor.opentherm_dhw_flow_rate (<class 'homeassistant.components.mqtt.sensor.MqttSensor'>) is using native unit of measurement 'L/min' which is not a valid unit for the device class ('volume') it is using; expected one of ['gal', 'mL', 'fl. oz.', 'm³', 'L', 'ft³', 'CCF']; Please update your configuration if your entity is manually configured, otherwise create a bug report at https://github.com/home-assistant/core/issues?q=is%3Aopen+is%3Aissue+label%3A%22integration%3A+mqtt%22

Closed 2024-02-04.

Thread 38 (2024-02-04):

delfis ctfs 24" nova florida no heating control

andrey150960, 2024-02-04:
Приветствую. Мой котел "delfis ctfs 24" nova florida,  фирмы "findital". Плата esp32 прошивка 1.4.0-rc.12 PlatformIO.
При подключении почти все параметры получаю. Управление ГВС работает, а управление отоплением нет. Т.е. не работает термостат. Пробовал играться с настройками, как рекомендовано https://github.com/Laxilef/OTGateway/wiki/FAQ-&-Troubleshooting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. Ни каких результатов
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
При подключении к котлу ESP32, на самом котле регулировка ГВС не регулируется , а температура в помещении поддается регулированию в ручную.
Что можете посоветовать  для исправления

Laxilef, 2024-02-04:
1. Если отключить PID и Equitherm и попробовать установить температуру 50 градусов, например, котёл как-то реагирует?
2. Запишите логи через telnet или serial порт.

andrey150960, 2024-02-04:
Нет ни какой реакции, живет своей жизнью.
Вот чего получаю, с отключенными PID и Equitherm и вкл. Equitherm
[00:10:08][OT][HEATING][WARN] Failed set max modulation 100%
[00:10:11][OT][HEATING][INFO] Set temp = 35
[00:10:24][OT][DHW][INFO] Set temp = 41
[00:10:25][OT][DHW][WARN] Failed set ch2 temp
[00:11:10][REGULATOR][INFO] New target: 50.00
[00:11:10][OT][HEATING][INFO] Set temp = 50
[00:11:12][OT][HEATING][WARN] Failed set max modulation 100%
[00:11:26][OT][DHW][INFO] Set temp = 41
[00:11:27][OT][DHW][WARN] Failed set ch2 temp
[00:12:06][SETTINGS][INFO] Updated
[00:12:12][OT][HEATING][INFO] Set temp = 50
[00:12:14][OT][HEATING][WARN] Failed set max modulation 100%
[00:12:27][OT][DHW][INFO] Set temp = 41
[00:12:28][OT][DHW][WARN] Failed set ch2 temp
[00:13:13][OT][HEATING][INFO] Set temp = 50
[00:13:17][OT][HEATING][WARN] Failed set max modulation 100%
[00:13:28][OT][DHW][INFO] Set temp = 41
[00:13:29][OT][DHW][WARN] Failed set ch2 temp
[00:14:14][OT][HEATING][INFO] Set temp = 50
[00:14:20][OT][HEATING][WARN] Failed set max modulation 100%
[00:14:29][OT][DHW][INFO] Set temp = 41
[00:14:30][OT][DHW][WARN] Failed set ch2 temp
[00:15:00][REGULATOR][INFO] New target: 22.00
[00:15:00][OT][HEATING][INFO] Set temp = 39
[00:15:01][OT][HEATING][INFO] Disabled
[00:15:01][OT][HEATING][WARN] Failed set max modulation 100%
[00:15:32][OT][DHW][INFO] Set temp = 41
[00:15:32][OT][DHW][WARN] Failed set ch2 temp

Laxilef, 2024-02-05:
Судя по логам, CH2 у вас там либо не используется, либо котел запрещает установку. А вот температура отопления устанавливается нормально. Странно, что котёл не реагирует.
Стоит попробовать перебрать Master Member ID от 1 до 255, возможно в прошивке залочено управление отоплением только под определенные термостаты. Из флагов можно оставить только DHW present.

andrey150960, 2024-02-05:
Спасибо попробую перебирать ID. Прикладываю telnet c различными режимами.
Странно при включении PID показывает  [HEATING][INFO] Set temp = 78, а при вкл.  Equitherm эти показания не вижу.
Пробовал прошить ESP8266 [1.4.0-rc.13] не шьется, а [v1.3.3] на ура.
[новый 1.txt](https://github.com/Laxilef/OTGateway/files/14160748/1.txt)

andrey150960, 2024-02-05:
Вроде разобрался , заработало. По наблюдаю несколько дней , отпишусь.

Laxilef, 2024-02-05:
> Вроде разобрался , заработало.

Вы хоть напишите что сделали и что помогло.

> Подскажите как вытащить параметр "Modulation:" на панель Home Assistant , т.е. каким запросом в MQTT

Объект с уровнем модуляции и так существует, посмотрите карточку устройства в HA.

andrey150960, 2024-02-05:
Как говорят " Ларчик открывался просто. Включаем котел , заходим в режим программирования. Нажатием одновременно
"Reset" и "минус отопления", устанавливаем P17-TSP17 в режим "1" (термостат/или ПДУ). Выходим из программирования. Выключаем котел. Отключаем на плате котла перемычку между  "1" и "2". Подключаем  "open therm" к контактам "3" и "4".
Подаем питание на "open therm" и после этого включаем котел (это важно). На экране котла появляется надпись " Con".
Все, котел управляется "open therm".

> Объект с уровнем модуляции и так существует, посмотрите карточку устройства в HA.

не увидел
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

andrey150960, 2024-02-06:
> > Еще бы насос отключался и была бы "песня"
>
> При использовании Equitherm и/или PID и гистерезиса контроллер отключает отопление при достижении заданной комнатной температуры по opentherm (но в HA это не видно). При отключении отопления котел должен отключить насос, но это работает не со всеми котлами.

Да спасибо, Котел работает с отключением насоса, просто нужно было  подождать пока выйдет на режим. Пока настраивал t упала до 19 градусов, а нужно 23.

Closed 2024-02-05.

Thread 39 (2024-02-05):

sensor.opentherm_dhw_flow_rate unavailable

Pajuris, 2024-02-05:
Newest firmware: 1.4.0-rc.13

Logger: homeassistant.components.mqtt.mixins
Source: components/mqtt/mixins.py:324
Integration: MQTT (documentation, issues)
First occurred: 16:06:20 (4 occurrences)
Last logged: 16:10:24

Error 'expected SensorDeviceClass or one of 'date', 'enum', 'timestamp', 'apparent_power', 'aqi', 'atmospheric_pressure', 'battery', 'carbon_monoxide', 'carbon_dioxide', 'current', 'data_rate', 'data_size', 'distance', 'duration', 'energy', 'energy_storage', 'frequency', 'gas', 'humidity', 'illuminance', 'irradiance', 'moisture', 'monetary', 'nitrogen_dioxide', 'nitrogen_monoxide', 'nitrous_oxide', 'ozone', 'ph', 'pm1', 'pm10', 'pm25', 'power_factor', 'power', 'precipitation', 'precipitation_intensity', 'pressure', 'reactive_power', 'signal_strength', 'sound_pressure', 'speed', 'sulphur_dioxide', 'temperature', 'volatile_organic_compounds', 'volatile_organic_compounds_parts', 'voltage', 'volume', 'volume_storage', 'water', 'weight', 'wind_speed' for dictionary value @ data['device_class']' when processing MQTT discovery message topic: 'homeassistant/sensor/opentherm/dhw_flow_rate/config', message: '{'availability': {'topic': 'opentherm/status'}, 'enabled_by_default': False, 'unique_id': 'opentherm_dhw_flow_rate', 'object_id': 'opentherm_dhw_flow_rate', 'entity_category': 'diagnostic', 'device_class': 'volume_flow_rate', 'state_class': 'measurement', 'unit_of_measurement': 'L/min', 'name': 'DHW flow rate', 'icon': 'mdi:water-pump', 'state_topic': 'opentherm/state', 'value_template': '{{ value_json.sensors.dhwFlowRate|float(0)|round(2) }}', 'expire_after': 120, 'device': {'identifiers': ['opentherm'], 'sw_version': '1.4.0-rc.13', 'model': 'OpenTherm Gateway', 'name': 'OpenTherm Gateway', 'configuration_url': 'http://xxx.xxx.x.xxx/'}, 'platform': 'mqtt'}'

Laxilef, 2024-02-05:
On which version of Home Assistant does this occur?

Pajuris, 2024-02-05:
Latest...  core 2024.1.6

Laxilef, 2024-02-05:
This will [start working](https://github.com/home-assistant/core/commit/cece117c93c35ecdf0f7c1624cb6db6d445b57a1) with release 2024.2

Pajuris, 2024-02-07:
Thank's. Now working...

Closed 2024-02-07.

Thread 40 (2024-02-07):

Permanent connection to the BLE sensor, fast discharge

Laxilef, 2024-02-07:
Hi @mennodegraaf!
I received information from users that in the current implementation, the connection to BLE sensors is permanent. Because of this, the device's battery quickly drains.

Users have provided an example [implementation in OpenMQTTGateway](https://github.com/1technophile/OpenMQTTGateway/blob/development/main/ZgatewayBLEConnect.ino), which seems to use a slightly different method for polling sensors. Do you think it is possible to port this implementation?

mennodegraaf, 2024-02-08:
Not sure yet, how different the implementation is, but I can have a look.

Laxilef, 2024-02-10:
If I understand correctly, OpenMQTTGateway uses a subscription to events (messages) from BLE sensors, rather than connecting and reading the value. Are you using a BLE sensor currently? How's it going with the battery drain?

Laxilef, 2024-02-20:
Implemented in rc15. Closed.

Closed 2024-02-20.

Thread 41 (2024-02-08):

Can't get the correct values   for the Heating temp and setpoint

vespadrift, 2024-02-08:
Good evening everyone,
I can't get the correct values   for the Heating temperature and setpoint. I try to change the Master MemberID code without result...
I have a Radiant r2k and i use the esp8266 with the OpenTherm Adapter by https://github.com/ihormelnyk
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

And on home assistant I can't adjust the temperature under 30°...but the value can be set between 30 and 80°
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
Any solution? thanks

Laxilef, 2024-02-08:
If you are not using PID or equitherm mode, then everything is correct. In your case, you can set the temperature from 30 to 80 degrees.

vespadrift, 2024-02-08:
Thank you so much! It works!

Closed 2024-02-08.

Thread 42 (2024-02-08):

Request: exhaust temperature

Pajuris, 2024-02-08:
My  gas boiler: Viessmann Vitodens W-100 B1KC 26 kW has exhaust temperature sensor. Would be great to see this information in opentherm gateway...

Laxilef, 2024-02-10:
Where can this be useful? I didn't add this sensor because I don't see where it can be used.

Pajuris, 2024-02-10:
It's important for gas consumption. If exhaust temperature is high (50-55 C or more), condensing gas boiler not working in condensing mode.

Laxilef, 2024-03-29:
Hi @Pajuris
Pls test it

Pajuris, 2024-03-30:
Hello
Installed 1.4.0-rc.18m but no new sensors appears... I must compile manually?

Laxilef, 2024-03-30:
Yes, you need to compile from source.

> And... my previos version was 1.4.0-rc.14. So it worked much better. RC.18 version runs much slower:
> for example modulation value appears only ~30-40 seconds after real flame turn on.
> I could see DHW flow rate 5-7 l/min and flame on, but modulation show 0% another 20-30 seconds.

Can you upload the logs?

Pajuris, 2024-03-31:
OK, compiled and installed...
OpenTherm Gateway Exhaust temperature and OpenTherm Gateway Heating return temperature appears.
OpenTherm Gateway Heating return temperature always show 0.
OpenTherm Gateway Exhaust temperature show wrong values 0.1-0.2 C
What logs do you need? From where I must take it?

Laxilef, 2024-03-31:
> OpenTherm Gateway Exhaust temperature show wrong values 0.1-0.2 C

Fixed it in the last commit. Please recompile the firmware and test it now.

> What logs do you need? From where I must take it?

Connect to ESP using telnet or serial port and save the logs.

Pajuris, 2024-03-31:
OK, Exhaust temperature seems to work corectly.
Logs attached.
[ZOC2403_Telnet Connection Example0109.log](https://github.com/Laxilef/OTGateway/files/14817249/ZOC2403_Telnet.Connection.Example0109.log)
[ZOC2403_Telnet Connection Example0107.log](https://github.com/Laxilef/OTGateway/files/14817250/ZOC2403_Telnet.Connection.Example0107.log)

Laxilef, 2024-03-31:
Thanks for the tests. Looking at the logs, the data is updated without delay. I don’t see random INVALID or TIMEOUT response statuses. Except ID 28, it is not supported by your boiler.

> for example modulation value appears only ~30-40 seconds after real flame turn on.
> I could see DHW flow rate 5-7 l/min and flame on, but modulation show 0% another 20-30 seconds.

In fact, the modulation can be 0% and this does not mean that the flame does not burn. 0% is the minimum level. It would have been more correct to make the minimum level 1%, but the manufacturers decided otherwise.

Pajuris, 2024-03-31:
When DHW turns on (mixer is full open), boiler modulation when I look on boiler display, is more than 50 % and changes. But modulation in HA show 0 % and does not changes about 30 seconds.
Anyway, I will do more tests tomorrow.

Laxilef, 2024-03-31:
Try looking at these parameters on the portal page, the data is updated there every 10 seconds

Pajuris, 2024-03-31:
On portal page modulation is 0 % too. When portal start showing modulation value, after few secons value appears and on HA.

Laxilef, 2024-03-31:
Well, I don’t know why the boiler can send data with such a delay. In the logs you can see the "raw" data of communication between the ESP and the boiler. In the response, you should be interested in the first 16 bits.

Pajuris, 2024-04-02:
OK... 1.4.0-rc.14 version modulation value appears with delay too. It's Viessmann boiler problem.
Thanks Laxilef for new, exhaust value sensor. Good job.

Closed 2024-04-02.

Thread 43 (2024-02-09):

delay() в библиотеках DallasTemperature и OpenTherm

BCometto, 2024-02-09:
В библиотеках **DallasTemperature** и **OpenTherm** присутствуют вызовы функции **delay()**, которые подвешивают исполнение всего кода. В **DallasTemperature** функция **delay()** вызывается в **blockTillConversionComplete()** для ожидания выполнения расчетов датчиком и, в зависимости от **bitResolution**, составляет от 94 до 750 миллисекунд. В **OpenTherm** функция **delay()** вызывается в **activateBoiler()** на 1 секунду. Не знаю насколько это критично в Вашем проекте, но я при использовании библиотеки **DallasTemperature** избавлялся от этого **прописав в функции millisToWaitForConversion() нули во всех return и используя библиотеку SimpleTimer** для задания периодичности чтения данных с датчика. Хотя, можно тоже самое сделать установив **waitForConversion = false** и **checkForConversion = false** в функции **setOneWire()** и использовать таймер для считывания показаний с датчика.

Laxilef, 2024-02-10:
Здравствуйте.
В коде используется ``setWaitForConversion(false)``:
https://github.com/Laxilef/OTGateway/blob/1a031172578cdbce7b52d7b954fd1dadd11e17d8/src/SensorsTask.h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

и неблокирующее ожидание:
https://github.com/Laxilef/OTGateway/blob/1a031172578cdbce7b52d7b954fd1dadd11e17d8/src/SensorsTask.h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

В opentherm некоторые тайминги должны строго соблюдаться, поэтому целесообразно использовать блокирующее ожидание.

BCometto, 2024-02-10:
Спасибо! Замечательный проект!

Closed 2024-03-01.

Thread 45 (2024-02-09):

noob request

vespadrift, 2024-02-09:
I can't set the indoor temperature with mqtt. I paste the report_temp_to_controller.yaml in config file like this, but doesn't work:
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
thanks

blitzu, 2024-02-09:
Content of https://github.com/Laxilef/OTGateway/blob/master/assets/ha/report_temp_to_controller.yaml you have to create an automation with it

Closed 2024-02-09.

Thread 46 (2024-02-10):

DHW temperature high when the DHW is not running

vespadrift, 2024-02-10:
The DHW temperature is often high when I’m not using the hot water:
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

Thank you

Laxilef, 2024-02-10:
It's normal. Probably the DHW sensor is located somewhere near the heat exchanger.

Closed 2024-02-10.

Thread 52 (2024-02-29):

Outdoor and Indoor temp MQTT does not work properly

shaggee, 2024-02-29:
Im using 1.4.0-rc.15 and when HomeAssistant reports indoor or outdoor temp via MQTT, its always changing back to 0 after few seconds.
Outdoor and indoor settings is switched to manual.

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

Laxilef, 2024-02-29:
Pls try [rc16](https://github.com/Laxilef/OTGateway/releases/tag/1.4.0-rc.16)

shaggee, 2024-03-01:
rc16 fixed problem

Closed 2024-03-01.

Thread 53 (2024-02-29):

Losing connection with boiler

shaggee, 2024-02-29:
Im using 1.4.0-rc.15 on Wemos D1 mini with Termet Ecocondens 25 Integra II boiler. The connection works well but after couple hours, the connection with boiler is lost.

Manually restart OTGateway - no results
Manually power cycle OTGateway - no results
Manually power cycle boiler - connection established again

How can I check the connection logs? Any advice to resolve this problem?

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

Laxilef, 2024-02-29:
Connect via telnet and save logs when the problem occurs.
This may be due to the boiler settings or the wiring. What is the length of the wire? What wire is used? Are there power wires near the opentherm wire?

shaggee, 2024-03-01:
> Connect via telnet and save logs when the problem occurs. This may be due to the boiler settings or the wiring. What is the length of the wire? What wire is used? Are there power wires near the opentherm wire?

The wire is arround 30cm length. Yes the are power cables near opentherm wire. I will move the board and wires and test it again.

Laxilef, 2024-03-08:
Hi @shaggee
Did you find the problem?

shaggee, 2024-03-08:
> Hi @shaggee Did you find the problem?

What I did:
1. Shortened the cable to 15cm. The cable is a simple 2x1,5mm2 speaker cable.
2. Moved the Wemos D1 and OT adapter away from electric cables

After this upgrades, im still losing the connection

Im recording the logs since yesterday 14:00 . So far the connection is stable. Strange.

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

shaggee, 2024-03-13:
Strange. I saved the telnet logs for 4 days without any connection lose.
Today I turned off logging and tadam. After 10 hours connection losed:

[00:01:22][MQTT][TRACE] Successfully publish 0 of 0 bytes to topic: opentherm/state/set
[00:01:22][MQTT][TRACE] Successfully publish 6 of 6 bytes to topic: opentherm/status
[00:01:22][OT][TRACE] ID:    0   Request:     1200   Response:        0   Attempt:  4   Status: TIMEOUT
[00:01:23][MQTT][TRACE] Successfully publish 474 of 474 bytes to topic: opentherm/state
[00:01:24][OT][TRACE] ID:    0   Request:     1200   Response:        0   Attempt:  5   Status: TIMEOUT
[00:01:24][OT][WARN] Invalid response after setBoilerStatus: TIMEOUT
[00:01:25][MAIN][VERB] Free heap size: 25056 of 81920 bytes (min: 20776, diff: 0), max free block: 22296 (min: 15016, diff: 0, frag: 11%)
[00:01:26][OT][TRACE] ID:    0   Request:     1200   Response:        0   Attempt:  1   Status: TIMEOUT
[00:01:27][OT][TRACE] ID:    0   Request:     1200   Response:        0   Attempt:  2   Status: TIMEOUT
[00:01:28][OT][TRACE] ID:    0   Request:     1200   Response:        0   Attempt:  3   Status: TIMEOUT
[00:01:29][OT][TRACE] ID:    0   Request:     1200   Response:        0   Attempt:  4   Status: TIMEOUT
[00:01:30][OT][TRACE] ID:    0   Request:     1200   Response:        0   Attempt:  5   Status: TIMEOUT
[00:01:30][OT][WARN] Invalid response after setBoilerStatus: TIMEOUT
[00:01:32][OT][TRACE] ID:    0   Request:     1200   Response:        0   Attempt:  1   Status: TIMEOUT
[00:01:33][OT][TRACE] ID:    0   Request:     1200   Response:        0   Attempt:  2   Status: TIMEOUT
[00:01:34][OT][TRACE] ID:    0   Request:     1200   Response:        0   Attempt:  3   Status: TIMEOUT
[00:01:36][OT][TRACE] ID:    0   Request:     1200   Response:        0   Attempt:  4   Status: TIMEOUT
[00:01:37][OT][TRACE] ID:    0   Request:     1200   Response:        0   Attempt:  5   Status: TIMEOUT
[00:01:37][OT][WARN] Invalid response after setBoilerStatus: TIMEOUT
[00:01:38][MQTT][TRACE] Successfully publish 6 of 6 bytes to topic: opentherm/status
[00:01:38][MQTT][TRACE] Successfully publish 474 of 474 bytes to topic: opentherm/state

Seems I need to set up the server for 24/7 telnet logging to get it 100% work.

blitzu, 2024-03-13:
Try to reflash firmware, I had the same problem

shaggee, 2024-03-13:
> Try to reflash firmware, I had the same problem

I tried. It doesnt help

Laxilef, 2024-03-14:
I think it is necessary to save the log at the moment of connection loss. Perhaps sending some request breaks the openterm on the boiler.

shaggee, 2024-03-14:
Okay give me one week to record the logs 24/7.

Closed 2024-04-11.

Thread 54 (2024-02-29):

Request: Multiple PID based Climates for multi-room purposes?

GravitySandwichh, 2024-02-29:
I currently heat all my rooms seperately with often different set temps. Having a single climate entity would cause OpenTherm to sometimes throw my heater at 100% because the living room temperature is low, but the room i'm actually heating is only 0.5c off from where it needs to be. Having multiple climates that check each room individually together with their assigned temperature sensors would solve this issue. Is this something that could be implemented? So far i have not seen a single solution that makes it possible.

blitzu, 2024-02-29:
I have trv in every room. I made an node red script that checks every climate if it needs heat. If multiple climate need heat I find the lowest current temperature and the highest set point and send that values to opentherm as setpoint and interior temperature. If none of my climate need heat I send 15 degree as setpoint and 30 degree as current temperature.

Laxilef, 2024-02-29:
Yes, this is the solution. But instead of setting temperatures, you can simply turn off the climate entity.

GravitySandwichh, 2024-03-02:
> I have trv in every room. I made an node red script that checks every climate if it needs heat. If multiple climate need heat I find the lowest current temperature and the highest set point and send that values to opentherm as setpoint and interior temperature. If none of my climate need heat I send 15 degree as setpoint and 30 degree as current temperature.

Any possibility to share this node-red flow?

blitzu, 2024-03-02:
> > I have trv in every room. I made an node red script that checks every climate if it needs heat. If multiple climate need heat I find the lowest current temperature and the highest set point and send that values to opentherm as setpoint and interior temperature. If none of my climate need heat I send 15 degree as setpoint and 30 degree as current temperature.
>
> Any possibility to share this node-red flow?

[
    {
        "id": "ea96edc559a48086",
        "type": "tab",
        "label": "Incalzire",
        "disabled": false,
        "info": "",
        "env": []
    },
    {
        "id": "924bf21a0fc0a186",
        "type": "function",
        "z": "ea96edc559a48086",
        "name": "Gaseste temperatura interioara",
        "func": "// Obține datele de stare ale entităților \"climate\"\nvar climateEntities = msg.payload.filter(entity => entity.entity_id.startsWith('climate.'));\n\n// Inițializare variabile pentru a ține evidența celei mai mari diferențe\nvar maxDifference = -Infinity;\nvar entityWithMaxDifference = null;\n\n// Iterează prin entitățile \"climate\"\nclimateEntities.forEach(entity => {\n    // Calculează diferența dintre temperature și current_temperature\n    var temperature = parseFloat(entity.attributes.temperature);\n    var currentTemperature = parseFloat(entity.attributes.current_temperature);\n    var difference = Math.abs(temperature - currentTemperature);\n\n    // Actualizează valoarea maximă și entitatea corespunzătoare\n    if (difference > maxDifference) {\n        maxDifference = difference;\n        entityWithMaxDifference = entity;\n    }\n});\n\n// Verifică dacă a fost găsită o entitate cu diferența maximă\n\n    // Verifică dacă a fost găsită o entitate cu diferența maximă\n    if (entityWithMaxDifference) {\n         // Trimite current_temperature la entitatea number.opentherm_indoor_temp\n        msg.payload = parseFloat(entityWithMaxDifference.attributes.current_temperature);\n       \n        // Setează serviciul pentru Home Assistant\n        msg.service = \"number.set_value\";\n    } else {\n        // Dacă nu s-a găsit nicio entitate, setează un mesaj de eroare\n        msg.payload = 30;\n\n        // Restul codului care nu necesită delay\n        // ...\n    }\n\n    return msg;\n // 5000 milisecunde = 5 secunde",
        "outputs": 1,
        "timeout": 0,
        "noerr": 0,
        "initialize": "",
        "finalize": "",
        "libs": [],
        "x": 210,
        "y": 240,
        "wires": [
            [
                "10d7d4b3cd2a2c1a"
            ]
        ]
    },
    {
        "id": "7f67b377f2a74528",
        "type": "cronplus",
        "z": "ea96edc559a48086",
        "name": "Cronometru",
        "outputField": "payload",
        "timeZone": "",
        "storeName": "",
        "commandResponseMsgOutput": "output1",
        "defaultLocation": "",
        "defaultLocationType": "fixed",
        "outputs": 1,
        "options": [
            {
                "name": "schedule1",
                "topic": "topic1",
                "payloadType": "default",
                "payload": "",
                "expressionType": "cron",
                "expression": "*/10 * * * * * *",
                "location": "",
                "offset": "0",
                "solarType": "all",
                "solarEvents": "sunrise,sunset"
            }
        ],
        "x": 150,
        "y": 40,
        "wires": [
            [
                "0a1f393bc0ecc888"
            ]
        ]
    },
    {
        "id": "1e80635bfed65ad0",
        "type": "function",
        "z": "ea96edc559a48086",
        "name": "Gaseste temperatura maxim ceruta",
        "func": "// Funcție pentru a găsi valoarea cea mai mare de la temperature\nfunction findMaxTemperature(entities) {\n    // Inițializare variabilă pentru a ține evidența celei mai mari valori\n    var maxTemperature = -Infinity;\n\n    // Iterează prin entități\n    entities.forEach(entity => {\n        if (!isNaN(parseFloat(entity.attributes.temperature))) {\n            var temperature = parseFloat(entity.attributes.temperature);\n\n            // Actualizează valoarea maximă\n            maxTemperature = Math.max(maxTemperature, temperature);\n        }\n    });\n\n    // Returnează valoarea maximă\n    return maxTemperature;\n}\n\n// Obține datele de stare ale entităților \"climate\"\nvar climateEntities = msg.payload.filter(entity => entity.entity_id.startsWith('climate.'));\n\n// Folosește funcția pentru a găsi valoarea cea mai mare\nvar maxTemperatureValue = findMaxTemperature(climateEntities);\n\n// Afișează valoarea cea mai mare în debug (poate fi eliminată în producție)\n\n\n// Restul codului pentru a trimite current_temperature la entitatea number.opentherm_indoor_temp\n// și a seta serviciul pentru Home Assistant, dacă este cazul.\n// ...\n\n// Pregătește mesajul cu rezultatul\n\nif (maxTemperatureValue!= -Infinity) {\n    // Trimite current_temperature la entitatea number.opentherm_indoor_temp\n    msg.payload = maxTemperatureValue;\n    \n    // Setează serviciul pentru Home Assistant\n    \n} else {\n    // Dacă nu s-a găsit nicio entitate, setează un mesaj de eroare\n    msg.payload = '15';\n}\nreturn msg;\n",
        "outputs": 1,
        "timeout": 0,
        "noerr": 0,
        "initialize": "",
        "finalize": "",
        "libs": [],
        "x": 700,
        "y": 260,
        "wires": [
            [
                "f1aa5cf0b1813fd0"
            ]
        ]
    },
    {
        "id": "138e093077965fa9",
        "type": "debug",
        "z": "ea96edc559a48086",
        "name": "debug 1",
        "active": true,
        "tosidebar": true,
        "console": false,
        "tostatus": false,
        "complete": "false",
        "statusVal": "",
        "statusType": "auto",
        "x": 460,
        "y": 640,
        "wires": []
    },
    {
        "id": "10d7d4b3cd2a2c1a",
        "type": "api-call-service",
        "z": "ea96edc559a48086",
        "name": "Seteaza temperatura interioara in Opentherm",
        "server": "d01d6bb5.176d08",
        "version": 5,
        "debugenabled": false,
        "domain": "number",
        "service": "set_value",
        "areaId": [],
        "deviceId": [],
        "entityId": [
            "number.opentherm_indoor_temp"
        ],
        "data": "{\"value\":\"{{payload}}\"}",
        "dataType": "json",
        "mergeContext": "",
        "mustacheAltTags": false,
        "outputProperties": [
            {
                "property": "payload",
                "propertyType": "msg",
                "value": "",
                "valueType": "data"
            }
        ],
        "queue": "none",
        "x": 270,
        "y": 540,
        "wires": [
            [
                "138e093077965fa9"
            ]
        ]
    },
    {
        "id": "f1aa5cf0b1813fd0",
        "type": "api-call-service",
        "z": "ea96edc559a48086",
        "name": "Seteaza temperatura tinta OT",
        "server": "d01d6bb5.176d08",
        "version": 5,
        "debugenabled": false,
        "domain": "climate",
        "service": "set_temperature",
        "areaId": [],
        "deviceId": [],
        "entityId": [
            "climate.opentherm_heating"
        ],
        "data": "{\"temperature\":\"{{payload}}\"}",
        "dataType": "json",
        "mergeContext": "",
        "mustacheAltTags": false,
        "outputProperties": [],
        "queue": "none",
        "x": 650,
        "y": 480,
        "wires": [
            [
                "138e093077965fa9"
            ]
        ]
    },
    {
        "id": "0a1f393bc0ecc888",
        "type": "ha-get-entities",
        "z": "ea96edc559a48086",
        "name": "Citeste starea entitatilor",
        "server": "d01d6bb5.176d08",
        "version": 1,
        "rules": [
            {
                "property": "entity_id",
                "logic": "includes",
                "value": "climate.dormitor_parinti,climate.dormitor_copii,climate.baie,climate.hol,climate.salon,climate.terasa,climate.hol,climate.termostat_baie",
                "valueType": "str"
            },
            {
                "property": "attributes.hvac_action",
                "logic": "is",
                "value": "heating",
                "valueType": "str"
            },
            {
                "property": "state",
                "logic": "is",
                "value": "heat",
                "valueType": "str"
            }
        ],
        "outputType": "array",
        "outputEmptyResults": true,
        "outputLocationType": "msg",
        "outputLocation": "payload",
        "outputResultsCount": 1,
        "x": 390,
        "y": 120,
        "wires": [
            [
                "924bf21a0fc0a186",
                "1e80635bfed65ad0"
            ]
        ]
    },
    {
        "id": "d01d6bb5.176d08",
        "type": "server",
        "name": "Home Assistant",
        "version": 5,
        "addon": true,
        "rejectUnauthorizedCerts": true,
        "ha_boolean": "y|yes|true|on|home|open",
        "connectionDelay": true,
        "cacheJson": true,
        "heartbeat": false,
        "heartbeatInterval": 30,
        "areaSelector": "friendlyName",
        "deviceSelector": "friendlyName",
        "entitySelector": "friendlyName",
        "statusSeparator": "at: ",
        "statusYear": "hidden",
        "statusMonth": "short",
        "statusDay": "numeric",
        "statusHourCycle": "h23",
        "statusTimeFormat": "h:m",
        "enableGlobalContextStore": true
    }
]

Laxilef, 2024-03-03:
Automation in HA:

```yaml
alias: Sync TRV with boiler
description: ""
trigger:
  - platform: time_pattern
    seconds: /30
condition: []
action:
  - variables:
      current_actions: "{{ thermostats | map('state_attr', 'hvac_action') | list }}"
      current_action: "{{ iif('heating' in current_actions, 'heat', 'off') }}"
      max_target_temp: >-
        {{ thermostats | map('state_attr', 'temperature') | list | max |
        float(0) | round(2) }}
      min_current_temp: >-
        {{ thermostats | map('state_attr', 'current_temperature') | list | min |
        float(0) | round(2) }}
  - if:
      - condition: template
        value_template: "{{ states(target_thermostat) != current_action }}"
    then:
      - service: |-
          {% if current_action == 'heat' %}
            climate.turn_on
          {% else %}
            climate.turn_off
          {% endif %}
        target:
          entity_id: "{{ target_thermostat }}"
  - if:
      - condition: template
        value_template: >-
          {{ (state_attr(target_thermostat, 'temperature') | float(0) -
          max_target_temp) | abs | round(2) > 0.1 }}
    then:
      - service: climate.set_temperature
        target:
          entity_id: "{{ target_thermostat }}"
        data:
          temperature: "{{ max_target_temp }}"
  - if:
      - condition: template
        value_template: >-
          {{ (states(indoor_temp_entity) | float(0) - min_current_temp) | abs |
          round(2) > 0.1 }}
    then:
      - service: number.set_value
        target:
          entity_id: "{{ indoor_temp_entity }}"
        data:
          value: "{{ min_current_temp }}"
variables:
  thermostats:
    - climate.bedroom_1
    - climate.bedroom_2
    - climate.bathroom
    - climate.livingroom
  target_thermostat: climate.opentherm_heating
  indoor_temp_entity: number.opentherm_indoor_temp
mode: single
```

Edit before saving:
```yaml
variables:
  thermostats:
    - climate.bedroom_1
    - climate.bedroom_2
    - climate.bathroom
    - climate.livingroom
  target_thermostat: climate.opentherm_heating
  indoor_temp_entity: number.opentherm_indoor_temp
```

SanFable, 2024-03-05:
I did similar but much simpler,

I have 6 smart TRVs with 6 xiaomi temperature sensors as their temp input
TRVs are doing the job to heat up to desired temperature.
TRVs are reporting "PI heating demand" - the percentage of needle insertion (0 is closed, 100 is fully open)

I did simple automation:
If sum of all these is over 41 that means there is a heating demand -> heating on
If sum of all these is under 20 that means we heated up enough -> heating off

values 41 and 20 are my experimentable but it seems to work fine.

If i Will have to heat only one room, it will for sure open thermostat for more than 40%, so "all the heat" will go into this one.
If 3 rooms will request 16% for just little heat up, boiler will turn on.

Closed 2024-03-25.

Thread 55 (2024-03-02):

Request: Ethernet connection support

pksoft585, 2024-03-02:
Thank you for your project. Now I'm using Wemos D1 Mini32 board (& Tindie Opentherm master shield).

It will be great if your gateway could support Ethernet connection instead of wi-fi. It is more reliable and especially with PoE it can be used for power supply. I think (when you don't use **_Wifi-Manager_** for configuration) it could be maybe simpler now.

I like more complex Ethernet board with **LAN8720** as **WT32-ETH01**, **Olimex ESP32-POE** or simple module with SPI as **Wiznet W5500**.

What do you thinkin about it? Unfortunately my skills aren't to high to fork your project and modify it for Ethernet. Maybe someone else...

Laxilef, 2024-03-03:
Hi,

I thought about it, but now I don’t have free time and devices with an Ethernet port for testing. The project code for working with the network is not complicated. If you have experience in programming, try to add this feature and create a PR.

Closed 2025-02-19.

Thread 56 (2024-03-07):

Baxi Ampera не включается

c0dr1ver, 2024-03-07:
Прошивка: v1.4.0-rc.16

Установил согласно документации ID 4
сущности в HA прокинулись, вижу температуру теплоносителя, могу через HA изменять уставку, но котел всегда на паузе.

OpenTherm settings:
V - Sync modulation with heating
все остальное выключено, поигрался с другими флагами, но результат такой же.

Сенсор в HA OpenTherm Gateway Diagnostic показывает проблему.
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

Не подскажите какие еще настройки нужно произвести и как на котле правильно выбрать термостат?

c0dr1ver, 2024-03-07:
вывод telnet :
```
[00:06:13][OT][TRACE] ID:   57   Request: 90395500   Response: 60390000   Attempt:  1   Status: INVALID
[00:06:13][OT][TRACE] ID:   18   Request:   120000   Response: f0120000   Attempt:  1   Status: INVALID
```

Всё остальные ID - Status: SUCCESS

Laxilef, 2024-03-07:
В настройках котла включили opentherm? Там это называется zont connect.

c0dr1ver, 2024-03-08:
> В настройках котла включили opentherm? Там это называется zont connect. После изменения master member id перезагрузили esp?

Да, а не подскажете какой у вас сенсор выбран, там в настройках Zont/OT на котле есть 3 варианта

Laxilef, 2024-03-08:
Никакой. Не стал их использовать.
Попробуйте эти master member id: 4, 260, 516, 772, 1028

c0dr1ver, 2024-03-09:
> Никакой. Не стал их использовать. Попробуйте эти master member id: 4, 260, 516, 772, 1028

можете прислать фото настроек и что котел на главном экране в итоге отображает, я настраиваю его удаленно и мне нужнен какой-то референс

у меня при установке в HA меняются значения уставки в графе котел, но что бы я не пробовал из ID и других настроек, по данным я вижу что котел не стартует. Вот как мой экран выглядит

Если указать какой-то из датчиков ZONT
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
Если не указывать номер используемых датчиков ZONT
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

Если я ставлю температуру снаружи в нутри через mqtt она не появляется на экране, но уставка на многих ID переключается без проблем.

Laxilef, 2024-03-09:
Температуру с датчиков в амперу не пробрасывал, т.к. не видел в этом смысла.
Рядом с котлом буду на неделе, сделаю фото.
По памяти, все так же, но у меня нет индикации ГВС, потому что не использую. Загрузите логи, посмотрю. Интересует ID 0, 1, 14.

Настройки:
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

c0dr1ver, 2024-03-10:
> По памяти, все так же, но у меня нет индикации ГВС, потому что не использую. Загрузите логи, посмотрю. Интересует ID 0, 1, 14.

```
[12:26:17][OT][TRACE] ID:    0   Request: 80000100   Response: 40000142   Attempt:  1   Status: SUCCESS
[12:26:17][OT][TRACE] ID:   17   Request:   110000   Response: c0110000   Attempt:  1   Status: SUCCESS
[12:26:17][OT][TRACE] ID:   25   Request: 80190000   Response: c0192c00   Attempt:  1   Status: SUCCESS
[12:26:19][OT][TRACE] ID:    0   Request: 80000100   Response: 40000142   Attempt:  1   Status: SUCCESS
[12:26:19][OT][TRACE] ID:   17   Request:   110000   Response: c0110000   Attempt:  1   Status: SUCCESS
[12:26:19][OT][TRACE] ID:   25   Request: 80190000   Response: c0192c00   Attempt:  1   Status: SUCCESS
[12:26:20][OT][TRACE] ID:    0   Request: 80000100   Response: 40000142   Attempt:  1   Status: SUCCESS
[12:26:20][OT][TRACE] ID:   14   Request: 900e6400   Response: 500e6400   Attempt:  1   Status: SUCCESS
[12:26:21][OT][HEATING][SILENT] Set max modulation 100%
[12:26:21][OT][TRACE] ID:   49   Request: 80310000   Response: 4031551e   Attempt:  1   Status: SUCCESS
[12:26:21][OT][TRACE] ID:   57   Request: 90395500   Response: 60390000   Attempt:  1   Status: INVALID
[12:26:22][MQTT][TRACE] Successfully publish 6 of 6 bytes to topic: ot-electro/status
[12:26:22][OT][TRACE] ID:   18   Request:   120000   Response: f0120000   Attempt:  1   Status: INVALID
[12:26:22][MQTT][TRACE] Successfully publish 470 of 470 bytes to topic: ot-electro/state
[12:26:22][OT][TRACE] ID:   17   Request:   110000   Response: c0110000   Attempt:  1   Status: SUCCESS
[12:26:23][OT][TRACE] ID:   25   Request: 80190000   Response: c0192c00   Attempt:  1   Status: SUCCESS
[12:26:24][OT][TRACE] ID:    0   Request: 80000100   Response: 40000142   Attempt:  1   Status: SUCCESS
[12:26:24][OT][TRACE] ID:   17   Request:   110000   Response: c0110000   Attempt:  1   Status: SUCCESS
[12:26:24][OT][TRACE] ID:   25   Request: 80190000   Response: c0192c00   Attempt:  1   Status: SUCCESS
[12:26:25][OT][TRACE] ID:    0   Request: 80000100   Response: 40000142   Attempt:  1   Status: SUCCESS
[12:26:26][OT][TRACE] ID:   17   Request:   110000   Response: c0110000   Attempt:  1   Status: SUCCESS
[12:26:26][OT][TRACE] ID:   25   Request: 80190000   Response: c0192c00   Attempt:  1   Status: SUCCESS
[12:26:27][OT][TRACE] ID:    0   Request: 80000100   Response: 40000142   Attempt:  1   Status: SUCCESS
[12:26:27][OT][TRACE] ID:   17   Request:   110000   Response: c0110000   Attempt:  1   Status: SUCCESS
[12:26:28][OT][TRACE] ID:   25   Request: 80190000   Response: c0192c00   Attempt:  1   Status: SUCCESS
[12:26:28][MQTT][TRACE] Successfully publish 6 of 6 bytes to topic: ot-electro/status
[12:26:28][MQTT][TRACE] Successfully publish 470 of 470 bytes to topic: ot-electro/state
[12:26:29][OT][TRACE] ID:    0   Request: 80000100   Response: 40000142   Attempt:  1   Status: SUCCESS
[12:26:29][OT][TRACE] ID:   17   Request:   110000   Response: c0110000   Attempt:  1   Status: SUCCESS
[12:26:29][OT][TRACE] ID:   25   Request: 80190000   Response: c0192c00   Attempt:  1   Status: SUCCESS
[12:26:30][OT][TRACE] ID:    0   Request: 80000100   Response: 40000142   Attempt:  1   Status: SUCCESS
[12:26:31][OT][TRACE] ID:   17   Request:   110000   Response: c0110000   Attempt:  1   Status: SUCCESS
[12:26:31][OT][TRACE] ID:   25   Request: 80190000   Response: c0192c00   Attempt:  1   Status: SUCCESS
[12:26:32][MQTT][MSG][TRACE] Topic: ot-electro/settings/set
>  {"heating": {"target" : 56.0}}

[12:26:33][OT][TRACE] ID:    0   Request: 80000100   Response: 40000142   Attempt:  1   Status: SUCCESS
[12:26:34][MQTT][TRACE] Successfully publish 0 of 0 bytes to topic: ot-electro/settings/set
[12:26:34][OT][TRACE] ID:   17   Request:   110000   Response: c0110000   Attempt:  1   Status: SUCCESS
[12:26:34][MAIN][VERB] Free heap size: 89148 of 237956 bytes (min: 37452, diff: 0), max free block: 69620 (min: 25588, diff: 0, frag: 21%)
[12:26:35][OT][TRACE] ID:   25   Request: 80190000   Response: c0192c00   Attempt:  1   Status: SUCCESS
[12:26:35][MQTT][TRACE] Successfully publish 6 of 6 bytes to topic: ot-electro/status
[12:26:36][MQTT][TRACE] Successfully publish 470 of 470 bytes to topic: ot-electro/state
[12:26:36][OT][TRACE] ID:    0   Request: 80000100   Response: 40000142   Attempt:  1   Status: SUCCESS
[12:26:36][MQTT][TRACE] Successfully publish 555 of 555 bytes to topic: ot-electro/settings
[12:26:36][OT][TRACE] ID:   17   Request:   110000   Response: c0110000   Attempt:  1   Status: SUCCESS
[12:26:37][OT][TRACE] ID:   25   Request: 80190000   Response: c0192c00   Attempt:  1   Status: SUCCESS
[12:26:38][OT][TRACE] ID:    0   Request: 80000100   Response: 40000142   Attempt:  1   Status: SUCCESS
[12:26:38][OT][TRACE] ID:   17   Request:   110000   Response: c0110000   Attempt:  1   Status: SUCCESS
[12:26:38][OT][TRACE] ID:   25   Request: 80190000   Response: c0192c00   Attempt:  1   Status: SUCCESS
[12:26:39][OT][TRACE] ID:    0   Request: 80000100   Response: 40000142   Attempt:  1   Status: SUCCESS
[12:26:39][OT][TRACE] ID:   17   Request:   110000   Response: c0110000   Attempt:  1   Status: SUCCESS
[12:26:40][OT][TRACE] ID:   25   Request: 80190000   Response: c0192c00   Attempt:  1   Status: SUCCESS
[12:26:40][REGULATOR][INFO] New target: 56.00
[12:26:41][OT][TRACE] ID:    0   Request: 80000100   Response: 40000142   Attempt:  1   Status: SUCCESS
[12:26:41][OT][TRACE] ID:   17   Request:   110000   Response: c0110000   Attempt:  1   Status: SUCCESS
[12:26:41][MQTT][TRACE] Successfully publish 6 of 6 bytes to topic: ot-electro/status
[12:26:41][OT][TRACE] ID:   25   Request: 80190000   Response: c0192c00   Attempt:  1   Status: SUCCESS
[12:26:42][OT][HEATING][INFO] Set temp = 56
[12:26:42][MQTT][TRACE] Successfully publish 470 of 470 bytes to topic: ot-electro/state
[12:26:42][OT][TRACE] ID:    1   Request: 90013800   Response: 50013800   Attempt:  1   Status: SUCCESS
```

c0dr1ver, 2024-03-10:
Я могу лишь предположить что шлюз меняет значение уставки внутреннего термостата, но при подключении OT котел переходит именно на термостат ОТ, а судя по индикации - по ОТ он температуру не видит(прочерки) и по этому собственно не стартует

Laxilef, 2024-03-10:
В настройках котла погодозависимое управление случайно не включено?
У меня практически все настройки те, что были по заводу, за исключением включенного opentherm. Т.е. котел не использует никакие датчики для управления нагревом.

c0dr1ver, 2024-03-10:
Да, вы совершенно правы. Оказывается включён был внешний термостат вместе с zont’ом.

Все работает. Спасибо

Closed 2024-03-10.

Thread 57 (2024-03-11):

Baxi eco 4s + WeMos D1 sheld. [OT][WARN] Invalid response after setBoilerStatus: TIMEOUT

MrDogYar, 2024-03-11:
Добрый день!
Связка Baxi eco 4s + WeMos D1 sheld.
Нет связи с котлом. [OT][WARN] Invalid response after setBoilerStatus: TIMEOUT
Меняли местами OT PIN без результатно

Часть Log
Основной в аттаче
[Log_BaxiEco4s+WenosD1 Shield .txt](https://github.com/Laxilef/OTGateway/files/14562595/Log_BaxiEco4s%2BWenosD1.Shield.txt)

00:00:00][NETWORK][TRACE] Set hostname 'zelenay19': success
[00:00:05][SENSORS][OUTDOOR][INFO] Starting on gpio 12...
[00:00:05][SENSORS][OUTDOOR][TRACE] Devices on bus: 1, DS18* devices: 1
[00:00:05][SENSORS][OUTDOOR][INFO] Started
[00:00:06][PORTAL][WEBSERVER][TRACE] Started: AP up or STA connected
[00:00:06][MQTT][INFO] Enabled
[00:00:06][MQTT][INFO] Started
[00:00:06][OT][INFO] Started. GPIO IN: 4, GPIO OUT: 5
[00:00:07][MAIN][VERB] Free heap size: 27440 of 81920 bytes (min: 27440, diff: 4294939856), max free block: 27144 (min: 27144, diff: 4294940152, frag: 1%)
[00:00:07][NETWORK][INFO] Connected, downtime: 7 s., IP: 192.168.0.107, RSSI: -73
[00:00:08][OT][TRACE] ID:    0   Request:     2200   Response:        0   Attempt:  1   Status: TIMEOUT
[00:00:09][OT][TRACE] ID:    0   Request:     2200   Response:        0   Attempt:  2   Status: TIMEOUT
[00:00:10][REGULATOR][INFO] New target: 25.00
[00:00:10][REGULATOR][EQUITHERM][INFO] New result: 59 (59.38)
[00:00:10][MAIN][VERB] Free heap size: 27216 of 81920 bytes (min: 27216, diff: 224), max free block: 27144 (min: 27144, diff: 0, frag: 0%)
[00:00:10][SENSORS][OUTDOOR][TRACE] Raw temp: 27.437500
[00:00:10][SENSORS][OUTDOOR][INFO] New temp: 27.430000
[00:00:10][OT][TRACE] ID:    0   Request:     2200   Response:        0   Attempt:  3   Status: TIMEOUT
[00:00:12][OT][TRACE] ID:    0   Request:     2200   Response:        0   Attempt:  4   Status: TIMEOUT
[00:00:13][OT][TRACE] ID:    0   Request:     2200   Response:        0   Attempt:  5   Status: TIMEOUT
[00:00:13][OT][WARN] Invalid response after setBoilerStatus: TIMEOUT
[00:00:15][SENSORS][OUTDOOR][TRACE] Raw temp: 27.687500
[00:00:15][OT][TRACE] ID:    0   Request:     2200   Response:        0   Attempt:  1   Status: TIMEOUT
[00:00:15][MQTT][INFO] Connecting to 91.203.125.214:1883...
[00:00:15][MAIN][VERB] Free heap size: 26944 of 81920 bytes (min: 26944, diff: 272), max free block: 26752 (min: 26752, diff: 392, frag: 0%)
[00:00:16][MQTT][INFO] Connected (downtime: 16 s.)
[00:00:16][OT][TRACE] ID:    0   Request:     2200   Response:        0   Attempt:  2   Status: TIMEOUT
[00:00:17][OT][TRACE] ID:    0   Request:     2200   Response:        0   Attempt:  3   Status: TIMEOUT
[00:00:18][OT][TRACE] ID:    0   Request:     2200   Response:        0   Attempt:  4   Status: TIMEOUT
[00:00:19][OT][TRACE] ID:    0   Request:     2200   Response:        0   Attempt:  5   Status: TIMEOUT
[00:00:19][OT][WARN] Invalid response after setBoilerStatus: TIMEOUT
[00:00:20][REGULATOR][EQUITHERM][INFO] New result: 40 (40.00)
[00:00:20][SENSORS][OUTDOOR][TRACE] Raw temp: 27.437500
[00:00:21][OT][TRACE] ID:    0   Request:     2200   Response:        0   Attempt:  1   Status: TIMEOUT
[00:00:22][OT][TRACE] ID:    0   Request:     2200   Response:        0   Attempt:  2   Status: TIMEOUT
[00:00:24][OT][TRACE] ID:    0   Request:     2200   Response:        0   Attempt:  3   Status: TIMEOUT
[00:00:25][SENSORS][OUTDOOR][TRACE] Raw temp: 27.500000
[00:00:25][OT][TRACE] ID:    0   Request:     2200   Response:        0   Attempt:  4   Status: TIMEOUT
[00:00:26][OT][TRACE] ID:    0   Request:     2200   Response:        0   Attempt:  5   Status: TIMEOUT
[00:00:26][OT][WARN] Invalid response after setBoilerStatus: TIMEOUT
[00:00:28][OT][TRACE] ID:    0   Request:     2200   Response:        0   Attempt:  1   Status: TIMEOUT
[00:00:29][OT][TRACE] ID:    0   Request:     2200   Response:        0   Attempt:  2   Status: TIMEOUT
[00:00:30][SENSORS][OUTDOOR][TRACE] Raw temp: 27.562500
[00:00:30][OT][TRACE] ID:    0   Request:     2200   Response:        0   Attempt:  3   Status: TIMEOUT
[00:00:31][MQTT][TRACE] Successfully publish 6 of 6 bytes to topic: zelenay19/status
[00:00:31][MAIN][VERB] Free heap size: 26784 of 81920 bytes (min: 26784, diff: 160), max free block: 25368 (min: 25368, diff: 1384, frag: 5%)
[00:00:31][MQTT][TRACE] Successfully publish 471 of 471 bytes to topic: zelenay19/state
[00:00:31][MAIN][VERB] Free heap size: 26296 of 81920 bytes (min: 26296, diff: 488), max free block: 24864 (min: 24864, diff: 504, frag: 5%)
[00:00:31][MQTT][TRACE] Successfully publish 553 of 553 bytes to topic: zelenay19/settings
[00:00:31][OT][TRACE] ID:    0   Request:     2200   Response:        0   Attempt:  4   Status: TIMEOUT
[00:00:32][MAIN][VERB] Free heap size: 26088 of 81920 bytes (min: 26088, diff: 208), max free block: 24704 (min: 24704, diff: 160, frag: 5%)
[00:00:32][MQTT][TRACE] Successfully publish 633 of 633 bytes to topic: homeassistant/switch/zelenay19/emergency/config
[00:00:32][MAIN][VERB] Free heap size: 24640 of 81920 bytes (min: 24640, diff: 1448), max free block: 24104 (min: 24104, diff: 600, frag: 2%)
[00:00:32][MQTT][TRACE] Successfully publish 692 of 692 bytes to topic: homeassistant/number/zelenay19/emergency_target/config
[00:00:32][MAIN][VERB] Free heap size: 24448 of 81920 bytes (min: 24448, diff: 192), max free block: 23848 (min: 23848, diff: 256, frag: 2%)
[00:00:32][MQTT][TRACE] Successfully publish 820 of 820 bytes to topic: homeassistant/switch/zelenay19/emergency_use_equitherm/config
[00:00:32][MAIN][VERB] Free heap size: 24376 of 81920 bytes (min: 24376, diff: 72), max free block: 24056 (min: 23848, diff: 0, frag: 1%)
[00:00:33][MQTT][TRACE] Successfully publish 783 of 783 bytes to topic: homeassistant/switch/zelenay19/emergency_use_pid/config
[00:00:33][OT][TRACE] ID:    0   Request:     2200   Response:        0   Attempt:  5   Status: TIMEOUT
[00:00:33][OT][WARN] Invalid response after setBoilerStatus: TIMEOUT
[00:00:33][MQTT][TRACE] Successfully publish 649 of 649 bytes to topic: homeassistant/switch/zelenay19/heating/config
[00:00:33][MQTT][TRACE] Successfully publish 676 of 676 bytes to topic: homeassistant/switch/zelenay19/heating_turbo/config
[00:00:34][MQTT][TRACE] Successfully publish 688 of 688 bytes to topic: homeassistant/number/zelenay19/heating_hysteresis/config
[00:00:34][MQTT][TRACE] Successfully publish 615 of 615 bytes to topic: homeassistant/sensor/zelenay19/heating_setpoint/config
[00:00:34][MQTT][TRACE] Successfully publish 774 of 774 bytes to topic: homeassistant/sensor/zelenay19/boiler_heating_min_temp/config
[00:00:35][MQTT][TRACE] Successfully publish 772 of 772 bytes to topic: homeassistant/sensor/zelenay19/boiler_heating_max_temp/config
[00:00:35][OT][TRACE] ID:    0   Request:     2200   Response:        0   Attempt:  1   Status: TIMEOUT
[00:00:35][SENSORS][OUTDOOR][TRACE] Raw temp: 27.437500
[00:00:35][MQTT][TRACE] Successfully publish 691 of 691 bytes to topic: homeassistant/number/zelenay19/heating_min_temp/config
[00:00:35][MQTT][TRACE] Successfully publish 690 of 690 bytes to topic: homeassistant/number/zelenay19/heating_max_temp/config
[00:00:36][MQTT][TRACE] Successfully publish 689 of 689 bytes to topic: homeassistant/number/zelenay19/heating_max_modulation/config
[00:00:36][OT][TRACE] ID:    0   Request:     2200   Response:        0   Attempt:  2   Status: TIMEOUT
[00:00:36][MQTT][TRACE] Successfully publish 589 of 589 bytes to topic: homeassistant/switch/zelenay19/pid/config
[00:00:37][MQTT][TRACE] Successfully publish 579 of 579 bytes to topic: homeassistant/number/zelenay19/pid_p_factor/config
[00:00:37][MQTT][TRACE] Successfully publish 578 of 578 bytes to topic: homeassistant/number/zelenay19/pid_i_factor/config
[00:00:37][OT][TRACE] ID:    0   Request:     2200   Response:        0   Attempt:  3   Status: TIMEOUT
[00:00:37][MQTT][TRACE] Successfully publish 577 of 577 bytes to topic: homeassistant/number/zelenay19/pid_d_factor/config
[00:00:38][MQTT][TRACE] Successfully publish 595 of 595 bytes to topic: homeassistant/number/zelenay19/pid_dt/config
[00:00:38][MQTT][TRACE] Successfully publish 671 of 671 bytes to topic: homeassistant/number/zelenay19/pid_min_temp/config
[00:00:38][MQTT][TRACE] Successfully publish 670 of 670 bytes to topic: homeassistant/number/zelenay19/pid_max_temp/config
[00:00:38][OT][TRACE] ID:    0   Request:     2200   Response:        0   Attempt:  4   Status: TIMEOUT
[00:00:39][MQTT][TRACE] Successfully publish 629 of 629 bytes to topic: homeassistant/switch/zelenay19/equitherm/config
[00:00:39][MQTT][TRACE] Successfully publish 611 of 611 bytes to topic: homeassistant/number/zelenay19/equitherm_n_factor/config
[00:00:39][MAIN][VERB] Free heap size: 24280 of 81920 bytes (min: 24280, diff: 96), max free block: 24104 (min: 23848, diff: 0, frag: 0%)
[00:00:39][MQTT][TRACE] Successfully publish 606 of 606 bytes to topic: homeassistant/number/zelenay19/equitherm_k_factor/config
[00:00:39][PORTAL][WEBSERVER][TRACE] Request /api/settings 216 bytes: {"opentherm":{"inPin":4,"outPin":5,"memberIdCode":0,"dhwPresent":true,"modulationSyncWithHeating":true,"summerWinterMode":false,"heatingCh2Enabled":false,"heatingCh1ToCh2":false,"dhwToCh2":false,"dhwBlocking":false}}
[00:00:39][MAIN][VERB] Free heap size: 23296 of 81920 bytes (min: 23296, diff: 984), max free block: 22728 (min: 22728, diff: 1120, frag: 2%)
[00:00:39][OT][TRACE] ID:    0   Request:     2200   Response:        0   Attempt:  5   Status: TIMEOUT
[00:00:39][OT][WARN] Invalid response after setBoilerStatus: TIMEOUT

Laxilef, 2024-03-12:
Какой адаптер используется?

MrDogYar, 2024-03-12:
Собран самостоятельно по вашей схеме только без светодиодной индикации. 
https://github.com/Laxilef/OTGateway/blob/master/assets/Schematic.pdf
 
Вчера вечером подключил к своему котлу Bocsh Gaz6000. Плата работает. :-(
 
 
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
 
 
С уважением,
Денис Титов
***@***.***
 

Laxilef, 2024-03-12:
Значит аппаратную часть адаптера исключаем.
На [сайте зонта](https://www.tvp-electro.ru/wp-content/uploads/2023/05/baxi-eco-4s-tsifrovoe-podklyuchenie-smart-2.0-dineco-1.jpg) eco 4s заявлен как совместимый, значит opentherm там работает.

Подключали вместо перемычки? Настройки котла пробовали сбрасывать?

MrDogYar, 2024-03-12:
Да. Перемычку удаляем и на ее место подключаем ОТ
 
Настройки не меняли и не сбрасывали.
 
 
 
Но что еще меня смутило. После удаления перемычки на контактах ОТ-котла 110 вольт.
С подключенным  к ОТ контроллера падает до 1-2 вольт.
 
У меня на Bosch без подключения ОТ 30 вольт, с подключеным ОТ 6-8 вольт.

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
 
 
С уважением,
Денис Титов
***@***.***
 

MrDogYar, 2024-03-12:
А вот это интересно. Получаеться, что надо удалить перемычку, но подключаться не в нее как на всех котлах, а в разъем X6 

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
 
 
С уважением,
Денис Титов
***@***.***
 

MrDogYar, 2024-03-12:
 
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
 
 
С уважением,
Денис Титов
***@***.***
 

Laxilef, 2024-03-12:
Это один и тот же разъем.
Проверьте корректность подключения питания котла. Судя по документации, один из контактов этой колодки соединен с нулем питания. И если там не ноль, а фаза, то ничего хорошего не будет.
110в там не должно быть, по спецификации OT до 45в, если не ошибаюсь.
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

MrDogYar, 2024-03-12:
Пообщался т техподдержкой БАКСИ.
 
*  Говорят, что ОТ разъем это как раз X6.
*  Перемычку надо удалить.
*  На ОТ должно быть 24 в.
 
Вечером пойдем с другом опять эксперементировать.
По итогам отпишусь.
 
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
 
 
С уважением,
Денис Титов
***@***.***
 

MrDogYar, 2024-03-12:
Добрый вечер!
Все заработало!
Можно добавлять в копилку BAXI ECO 4S + WemosD1 Shield.
Для подключения надо удалить перемычку, а ОТ контакты подсоединить к разъему X6 на плате.
 
Единственное. Почему-то постоянно показывает, что в ГВС есть проток
sensor.opentherm_dhw_flow_rate.
 
Но на функционал ни как не влияет.
 
Спасибо за техподдержку.!!!
 

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
 
 
С уважением,
Денис Титов
***@***.***
 

MrDogYar, 2024-03-12:
> В чем проблема была?

Перепутана L и N на котле. Плюс подключались к колодке термостата где была перемычка, а надо подключаться к разъему X6 на плате. (Он в низу)

MrDogYar, 2024-03-20:
Добрый день!
А возможно реализвать в прошивке локальный MQTT на примере
https://github.com/martin-ger/uMQTTBroker
что б контроллер заворачивал свои сообщения сам на себя?

Closed 2024-03-13.

Thread 58 (2024-04-12):

Viessmann Vitodens 100-W DHW temperature is displayed as Heating in opentherm.

nedievas, 2024-04-12:
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

Laxilef, 2024-04-12:
Please describe the problem in more detail.

nedievas, 2024-04-13:
I made a custom scheme of OpenTherm Gateway. Here's the schematics:
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
Constructed something like this:
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
Flashed with 1.4.0-rc.20.
Results are that LED does not work. Maybe faulty schematics (please inspect if have time). Managed to connect to my Viessmann Vitodens 100-W boiler. Observing that hot water temperature on the boiler is displayed as heating temperature in mqtt. Here the photos:
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
My boiler settings are: 55 degrees for hot water and 21 (not real temperature but the curve value for heating according to outside temperature) for heating. Here's the graph of this curve:
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
I suppose that is something like Equitherm. I did not activate this function. Though I tried to activate 'DHW flow rate' and 'Pressure', but I see 0.0 all the time.
Do not understand if it's working as supposed to work. Please advise:)

Laxilef, 2024-04-14:
Your heating temperature is set to 30 degrees. According to the table you provided, this is about 60 degrees at an outside temperature of 10 degrees. I don’t know what delta your boiler has, but perhaps this is normal behavior. Can you set 21 degrees on the heating thermostat in Home Assistant?

nedievas, 2024-04-14:
> Your heating temperature is set to 30 degrees. According to the table you provided, this is about 60 degrees at an outside temperature of 10 degrees. I don’t know what delta your boiler has, but perhaps this is normal behavior. Can you set 21 degrees on the heating thermostat in Home Assistant?

Updated to [v1.4.0-rc.22](https://github.com/Laxilef/OTGateway/releases/tag/1.4.0-rc.22). Still...
I am able to change DHW and heating temperature in HA, but these changes does not change on the boiler. I am able to turn on/off heating in HA which affects the boiler - it just calms or resumes it's work, but on the boiler menu it still show 21 for heating, and  55 for DHW /should show OFF as per manual/. Turning on/off DHW on HA does not show any signs on the boiler.

Laxilef, 2024-04-15:
Hmm. It looks like we have to use other IDs to set the temperature if the curve mode on the boiler is enabled.
For now, I can suggest disabling this mode on the boiler and enabling equitherm in the firmware to calculate the temperature.

nedievas, 2024-04-17:
> Hmm. It looks like we have to use other IDs to set the temperature if the curve mode on the boiler is enabled. For now, I can suggest disabling this mode on the boiler and enabling equitherm in the firmware to calculate the temperature.
To disable this mode on the boiler I have to detach the outside temperature sensor from boiler. The boiler then automatically sets higher temperature for heating, as per manual.
Tried this (+ enabling equitherm), and I can not put more than 30 degrees in HA, and heating temp from opentherm is 0. Here is the photo:
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
If Equitherm is deactivated, then the temperature is back  and I may set it higher than 30. Also, after I attached the Opentherm gateway to the boiler and tried to sync temperature settings on HA with boiler settings, I've got the house cold, but DHW as usual.
>
> Does the boiler react to changes in the DHW temperature from the home assistant?
As I mentioned in previous post, I may change it in HA, but it does not change on the boiler. Though, I observe that when I lower the DHW temperature on HA then the temperature is displayed on the right, the DHW on the boiler turns off, if I set it higher, then turns on! It just does not change the set temperatures on the boiler display itself. So the opentherm affects the boiler job, but I am not able to sync if it works as it should:)

Laxilef, 2024-04-17:
So, let's go in order:

1. When PID or/and Equitherm is turned on, the temperature on the thermostat in the home assistant is limited to 5..30 because this is the target indoor temperature.
2. When PID or/and Equitherm is turned on, the current temperature on the thermostat in the home assistant is the indoor temperature. If 0 is displayed, it means there is no sensor or automation is not configured to transmit indoor temperature.
3. If the "curve mode" is enabled on the boiler, then we cannot transfer the desired heat carrier temperature to the boiler. I think that in this mode the boiler expects the setpoint **indoor** temperature in ID 16, 23, but this is not currently supported in the firmware.

I'll think about what can be done, but not right now. Now I see this solution:
1. Disable "curve mode" (by turning off the sensor or in the service menu).
2. Installation of the outdoor sensor DS18B20 and connecting it to the ESP (for Equtherm). You can transmit the indoor temperature [using automation](https://github.com/Laxilef/OTGateway/wiki#reporting-indooroutdoor-temperature-from-any-home-assistant-sensor).
3. Using PID or Equitherm.

nedievas, 2024-04-17:
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

Did add the internal temperature via automation just after my post.

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
What about Danfoss thermostats that are used for setting separate room temperatures. I was expecting Opentherm for fault troubleshooting, and not for room temperature control. Or is OpenTherm still better option than original boiler settings? If no, is it possible for Opentherm gateway not to control the boiler heating, just DHW and reset boiler on F2 fault via HA automation?

Laxilef, 2024-04-17:
Let's start by testing my hypothesis. Try disabling the "curve mode" and check if the boiler will respond correctly to changes in setpoint temp.
Equitherm is the same curve mode, but more flexibly customizable.

Laxilef, 2024-04-19:
Any news?
I added the ability to use the temperature controller built into the boiler, but it needs to be tested. If my hypothesis is correct, then I will commit the changes.

nedievas, 2024-04-19:
> Any news? I added the ability to use the temperature controller built into the boiler, but it needs to be tested. If my hypothesis is correct, then I will commit the changes.

Now I am testing Equitherm and am at 2. point, where N=0,7, and K, and T are 0-es. Now going for K to set on 2 and test.
Would like to test your hypothesis, but let's calibrate my equitherm as per your excel_calc this weekend.

nedievas, 2024-04-19:
> Ok thx With the curve mode disabled, does the boiler correctly accept the heating temp and heat to the set temperature? Pls upload a screenshot of the graph `sensor.opentherm_heating_setpoint` and `sensor.opentherm_heating_temp`

I did not change anything on HA except setting  N to 0.7, and later today adding K with 2.0 , just set all rooms including garage temperature to 23 on Danfoss Link.

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

My current outputs in HA:
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

Laxilef, 2024-04-19:
``sensor.opentherm_heating_temp`` looks strange. This value should be smoother, example:
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

I have no experience with Danfoss Link, is it also connected to the opentherm bus?

nedievas, 2024-04-19:
> `sensor.opentherm_heating_temp` looks strange. This value should be smoother, example: ![Screenshot_7](https://private-user-images.githubusercontent.com/34578544/324063556-a2e63561-5a2b-4a45-b486-5be3e0261a10.png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)
>
> I have no experience with Danfoss Link, is it also connected to the opentherm bus?

No. It controls thermostats for floor heating and two radiators in the boiler room and garage.

Laxilef, 2024-04-19:
Ok. After the weekend, please upload screenshots of these graphs again.

Pajuris, 2024-04-21:
@nedievas Kas tau neveikia su tuo boileriu? Aš turiu tokį pat ir pas mane viskas gerai veikia. Sorry neturiu laiko į šį topiką įsigilinti ir viską išanalizuoti, tad jei gali trumpai mestelk info. Temperatūra kaip rašai pirmam poste taip pat veikė ir pas mane blogai, bet atrodo įjungus PID (būtent PID) viskas buvo tvarkoj. Taip pat su nustatymai reiktų pažaisti, uždėti varneles. Pas mane (žr. screeną)
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

nedievas, 2024-04-21:
> Ok. After the weekend, please upload screenshots of these graphs again.

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

Feel a lot chiller than before :)

> @nedievas Kas tau neveikia su tuo boileriu? Aš turiu tokį pat ir pas mane viskas gerai veikia. Sorry neturiu laiko į šį topiką įsigilinti ir viską išanalizuoti, tad jei gali trumpai mestelk info. Temperatūra kaip rašai pirmam poste taip pat veikė ir pas mane blogai, bet atrodo įjungus PID (būtent PID) viskas buvo tvarkoj. Taip pat su nustatymais reiktų pažaisti, uždėti varneles. Pas mane: ![Screenshot 2024-04-21 at 09 56 13](https://private-user-images.githubusercontent.com/156599470/324228885-bf93f4bc-5876-4c9e-8a52-7fbac6a6d4d8.png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)

O kaip atrodo visi settings? PID ir panašiai... pas mane grindinis šildymas per Danfoss Link kuris su HA nekalba ir boileris buvo pajungtas per lauko temp daviklį. Tai kaip ir viskas veikė, bet F2 kodą mesdavo kai staiga lauko temp nukrisdavo, tai užmačiau Opentherm gateway - pasigaminau ir bandau pajungti tam kad per HA turėčiau galimybę reset jei tas F2 išlenda, bet čia jis perima valdymą, todėl bandau prisiderinti.

Pajuris, 2024-04-21:
Nustatymai iš HA:

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
Kai pajungti termostatą, katilas nebereaguoja į lauko temperatūrą. Taigi, tai nebeaktualu. Be to ir nebereikalinga, nes per HA gali geriau susidėlioti automatikas, nei Viessmann sugalvojo kreives.
Beje, jei kartais norėtum, galiu pigiai perleisti ir Viessmann originalų termostatą su OT jungtimi. Veikia ir integracija į HA. Tik aišku valdymo tiek nebus, kiek tarkim su termostatu ir šituo firmware.

nedievas, 2024-04-21:
> Nustatymai iš HA:
>
> ![Screenshot 2024-04-21 at 21 57 51](https://private-user-images.githubusercontent.com/156599470/324273467-746eae17-113b-496a-9e42-71ce82e74640.png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) ![Screenshot 2024-04-21 at 21 58 11](https://private-user-images.githubusercontent.com/156599470/324273470-f7ccd4eb-02a3-4389-af3f-0d41c325907e.png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) Kai pajungti termostatą, katilas nebereaguoja į lauko temperatūrą. Taigi, tai nebeaktualu. Be to ir nebereikalinga, nes per HA gali geriau susidėlioti automatikas, nei Viessmann sugalvojo kreives. Beje, jei kartais norėtum, galiu pigiai perleisti ir Viessmann originalų termostatą su OT jungtimi. Veikia ir integracija į HA. Tik aišku valdymo tiek nebus, kiek tarkim su termostatu ir šituo firmware.

Tai mano termostatai yra danfoss, kiekvienam kambariui atskiras. Juos gal pakeisiu į ESP32 HA, bet dabar šį OT bandau. Įjungiau PID - nesiskiria nustatymai nuo jūsų. Tik ar jus reguliuojate per HA boilerio temperatūrą ar per kitus termostatus?

Pajuris, 2024-04-21:
Pas mane gridinis 1 aukšte ir radiatoriai - 2. Visur Danfoss pavaros, zigbee jungikliai jas junginėja ir temperatūros jutikliai kiekviena kambary. Viskas suintegruota į HA.
Šalčiausio kambario temperatūros jutiklis, termostate nurodytas kaip vidaus temperatūra, lauko temperatūros jutiklis, kaip lauko temperatūra.
Viską valdau per HA ir per HA automatikas. Ten pat nurodau maks temperatūras, kitus parametrus, kuriuos leidžia termostato firmware.

Pajuris, 2024-04-21:
> Tik ar jus reguliuojate per HA boilerio temperatūrą ar per kitus termostatus?

Tai katilo temperatūra tik per HA termostato valdymą ir tesireguliuoja. Daugiau nėra būdų.
Ar klausi apie  kambarių temperatūrą? Kiekvienam kambariui norima temperatūra, reguliuojasi per HA virtualius termostatus (ima duomenis iš temperatūros daviklių ir reguliuoja zigbee jungiklius per kuriuos įjungia\išjungia Danfoss pavaras).

nedievas, 2024-04-21:
> Pas mane gridinis 1 aukšte ir radiatoriai - 2. Visur Danfoss pavaros, zigbee jungikliai jas junginėja ir temperatūros jutikliai kiekviena kambary. Viskas suintegruota į HA. Šalčiausio kambario temperatūros jutiklis, termostate nurodytas kaip vidaus temperatūra, lauko temperatūros jutiklis, kaip lauko temperatūra. Viską valdau per HA ir per HA automatikas. Ten pat nurodau maks temperatūras, kitus parametrus, kuriuos leidžia termostato firmware.

Mano ir toks planas pasidaryti per jau esamas Danfoss pavaras. Kokius tam zigbee naudojate?

nedievas, 2024-04-21:
> > Tik ar jus reguliuojate per HA boilerio temperatūrą ar per kitus termostatus?
>
> Tai katilo temperatūra tik per HA termostato valdymą ir tesireguliuoja. Daugiau nėra būdų. Ar klausi apie kambarių temperatūrą? Kiekvienam kambariui norima temperatūra, reguliuojasi per HA virtualius termostatus (ima duomenis iš temperatūros daviklių ir reguliuoja zigbee jungiklius per kuriuos įjungia\išjungia Danfoss pavaras).

Tai aš supratau, kad katilas mano kaip buvo nustatytas - aš jo in nereguliavau, bet tas error F2 mane užkniso ir sugalvojau ieškoti sprendimų.

Pajuris, 2024-04-21:
Paprasčiausius.... tokius (yra LT jau):
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
Netobuli, bet veikia.
Manau kad temperatūros jutiklis grybą pjauna. Bet šiaip tos reguliuoti pagal lauko temperatūrą nėra gerai, gaila dujų. Ypač kai šalta lauke ir sukelia temperatūrą boileryje. Tada nebedirba kond. rėžimu ir netaupo dujų.
Perėjus prie vidaus termostato nuo lauko kreivių, aš pradėjau taupyti maždaug 1-2 kubo per parą. Perėjus prie šito termostatato firmwares ir tinkamų automatikų, dar po 2-3 kūbus pradėjau taupyti per dieną.

nedievas, 2024-04-21:
Tai tokius Zigbee aš apšvietimui naudoju :) Gal yra kur info kaip pasijungti kaip Jūsų? Galvojau apie tuos kinietiškus kur daug relių ant pcb ir esphome jungiasi., bet nenorėjau bandyti per šildymo sezoną.

Laxilef, 2024-04-21:
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
It looks like your boiler heats up to 80 degrees when set to ~40 degrees. It is not right. Try set the checkboxes as @Pajuris wrote.

Pajuris, 2024-04-22:
> Gal yra kur info kaip pasijungti kaip Jūsų?

Tai kad ten nereikia jokios info. Viskas labai paprasta. Ant kiekvieno kontūro montuoji Normaly closed galvą, ją pajungi prie pasirinkto jungiklio. Jungiklį prijungi prie HA. Kambariuose išmėtai pasirinktus temperatūros jutiklius. Juos taip pat prijungi prie HA. HA config faile, kuri virtualų termostatą, nurodai kad heateris yra tas galvą įijungiantis išjungiantis jungiklis, o temperatūros rodmenis imsi iš konkretaus kambario jutiklio. Viskas. Restartuoji HA, atsiranda termostatas, kurį gali valdyti kaip tinkamas.

Laxilef, 2024-04-22:
@nedievas could you then test the "Native heating control" option in 1.4.0-rc.24? This option must work with an outdoor temperature sensor connected to the boiler.
https://github.com/Laxilef/OTGateway/releases/tag/1.4.0-rc.24

nedievas, 2024-04-22:
> @nedievas could you then test the "Native heating control" option in [1.4.0-rc.24](https://github.com/Laxilef/OTGateway/releases/tag/1.4.0-rc.24)? This option must work with an outdoor temperature sensor connected to the boiler.

Before upgrade:
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

nedievas, 2024-04-22:
Upgraded. Connected external temperature sensor to boiler, disabled automation for outside temperature, equitherm and PID off. I am observing, that heating target is set to max 30 degrees??? Is it OK?

attaching the telnet log:
```Connected to 192.168.20.94.
Escape character is '^]'.
[00:11:52][MQTT][TRACE] Successfully publish 6 of 6 bytes to topic: opentherm/status
[00:11:52][OT][TRACE] ID:   33   Request:   210000   Response: 4021001f   Attempt:  1   Status: SUCCESS
[00:11:52][OT][HEATING][INFO] Set current indoor temp: 21.47 (converted: 21.47)
[00:11:52][MQTT][TRACE] Successfully publish 566 of 566 bytes to topic: opentherm/state
[00:11:52][OT][TRACE] ID:   24   Request: 10181578   Response: f0180000   Attempt:  1   Status: INVALID
[00:11:52][OT][HEATING][WARN] Failed set current indoor temp
[00:11:52][OT][HEATING][INFO] Set target indoor temp: 30.00 (converted: 30.00)
[00:11:52][OT][TRACE] ID:   16   Request: 10101e00   Response: 70100000   Attempt:  1   Status: INVALID
[00:11:52][OT][HEATING][WARN] Failed set target indoor temp
[00:11:53][OT][TRACE] ID:    0   Request:     3300   Response: 40003302   Attempt:  1   Status: SUCCESS
[00:11:54][OT][TRACE] ID:   26   Request: 801a0000   Response: 401a3b19   Attempt:  1   Status: SUCCESS
[00:11:54][OT][TRACE] ID:   19   Request: 80130000   Response: 70130000   Attempt:  1   Status: INVALID
[00:11:54][MAIN][VERB] Free heap size: 24256 of 81920 bytes (min: 19216, diff: 0), max free block: 23864 (min: 15488, diff: 0, frag: 1%)
[00:11:54][OT][TRACE] ID:   25   Request: 80190000   Response: c0192780   Attempt:  1   Status: SUCCESS
[00:11:55][OT][TRACE] ID:   28   Request: 801c0000   Response: 701c0000   Attempt:  1   Status: INVALID
[00:11:55][OT][TRACE] ID:   33   Request:   210000   Response: 4021001f   Attempt:  1   Status: SUCCESS
[00:11:55][OT][HEATING][INFO] Set current indoor temp: 21.47 (converted: 21.47)
[00:11:55][OT][TRACE] ID:   24   Request: 10181578   Response: f0180000   Attempt:  1   Status: INVALID
[00:11:55][OT][HEATING][WARN] Failed set current indoor temp
[00:11:55][OT][HEATING][INFO] Set target indoor temp: 30.00 (converted: 30.00)
[00:11:56][OT][TRACE] ID:   16   Request: 10101e00   Response: 70100000   Attempt:  1   Status: INVALID
[00:11:56][OT][HEATING][WARN] Failed set target indoor temp
[00:11:57][OT][TRACE] ID:    0   Request:     3300   Response: 40003302   Attempt:  1   Status: SUCCESS
[00:11:57][OT][TRACE] ID:   26   Request: 801a0000   Response: 401a3b19   Attempt:  1   Status: SUCCESS
[00:11:57][MQTT][MSG][TRACE] Topic: opentherm/state/set
>  {"temperatures": {"indoor":21.47}}

[00:11:57][MQTT][TRACE] Successfully publish 0 of 0 bytes to topic: opentherm/state/set
[00:11:57][OT][TRACE] ID:   19   Request: 80130000   Response: 70130000   Attempt:  1   Status: INVALID
[00:11:57][OT][TRACE] ID:   25   Request: 80190000   Response: c0192480   Attempt:  1   Status: SUCCESS
[00:11:58][MQTT][TRACE] Successfully publish 6 of 6 bytes to topic: opentherm/status
[00:11:58][OT][TRACE] ID:   28   Request: 801c0000   Response: 701c0000   Attempt:  1   Status: INVALID
[00:11:58][MQTT][TRACE] Successfully publish 566 of 566 bytes to topic: opentherm/state
[00:11:58][OT][TRACE] ID:   33   Request:   210000   Response: 4021001f   Attempt:  1   Status: SUCCESS
[00:11:58][OT][HEATING][INFO] Set current indoor temp: 21.47 (converted: 21.47)
[00:11:58][OT][TRACE] ID:   24   Request: 10181578   Response: f0180000   Attempt:  1   Status: INVALID
[00:11:58][OT][HEATING][WARN] Failed set current indoor temp
[00:11:58][OT][HEATING][INFO] Set target indoor temp: 30.00 (converted: 30.00)
[00:11:59][OT][TRACE] ID:   16   Request: 10101e00   Response: 70100000   Attempt:  1   Status: INVALID
[00:11:59][OT][HEATING][WARN] Failed set target indoor temp
[00:12:00][OT][TRACE] ID:    0   Request:     3300   Response: 40003302   Attempt:  1   Status: SUCCESS
[00:12:00][OT][TRACE] ID:   26   Request: 801a0000   Response: 401a3b19   Attempt:  1   Status: SUCCESS
[00:12:00][OT][TRACE] ID:   19   Request: 80130000   Response: 70130000   Attempt:  1   Status: INVALID
[00:12:01][OT][TRACE] ID:   25   Request: 80190000   Response: c01921b3   Attempt:  1   Status: SUCCESS
[00:12:01][OT][TRACE] ID:   28   Request: 801c0000   Response: 701c0000   Attempt:  1   Status: INVALID
[00:12:01][OT][TRACE] ID:   33   Request:   210000   Response: c021001e   Attempt:  1   Status: SUCCESS
[00:12:01][OT][HEATING][INFO] Set current indoor temp: 21.47 (converted: 21.47)
[00:12:02][OT][TRACE] ID:   24   Request: 10181578   Response: f0180000   Attempt:  1   Status: INVALID
[00:12:02][OT][HEATING][WARN] Failed set current indoor temp
[00:12:02][OT][HEATING][INFO] Set target indoor temp: 30.00 (converted: 30.00)
[00:12:02][OT][TRACE] ID:   16   Request: 10101e00   Response: 70100000   Attempt:  1   Status: INVALID
[00:12:02][OT][HEATING][WARN] Failed set target indoor temp
[00:12:03][OT][TRACE] ID:    0   Request:     3300   Response: 40003302   Attempt:  1   Status: SUCCESS
[00:12:03][MQTT][TRACE] Successfully publish 6 of 6 bytes to topic: opentherm/status
[00:12:04][MQTT][TRACE] Successfully publish 566 of 566 bytes to topic: opentherm/state
[00:12:04][OT][TRACE] ID:   26   Request: 801a0000   Response: 401a3b19   Attempt:  1   Status: SUCCESS
[00:12:04][OT][TRACE] ID:   19   Request: 80130000   Response: 70130000   Attempt:  1   Status: INVALID
[00:12:04][OT][TRACE] ID:   25   Request: 80190000   Response: c0191f33   Attempt:  1   Status: SUCCESS
[00:12:05][OT][TRACE] ID:   28   Request: 801c0000   Response: 701c0000   Attempt:  1   Status: INVALID
[00:12:05][OT][TRACE] ID:   33   Request:   210000   Response: c021001e   Attempt:  1   Status: SUCCESS
[00:12:05][OT][HEATING][INFO] Set current indoor temp: 21.47 (converted: 21.47)
[00:12:05][OT][TRACE] ID:   24   Request: 10181578   Response: f0180000   Attempt:  1   Status: INVALID
[00:12:05][OT][HEATING][WARN] Failed set current indoor temp
[00:12:05][OT][HEATING][INFO] Set target indoor temp: 30.00 (converted: 30.00)
[00:12:05][OT][TRACE] ID:   16   Request: 10101e00   Response: 70100000   Attempt:  1   Status: INVALID
[00:12:06][OT][HEATING][WARN] Failed set target indoor temp
[00:12:07][OT][TRACE] ID:    0   Request:     3300   Response: 40003302   Attempt:  1   Status: SUCCESS
[00:12:07][OT][TRACE] ID:   26   Request: 801a0000   Response: 401a3b19   Attempt:  1   Status: SUCCESS
[00:12:07][OT][TRACE] ID:   19   Request: 80130000   Response: 70130000   Attempt:  1   Status: INVALID
[00:12:07][OT][TRACE] ID:   25   Request: 80190000   Response: 40191d4d   Attempt:  1   Status: SUCCESS
[00:12:08][OT][TRACE] ID:   28   Request: 801c0000   Response: 701c0000   Attempt:  1   Status: INVALID
[00:12:08][OT][TRACE] ID:   33   Request:   210000   Response: c021001e   Attempt:  1   Status: SUCCESS
[00:12:08][OT][HEATING][INFO] Set current indoor temp: 21.47 (converted: 21.47)
[00:12:08][OT][TRACE] ID:   24   Request: 10181578   Response: f0180000   Attempt:  1   Status: INVALID
[00:12:08][OT][HEATING][WARN] Failed set current indoor temp
[00:12:08][OT][HEATING][INFO] Set target indoor temp: 30.00 (converted: 30.00)
[00:12:09][OT][TRACE] ID:   16   Request: 10101e00   Response: 70100000   Attempt:  1   Status: INVALID
[00:12:09][OT][HEATING][WARN] Failed set target indoor temp
[00:12:09][MQTT][TRACE] Successfully publish 6 of 6 bytes to topic: opentherm/status
[00:12:09][MQTT][TRACE] Successfully publish 566 of 566 bytes to topic: opentherm/state
[00:12:10][OT][TRACE] ID:    0   Request:     3300   Response: 40003302   Attempt:  1   Status: SUCCESS
[00:12:10][OT][TRACE] ID:   26   Request: 801a0000   Response: 401a3b19   Attempt:  1   Status: SUCCESS
[00:12:10][OT][TRACE] ID:   19   Request: 80130000   Response: 70130000   Attempt:  1   Status: INVALID
[00:12:11][OT][TRACE] ID:   25   Request: 80190000   Response: c0191bb3
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

Thread 61 (2024-05-01):

[noob question] can't connect to wifi

papinist, 2024-05-01:
Hi,
I know this sound as a stupid question, but I'm stuck in initial wifi setup and I cannot go past this.

I'm using a D1 mini (tried a D1 mini32 too, but I am not able to put it in bootloader mode so I can't flash it..) and a Diyless thermostat shield, Flashed with esp flash download tool, powered it and the opentherm gateway AP appears.
Connect with my phone and the main page appears. I then go to network page, it finds my wifi network (Home_wifi); now, touching network names does nothing (don't know if it is supposed to do something..), so I write the ssid in the corresponding field and the password. Click Save and wait.. opentherm AP goes away (so I think it is connected to my home wifi) but checking my router, I can't find it.
After some time the opentherm AP shows up again, reconnect with my phone and in the main page it reports my wifi ssid with signal 0%.

I think I'm missing something but can't figure out what it is...

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

Laxilef, 2024-05-05:
Hi
Do you use a 5 GHz network? If it is named the same as the 2 GHz network, then this will not work. You need to name the networks differently, for example Home_wifi_2g and Home_wifi_5g. This is due to the outdated SDK for ESP8266, which will probably never support 5 GHz networks.

papinist, 2024-05-05:
Thank you for your reply!
Yes, this exactly my case, I have a fritz!box and it defaults both 2.4 and 5ghz networks with the same name.
But I already have about 70 wifi devices, mostly esp8266 with tasmota or older shelly devices, or other d1 minis, and never had issues connecting to this same wifi network.
Is this somewhat different?

Laxilef, 2024-05-05:
Hm. No, Tasmota also uses the NonOS SDK and the Arduino framework. You can try to build the firmware with the ``PIO_FRAMEWORK_ARDUINO_LWIP2_LOW_MEMORY_LOW_FLASH`` flag instead of ``PIO_FRAMEWORK_ARDUINO_LWIP2_LOW_MEMORY`` (platformio.ini), but I have not tested this. Users have previously reported network problems on the ESP8266 when using 2G and 5G networks with the same name. What channel is used for the 2G network?

papinist, 2024-05-05:
Channel management in my fritzbox is set to auto, at this moment 2.4 ghz is using channel 1 and 5 ghz channel 36.

I'm not sure if I am able to build a firmware from scratch, my knowledge about that is very limited :-O

Laxilef, 2024-05-06:
Channel 1 - ok. Problems may occur on channels 12-14. Hmm, strange :) What is your board? Please write the exact name.

papinist, 2024-05-09:
It's a simple D1 mini bought on aliexpress. I have other boards of the same batch that I'm using in other projects (clocks and similar) that are working.
I tried many times the password, it's 10 digits all numbers so it's easy to remember.
No WPA3 here.. but as I said, I have all blinds (12) controlled by esp8266 boards (4-relay esp-12f boards), a dozen sonoff basici\mini for lights and for garden valves and many other 'smart' appliances mostly using esp8266 chip and never had issues.. so this is really strange.

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

Laxilef, 2024-05-10:
Ok, pls test this firmware with ``PIO_FRAMEWORK_ARDUINO_LWIP2_HIGHER_BANDWIDTH_LOW_FLASH``
[build_HIGHER_BANDWIDTH.zip](https://github.com/Laxilef/OTGateway/files/15269413/build_HIGHER_BANDWIDTH.zip)

If this does not help, could you try flashing any other firmware (tasmota for example) and try connecting to Wifi?

papinist, 2024-05-13:
Thanks!
Now I can't even flash it.. always get "com fail" from flash download tool... is there any special procedure to put the d1 mini in flash mode? I only have a 'reset' button but it seems to do nothing.

Laxilef, 2024-05-15:
No, 8266 are flashed normally without pressing any buttons. Upload a screenshot of the error.

SanFable, 2024-06-01:
Hello,

I had same problem with 1.4 RC versions, I tried different ESPs (32 and 8266) and finally discovered that v1.3.3 is working flawlessly, I'm on WPA3.

When I was connecting to wifi, following error popped out in serial logs:

ESP32 WIFI CONNECTION FAILED REASON 6

PS thank you for great project :)

Laxilef, 2024-06-02:
Hi @SanFable
Hm, very very strange, because SDK for esp8266 [does not support wpa3](https://github.com/esphome/issues/issues/3971)
Can you enable debug on 1.4.0, save logs to a file and upload?

SanFable, 2024-06-02:
My bad, Thank you for that info, by luck I finally landed on WPA2 for IoT network.
I will try to gather logs tomorrow

Laxilef, 2024-06-02:
Thx. WPA3 on esp32 with SDK 3.0.0 should work fine, I'll try to compile and upload the build for testing this week in this issue.

SanFable, 2024-06-03:
Hello @Laxilef,

I have gathered the logs, I have used esp32 nodemcu, two scenarios,
[Esp32WifiConnect_SpecifiedWifiSettings.txt](https://github.com/user-attachments/files/15533513/Esp32WifiConnect_SpecifiedWifiSettings.txt)
[Esp32WifiConnect_SpecifiedWifiAndStaticAddressSettings.txt](https://github.com/user-attachments/files/15533511/Esp32WifiConnect_SpecifiedWifiAndStaticAddressSettings.txt)

First one is first reboot after flash, Im connecting to AP, debug options are set already, going into wifi settings, writing SSID, password and channel.

In second logs I'm filling out the dhcp settings (but with marked DHCP anyway), I have tried without DHCP without any other result, just wanted to include two logs because I saw different error once:
Connection failed. Status: 3, reason: 7 vs Connection failed. Status: 2, reason: 6

Flashed factory file with filesystem
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

papinist, 2024-06-07:
> No, 8266 are flashed normally without pressing any buttons. Upload a screenshot of the error. As a workaround, you can update the firmware via OTA.

Sorry for the late reply.. I missed the "new message" notification.

This is the message I got:

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

SanFable, 2024-06-07:
@papinist check if you have installed drivers for built usb->serial adapter

@Laxilef Sorry for late reply, I have tried without success, after that I pressed reset button and same thing,
[NETWORK][TRACE] Connection failed. Status: 2, reason: 6
logs below
[esp32newsdk.txt](https://github.com/user-attachments/files/15745013/esp32newsdk.txt)

papinist, 2024-06-07:
> @papinist check if you have installed drivers for built usb->serial adapter and you are selecting correct COM device

Yes I have already flashed this exact 8266 with this pc and this program, and the COM port is correct.

Laxilef, 2024-06-08:
@papinist try run the flasher as admin and SPI MODE = DIO
@SanFable no idea... try this build
[nodemcu_32s_core_3+wifi_auto_policy.zip](https://github.com/user-attachments/files/15748344/nodemcu_32s_core_3%2Bwifi_auto_policy.zip)

papinist, 2024-06-09:
> @papinist try run the flasher as admin and SPI MODE = DIO

Already tried as admin, and with SPI MODE = DIO nothing changes

SanFable, 2024-06-09:
@Laxilef
LOL, I got it!
even I have tried standard 1.4.0 from release section and its working
You won't believe...

The problem is password forwarding from the form.

On my UniFi-IoT network I have password which has 10 numbers, starting with 0, like: **0**123123123
After i pass the wifi details in logs I see that only 123123123 is sent, so i get error like wrong password.

I have created another wifi network with any other random password like noobnoob123 it got connected.

So there must be something what got changed after 1.3.3 version regarding form and first password character (in my case) 0 is getting lost

@papinist Maybe its same issue in your case?

papinist, 2024-06-09:
> @papinist Maybe its same issue in your case?

my password is starting with "0" too!

Laxilef, 2024-06-11:
Hi guys
Thanks for researching the problem, it will be fixed in 1.4.1

Laxilef, 2024-06-11:
@papinist don’t know why you get an error when flashing, try [nodemcu-flasher](https://github.com/nodemcu/nodemcu-flasher) for esp8266

Laxilef, 2024-06-13:
Pls test build ver 1.4.1

papinist, 2024-06-13:
> @papinist don’t know why you get an error when flashing, try [nodemcu-flasher](https://github.com/nodemcu/nodemcu-flasher) for esp8266

Thank you, I finally managed to flash 1.4.1.. but same as before, after entering wifi password, I got disconnected from AP and then otgateway appears again, connecting to it I still see a red dot right to "connected" and signal 0%

Laxilef, 2024-06-13:
> Thank you, I finally managed to flash 1.4.1.. but same as before, after entering wifi password, I got disconnected from AP and then otgateway AP appears again, connecting to it I still see a red dot right to "connected" and signal 0%

I think the problem may be with your access point settings. I just tested version 1.4.1 on Mikrotik with WPA2/WPA3 and only WPA3 with password 00012345678.
Esp32 connects successfully. I also see in the logs that the password is saved correctly. I remind you that Esp8266 will not work with WPA3.

SanFable, 2024-06-14:
@Laxilef
Confirming, 1.4.1 successfully connected to my UniFi-IoT network.

Thank you very much for fix :)

papinist, 2024-06-14:
> I think the problem may be with your access point settings. I just tested version 1.4.1 on Mikrotik with WPA2+WPA3 and only WPA3 with password 00012345678. Esp32 connects successfully. I also see in the logs that the password is saved correctly. I remind you that Esp8266 will not work with WPA3 and will not work well with WPA2+WPA3.

I'm using a fritz!box 7530 with 3 repeater configured in a mesh network. I'm using only wpa2 and at this moment I have 76 devices connected, of which 27 are tasmotized devices, so sonoff or other board with esp8266 and a couple of esp32.
I really don't know what could be wrong only with this.

Laxilef, 2024-06-15:
Can you take a screenshot of your all wifi settings on fritz!box? Without passwords, of course.
In version 1.4.2 I added "disconnect raw reason" to the logs, please look at the number and write here.

Laxilef, 2024-06-29:
No details, removing the bug label and close issue.

Closed 2024-06-29.

Thread 62 (2024-05-06):

на прошивках выше filesystem_d1_mini32_1.4.0-rc.14 не видит котла

andrey150960, 2024-05-06:
Пробовал обновить прошивку с 14 на более, котел теряется и не подключается для управления.
Откатился на 14 все работает.
Котел Nova Florida delfis ctfs 24
Возможно прошивки нужно обновлять по порядку?
все разобрался, у меня не как у всех вх. и вых подключены.

Closed 2024-05-06.

Thread 63 (2024-05-11):

Счетчик импульсов

andrey150960, 2024-05-11:
Здравствуйте уважаемый.
Прошу вас если есть возможность добавить в прошивку "счетный вход"
К этому входу планирую  подключить геркон и считать импульсы с газового счетчика.
Т.е. имеем импульсы переводим в потребление газа.

Laxilef, 2024-05-12:
Здравствуйте.
Я думаю с этим прекрасно справится и [pulse counter](https://esphome.io/components/sensor/pulse_counter) в esphome. Добавлять этот же функционал в прошивку для управления котлом не вижу смысла.

andrey150960, 2024-05-26:
Да, согласен , но ставить вторую плату в эту же коробку как то не очень хочется. А так спасибо за вашу работу.

Closed 2024-06-15.

Thread 67 (2024-06-06):

Just a question about ESP32 hardware

iz8mbw, 2024-06-06:
Helllo.
I have just a question about hardware needed.
Why an ESP32 board cannot be directly connected using the GPIO PINs to the boiler?
So, if I connect the ESP32 board pins directly to the bolier it does not work?

Thanks!

Laxilef, 2024-06-06:
Hi
On the openterm bus the voltage is higher than 3.3 volts (up to 48 volts), the ESP will break down.

Closed 2024-06-22.

Thread 68 (2024-06-12):

Cannot compile any 8266 configuration.  ESP32 ok.

dee-mos, 2024-06-12:
It's a master branch archive  (https://github.com/Laxilef/OTGateway/archive/refs/heads/master.zip)

```
Executing task: C:\Users\user\.platformio\penv\Scripts\platformio.exe run --environment d1_mini_pro

Warning! Ignore unknown configuration option `version` in section [env]
Processing d1_mini_pro (platform: espressif8266; board: d1_mini_pro; framework: arduino)
----------------------------------------------------------------------------------------------------------------------------------------------------------------------------------Verbose mode can be enabled via `-v, --verbose` option
CONFIGURATION: https://docs.platformio.org/page/boards/espressif8266/d1_mini_pro.html
PLATFORM: Espressif 8266 (2.7.4+20221113) > WeMos D1 mini Pro
HARDWARE: ESP8266 80MHz, 80KB RAM, 16MB Flash
PACKAGES:
 - framework-arduinoespressif8266 @ 2.7.4+9
 - tool-esptoolpy @ 1.40301.221017 (4.3.1)
 - toolchain-xtensa @ 2.40802.200502 (4.8.2)
LDF: Library Dependency Finder -> https://bit.ly/configure-pio-ldf
LDF Modes: Finder ~ chain, Compatibility ~ soft
Found 48 compatible libraries
Scanning dependencies...
Dependency Graph
|-- ArduinoJson @ 7.0.4
|-- OpenTherm Library @ 1.1.5+sha.dab2c13
|-- ArduinoMqttClient @ 0.1.8
|-- ESP Telnet @ 2.2.1
|-- FileData @ 1.0.2
|-- GyverPID @ 3.3.2
|-- GyverBlinker @ 1.1.0
|-- OneWire @ 2.3.8+sha.72249e2
|-- DallasTemperature @ 3.11.0
|-- TinyLogger @ 1.1.0
|-- ESP8266Scheduler @ 1.2.0
|-- LittleFS(esp8266) @ 0.1.0
|-- NetworkUtils
|-- MqttWriter
|-- CustomOpenTherm
|-- BufferedWebServer
|-- DNSServer @ 1.1.1
|-- WebServerHandlers
|-- ESP8266WebServer @ 1.0
|-- Equitherm
|-- HomeAssistantHelper
Building in release mode
Compiling .pio\build\d1_mini_pro\src\main.cpp.o
Compiling .pio\build\d1_mini_pro\libe9f\ESP Telnet\ESPTelnetBase.cpp.o
Compiling .pio\build\d1_mini_pro\lib797\ESP8266Scheduler\Scheduler.cpp.o
Compiling .pio\build\d1_mini_pro\FrameworkArduino\Print.cpp.o
Compiling .pio\build\d1_mini_pro\FrameworkArduino\Schedule.cpp.o
Compiling .pio\build\d1_mini_pro\FrameworkArduino\StackThunk.cpp.o
Compiling .pio\build\d1_mini_pro\FrameworkArduino\Stream.cpp.o
Compiling .pio\build\d1_mini_pro\FrameworkArduino\StreamString.cpp.o
Compiling .pio\build\d1_mini_pro\FrameworkArduino\Tone.cpp.o
Compiling .pio\build\d1_mini_pro\FrameworkArduino\TypeConversion.cpp.o
Compiling .pio\build\d1_mini_pro\FrameworkArduino\Updater.cpp.o
Compiling .pio\build\d1_mini_pro\FrameworkArduino\WMath.cpp.o
In file included from .pio\libdeps\d1_mini_pro\ESP8266Scheduler\src\Scheduler.cpp:2:0:
.pio\libdeps\d1_mini_pro\ESP8266Scheduler\src\Task.h: In member function 'virtual void Task::yield()':
.pio\libdeps\d1_mini_pro\ESP8266Scheduler\src\Task.h:21:26: error: 'cont_suspend' was not declared in this scope
     cont_suspend(&context);
                          ^
Compiling .pio\build\d1_mini_pro\FrameworkArduino\WString.cpp.o
*** [.pio\build\d1_mini_pro\lib797\ESP8266Scheduler\Scheduler.cpp.o] Error 1
.pio\libdeps\d1_mini_pro\ESP Telnet\src\ESPTelnetBase.cpp: In member function 'void ESPTelnetBase::processClientConnection()':
.pio\libdeps\d1_mini_pro\ESP Telnet\src\ESPTelnetBase.cpp:39:32: error: 'using TCPServer = class WiFiServer' has no member named 'accept'
   TCPClient newClient = server.accept();
                                ^
*** [.pio\build\d1_mini_pro\libe9f\ESP Telnet\ESPTelnetBase.cpp.o] Error 1
In file included from src\main.cpp:9:0:
lib\NetworkUtils/NetworkMgr.h: In member function 'bool NetworkUtils::NetworkMgr::resetWifi()':
lib\NetworkUtils/NetworkMgr.h:178:34: error: no matching function for call to 'ESP8266WiFiClass::disconnect(bool, bool)'
       WiFi.disconnect(false, true);
                                  ^
lib\NetworkUtils/NetworkMgr.h:178:34: note: candidate is:
In file included from C:\Users\user\.platformio\packages\framework-arduinoespressif8266\libraries\ESP8266WiFi\src/ESP8266WiFi.h:34:0,
                 from C:\Users\user\.platformio\packages\framework-arduinoespressif8266\libraries\ESP8266WebServer\src/ESP8266WebServer.h:29,
                 from .pio\libdeps\d1_mini_pro\ESP Telnet\src/ESPTelnetBase.h:22,
                 from .pio\libdeps\d1_mini_pro\ESP Telnet\src/ESPTelnetStream.h:9,
                 from src\main.cpp:7:
C:\Users\user\.platformio\packages\framework-arduinoespressif8266\libraries\ESP8266WiFi\src/ESP8266WiFiSTA.h:50:14: note: bool ESP8266WiFiSTAClass::disconnect(bool)
         bool disconnect(bool wifioff = false);
              ^
C:\Users\user\.platformio\packages\framework-arduinoespressif8266\libraries\ESP8266WiFi\src/ESP8266WiFiSTA.h:50:14: note:   candidate expects 1 argument, 2 provided
In file included from src\main.cpp:9:0:
lib\NetworkUtils/NetworkMgr.h: In member function 'bool NetworkUtils::NetworkMgr::connect(bool, unsigned int)':
lib\NetworkUtils/NetworkMgr.h:214:36: error: no matching function for call to 'ESP8266WiFiClass::disconnect(bool, bool)'
         WiFi.disconnect(false, true);
                                    ^
lib\NetworkUtils/NetworkMgr.h:214:36: note: candidate is:
In file included from C:\Users\user\.platformio\packages\framework-arduinoespressif8266\libraries\ESP8266WiFi\src/ESP8266WiFi.h:34:0,
                 from C:\Users\user\.platformio\packages\framework-arduinoespressif8266\libraries\ESP8266WebServer\src/ESP8266WebServer.h:29,
                 from .pio\libdeps\d1_mini_pro\ESP Telnet\src/ESPTelnetBase.h:22,
                 from .pio\libdeps\d1_mini_pro\ESP Telnet\src/ESPTelnetStream.h:9,
                 from src\main.cpp:7:
C:\Users\user\.platformio\packages\framework-arduinoespressif8266\libraries\ESP8266WiFi\src/ESP8266WiFiSTA.h:50:14: note: bool ESP8266WiFiSTAClass::disconnect(bool)
         bool disconnect(bool wifioff = false);
              ^
C:\Users\user\.platformio\packages\framework-arduinoespressif8266\libraries\ESP8266WiFi\src/ESP8266WiFiSTA.h:50:14: note:   candidate expects 1 argument, 2 provided
In file included from src\main.cpp:9:0:
lib\NetworkUtils/NetworkMgr.h: In member function 'bool NetworkUtils::NetworkMgr::setWifiHostname(const char*)':
lib\NetworkUtils/NetworkMgr.h:395:23: error: 'class ESP8266WiFiClass' has no member named 'getHostname'
       if (strcmp(WiFi.getHostname(), hostname) == 0) {
                       ^
lib\NetworkUtils/NetworkMgr.h:399:19: error: 'class ESP8266WiFiClass' has no member named 'setHostname'
       return WiFi.setHostname(hostname);
                   ^
In file included from src\main.cpp:21:0:
.pio\libdeps\d1_mini_pro\ESP8266Scheduler\src/Task.h: In member function 'virtual void Task::yield()':
.pio\libdeps\d1_mini_pro\ESP8266Scheduler\src/Task.h:21:26: error: 'cont_suspend' was not declared in this scope
     cont_suspend(&context);
                          ^
In file included from src\MqttTask.h:2:0,
                 from src\main.cpp:23:
lib\MqttWriter/MqttWiFiClient.h: In member function 'virtual void MqttWiFiClient::stop()':
lib\MqttWriter/MqttWiFiClient.h:13:11: error: 'class MqttWiFiClient' has no member named 'abort'
     this->abort();
           ^
In file included from lib\CustomOpenTherm/CustomOpenTherm.h:2:0,
                 from src\OpenThermTask.h:1,
                 from src\main.cpp:24:
.pio\libdeps\d1_mini_pro\OpenTherm Library\src/OpenTherm.h: At global scope:
.pio\libdeps\d1_mini_pro\OpenTherm Library\src/OpenTherm.h:180:47: warning: 'deprecated' attribute directive ignored [-Wattributes]
     bool sendRequestAync(unsigned long request) {
                                               ^
In file included from src\PortalTask.h:12:0,
                 from src\main.cpp:27:
lib\WebServerHandlers/StaticPage.h:33:8: error: 'bool StaticPage::canHandle(HTTPMethod, const String&)' marked override, but does not override
   bool canHandle(HTTPMethod method, const String& uri) override {
        ^
lib\WebServerHandlers/StaticPage.h:41:8: error: 'bool StaticPage::handle(WebServer&, HTTPMethod, const String&)' marked override, but does not override
   bool handle(WebServer& server, HTTPMethod method, const String& uri) override {
        ^
lib\WebServerHandlers/StaticPage.h: In member function 'bool StaticPage::handle(WebServer&, HTTPMethod, const String&)':
lib\WebServerHandlers/StaticPage.h:52:16: error: 'using WebServer = using ESP8266WebServer = class esp8266webserver::ESP8266WebServerTemplate<WiFiServer>' has no member named '_eTagEnabled'
     if (server._eTagEnabled) {
                ^
lib\WebServerHandlers/StaticPage.h:53:18: error: 'using WebServer = using ESP8266WebServer = class esp8266webserver::ESP8266WebServerTemplate<WiFiServer>' has no member named '_eTagFunction'
       if (server._eTagFunction) {
                  ^
lib\WebServerHandlers/StaticPage.h:54:30: error: 'using WebServer = using ESP8266WebServer = class esp8266webserver::ESP8266WebServerTemplate<WiFiServer>' has no member named '_eTagFunction'
         this->eTag = (server._eTagFunction)(*this->fs, this->path);
                              ^
lib\WebServerHandlers/StaticPage.h:57:22: error: 'calcETag' is not a member of 'esp8266webserver'
         this->eTag = esp8266webserver::calcETag(*this->fs, this->path);
                      ^
lib\WebServerHandlers/StaticPage.h:89:16: error: 'using WebServer = using ESP8266WebServer = class esp8266webserver::ESP8266WebServerTemplate<WiFiServer>' has no member named '_eTagEnabled'
     if (server._eTagEnabled && this->eTag.length() > 0) {
                ^
In file included from src\PortalTask.h:13:0,
                 from src\main.cpp:27:
lib\WebServerHandlers/DynamicPage.h: At global scope:
lib\WebServerHandlers/DynamicPage.h:38:8: error: 'bool DynamicPage::canHandle(HTTPMethod, const String&)' marked override, but does not override
   bool canHandle(HTTPMethod method, const String& uri) override {
        ^
lib\WebServerHandlers/DynamicPage.h:46:8: error: 'bool DynamicPage::handle(WebServer&, HTTPMethod, const String&)' marked override, but does not override
   bool handle(WebServer& server, HTTPMethod method, const String& uri) override {
        ^
In file included from src\PortalTask.h:14:0,
                 from src\main.cpp:27:
lib\WebServerHandlers/UpgradeHandler.h:63:8: error: 'bool UpgradeHandler::canHandle(HTTPMethod, const String&)' marked override, but does not override
   bool canHandle(HTTPMethod method, const String& uri) override {
        ^
lib\WebServerHandlers/UpgradeHandler.h:71:8: error: 'bool UpgradeHandler::canUpload(const String&)' marked override, but does not override
   bool canUpload(const String& uri) override {
        ^
lib\WebServerHandlers/UpgradeHandler.h:79:8: error: 'bool UpgradeHandler::handle(WebServer&, HTTPMethod, const String&)' marked override, but does not override
   bool handle(WebServer& server, HTTPMethod method, const String& uri) override {
        ^
lib\WebServerHandlers/UpgradeHandler.h:97:8: error: 'void UpgradeHandler::upload(WebServer&, const String&, HTTPUpload&)' marked override, but does not override
   void upload(WebServer& server, const String& uri, HTTPUpload& upload) override {
        ^
lib\WebServerHandlers/UpgradeHandler.h: In member function 'void UpgradeHandler::upload(WebServer&, const String&, HTTPUpload&)':
lib\WebServerHandlers/UpgradeHandler.h:138:38: error: 'FS_end' was not declared in this scope
         begin = Update.begin((size_t)FS_end - (size_t)FS_start, U_FS);
                                      ^
lib\WebServerHandlers/UpgradeHandler.h:138:55: error: 'FS_start' was not declared in this scope
         begin = Update.begin((size_t)FS_end - (size_t)FS_start, U_FS);
                                                       ^
lib\WebServerHandlers/UpgradeHandler.h:152:32: error: 'class UpdaterClass' has no member named 'getErrorString'
         result->error = Update.getErrorString();
                                ^
lib\WebServerHandlers/UpgradeHandler.h:169:32: error: 'class UpdaterClass' has no member named 'getErrorString'
         result->error = Update.getErrorString();
                                ^
lib\WebServerHandlers/UpgradeHandler.h:193:32: error: 'class UpdaterClass' has no member named 'getErrorString'
         result->error = Update.getErrorString();
                                ^
In file included from src\main.cpp:27:0:
src\PortalTask.h: In member function 'virtual void PortalTask::setup()':
src\PortalTask.h:76:22: error: 'using WebServer = using ESP8266WebServer = class esp8266webserver::ESP8266WebServerTemplate<WiFiServer>' has no member named 'enableETag'
     this->webServer->enableETag(true);
                      ^
In file included from src\main.cpp:27:0:
src\PortalTask.h: In lambda function:
src\PortalTask.h:371:37: error: 'class ESP8266WiFiClass' has no member named 'getScanInfoByIndex'
         const bss_info* info = WiFi.getScanInfoByIndex(i);
                                     ^
src\PortalTask.h: In lambda function:
src\PortalTask.h:527:48: error: 'esp_is_8285' was not declared in this scope
       doc["system"]["chipModel"] = esp_is_8285() ? "ESP8285" : "ESP8266";
                                                ^
In file included from src\main.cpp:8:0:
.pio\libdeps\d1_mini_pro\TinyLogger\src/TinyLogger.h: In instantiation of 'void TinyLogger::printf(const __FlashStringHelper*, Args ...) [with Args = {const char*, String}]':
.pio\libdeps\d1_mini_pro\TinyLogger\src/TinyLogger.h:299:5:   required from 'void TinyLogger::printFormatted(TinyLogger::Level, ST, bool, MT, Args ...) [with ST = const __FlashStringHelper*; MT = const __FlashStringHelper*; Args = {const char*, String}]'
.pio\libdeps\d1_mini_pro\TinyLogger\src/TinyLogger.h:343:5:   required from 'void TinyLogger::serrorln(ST, MT, Args ...) [with ST = const __FlashStringHelper*; MT = const __FlashStringHelper*; Args = {const char*, String}]'
lib\WebServerHandlers/UpgradeHandler.h:198:112:   required from here
.pio\libdeps\d1_mini_pro\TinyLogger\src/TinyLogger.h:184:9: error: cannot pass objects of non-trivially-copyable type 'class String' through '...'
         stream->printf_P(reinterpret_cast<PGM_P>(msg), args...);
         ^
In file included from src\main.cpp:9:0:
lib\NetworkUtils/NetworkMgr.h: In member function 'bool NetworkUtils::NetworkMgr::setWifiHostname(const char*)':
lib\NetworkUtils/NetworkMgr.h:400:5: warning: control reaches end of non-void function [-Wreturn-type]
     }
     ^
*** [.pio\build\d1_mini_pro\src\main.cpp.o] Error 1
=========================================================================== [FAILED] Took 6.33 seconds ===========================================================================
Environment    Status    Duration
-------------  --------  ------------
d1_mini_pro    FAILED    00:00:06.325
```

Laxilef, 2024-06-13:
> framework-arduinoespressif8266 @ 2.7.4+9

You need to update the framework. Look at the platformio panel under Platforms > Updates.

dee-mos, 2024-06-13:
У меня была такая мысль, но именно в Platform -> Updates ничего не предлагалось. И какие-то апдейты накатывались во время запуска PlatformIO и первой компиляции...
А проблема решилась только ручным удалением старой платформы тут: Paltforms -> Installed- > Espressif 8266  (2.7.4)
с последующей установкой уже самой свежей Espressif 8266 (4.2.1)

Laxilef, 2024-06-13:
Уже внёс изменения в platformio.ini, должно нормально теперь подтягивать версию фреймворка 4.2.1 при сборке прошивки.

Closed 2024-06-19.

Thread 69 (2024-06-14):

BOM.xlsx, не хватает всех Manufacturer Part

RasimKalimullin, 2024-06-14:
Приветствую! хотел заказать pcb с монтажом, но по led(ряды 7-8), резисторам(10-15) и клеммам(23) не хватает Manufacturer Part. Я по ктаалогам попробую подобрать, но боюсь ошибиться, есть возможность добавить? Спасибо

RasimKalimullin, 2024-06-14:
[BOM_SPD.xlsx](https://github.com/user-attachments/files/15841647/BOM_SPD.xlsx)
Было бы хорошо, если проверили компоненты, спасибо!

Laxilef, 2024-06-14:
Резисторы и светодиоды подбираются по наличию в нужном размере (0805) и соответствующего номинала.
Проще брать из Basic списка - они дешевле. Но партномера там могут меняться дважды в день, поэтому в bom их нет и не будет.

Клеммы и прочие выводные детали лучше распаять самостоятельно.

Closed 2024-07-04.

Thread 76 (2024-06-26):

OpenTherm Settings inputs rollback to default after refresh

Quiss, 2024-06-26:
Hello @Laxilef, Thank you for the work, everything is just great.

I encountered a problem where after entering the settings - they are saved on the device, but reset in the settings panel to default values while other parameters remain unchanged. For example, in GPIO I use 7 / out 8, but after saving - I see 13 and 15 again, but the adjustment starts working!

This also applies to switches. It would be convenient to "modify" instead of entering again. Thank you!

Version: | 1.4.2
Env: nodemcu_8266
Date: Jun 15 2024 03:05:50
Core/SDK: 3.1.2

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

Laxilef, 2024-06-26:
Hi @Quiss, thanks!
GPIO 7 and 8 is not valid for nodemcu 8266, see pinout:
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

Most likely you meant D7 and D8, which are equal to GPIO 13 and 15?

Quiss, 2024-07-01:
@Laxilef why? (I don't understand microcontrollers)

When specifying 7 8 everything works, but as I said above - it resets to the default value

 [SmartTherm](https://www.ozon.ru/product/kontroller-kotla-otopleniya-smarttherm-808382394/) usage 7 and 8
https://drive.google.com/file/d/1Wv_77LTP45Vh3wCga1CM9oiGG6yuRg94/view
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

Laxilef, 2024-07-01:
Hi @Quiss,

See pinout
D7 = GPIO13
D8 = GPIO15

Quiss, 2024-07-01:
@Laxilef I'll have to learn this, Thanks!)

Closed 2024-06-26.

Thread 78 (2024-08-20):

Cannot flash Lolin D1 mini v4.0.0

gunarser, 2024-08-20:
I've been using OT GW for quite a while now on my ESP32-S3-DevKitC-1 module. Everything seems to work fine with it.
Yesterday I wanted to finish the testing phase and move the code to a recently acquired Lolin D1 mini v4.0.0 (https://www.wemos.cc/en/latest/d1/d1_mini.html) that has USB C connector.
I downloaded firmware_d1_mini_1.4.3.bin and filesystem_d1_mini_1.4.3.bin files and tried to flash them using Flash Download Tools V3.9.7 but the upload failed.
I tried to change baud rate and different other settings but it continued to fail. If I flashed only the firmware then everything finished fine but I could not connect to the OT GW web interface. The issue seems to be only with filesystem flashing.
I tried to flash another D1 mini module but it failed as well.
What could be the reason for fails and how could I resolve it?
Thanks!

Laxilef, 2024-08-20:
Hi @gunarser,
Maybe you are using the wrong address for the filesystem? What error occurs when writing?

Laxilef, 2024-08-20:
Is there anything connected to the ESP pins at the time of flashing? drivers for CH340 installed?

gunarser, 2024-08-20:
- No, there is nothing connected to the pins. These are brand new modules, nothing is soldered on them. I just tried to flash OT Gateway images.
- Yes, latest CH340 drivers are installed.
- With 115200 baud rate nothing improves.
Tested on both D1 minis. On both it fails with the filesystem image.

Laxilef, 2024-08-20:
Strange, try via Chrome/Edge: https://espressif.github.io/esptool-js/

gunarser, 2024-08-20:
With https://espressif.github.io/esptool-js the same thing, i.e. filesystem flash fails. But it succeeded with https://esp.huhn.me web tool.
Thank you for the suggestion! Now my D1 mini is running the OT GW image and ready for production :)
Perhaps Espressif tools just don't like Windows 11...

Laxilef, 2024-08-20:
> Perhaps Espressif tools just don't like Windows 11...

I also use Win 11, the firmware is written normally using ESP download tool 🤷🏻‍♂️

Closed 2024-08-21.

Thread 81 (2024-09-18):

Boiler goes into fault mode when heating is off

mcmaier, 2024-09-18:
> Please create an issue and upload logs.

Basically the interface seems to work: It reads out values and the burner goes on, when a temperature is set. But when heating is turned off, after a few minutes a fault occures: "External control not available".
Also not sure if settings are correct (master member ID?) Is there a possibility to get more info out of the attached log? Will provide more logs soon.
Thanks in advance.

 [1m[00:05:37] [22m [1m[OT] [22m [1m[TRACE] [22m [m ID:   56   Request: 90383700   Response: 60383700   Attempt:  1   Status: INVALID
 [1m[00:05:37] [22m [1m[OT] [22m [1m[DHW] [22m [1m[WARN] [22m [m Failed set temp
 [1m[00:05:38] [22m [1m[MAIN] [22m [1m[VERB] [22m [m Free heap size: 24488 of 81920 bytes (min: 18976, diff: 0), max free block: 23584 (min: 16152, diff: 0, frag: 3%)
 [1m[00:05:38] [22m [1m[OT] [22m [1m[TRACE] [22m [m ID:    0   Request:      300   Response: c000030a   Attempt:  1   Status: SUCCESS
 [1m[00:05:38] [22m [1m[OT] [22m [1m[TRACE] [22m [m ID:   17   Request:   110000   Response: c0110c00   Attempt:  1   Status: SUCCESS
 [1m[00:05:39] [22m [1m[OT] [22m [1m[TRACE] [22m [m ID:   26   Request: 801a0000   Response: 401a363c   Attempt:  1   Status: SUCCESS
 [1m[00:05:39] [22m [1m[OT] [22m [1m[TRACE] [22m [m ID:   19   Request: 80130000   Response: e0130000   Attempt:  1   Status: INVALID
 [1m[00:05:39] [22m [1m[OT] [22m [1m[TRACE] [22m [m ID:   25   Request: 80190000   Response: c01925f0   Attempt:  1   Status: SUCCESS
 [1m[00:05:39] [22m [1m[OT] [22m [1m[TRACE] [22m [m ID:   28   Request: 801c0000   Response: 401c1cf4   Attempt:  1   Status: SUCCESS
 [1m[00:05:39] [22m [1m[SENSORS] [22m [1m[INDOOR] [22m [1m[TRACE] [22m [m Raw temp: 19.875000
 [1m[00:05:39] [22m [1m[OT] [22m [1m[TRACE] [22m [m ID:   33   Request:   210000   Response: 60210000   Attempt:  1   Status: INVALID
 [1m[00:05:39] [22m [1m[OT] [22m [1m[DHW] [22m [1m[INFO] [22m [m Set temp: 55.00 (converted: 55.00)
 [1m[00:05:40] [22m [1m[OT] [22m [1m[TRACE] [22m [m ID:   56   Request: 90383700   Response: 60383700   Attempt:  1   Status: INVALID
 [1m[00:05:40] [22m [1m[OT] [22m [1m[DHW] [22m [1m[WARN] [22m [m Failed set temp
 [1m[00:05:41] [22m [1m[OT] [22m [1m[TRACE] [22m [m ID:    0   Request:      300   Response: c000030a   Attempt:  1   Status: SUCCESS
 [1m[00:05:41] [22m [1m[OT] [22m [1m[TRACE] [22m [m ID:   17   Request:   110000   Response: c0110c00   Attempt:  1   Status: SUCCESS
 [1m[00:05:41] [22m [1m[OT] [22m [1m[TRACE] [22m [m ID:   26   Request: 801a0000   Response: 401a363c   Attempt:  1   Status: SUCCESS
 [1m[00:05:41] [22m [1m[MQTT] [22m [1m[TRACE] [22m [m Successfully publish 6 of 6 bytes to topic: opentherm/status
 [1m[00:05:41] [22m [1m[OT] [22m [1m[TRACE] [22m [m ID:   19   Request: 80130000   Response: e0130000   Attempt:  1   Status: INVALID
 [1m[00:05:42] [22m [1m[OT] [22m [1m[TRACE] [22m [m ID:   25   Request: 80190000   Response: 40192788   Attempt:  1   Status: SUCCESS
 [1m[00:05:42] [22m [1m[MQTT] [22m [1m[TRACE] [22m [m Successfully publish 704 of 704 bytes to topic: opentherm/state
 [1m[00:05:42] [22m [1m[OT] [22m [1m[TRACE] [22m [m ID:   28   Request: 801c0000   Response: 401c1cd0   Attempt:  1   Status: SUCCESS
 [1m[00:05:42] [22m [1m[OT] [22m [1m[TRACE] [22m [m ID:   33   Request:   210000   Response: 60210000   Attempt:  1   Status: INVALID
 [1m[00:05:42] [22m [1m[OT] [22m [1m[DHW] [22m [1m[INFO] [22m [m Set temp: 55.00 (converted: 55.00)
 [1m[00:05:42] [22m [1m[OT] [22m [1m[TRACE] [22m [m ID:   56   Request: 90383700   Response: 60383700   Attempt:  1   Status: INVALID
 [1m[00:05:42] [22m [1m[OT] [22m [1m[DHW] [22m [1m[WARN] [22m [m Failed set temp
 [1m[00:05:44] [22m [1m[SENSORS] [22m [1m[INDOOR] [22m [1m[TRACE] [22m [m Raw temp: 19.875000
 [1m[00:05:44] [22m [1m[OT] [22m [1m[TRACE] [22m [m ID:    0   Request:      300   Response:        0   Attempt:  1   Status: TIMEOUT
 [1m[00:05:45] [22m [1m[OT] [22m [1m[TRACE] [22m [m ID:    0   Request:      300   Response: c000030a   Attempt:  2   Status: SUCCESS
 [1m[00:05:45] [22m [1m[OT] [22m [1m[TRACE] [22m [m ID:   17   Request:   110000   Response: c0110c00   Attempt:  1   Status: SUCCESS
 [1m[00:05:45] [22m [1m[OT] [22m [1m[TRACE] [22m [m ID:   26   Request: 801a0000   Response: 401a363c   Attempt:  1   Status: SUCCESS
 [1m[00:05:45] [22m [1m[OT] [22m [1m[TRACE] [22m [m ID:   19   Request: 80130000   Response: e0130000   Attempt:  1   Status: INVALID
 [1m[00:05:46] [22m [1m[OT] [22m [1m[TRACE] [22m [m ID:   25   Request: 80190000   Response: c01929cc   Attempt:  1   Status: SUCCESS
 [1m[00:05:46] [22m [1m[OT] [22m [1m[TRACE] [22m [m ID:   28   Request: 801c0000   Response: c01c1cac   Attempt:  1   Status: SUCCESS
 [1m[00:05:46] [22m [1m[OT] [22m [1m[TRACE] [22m [m ID:   33   Request:   210000   Response: 60210000   Attempt:  1   Status: INVALID
 [1m[00:05:46] [22m [1m[OT] [22m [1m[DHW] [22m [1m[INFO] [22m [m Set temp: 55.00 (converted: 55.00)
 [1m[00:05:46] [22m [1m[OT] [22m [1m[TRACE] [22m [m ID:   56   Request: 90383700   Response: 60383700   Attempt:  1   Status: INVALID
 [1m[00:05:46] [22m [1m[OT] [22m [1m[DHW] [22m [1m[WARN] [22m [m Failed set temp
 [1m[00:05:47] [22m [1m[OT] [22m [1m[TRACE] [22m [m ID:    0   Request:      300   Response: c000030a   Attempt:  1   Status: SUCCESS
 [1m[00:05:47] [22m [1m[OT] [22m [1m[TRACE] [22m [m ID:   17   Request:   110000   Response: c0110c00   Attempt:  1   Status: SUCCESS
 [1m[00:05:48] [22m [1m[OT] [22m [1m[TRACE] [22m [m ID:   26   Request: 801a0000   Response: 401a363c   Attempt:  1   Status: SUCCESS
 [1m[00:05:48] [22m [1m[OT] [22m [1m[TRACE] [22m [m ID:   19   Request: 80130000   Response: e0130000   Attempt:  1   Status: INVALID
 [1m[00:05:48] [22m [1m[OT] [22m [1m[TRACE] [22m [m ID:   25   Request: 80190000   Response: c0192b20   Attempt:  1   Status: SUCCESS
 [1m[00:05:48] [22m [1m[OT] [22m [1m[TRACE] [22m [m ID:   28   Request: 801c0000   Response: c01c1cac   Attempt:  1   Status: SUCCESS
 [1m[00:05:48] [22m [1m[OT] [22m [1m[TRACE] [22m [m ID:   33   Request:   210000   Response: 60210000   Attempt:  1   Status: INVALID
 [1m[00:05:48] [22m [1m[OT] [22m [1m[DHW] [22m [1m[INFO] [22m [m Set temp: 55.00 (converted: 55.00)
 [1m[00:05:49] [22m [1m[SETTINGS] [22m [1m[INFO] [22m [m Updated
 [1m[00:05:49] [22m [1m[OT] [22m [1m[TRACE] [22m [m ID:   56   Request: 90383700   Response: 60383700   Attempt:  1   Status: INVALID
 [1m[00:05:49] [22m [1m[OT] [22m [1m[DHW] [22m [1m[WARN] [22m [m Failed set temp
 [1m[00:05:49] [22m [1m[SENSORS] [22m [1m[INDOOR] [22m [1m[TRACE] [22m [m Raw temp: 19.875000

Laxilef, 2024-09-20:
Hi,

Can you upload the logs showing the moment the error occurred?
The logs from the first message were written AFTER the error occurred, right?

Closed 2024-10-10.

Thread 82 (2024-09-26):

HotSpot doesn't appear

maframan, 2024-09-26:
I tried to flash with ESP Flash Download Tool three different esp board (esp8266 d1 mini, nodemcu esp32 s, nodemcu esp32 s3) but in all cases the hotspot doesn't appear. I followed the your guide (https://github.com/Laxilef/OTGateway/wiki#quick-start) and for each board I used the correct filesystem and image file.
For d1 mini: filesystem_d1_mini_1.4.4.bin and  firmware_d1_mini_1.4.4.bin
For nodemcu esp32-s and esp32s3: filesystem_nodemcu_32_1.4.4.bin and firmware_nodemcu_32_1.4.4.factory.bin

Below the ESP Flash tool screenshot:

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

where am I going wrong?

edems88, 2024-09-27:
I have the same thing.

Laxilef, 2024-09-27:
Hi,

You are using the wrong addresses. The firmware file should be written to address 0x0, and the file system to the address as written in the manual:

ESP8266: 0x300000
ESP32: 0x370000

Not the other way around.

maframan, 2024-09-27:
Thanks, You are right

Closed 2024-09-27.

Thread 83 (2024-10-07):

Can not modify boiler values

emgarrote, 2024-10-07:
First of all, I want to thank you for this awesome project.

I have successfully connected my boiler (Ferroli Bluehelix Hitech RRT 28C) to the home assistant by means of the DIYless master opentherm. I can read all the values from the boiler (dwh and heating temperatures, dwh flow rate, pressure, etc).

However, when I try to enable/disable heating or dwh it doesn't work. I also can't modify heating or dwh temperatures. I have tried to change the master member ID, trying all the possible values from 0 to 255, also modifying the summer/winter mode checkbox, with no success.

What can I do? Is it possible to control the heating in on-off mode (as if it were a relay) as long as we do not get the modulating control to work?

Laxilef, 2024-10-08:
Hi,

> trying all the possible values from 0 to 255, also modifying the summer/winter mode checkbox, with no success.

Did you reboot the ESP after changing the member master id?

emgarrote, 2024-10-08:
Hi,

> Did you reboot the ESP after changing the member master id?

No, I didn't. After your message I have tried the numbers (0, 4, 211) restarting after every change with no luck.

> I can publish the code for bruteforce member master id, but you will need to build the firmware and flash your ESP, and then monitor the status through the console. Do you have such an opportunity? Can you handle this?

No problem, I can handle that.
Is there a possibility that this could block the boiler?

Thanks for your help!

Laxilef, 2024-10-10:
> Is there a possibility that this could block the boiler?

No, I haven't encountered anything like that.
Can you upload logs with temperature set? Thx.

emgarrote, 2024-10-10:
I connected the computer to see the logs and I realised that it was actually working with the masterID 0. I thought it wasn't because I was expecting that the values changed inmediately, and it requires like a minute to update. I also realised that if the heating mode is not activated, the heating temperature does not update.

In addition, I thought that the DHW and Heating checkboxes were intended to commute the DWH and heating modes of the boiler, but they don't. To change these modes I need to do it manually in the boiler. Then, checking on the heating in the gateway, once the winter mode is on, it starts heating.

In conclusion, it actually works fine with MasterID code 0 and summer/winter mode disabled. I simply made a mistake expecting it to work differently. I hope this thread will help others with the same question.

Thanks for your help and for this awesome project!

Laxilef, 2024-10-10:
Thanks for the info! Could you upload a screenshot of your opentherm settings to [your message](https://github.com/Laxilef/OTGateway/issues/3#issuecomment-2395169957)?

> In addition, I thought that the DHW and Heating checkboxes were intended to commute the DWH and heating modes of the boiler, but they don't. To change these modes I need to do it manually in the boiler. Then, checking on the heating in the gateway, once the winter mode is on, it starts heating.

Most boilers allow turn on/off heating and DHW via opentherm. Checkboxes on the dashboard page should do this.

Closed 2024-10-10.

Thread 84 (2024-10-09):

Navien NCB-700 firmware 1.4.4

PavelTelnov, 2024-10-09:
Ранее стояла прошивка 1,3,3 показания давления воды были стабильны, После котел ушел в ремонт и на днях запущен. Установил прошивку 1,4,4. Все заработало, но давление периодически показывают 0,08. Потом возвращается.
Подскажите что это ?
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

PavelTelnov, 2024-10-09:
Ответ получил в группе, тему можно удалить.

Closed 2024-10-09.

Thread 85 (2024-10-18):

Does anyone know about a pre-build solution like this?

ovizii, 2024-10-18:
Sorry to open an issue for this simple question, but it seems discussions are not active on this GitHub project.
I'd like to give this a try with my Bosch GC2200 W boiler, but I have zero skills for soldiering and electronics in general.

Is anyone aware of a place to buy this all pre-soldiered in a nice case ready to use? I am able to connect to it and flash new firmware versions, but anything concerning electronics and wires makes me hesitant.

Btw. I found some semifinished products with their own firmware solution, so the next question is, could your firmware be compatible with that hardware?

https://diyless.com/product/esp8266-opentherm-gateway
https://3dstar.ro/esp-opentherm-v12-ae

Laxilef, 2024-10-18:
Hi,
Of course you can use ready-made solutions. I recommend you to look at this:
https://diyless.com/product/opentherm-thermostat

Laxilef, 2024-10-18:
Are you sure your boiler supports opentherm? Bosch usually uses EMS bus.

Closed 2024-10-21.

Thread 86 (2024-10-20):

Communication Error Opentherm Gateway to OEM Thermostat

maxmilan, 2024-10-20:
Hi there,

first of all (you heared it too many times but hey thats it) congrats and very big thank you for this far sophisticated software for Opentherm! I suppose you help a lot of people outside there to safe energy and safe the planet.

I have a Broetje Boiler BOK (Oil) central heater which communicates to a Opentherm Thermostat "OT RGI" which is basically "Siemens QAA73.210". I bought a Opentherm Gateway from diyless to reach the boiler, I complete it with an ESP S2 and connect it via WLAN to Homeassistant. So far i can reach it and can read out most values. (at least what the boiler can - it is a bit of a low cost boiler... I didnt bought it, i have to take it...)

My problem is now that the Room Thermostat (OT RGI) shows Error 88E what is regarding to manual is a communication failure. I belive it has to do with the Master Member ID. I tried out around different IDs (0-25, 50-60, 110,-115, even over 300...) but nothing changes. DUring the procedure the boiler runs amok due and "boil" everything and everybody. You mention to "bruteforce" it, but also that there is a flash file available to bruteforce it via the ESP. I think the ID has to be inside 0-255? am I right?

or could be there another failure that the gateway didnt passthrough the communication to the thermostat?
I would appreciate you help very much, since i really like to use you code to check the personal life of my boiler.

best regards
Max

Laxilef, 2024-10-20:
Hi,

Thanks! Did I understand correctly that you want to use opentherm thermostat and esp together? If yes, then it is not supported by firmware.
The problem is that the OpenTherm protocol only requires one master thermostat on bus. That is, you can use either the ESP thermostat or the "OT RGI" thermostat, but not both.
The only possible option is to connect the ESP in the gap, that is, the ESP must emulate the slave and transmit commands to the boiler.
Same issue: https://github.com/Laxilef/OTGateway/issues/28

maxmilan, 2024-10-21:
Okay I just saw you answered as well on GitHub to my question.
In a nutshell:
I want between my heater and thermostat the ot gateway like the I understood from pictures of diyless.com. I want continuously using my thermostat and also, if necessary alter the value, FX temperatures for roo or domestic hot water via HA. Isn't it that what a gateway do? Sitting between master and slave, monitore and alter the values?
BR Max

Am 20. Okt. 2024, 21:30, um 21:30, Yurii ***@***.***> schrieb:
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

maxmilan, 2024-10-21:
Hi Laxilef,

soo thank you for your explanation. I think you are right and it seems beside all what I read before in advance I missed that what I was aiming for is not possible so far. Pity but thats life - next time i read the documentation even deeper and from the beginning. Thank you I learned a lot about heaters from your project and how thing work out.

Sorry about the confusion I bring up but thank you for answering fast and precisely to all of you!
Big up again for the project and I will stare now into the fire and invent a new solution for my problem (like we and ancestors homo sapiens did last 20k years...)

all the best and maybe with my next heater and or habitat I will use this repo here.
Beside if I find a solution to my problem I give you a hint here, but so far you can close this issue here.
thx BR Max

Laxilef, 2024-10-21:
> Sitting between master and slave, monitore and alter the values?

If we change any value in the home assistant and transmit it to the boiler, then your thermostat (Siemens) will overwrite it with its own. For example, if you set the heating temperature to 60 degrees via the home assistant, we cannot tell the master "now the heating temperature is 60 degrees", because he is the master. In other words, when installing the ESP in the gap between the boiler and the thermostat (Siemens), the ESP will be the master for the boiler, and the master for the ESP will be your thermostat (Siemens).

This project and home assistant can do the same thing as your thermostat and can be controlled with an HMI panel or android tablet on the wall. If you are interested, I can take a photo of how it was done in my case.

maxmilan, 2024-10-22:
okay then I understood the Opentherm from the beginning wrong, or at least what wikipedia tells about Opentherm 3.0
I thought I can work on it Multi Point-to-point and can accept more than one master. I figured also out how this is meant: There is an additional shield (board) for my heater with what I can extent the system in terms of more heating circuits, sensors, pumps, valves etc. and there are also additional connectors for OT (at least plus 3 I suppose). So it seems if Id like to use your solution i have to add this board or remove the siemens thermostat, which I want to use as a backup in case that ESP or Homeassistant fails in the middle of the winter....

I would be very interested in the project you told with the android tablet or the HMI panel (? I dont know what it is; a human interface?) at least as long as it did not make you any trouble, so i could get some ideas from it how it could look like also instead of using the OT RGI Siemens...

Laxilef, 2024-10-23:
> I would be very interested in the project you told with the android tablet or the HMI panel (? I dont know what it is; a human interface?) at least as long as it did not make you any trouble, so i could get some ideas from it how it could look like also instead of using the OT RGI Siemens...

I use a wall-mounted [tablet yc-sm10p](https://portworld-solu.com/portfolio-item/yc-sm10p-10-1-smart-home-poe-touch-control-panel/), you can buy it on aliexpress. I installed the [Fully Kiosk Browser app](https://www.fully-kiosk.com/) on tablet, which always displays the home assistant dashboard in full-screen mode.
The tablet dashboard displays thermostats for temperature control. Everything else is done by automation in the home assistant without my participation.

Screenshot of the dashboard for tablet:
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

I'll add a photo on the weekend.

JoyceKimberly, 2024-10-27:
> okay then I understood the Opentherm from the beginning wrong, or at least what wikipedia tells about Opentherm 3.0 I thought I can work on it Multi Point-to-point and can accept more than one master. I figured also out how this is meant: There is an additional shield (board) for my heater with what I can extent the system in terms of more heating circuits, sensors, pumps, valves etc. and there are also additional connectors for OT (at least plus 3 I suppose). So it seems if Id like to use your solution i have to add this board or remove the siemens thermostat, which I want to use as a backup in case that ESP or Homeassistant fails in the middle of the winter....

I also understood this to be the way a "gateway" is supposed to work. The basic code examples from both Diyless and Ihormelnyk also show this to be possible.

To be fair, as great as this project is, it is a thermostat replacement, not a gateway, and really shouldn't be called a gateway to prevent confusion.

Other than that this really is a great project 👍

Laxilef, 2024-10-28:
Hi @JoyceKimberly
I wrote above why this will not work correctly. The slave (ESP) cannot override the values   on the master (existing thermostat).
Ihor Melnyk examples [use transparent/proxy control](https://github.com/ihormelnyk/opentherm_library/blob/master/examples/OpenThermGatewayMonitor_Demo/OpenThermGatewayMonitor_Demo.ino) of the master (thermostat) by the boiler (slave) via ESP.

dafik, 2024-11-08:
there is another project that acts as a proxy between the thermostat and the boiler and can overwrite the thermostat messages.

https://otgw.tclcode.com/ the assembled version is available on nodo.nl

Thread 87 (2024-10-24):

Ideal Logic Heat2 H18: Can enable/disable heating but unable to set heating temperature

grapefruitmanor, 2024-10-24:
Hi,

### Problem
I have an Ideal Logic Heat2 H18 heat-only boiler and, with the default settings, I am able to enable and disable the heating but am unable to change the target heating temperature; the target temperature shown on the boiler LCD display never changes and it fires only up to the displayed temperature rather than the one requested via the UI.
I see that very few sensor parameters are populated, with most remaining at zero (modulation, fault and diagnostic codes, heating temp and return temp, flame and fault are the only parameters which I have seen to change during operation).

I'm running on a Wemos C3 mini using Ihor Melnyk's OpenTherm adapter.

### Investigation
System:
```
Version: 1.4.5
Build:
Env: c3_mini
Date: Oct 13 2024 23:00:20
Core/SDK: v5.1.4-828-g33fbade6b8-dirty
Uptime: 0 days, 0 hours, 37 min., 2 sec.
Free memory:
69152 of 278280 bytes (min: 37688 bytes)
max free block: 45044 bytes (min: 28660 bytes)
Board:
Chip: ESP32-C3 (rev. 4)
Cores: 1, frequency: 160 mHz
Flash size: 4 MB (real size: 4 MB)
```
OpenTherm diagnostic reports the following:
```
Vendor:          ATAG/Brötje/ELCO/GEMINOX
Member ID:       4
Flags:           64
Type:            172
Version:         1
OT version:      4.097656
Heating limits:  30...80 °C
DHW limits:      30...60
```

I've tried several different Master MemberID codes (from 0 to 15: restart after each change, enable heating, change target temperature in the UI, wait for 1 minute then check temperature reported on boiler LCD display) with no success in changing the target temperature. I've also tried every combination of Summer/winter mode, Heating CH2 always enabled, and duplicate heating CH1 to CH2, again restarting after each change. Currently, only 'heating CH2 always enabled' is checked and Master MemberID code is set to `0`.

With heating enabled, the following regular traces are seen via Telnet (I have DHW disabled because it's a heat-only boiler):
```
[00:15:04][OT][TRACE] ID:    0   Request:     1100   Response: c0001100   Attempt:  1   Status: SUCCESS
[00:15:05][OT][TRACE] ID:   25   Request: 80190000   Response: c019260c   Attempt:  1   Status: SUCCESS
[00:15:05][OT][TRACE] ID:   28   Request: 801c0000   Response: c01c1710   Attempt:  1   Status: SUCCESS
[00:15:05][OT][TRACE] ID:   33   Request:   210000   Response: 60210000   Attempt:  1   Status: INVALID
```

When sending a new target temperature request via the UI, the following Telnet traces are seen:
```
[00:14:53][PORTAL][WEBSERVER][TRACE] Request /api/settings 88 bytes: {"heating":{"enable":true,"turbo":false,"target":40},"dhw":{"enable":false,"target":60}}
...
[00:15:00][REGULATOR][INFO] New target: 40.00
...
[00:15:01][OT][HEATING][INFO] Set temp: 40.00 (converted: 40.00)
[00:15:02][OT][TRACE] ID:   57   Request: 90392800   Response: 60392800   Attempt:  1   Status: INVALID
[00:15:02][OT][HEATING][WARN] Failed set max heating temp
[00:15:02][OT][TRACE] ID:    1   Request: 10012800   Response: d0012800   Attempt:  1   Status: SUCCESS
```

### Questions
- Since I can enable/disable heating, does that mean that the master member ID is likely correct?
- Is there a way to definitively determine if the boiler has accepted the configured master member ID?
- Does a status of `SUCCESS` for ID `1` indicate that the boiler in theory accepted the new target temperature?
- Something I don't understand is that ID `1` should be formatted `f8.8` according to the spec but, with a target of 40 °C, I can't work out how `0x10012800` corresponds with that - I assumed it would be `40 << 8 = 0x10240`.

At the moment I'm not sure how to diagnose the issue further so would appreciate any help you can provide.

Thanks in advance for your help - I'm very excited to get this working and appreciate all the hard work done by everyone on this project!

Laxilef, 2024-10-24:
Hi,

> Since I can enable/disable heating, does that mean that the master member ID is likely correct?

Most likely yes.

> Is there a way to definitively determine if the boiler has accepted the configured master member ID?

Typically, boilers respond with INVALID status to ID 1 request, or the setpoint temperature does not actually change and heating cannot be turned on/off. That is, you can read parameters, but not write them.

> Does a status of SUCCESS for ID 1 indicate that the boiler in theory accepted the new target temperature?

dlduk, 2024-10-24:
Thanks for your quick response.

Good to know that the first hurdle of master member ID is most likely OK since I can turn on and off heating.

>0x2800 = 10240 (dec)
>10240 / 256 = 40
Of course, my mistake - thanks for clarifying.

Both equitherm and PID are disabled  - I left most settings at their default, other than adding MQTT, outdoor and indoor sensor support, and disabling 'DHW present'. I had previously tried toggling that and didn't see a difference.

I'm confused as to why the boiler would accept the new target temperature but not update the LCD display and not attempt to use the new target temperature.

grapefruitmanor, 2024-10-24:
Thanks for your quick response.

Good to know that the first hurdle of master member ID is most likely OK since I can turn on and off heating and ID 1 response was SUCCESS.

>0x2800 = 10240 (dec)
10240 / 256 = 40

Of course, my mistake - thanks for clarifying.

Both equitherm and PID are disabled - I left most settings at their default, other than adding MQTT, outdoor and indoor sensor support, and disabling 'DHW present'. I had previously tried toggling that and didn't see a difference.

I'm confused as to why the boiler would accept the new target temperature but not update the LCD display and not attempt to use the new target temperature.

Laxilef, 2024-10-24:
> Both equitherm and PID are disabled - I left most settings at their default, other than adding MQTT, outdoor and indoor sensor support, and disabling 'DHW present'. I had previously tried toggling that and didn't see a difference.

I meant the settings in the boiler service menu. Look at this:
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
[Logic_Heat2_Installation___Servicing_-_07.2023_UIN_228298_A06.pdf](https://github.com/user-attachments/files/17508973/Logic_Heat2_Installation___Servicing_-_07.2023_UIN_228298_A06.pdf)

If you have the curve mode enabled on the boiler, the boiler operates in a different mode and it expects the room temperature setting, not the coolant temperature setting.

> but not update the LCD display

In fact, this is normal; when connecting opentherm devices, the setpoint temperature is usually not displayed and does not change on the boiler display.

grapefruitmanor, 2024-10-24:
Weather compensation is automatically enabled/disabled on the detection of an external sensor on the weather compensation boiler terminals (see [the weather compensation kit installation manual](https://idealboilers.ie/uploads/documents/[Weather_Compensation_Kit_Installation_Guide.pdf](https://idealboilers.ie/uploads/documents/Weather_Compensation_Kit_Installation_Guide.pdf))) so I can't change it via the service menu.

>In fact, this is normal; when connecting opentherm devices, the setpoint temperature is usually not displayed and does not change on the boiler display.

That's surprising to me - now I know not to use that as a guide.

My expectation was that if I set to the target heating temperature to, e.g. 40 °C with a current heating temp of 28 °C, then the boiler would fire up to 40 (with some overshoot) then hold this new temperature, meaning in the gateway UI I should see 'Heating temp' showing this behaviour, and I should see/hear the boiler firing to meet the new target. Is that correct?

I'll do some more observations on 'heating temp' while setting different target temperatures and report back with the log data.

Laxilef, 2024-10-24:
> Weather compensation is automatically enabled/disabled on the detection of an external sensor on the weather compensation boiler terminals (see [the weather compensation kit installation manual](https://idealboilers.ie/uploads/documents/%5BWeather_Compensation_Kit_Installation_Guide.pdf%5D(https://idealboilers.ie/uploads/documents/Weather_Compensation_Kit_Installation_Guide.pdf))) so I can't change it via the service menu.

Okay, do you have an external sensor connected?

> My expectation was that if I set to the target heating temperature to, e.g. 40 °C with a current heating temp of 28 °C, then the boiler would fire up to 40 (with some overshoot) then hold this new temperature, meaning in the gateway UI I should see 'Heating temp' showing this behaviour, and I should see/hear the boiler firing to meet the new target. Is that correct?

Yes, the boiler should start heating and maintain the setpoint temperature, but the boiler display may not change the setpoint temperature.

grapefruitmanor, 2024-10-24:
Sorry, I should've mentioned (that's the problem with your head deep inside a task): no, I don't have an external sensor connected.

Laxilef, 2024-10-24:
Then this is really strange :)

grapefruitmanor, 2024-10-24:
Oo, no, I had the knob set to 30 °C, thinking OpenTherm would be able to override whatever it's set to. Is it common for boilers to behave like that? Did you discover this by chance?
It strikes me as very odd. Regardless, increasing the display temperature to 80 will be the first thing I do when I next get chance to test this. Fingers crossed this is what has been blocking it!

Laxilef, 2024-10-24:
I saw similar behavior on the Bosch Gaz 6000. The temperature set on the boiler panel was the maximum temperature that could be set via Opentherm.
But there it was displayed correctly in the "OpenTherm diagnostic" section.

critictidier, 2024-10-25:
> Did you discover this by chance?

I did indeed 🫠 good luck 🤞

grapefruitmanor, 2024-10-25:
I just tested turning the boiler's own target temperature up to 80 °C via the physical knob, then set a few target temperatures via OpenTherm and I'm pleased that it's now working as expected, so a big thank you to both of you for your help in getting it working! 😄
The OpenTherm diagnostic never updates with the value set by the knob.

A lot of useful information has come out of this investigation which I couldn't find documented anywhere in the Wiki:
- The target temperature set by OpenTherm is often not displayed/updated on the boiler display
- Some boilers require the target temperature on the panel to be set to at least the maximum expected to be set by OpenTherm, acting as a hard limit on the OpenTherm requests
- Some boilers report the target temperature on the panel as the max heating limit in OpenTherm diagnostic
- The heating must be enabled before the controller will issue a target temperature request to the boiler
- Checking for a `SUCCESS` response to ID `1` in the logs indicates that the master member ID is probably correct
- `(ID_1_request & 0xFFFF) / 256d` = requested target temperature in °C

What is your policy regarding Wiki edits? I'd be happy to add the information above to the FAQs page if that's OK. I think it may help others who face this confusing situation and prevent some simple issues like this from being raised. I'd also like to update the boiler compatibility list for my boiler (if added, that would mean 3 Ideal boilers in 'Other' so maybe at that point it would be worth having an 'Ideal' section).

Also, I have an external pump and would like to be able to drive it via a Shelly relay and HA's Shelly integration, rather than having some GPIO>Bluetooth transmitter to HA, but that means I need the external pump GPIO state published over MQTT and I couldn't find it in any of the entity lists (I have it enabled on the gateway). Am I right in assuming that the state currently isn't published? I do wonder if the 5+ sec delay via MQTT>HA>relay activation might be too slow for the boiler and throw a fault due to heating on but no flow (I saw this happen sometimes during my testing if I had the pump disabled and heating on).

Laxilef, 2024-10-25:
> What is your policy regarding Wiki edits?

I'll be glad if you do it :)

> Also, I have an external pump and would like to be able to drive it via a Shelly relay and HA's Shelly integration, rather than having some GPIO>Bluetooth transmitter to HA, but that means I need the external pump GPIO state published over MQTT and I couldn't find it in any of the entity lists (I have it enabled on the gateway). Am I right in assuming that the state currently isn't published? I do wonder if the 5+ sec delay via MQTT>HA>relay activation might be too slow for the boiler and throw a fault due to heating on but no flow (I saw this happen sometimes during my testing if I had the pump disabled and heating on).

You can turn on an additional pump by the event of turning on the ``binary_sensor.opentherm_heating`` sensor in the home assistant.

critictidier, 2024-10-26:
> I'm pleased to say that it's now working as expected, so a big thank you to both of you for your help in getting it working!

Congratulations 🥳 we have very similar boiler model, you might also find my “wiki” useful https://github.com/Alexwijn/SAT/discussions/40

grapefruitmanor, 2024-10-26:
> Congratulations 🥳 we have very similar boiler model, you might also find my “wiki” useful [Alexwijn/SAT#40](https://github.com/Alexwijn/SAT/discussions/40)

In fact, it seems we also have a very similar house configuration (S plan, two CH zones, one hot water cylinder).
SAT is very interesting to me, though it looks like it's only compatible with the OTGW firmware, at least trying to control via MQTT. How are you running it?

critictidier, 2024-10-26:
Yes, it’s that firmware. There is more ongoing development if you read around ESPhome, SAT and adapters like yours. All these projects including this one are wonderful. They all take our heating systems to the next level! 🥰

Laxilef, 2024-10-27:
Hi @grapefruitmanor

I have made the wiki available for editing. If you're still ready - welcome.

grapefruitmanor, 2024-10-27:
> Hi @grapefruitmanor
>
> I have made the wiki available for editing. If you're still ready - welcome.

Great, thanks. I've been busy today and yesterday so I planned to make the edits tomorrow when I should have some time.

grapefruitmanor, 2024-10-29:
The Wiki edits are all done on the Compatibility and FAQ pages so at least I've been able to give something small back 😄

One last question (which may end up with another FAQ contribution...): it looks like I can enable both PID and equitherm simultaneously but are they opposing concepts or can they work in parallel?
I would've thought that normally they oppose each other because load compensation is inherently reactive whereas weather compensation is proactive, i.e. when the outdoor temperature starts to drop but the internal temperature is unchanged, weather compensation would request a higher setpoint whereas PID would not.

Am I right in thinking that the K and T equitherm coefficients apply a level of PID-like behaviour by modifying the curve to account for steady-state error (in the case of K, behaving like an integral term) and response time (in the case of T, behaving like a derivative term)?

My house is only 2 years old and supposedly very energy-efficient, yet I found that with heating target set to 20 °C, N=1.0 is required to keep the temperature at 20 ± 0.5 °C (though I do keep window trickle vents open which will presumably account for some heat loss), whereas I was expecting closer to 0.7 or less as your description suggests. All radiator TRVs are set to ~22 °C and zone thermostats to 23 °C, ensuring that the pump and radiators are all running constantly without restriction. It's no big problem but it is curious to me.

Laxilef, 2024-10-29:
Thank you for your contribution! :)

Equtherm and PID actually work differently:
- Equtherm calculates the temperature using an algorithm based on outdoor temperature and makes a correction based on the indoor temperature (T coefficient). The algorithm is not very complicated, take a [look at the code](https://github.com/Laxilef/OTGateway/blob/master/lib/Equitherm/Equitherm.h). Briefly:
N - curve, K - curve slope, T - thermostat error correction.
- The PID adjusts the temperature so that the indoor temperature is equal to the setpoint.

When using both modes, PID replaces the correction for the thermostat error (coefficient T). The influence of PID on the calculated temperature from Equtherm can be limited by the PID max temperature parameter.

**Example:**
The maximum PID temperature is set to 10 degrees.
Equtherm has calculated a temperature of 40 degrees, but the indoor temperature is below the set point (for example, a powerful hood is running or the windows are open).
The PID will change +- 10 degrees for 40 degrees. That is, the final temperature can be from 30 to 50 degrees.

> My house is only 2 years old and supposedly very energy-efficient, yet I found that with heating target set to 20 °C, N=1.0 is required to keep the temperature at 20 ± 0.5 °C (though I do keep window trickle vents open which will presumably account for some heat loss), whereas I was expecting closer to 0.7 or less as your description suggests. All radiator TRVs are set to ~22 °C and zone thermostats to 23 °C, ensuring that the pump and radiators are all running constantly without restriction. It's no big problem but it is curious to me.

The coefficients for Equtherm are selected empirically, since there are many factors: different insulation technologies, many large windows, powerful ventilation (exhaust), etc.

> Oh, and I couldn't find a description for how turbo mode for heating works.

Turbo mode is only relevant when using only Equtherm, it simply temporarily [increases](https://github.com/Laxilef/OTGateway/blob/11b1277d79581a4420501c0be3c0533d5525bb4a/src/RegulatorTask.h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) the T coefficient to 10.

robbaker92, 2024-11-11:
> Is the physical temperature knob turned to at least the temperature you require? I have an ideal logic h24 and the physical knob always takes priority over what opentherm requests.

This is true of Ideal c30 model also.

Closed 2024-12-02.

Thread 88 (2024-10-29):

Частые "Software reset due to exception/panic"

upais, 2024-10-29:
Добрый день.
Начал замечать, что контроллер падает\ребутается каждые несколько часов. Раньше тоже было, но редко, может 1-2 в месяц.
Причина: Software reset due to exception/panic

Отладку включил, консолью подключился, но отловить довольно проблемно. Как-то еще можно диагностику провести?

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

Laxilef, 2024-10-29:
Здравствуйте, попробуйте бету.
[build.zip](https://github.com/user-attachments/files/17562652/build.zip)

upais, 2024-10-30:
Неа, тоже самое, причина только: Reset due to other watchdogs
До прошивки беты решил еще раз прошить 1.4.5, т.к. падать стал каждые 3-7мин. На Бете вроде реже, ночью даже 4 часа проработал. Настройки не менялись, после перепрошивки восстанавливал бэкап двухнедельной давности.
[debug (1).json](https://github.com/user-attachments/files/17566846/debug.1.json)
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

Laxilef, 2024-10-30:
Спасибо за логи. А какой датчик ble используете?

upais, 2024-10-30:
LYWSD03MMC на прошивке pvvx.
С ним тоже ничего не менялось.

Laxilef, 2024-10-30:
Ок, попозже выложу новый билд для тестов.

upais, 2024-10-30:
Есть подозрения, что падает из-за взаимодействия с BLE датчиком?
Я недавно переключил на MQTT, пока не показатель, но вот 2 часа не падает.

Кстати, а возможно, чтобы при старте контроллер опрашивал датчик и получал актуальную температуру? Либо хотя бы запоминал последнюю, если датчик невозможно принудительно опросить. А то основная проблема падений, это то что после старта контроллер считает, что на внутреннем датчике 0гр, а датчик может долго не передавать новые данные (у меня было более часа), то котел греет и греет.

upais, 2024-10-30:
Да вроде должна быть нормальная связь, я его и перемещал ближе, там метров 4-5 через стену.
Попробую ему мощность увеличить, интереса ради.
А так, по mqtt уже более 5 часов.

Laxilef, 2024-10-30:
Попробуйте с этим билдом
[build.zip](https://github.com/user-attachments/files/17580063/build.zip)

На качество связи с датчиком, однако, это не повлияет, только должно устранить краши.

upais, 2024-10-31:
Предположительно, решилась проблема. Порядка 1,5 часов работало без падений, а в логах сообщения, что не удалось подключиться к BLE датчику. Я решил изменить ему мощность, она дефолтовая стояла и тоже не смог подключится, далее вынул батарейку и больше он с ней даже не включился. Похоже из-за низкого заряда датчик подглючивало. Хотя когда это началось датчик передавал данные примерно так же оперативно как и раньше.

Laxilef, 2024-10-31:
> Порядка 1,5 часов работало без падений

Я так и не понял, вы последний билд прошили или нет?

upais, 2024-10-31:
Конечно, это с ним 1,5 часа проработало. По этому и говорю, что скорей всего, проблема решена. Хоть 1,5 часа не много, но на предыдущих падало каждые 5-15мин.

Laxilef, 2024-10-31:
Хорошо. Понаблюдайте еще, если все хорошо, то можете закрыть issue.

upais, 2024-11-01:
Большое спасибо за оперативную помощь!

Closed 2024-11-01.

Thread 89 (2024-11-09):

OTGateway keeps on crushing and rebooting on hardware watchdog (memory leakage?)

abratchik, 2024-11-09:
Testing the latest release:

Version	1.4.5
Build	Env: nodemcu_8266
Date: Oct 13 2024 22:57:22
Core/SDK: 3.1.2
Uptime	0 days, 0 hours, 0 min., 29 sec.
Free memory	23400 of 81920 bytes (min: 23400 bytes)
max free block: 22992 bytes (min: 18368 bytes)
Board	Chip: ESP8266 (rev. 0)
Cores: 1, frequency: 80 mHz
Flash size: 4 MB (real size: 4 MB)
Last reset reason	Hardware Watchdog

Looks like the board is restarting continuously by the hardware watchdog. I could be wrong but it seems like a memory leakage. Whenever the minimum is reached the board is restarted.

Laxilef, 2024-11-10:
Hi,
There is very little information to localize the problem.
How often do restarts happen? Can you upload logs?

abratchik, 2024-11-11:
Hmm, I tried it on a different power source, worked more stable. Seems like not related to the code, sorry. Closing the issue

Closed 2024-11-11.

Thread 90 (2024-11-12):

Viessmann. Radiators upstairs, underfloor heating downstairs

Daveblanche, 2024-11-12:
Hi there
The gateway works well, but I am struggling to figure out how to allow the radiators upstairs to call for heat from the boiler. The radiators are controlled by tado and the extension box is worded in as a standard on/off relay based on the call for heat from the thermostats upstairs.
It’s not on opentherm.
The underfloor heating (I presume is channel2?) works fine but seems to run the show.
I don’t *think* this was the case before OpenthermGateway. I think the rads were able to call for heat via the tado relays.
what do the channel 1 and 2 controls actually do?

Daveblanche, 2024-11-12:
To be fair, it is probably a non issue once I have the heatcurve tuned to the Heatloss….the boiler/heating will constantly have warm water for the radiators…which run in a temperature limited state. They are upstairs and run at 18c instead of 20c downstairs in the ufh.

Laxilef, 2024-11-12:
Hi,

To be honest, I didn't understand anything. What is the question?

Daveblanche, 2024-11-12:
The radiators upstairs don’t seem able to call for heat. They are controlled by tado via simple relay switching (old school). Tado controls dhw  and this is fine.
the downstairs is controlled by the secondary circuit, underfloor heating. It works fine.
what do the channel options in opentherm settings in this project do? Can I arrange things via settings that means that the radiators can call for heat/flame/modulation from the boiler?

Laxilef, 2024-11-13:
Can you draw a diagram of your heating system and how it is connected to the boiler?
And what is the model of your boiler?

The firmware uses the second channel, but it duplicates the parameters from the first channel.

Laxilef, 2024-11-13:
I meant the hydraulic diagram and the diagram of connecting Tado to the boiler.

Daveblanche, 2024-11-14:
I have an admission to make. I’m normally quite intelligent but not this time.
My system is set up as priority dhw.
I had the gateway dhw on all the time, via the checkbox, so my radiators wouldn’t heat up.
I missed that point.
Obviously they got colder more quickly than the underfloor heating so I focussed on the radiators in my first post.
It took me a while to realise that „duplicate ch2 to dhw“ actually means set (or mirror) dhw onto ch2 in the gateway.
Funnily enough, I ran out of hot water yesterday. Once set so that ch2 is recognised by the system as dhw, it all started working…. Immediately.
This is my fault and nothing to do with the gateway you developed: which is awesome and now working beautifully.
Thank you so much for the offer of support, but I was just being slow.
D

Laxilef, 2024-11-14:
If the problem is solved and you don't need my help, you can close it :)

Daveblanche, 2024-11-14:
Veissmann 100w-B1hc  30Kwh limited to 14Kwh max Output, system boiler with priority dhw.
300l water tank.
Previously installed weather compensation sensor and demand box for dhw. Weather sensor works with OpenthermGateway being reported via opentherm.
Heating upstairs: radiators x10 with Tado thermostats on wall and radiators.
Heating downstairs: 120sqm of underfloor heating running through a Heatmiser system and standard  hot opentherm) manifold and controller.

mistakes I made:
Going to quickly with changes to equitherm basic co-efficient. It does take patience.
I left dhw on constantly in the checkbox….which meant my heating didn’t work (priority dhw- foolish mistake)
I didn’t duplicate channel 2 to dhw via the checkbox. I misunderstood what duplicate meant for someone who might not use English as a first language. My issue, not anyone else’s.

Settings:
Equitherm basic co-eff is 3.5 but I might have to drop this a little tomorrow.
Haven’t yet tuned the other two but time constant will probably be 2 and delta (k) will be 2 or 3.
Heating: hysteresis is 0.1. min is 20c max is 65c. Max modulation is 38.
I altered the customize.yaml to give 0.1c changes in temp because my wife is VERY fussy on temperature.

Opentherm settings: (checked boxes)
Dhw present
Duplicate dhw to ch2
Sync modulation with heating
I unchecked get max and min from heater as my Veissmann froze on those a couple of times. But the gateway is far more advanced than the boiler, so I see no issue (yet)

Thank you for the offer of help.
All closed!

Closed 2024-11-14.

Thread 91 (2024-11-12):

Where can I find the MQTT set topics/commands

Imaginous, 2024-11-12:
I want to use the OTGateway with my own domotica software.

I searched, but I couldn't find a list of MQTT commands I can send to set the wanted heating temperature, the wanted DHW temperature, the current room temperature and the current outside temperature.

Probably I didn't look hard enough, but if anyone can point me in the right direction ;)

Laxilef, 2024-11-12:
Hi,

``prefix/setttings``
``prefix/setttings/set`` - any values   as in ``prefix/settings``

``prefix/state``
``prefix/state/set`` - any values:
```json
{
  "actions": {
    "resetDiagnostic": true,
    "resetFault": true,
    "restart": true
  },
  "temperatures": {
    "indoor": 1.0,
    "outdoor": 1.0
  }
}
```

Imaginous, 2024-11-12:
Thank you for the quick response.

menyuguren, 2025-07-03:
"I used opentherm/settings/set to modify:
{
  "master": {
    "heating": {
      "targetTemp": 55,
      "setpointTemp": 55
    }
  }
}
But it didn’t work, and I received the error message: SyntaxError: Unexpected end of JSON input."

Closed 2024-11-12.

Thread 92 (2024-11-13):

Boiler Immergas Victrix Zeus 25

VladaWaas, 2024-11-13:
Actualy status:
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
This is compatible points with OpenTherm:
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
Could you add points: 19,77 and 85 to your firmware?
Thank you in adwance.
Vladimir

Laxilef, 2024-11-13:
Hi,

ID 19 - DHW flow rate, it is already supported.
What do ID 77 & 85?

VladaWaas, 2024-11-13:
Hello,
thx for fast respose. ID flow rate is permanently zero on interface. Can I any mistake in my setup?
ID 77 represented intake relative ventilation level 0-100%
ID 85 represented actual inlet fan speed in rpm

Laxilef, 2024-11-13:
I will add polling ID 85 to the new version.

https://github.com/Laxilef/OTGateway/wiki#fit-coefficients

Laxilef, 2024-11-13:
> ID19- flow rate is permanently zero on interface. Can I have any mistake in my setup?

Well, not all boilers report this parameter.

VladaWaas, 2024-11-13:
> > ID19- flow rate is permanently zero on interface. Can I have any mistake in my setup?
>
> Well, not all boilers report this parameter.

Immergas is not in the OpenTherm association, but its extension modules are based on OpenTherm protocols. According to a non-public information from their developer, ID 19 should be active. But it is possible that the query string may differ in some small way from the OT spec.

VladaWaas, 2024-11-13:
> I will add polling ID 85 to the new version.

Thank you!
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

I reading it last week. I did exactly according to your instructions immediately after installation. But I'm a pretty impatient person. Any intervention in the system has a long inertia. I will have to improve! :))))

Laxilef, 2024-11-13:
> Immergas is not in the OpenTherm association, but its extension modules are based on OpenTherm protocols. According to a non-public information from their developer, ID 19 should be active. But it is possible that the query string may differ in some small way from the OT spec.

Hmm, in the firmware we interpret response as float. Can you open the hot water tap and start logging?

VladaWaas, 2024-11-13:
> > Immergas is not in the OpenTherm association, but its extension modules are based on OpenTherm protocols. According to a non-public information from their developer, ID 19 should be active. But it is possible that the query string may differ in some small way from the OT spec.
>
> Hmm, in the firmware we interpret response as float. Can you open the hot water tap and start logging?

yes I do. Can I acces via telnet in debug mode?

VladaWaas, 2024-11-13:
[putty.log](https://github.com/user-attachments/files/17738751/putty.log)

Laxilef, 2024-11-14:
``ID:   19   Request: 80130000   Response: 70130000   Attempt:  1   Status: INVALID``
Your boiler responds with INVALID response to DHW flow rate request

VladaWaas, 2024-11-15:
yes i noticed it as soon as i opened telnet. But I don't want to give up yet. I will ask the developer technician from the manufacturer if it is the same request at Imerrgas as specified by opentherm. Can you please send me the script of your command to fetch the values?

VladaWaas, 2024-11-15:
so I don't have positive information :(
 ID19 is active only in models with direct flow heating without a hot water storage tank

Closed 2024-12-05.

Thread 93 (2024-11-16):

1.4.6 errors and warnings

Pajuris, 2024-11-16:
Hello

After update to 1.4.6 version, appears error anw warning.

Error parsing value: 'dict object' has no attribute 'maxModulation' (value: {"heating":{"enable":true,"turbo":false,"target":21.5,"hysteresis":0.5,"turboFactor":7.5,"minTemp":20,"maxTemp":43},"dhw":{"enable":true,"target":45,"minTemp":30,"maxTemp":46},"equitherm":{"enable":false,"n_factor":0.7,"k_factor":3,"t_factor":2},"pid":{"enable":true,"p_factor":50,"i_factor":0.006,"d_factor":10000,"dt":180,"minTemp":5,"maxTemp":80},"sensors":{"outdoor":{"type":1,"gpio":12,"bleAddress":"00:00:00:00:00:00","offset":0},"indoor":{"type":1,"gpio":18,"bleAddress":"00:00:00:00:00:00","offset":0}}}, template: {{ value_json.heating.maxModulation|int(1) }})
Error parsing value: 'dict object' has no attribute 'maxModulation' (value: {"heating":{"enable":true,"turbo":false,"target":22,"hysteresis":0.5,"turboFactor":7.5,"Payload '{"heating":{"enable":true,"turbo":false,"target":21.5,"hysteresis":0.5,"turboFactor":7.5,"minTemp":20,"maxTemp":43},"dhw":{"enable":true,"target":45,"minTemp":30,"maxTemp":46},"equitherm":{"enable":false,"n_factor":0.7,"k_factor":3,"t_factor":2},"pid":{"enable":true,"p_factor":50,"i_factor":0.006,"d_factor":10000,"dt":180,"minTemp":5,"maxTemp":80},"sensors":{"outdoor":{"type":1,"gpio":12,"bleAddress":"00:00:00:00:00:00","offset":0},"indoor":{"type":1,"gpio":18,"bleAddress":"00:00:00:00:00:00","offset":0}}}' is not a Number
Payload '{"heating":{"enable":true,"turbo":false,"target":22,"hysteresis":0.5,"turboFactor":7.5,"minTemp":20,"maxTemp":43},"dhw":{"enable":true,"target":45,"minTemp":30,"maxTemp":46},"equitherm":{"enable":false,"n_factor":0.7,"k_factor":3,"t_factor":2},"pid":{"enable":true,"p_factor":50,"i_factor":0.006,"d_factor":10000,"dt":180,"minTemp":5,"maxTemp":80},"sensors":{"outdoor":{"type":1,"gpio":12,"bleAddress":"00:00:00:00:00:00","offset":0},"indoor":{"type":1,"gpio":18,"bleAddress":"00:00:00:00:00:00","offset":0}}}' is not a NumberminTemp":20,"maxTemp":43},"dhw":{"enable":true,"target":45,"minTemp":30,"maxTemp":46},"equitherm":{"enable":false,"n_factor":0.7,"k_factor":3,"t_factor":2},"pid":{"enable":true,"p_factor":50,"i_factor":0.006,"d_factor":10000,"dt":180,"minTemp":5,"maxTemp":80},"sensors":{"outdoor":{"type":1,"gpio":12,"bleAddress":"00:00:00:00:00:00","offset":0},"indoor":{"type":1,"gpio":18,"bleAddress":"00:00:00:00:00:00","offset":0}}}, template: {{ value_json.heating.maxModulation|int(1) }})

Laxilef, 2024-11-17:
Hi,

Remove device from Home Assistant and reboot the ESP.

Pajuris, 2024-11-17:
Thanks, it helped.

Closed 2024-11-17.

Thread 94 (2024-11-18):

Equitherm function once target temp reached

Daveblanche, 2024-11-18:
Hi there
I’ve looked around and can’t find the answer, yet.
I’m still staying to tune the correct heat curve…my house feel heavy with underfloor heating lag. I think because it has deep screed and insulation below it.
But when I get there, tomorrow, probably, I have a newbie question.
if set to function with equitherm, N 3.5, K 3.0 and T 2.0, what happens when the target temp is reached?

Does the flow temp reduce to the N value requirement, or below if it overshoots?
Does it modulate above and below the set temp? I’m sure it does.
Or does the heating switch off until a demand for heat is made again when the temperature drops below target?

I‘m sure this is a stupid question but it kept me awake last night. :)

Laxilef, 2024-11-18:
Hi,

If hysteresis is enabled, the heating will turn off when the indoor temperature is above ``target temperature + hysteresis``.
Equitherm simply calculates the heat carrier temperature.
I think that an N coefficient of 3.5 is a very large value for a well-insulated house with a water-heated floor.

Daveblanche, 2024-11-18:
Hi again,
Thanks for the answer. I appreciate it.
Perhaps my house is „Cardiff“ well-insulated and probably not as good as a new build in Chelyabinsk.
I think the design flow temp is around 40c at -2c outdoor temp.
But I also have a feeling that the underfloor pipe  centres are well above 200mm, though.
But the house is still cheap to heat.

Laxilef, 2024-11-18:
> I think the design flow temp is around 40c at -2c outdoor temp.

This is a fairly low temperature, which indicates good insulation.
I would start with N=0.4, K=5.0, T=2.0 and increase the coefficient if this is not enough.

You can look at the temperature graph [in the calculator](https://github.com/Laxilef/OTGateway/blob/master/assets/equitherm_calc.xlsx) that I published.

Closed 2024-11-18.

Thread 95 (2024-11-20):

De Dietrich MPX 20/24 MI COMPACT can't turn heating off

mementoars, 2024-11-20:
Hello everyone,

I have a De Dietrich MPX 20/24 MI COMPACT successfully connected to a D1 mini 32+diyless master opentherm shield.
  Version : 1.4.5
  Apartment: attic
  Indoor sensor: LYWSD03MMC
  External sensor: DS18B20
  Equitherm: enabled (but the coefficients are not adjusted correctly yet).

Boiler shows as a Baxi Luna Duo-Tec
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

The controller is connected to home assistant and displays the following:
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

Issue No1:
I can't turn the heating off.

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

Combinations that didn’t fix the problem:
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

issue No2:
The circulator pump doesn’t stop.
Even if I set the desired room temperature to the lowest value (5°C), the circulator pump keeps running and the burner runs periodically to maintain the set temperature.
Is this normal?

Note: when Summer/winter mode is enabled in Opentherm settings the heating and flame turn off)

thank you in advance

Laxilef, 2024-11-20:
Hi,
Set parameter P67=0 in the boiler service menu.

mementoars, 2024-11-26:
That was it!!!
Not all parameters were available (including P67) until I changed P22 from 0 to 22. So I set P67=0 and the problem got solved.
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

Thank you so much for the help and the amazing firmware!

Thread 96 (2024-11-23):

MQTT seems not to work

Bertus3, 2024-11-23:
Hi, I have gotten this build up and running. Really nice build!
MQTT however does not seem to work. I have tried the latest release (1.4.6), diffrent networks, dedicated MQTT user and password (no strange characters), nothing seems to work yet.

I am running eclipse mosquitto on docker. I am able to publish from other devices and other subnet but the gateway does not seem to be able to connect as seen from the MQTT brokers logs.

Can anyone help me?

Laxilef, 2024-11-23:
Hi,

Without logs I can't help.
Perhaps you are using a login or password longer than 32 characters?

Bertus3, 2024-11-23:
Here is a few minutes worth of output, set to verbose. Boiler is not connected btw. You can see me change the mqtt server fromt mqtt://.... to just the ip adress, does not make a diffrence. Passwordt is 12 char A-Z a-z 0-9

Couldn't be because it's not connected to a boiler that it is not publishing anything right?

```
[00:04:08][OT][TRACE] ID:    0   Request: 80001300   Response:        0   Attempt:  1   Status: TIMEOUT
[00:04:09][OT][TRACE] ID:    0   Request: 80001300   Response:        0   Attempt:  2   Status: TIMEOUT
[00:04:10][OT][TRACE] ID:    0   Request: 80001300   Response:        0   Attempt:  3   Status: TIMEOUT
[00:04:11][OT][TRACE] ID:    0   Request: 80001300   Response:        0   Attempt:  4   Status: TIMEOUT
[00:04:12][MAIN][VERB] Free heap size: 25072 of 81920 bytes (min: 20120, diff: 0), max free block: 24616 (min: 17568, diff: 0, frag: 1%)
[00:04:12][OT][T[00:02:54][OT][TRACE] ID:    0   Request: 80001300   Response:        0   Attemp                                                                                                                                   t:  1   Status: TIMEOUT
[00:02:55][OT][TRACE] ID:    0   Request: 80001300   Response:        0   Attemp                                                                                                                                   t:  2   Status: TIMEOUT
[00:02:56][OT][TRACE] ID:    0   Request: 80001300   Response:        0   Attemp                                                                                                                                   t:  3   Status: TIMEOUT
[00:02:57][OT][TRACE] ID:    0   Request: 80001300   Response:        0   Attempt:  4   Status: TIMEOUT
[00:02:58][OT][TRACE] ID:    0   Request: 80001300   Response:        0   Attempt:  5   Status: TIMEOUT
[00:02:58][OT][WARN] Failed receive boiler status: TIMEOUT
[00:03:00][OT][TRACE] ID:    0   Request: 80001300   Response:        0   Attempt:  1   Status: TIMEOUT
[00:03:01][MQTT][INFO] Connecting to mqtt://192.168.1.203:1883...
[00:03:01][OT][TRACE] ID:    0   Request: 80001300   Response:        0   Attempt:  2   Status: TIMEOUT
[00:03:02][OT][TRACE] ID:    0   Request: 80001300   Response:        0   Attempt:  3   Status: TIMEOUT
[00:03:03][OT][TRACE] ID:    0   Request: 80001300   Response:        0   Attempt:  4   Status: TIMEOUT
[00:03:05][OT][TRACE] ID:    0   Request: 80001300   Response:        0   Attempt:  5   Status: TIMEOUT
[00:03:05][OT][WARN] Failed receive boiler status: TIMEOUT
[00:03:06][OT][TRACE] ID:    0   Request: 80001300   Response:        0   Attempt:  1   Status: TIMEOUT
[00:03:07][OT][TRACE] ID:    0   Request: 80001300   Response:        0   Attempt:  2   Status: TIMEOUT
[00:03:09][OT][TRACE] ID:    0   Request: 80001300   Response:        0   Attempt:  3   Status: TIMEOUT
[00:03:10][OT][TRACE] ID:    0   Request: 80001300   Response:        0   Attempt:  4   Status: TIMEOUT
[00:03:10][MAIN][VERB] Free heap size: 25520 of 81920 bytes (min: 20376, diff: 0), max free block: 25080 (min: 18680, diff: 0,                                                                                      frag: 1%)
[00:03:11][OT][TRACE] ID:    0   Request: 80001300   Response:        0   Attempt:  5   Status: TIMEOUT
[00:03:11][OT][WARN] Failed receive boiler status: TIMEOUT
[00:03:13][OT][TRACE] ID:    0   Request: 80001300   Response:        0   Attempt:  1   Status: TIMEOUT
[00:03:14][OT][TRACE] ID:    0   Request: 80001300   Response:        0   Attempt:  2   Status: TIMEOUT
[00:03:15][OT][TRACE] ID:    0   Request: 80001300   Response:        0   Attempt:  3   Status: TIMEOUT
[00:03:16][MQTT][INFO] Connecting to mqtt://192.168.1.203:1883...
[00:03:16][OT][TRACE] ID:    0   Request: 80001300   Response:        0   Attempt:  4   Status: TIMEOUT
[00:03:17][OT][TRACE] ID:    0   Request: 80001300   Response:        0   Attempt:  5   Status: TIMEOUT
[00:03:17][OT][WARN] Failed receive boiler status: TIMEOUT
[00:03:19][OT][TRACE] ID:    0   Request: 80001300   Response:        0   Attempt:  1   Status: TIMEOUT
[00:03:20][OT][TRACE] ID:    0   Request: 80001300   Response:        0   Attempt:  2   Status: TIMEOUT
[00:03:21][OT][TRACE] ID:    0   Request: 80001300   Response:        0   Attempt:  3   Status: TIMEOUT
[00:03:22][OT][TRACE] ID:    0   Request: 80001300   Response:        0   Attempt:  4   Status: TIMEOUT
[00:03:23][OT][TRACE] ID:    0   Request: 80001300   Response:        0   Attempt:  5   Status: TIMEOUT
[00:03:23][OT][WARN] Failed receive boiler status: TIMEOUT
[00:03:25][OT][TRACE] ID:    0   Request: 80001300   Response:        0   Attempt:  1   Status: TIMEOUT
[00:03:26][OT][TRACE] ID:    0   Request: 80001300   Response:        0   Attempt:  2   Status: TIMEOUT
[00:03:27][OT][TRACE] ID:    0   Request: 80001300   Response:        0   Attempt:  3   Status: TIMEOUT
[00:03:28][OT][TRACE] ID:    0   Request: 80001300   Response:        0   Attempt:  4   Status: TIMEOUT
[00:03:29][OT][TRACE] ID:    0   Request: 80001300   Response:        0   Attempt:  5   Status: TIMEOUT
[00:03:29][OT][WARN] Failed receive boiler status: TIMEOUT
[00:03:30][MAIN][VERB] Free heap size: 25520 of 81920 bytes (min: 20376, diff: 0), max free block: 25080 (min: 18680, diff: 0,                                                                                      frag: 1%)
[00:03:31][MQTT][INFO] Connecting to mqtt://192.168.1.203:1883...
[00:03:31][OT][TRACE] ID:    0   Request: 80001300   Response:        0   Attempt:  1   Status: TIMEOUT
[00:03:32][MAIN][VERB] Free heap size: 20656 of 81920 bytes (min: 20376, diff: 0), max free block: 18216 (min: 18216, diff: 46                                                                                     4, frag: 11%)
[00:03:32][MAIN][VERB] Free heap size: 20120 of 81920 bytes (min: 20120, diff: 256), max free block: 17568 (min: 17568, diff:                                                                                      648, frag: 12%)
[00:03:32][OT][TRACE] ID:    0   Request: 80001300   Response:        0   Attempt:  2   Status: TIMEOUT
[00:03:33][OT][TRACE] ID:    0   Request: 80001300   Response:        0   Attempt:  3   Status: TIMEOUT
[00:03:34][OT][TRACE] ID:    0   Request: 80001300   Response:        0   Attempt:  4   Status: TIMEOUT
[00:03:35][OT][TRACE] ID:    0   Request: 80001300   Response:        0   Attempt:  5   Status: TIMEOUT
[00:03:35][OT][WARN] Failed receive boiler status: TIMEOUT
[00:03:37][OT][TRACE] ID:    0   Request: 80001300   Response:        0   Attempt:  1   Status: TIMEOUT
[00:03:38][OT][TRACE] ID:    0   Request: 80001300   Response:        0   Attempt:  2   Status: TIMEOUT
[00:03:39][OT][TRACE] ID:    0   Request: 80001300   Response:        0   Attempt:  3   Status: TIMEOUT
[00:03:40][OT][TRACE] ID:    0   Request: 80001300   Response:        0   Attempt:  4   Status: TIMEOUT
[00:03:41][OT][TRACE] ID:    0   Request: 80001300   Response:        0   Attempt:  5   Status: TIMEOUT
[00:03:41][OT][WARN] Failed receive boiler status: TIMEOUT
[00:03:43][OT][TRACE] ID:    0   Request: 80001300   Response:        0   Attempt:  1   Status: TIMEOUT
[00:03:44][OT][TRACE] ID:    0   Request: 80001300   Response:        0   Attempt:  2   Status: TIMEOUT
[00:03:45][OT][TRACE] ID:    0   Request: 80001300   Response:        0   Attempt:  3   Status: TIMEOUT
[00:03:46][MQTT][INFO] Connecting to mqtt://192.168.1.203:1883...
[00:03:46][OT][TRACE] ID:    0   Request: 80001300   Response:        0   Attempt:  4   Status: TIMEOUT
[00:03:48][OT][TRACE] ID:    0   Request: 80001300   Response:        0   Attempt:  5   Status: TIMEOUT
[00:03:48][OT][WARN] Failed receive boiler status: TIMEOUT
[00:03:49][OT][TRACE] ID:    0   Request: 80001300   Response:        0   Attempt:  1   Status: TIMEOUT
[00:03:50][OT][TRACE] ID:    0   Request: 80001300   Response:        0   Attempt:  2   Status: TIMEOUT
[00:03:52][OT][TRACE] ID:    0   Request: 80001300   Response:        0   Attempt:  3   Status: TIMEOUT
[00:03:52][MAIN][VERB] Free heap size: 25072 of 81920 bytes (min: 20120, diff: 0), max free block: 24616 (min: 17568, diff: 0,                                                                                      frag: 1%)
[00:03:53][OT][TRACE] ID:    0   Request: 80001300   Response:        0   Attempt:  4   Status: TIMEOUT
[00:03:54][OT][TRACE] ID:    0   Request: 80001300   Response:        0   Attempt:  5   Status: TIMEOUT
[00:03:54][OT][WARN] Failed receive boiler status: TIMEOUT
[00:03:55][OT][TRACE] ID:    0   Request: 80001300   Response:        0   Attempt:  1   Status: TIMEOUT
[00:03:57][OT][TRACE] ID:    0   Request: 80001300   Response:        0   Attempt:  2   Status: TIMEOUT
[00:03:58][OT][TRACE] ID:    0   Request: 80001300   Response:        0   Attempt:  3   Status: TIMEOUT
[00:03:59][OT][TRACE] ID:    0   Request: 80001300   Response:        0   Attempt:  4   Status: TIMEOUT
[00:04:00][OT][TRACE] ID:    0   Request: 80001300   Response:        0   Attempt:  5   Status: TIMEOUT
[00:04:00][OT][WARN] Failed receive boiler status: TIMEOUT
[00:04:01][MQTT][INFO] Connecting to mqtt://192.168.1.203:1883...
[00:04:02][OT][TRACE] ID:    0   Request: 80001300   Response:        0   Attempt:  1   Status: TIMEOUT
[00:04:03][OT][TRACE] ID:    0   Request: 80001300   Response:        0   Attempt:  2   Status: TIMEOUT
[00:04:04][OT][TRACE] ID:    0   Request: 80001300   Response:        0   Attempt:  3   Status: TIMEOUT
[00:04:05][OT][TRACE] ID:    0   Request: 80001300   Response:        0   Attempt:  4   Status: TIMEOUT
[00:04:06][OT][TRACE] ID:    0   Request: 80001300   Response:        0   Attempt:  5   Status: TIMEOUT
[00:04:06][OT][WARN] Failed receive boiler status: TIMEOUT
[00:04:08][OT][TRACE] ID:    0   Request: 80001300   Response:        0   Attempt:  1   Status: TIMEOUT
[00:04:09][OT][TRACE] ID:    0   Request: 80001300   Response:        0   Attempt:  2   Status: TIMEOUT
[00:04:10][OT][TRACE] ID:    0   Request: 80001300   Response:        0   Attempt:  3   Status: TIMEOUT
[00:04:11][OT][TRACE] ID:    0   Request: 80001300   Response:        0   Attempt:  4   Status: TIMEOUT
[00:04:12][MAIN][VERB] Free heap size: 25072 of 81920 bytes (min: 20120, diff: 0), max free block: 24616 (min: 17568, diff: 0, frag: 1%)
[00:04:12][OT][TRACE] ID:    0   Request: 80001300   Response:        0   Attempt:  5   Status: TIMEOUT
[00:04:12][OT][WARN] Failed receive boiler status: TIMEOUT
[00:04:14][OT][TRACE] ID:    0   Request: 80001300   Response:        0   Attempt:  1   Status: TIMEOUT
[00:04:15][OT][TRACE] ID:    0   Request: 80001300   Response:        0   Attempt:  2   Status: TIMEOUTRACE] ID:    0   Request: 80001300   Response:        0   Attempt:  5   Status: TIMEOUT
[00:04:12][OT][WARN] Failed receive boiler status: TIMEOUT
[00:04:14][OT][TRACE] ID:    0   Request: 80001300   Response:        0   Attempt:  1   Status: TIMEOUT
[00:04:15][OT][TRACE] ID:    0   Request: 80001300   Response:        0   Attempt:  2   Status: TIMEOUT
[00:04:16][MQTT][INFO] Connecting to mqtt://192.168.1.203:1883...
[00:04:16][OT][TRACE] ID:    0   Request: 80001300   Response:        0   Attempt:  3   Status: TIMEOUT
[00:04:17][OT][TRACE] ID:    0   Request: 80001300   Response:        0   Attempt:  4   Status: TIMEOUT
[00:04:18][OT][TRACE] ID:    0   Request: 80001300   Response:        0   Attempt:  5   Status: TIMEOUT
[00:04:18][OT][WARN] Failed receive boiler status: TIMEOUT
[00:04:20][OT][TRACE] ID:    0   Request: 80001300   Response:        0   Attempt:  1   Status: TIMEOUT
[00:04:21][OT][TRACE] ID:    0   Request: 80001300   Response:        0   Attempt:  2   Status: TIMEOUT
[00:04:22][OT][TRACE] ID:    0   Request: 80001300   Response:        0   Attempt:  3   Status: TIMEOUT
[00:04:23][OT][TRACE] ID:    0   Request: 80001300   Response:        0   Attempt:  4   Status: TIMEOUT
[00:04:24][OT][TRACE] ID:    0   Request: 80001300   Response:        0   Attempt:  5   Status: TIMEOUT
[00:04:24][OT][WARN] Failed receive boiler status: TIMEOUT
[00:04:26][OT][TRACE] ID:    0   Request: 80001300   Response:        0   Attempt:  1   Status: TIMEOUT
[00:04:27][OT][TRACE] ID:    0   Request: 80001300   Response:        0   Attempt:  2   Status: TIMEOUT
[00:04:28][PORTAL][WEBSERVER][TRACE] Request /api/settings 165 bytes: {"mqtt":{"enable":true,"homeAssistantDiscovery":true,"server":"192.168.1.203","port":1883,"user":"otgw","password":"xxxxxxxxx","prefix":"opentherm","interval":5}}
[00:04:28][OT][TRACE] ID:    0   Request: 80001300   Response:        0   Attempt:  3   Status: TIMEOUT
[00:04:30][OT][TRACE] ID:    0   Request: 80001300   Response:        0   Attempt:  4   Status: TIMEOUT
[00:04:31][OT][TRACE] ID:    0   Request: 80001300   Response:        0   Attempt:  5   Status: TIMEOUT
[00:04:31][OT][WARN] Failed receive boiler status: TIMEOUT
[00:04:31][MQTT][INFO] Connecting to 192.168.1.203:1883...
[00:04:32][MAIN][VERB] Free heap size: 24560 of 81920 bytes (min: 20120, diff: 0), max free block: 22304 (min: 17568, diff: 0, frag: 9%)
[00:04:32][OT][TRACE] ID:    0   Request: 80001300   Response:        0   Attempt:  1   Status: TIMEOUT
[00:04:33][OT][TRACE] ID:    0   Request: 80001300   Response:        0   Attempt:  2   Status: TIMEOUT
[00:04:35][OT][TRACE] ID:    0   Request: 80001300   Response:        0   Attempt:  3   Status: TIMEOUT
[00:04:36][OT][TRACE] ID:    0   Request: 80001300   Response:        0   Attempt:  4   Status: TIMEOUT
[00:04:37][OT][TRACE] ID:    0   Request: 80001300   Response:        0   Attempt:  5   Status: TIMEOUT
[00:04:37][OT][WARN] Failed receive boiler status: TIMEOUT
[00:04:39][OT][TRACE] ID:    0   Request: 80001300   Response:        0   Attempt:  1   Status: TIMEOUT
[00:04:40][OT][TRACE] ID:    0   Request: 80001300   Response:        0   Attempt:  2   Status: TIMEOUT
[00:04:41][OT][TRACE] ID:    0   Request: 80001300   Response:        0   Attempt:  3   Status: TIMEOUT
[00:04:42][OT][TRACE] ID:    0   Request: 80001300   Response:        0   Attempt:  4   Status: TIMEOUT
[00:04:43][OT][TRACE] ID:    0   Request: 80001300   Response:        0   Attempt:  5   Status: TIMEOUT
[00:04:43][OT][WARN] Failed receive boiler status: TIMEOUT
[00:04:45][OT][TRACE] ID:    0   Request: 80001300   Response:        0   Attempt:  1   Status: TIMEOUT
[00:04:46][OT][TRACE] ID:    0   Request: 80001300   Response:        0   Attempt:  2   Status: TIMEOUT
[00:04:46][MQTT][INFO] Connecting to 192.168.1.203:1883...
[00:04:47][OT][TRACE] ID:    0   Request: 80001300   Response:        0   Attempt:  3   Status: TIMEOUT
[00:04:48][OT][TRACE] ID:    0   Request: 80001300   Response:        0   Attempt:  4   Status: TIMEOUT
[00:04:49][OT][TRACE] ID:    0   Request: 80001300   Response:        0   Attempt:  5   Status: TIMEOUT
[00:04:49][OT][WARN] Failed receive boiler status: TIMEOUT
[00:04:51][OT][TRACE] ID:    0   Request: 80001300   Response:        0   Attempt:  1   Status: TIMEOUT
[00:04:52][OT][TRACE] ID:    0   Request: 80001300   Response:        0   Attempt:  2   Status: TIMEOUT
[00:04:52][MAIN][VERB] Free heap size: 24752 of 81920 bytes (min: 20120, diff: 0), max free block: 22304 (min: 17568, diff: 0, frag: 9%)
[00:04:53][OT][TRACE] ID:    0   Request: 80001300   Response:        0   Attempt:  3   Status: TIMEOUT
[00:04:54][OT][TRACE] ID:    0   Request: 80001300   Response:        0   Attempt:  4   Status: TIMEOUT
[00:04:55][OT][TRACE] ID:    0   Request: 80001300   Response:        0   Attempt:  5   Status: TIMEOUT
[00:04:55][OT][WARN] Failed receive boiler status: TIMEOUT
[00:04:57][OT][TRACE] ID:    0   Request: 80001300   Response:        0   Attempt:  1   Status: TIMEOUT
[00:04:58][OT][TRACE] ID:    0   Request: 80001300   Response:        0   Attempt:  2   Status: TIMEOUT
[00:04:59][OT][TRACE] ID:    0   Request: 80001300   Response:        0   Attempt:  3   Status: TIMEOUT
[00:05:00][OT][TRACE] ID:    0   Request: 80001300   Response:        0   Attempt:  4   Status: TIMEOUT
[00:05:01][MQTT][INFO] Connecting to 192.168.1.203:1883...
[00:05:01][OT][TRACE] ID:    0   Request: 80001300   Response:        0   Attempt:  5   Status: TIMEOUT
[00:05:01][OT][WARN] Failed receive boiler status: TIMEOUT
[00:05:03][OT][TRACE] ID:    0   Request: 80001300   Response:        0   Attempt:  1   Status: TIMEOUT
[00:05:04][OT][TRACE] ID:    0   Request: 80001300   Response:        0   Attempt:  2   Status: TIMEOUT
[00:05:05][OT][TRACE] ID:    0   Request: 80001300   Response:        0   Attempt:  3   Status: TIMEOUT
[00:05:06][OT][TRACE] ID:    0   Request: 80001300   Response:        0   Attempt:  4   Status: TIMEOUT
[00:05:07][OT][TRACE] ID:    0   Request: 80001300   Response:        0   Attempt:  5   Status: TIMEOUT
[00:05:07][OT][WARN] Failed receive boiler status: TIMEOUT
[00:05:09][OT][TRACE] ID:    0   Request: 80001300   Response:        0   Attempt:  1   Status: TIMEOUT
[00:05:10][OT][TRACE] ID:    0   Request: 80001300   Response:        0   Attempt:  2   Status: TIMEOUT
[00:05:11][OT][TRACE] ID:    0   Request: 80001300   Response:        0   Attempt:  3   Status: TIMEOUT
[00:05:12][MAIN][VERB] Free heap size: 24752 of 81920 bytes (min: 20120, diff: 0), max free block: 22304 (min: 17568, diff: 0, frag: 9%)
[00:05:12][OT][TRACE] ID:    0   Request: 80001300   Response:        0   Attempt:  4   Status: TIMEOUT
[00:05:13][OT][TRACE] ID:    0   Request: 80001300   Response:        0   Attempt:  5   Status: TIMEOUT
[00:05:13][OT][WARN] Failed receive boiler status: TIMEOUT
[00:05:15][OT][TRACE] ID:    0   Request: 80001300   Response:        0   Attempt:  1   Status: TIMEOUT
[00:05:16][MQTT][INFO] Connecting to 192.168.1.203:1883...
[00:05:16][OT][TRACE] ID:    0   Request: 80001300   Response:        0   Attempt:  2   Status: TIMEOUT
[00:05:17][OT][TRACE] ID:    0   Request: 80001300   Response:        0   Attempt:  3   Status: TIMEOUT
[00:05:18][OT][TRACE] ID:    0   Request: 80001300   Response:        0   Attempt:  4   Status: TIMEOUT
[00:05:20][OT][TRACE] ID:    0   Request: 80001300   Response:        0   Attempt:  5   Status: TIMEOUT
[00:05:20][OT][WARN] Failed receive boiler status: TIMEOUT
[00:05:21][OT][TRACE] ID:    0   Request: 80001300   Response:        0   Attempt:  1   Status: TIMEOUT
[00:05:22][OT][TRACE] ID:    0   Request: 80001300   Response:        0   Attempt:  2   Status: TIMEOUT
[00:05:24][OT][TRACE] ID:    0   Request: 80001300   Response:        0   Attempt:  3   Status: TIMEOUT
[00:05:25][OT][TRACE] ID:    0   Request: 80001300   Response:        0   Attempt:  4   Status: TIMEOUT
[00:05:26][OT][TRACE] ID:    0   Request: 80001300   Response:        0   Attempt:  5   Status: TIMEOUT
[00:05:26][OT][WARN] Failed receive boiler status: TIMEOUT
[00:05:28][OT][TRACE] ID:    0   Request: 80001300   Response:        0   Attempt:  1   Status: TIMEOUT
[00:05:29][SETTINGS][INFO] Updated
[00:05:29][OT][TRACE] ID:    0   Request: 80001300   Response:        0   Attempt:  2   Status: TIMEOUT
[00:05:30][OT][TRACE] ID:    0   Request: 80001300   Response:        0   Attempt:  3   Status: TIMEOUT
[00:05:31][OT][TRACE] ID:    0   Request: 80001300   Response:        0   Attempt:  4   Status: TIMEOUT
[00:05:31][MQTT][INFO] Connecting to 192.168.1.203:1883...
[00:05:32][OT][TRACE] ID:    0   Request: 80001300   Response:        0   Attempt:  5   Status: TIMEOUT
[00:05:32][OT][WARN] Failed receive boiler status: TIMEOUT
[00:05:32][MAIN][VERB] Free heap size: 24944 of 81920 bytes (min: 20120, diff: 0), max free block: 22304 (min: 17568, diff: 0, frag: 10%)
[00:05:34][OT][TRACE] ID:    0   Request: 80001300   Response:        0   Attempt:  1   Status: TIMEOUT
[00:05:35][OT][TRACE] ID:    0   Request: 80001300   Response:        0   Attempt:  2   Status: TIMEOUT
[00:05:36][OT][TRACE] ID:    0   Request: 80001300   Response:        0   Attempt:  3   Status: TIMEOUT
[00:05:37][OT][TRACE] ID:    0   Request: 80001300   Response:        0   Attempt:  4   Status: TIMEOUT
[00:05:38][OT][TRACE] ID:    0   Request: 80001300   Response:        0   Attempt:  5   Status: TIMEOUT
[00:05:38][OT][WARN] Failed receive boiler status: TIMEOUT
[00:05:40][OT][TRACE] ID:    0   Request: 80001300   Response:        0   Attempt:  1   Status: TIMEOUT
[00:05:41][OT][TRACE] ID:    0   Request: 80001300   Response:        0   Attempt:  2   Status: TIMEOUT
[00:05:42][OT][TRACE] ID:    0   Request: 80001300   Response:        0   Attempt:  3   Status: TIMEOUT
[00:05:43][OT][TRACE] ID:    0   Request: 80001300   Response:        0   Attempt:  4   Status: TIMEOUT
[00:05:44][OT][TRACE] ID:    0   Request: 80001300   Response:        0   Attempt:  5   Status: TIMEOUT
[00:05:44][OT][WARN] Failed receive boiler status: TIMEOUT
[00:05:46][OT][TRACE] ID:    0   Request: 80001300   Response:        0   Attempt:  1   Status: TIMEOUT
[00:05:46][MQTT][INFO] Connecting to 192.168.1.203:1883...
[00:05:47][OT][TRACE] ID:    0   Request: 80001300   Response:        0   Attempt:  2   Status: TIMEOUT
[00:05:48][OT][TRACE] ID:    0   Request: 80001300   Response:        0   Attempt:  3   Status: TIMEOUT
[00:05:49][OT][TRACE] ID:    0   Request: 80001300   Response:        0   Attempt:  4   Status: TIMEOUT
[00:05:50][OT][TRACE] ID:    0   Request: 80001300   Response:        0   Attempt:  5   Status: TIMEOUT
[00:05:50][OT][WARN] Failed receive boiler status: TIMEOUT
[00:05:52][OT][TRACE] ID:    0   Request: 80001300   Response:        0   Attempt:  1   Status: TIMEOUT
[00:05:52][MAIN][VERB] Free heap size: 25136 of 81920 bytes (min: 20120, diff: 0), max free block: 22304 (min: 17568, diff: 0, frag: 11%)
[00:05:53][OT][TRACE] ID:    0   Request: 80001300   Response:        0   Attempt:  2   Status: TIMEOUT
[00:05:54][OT][TRACE] ID:    0   Request: 80001300   Response:        0   Attempt:  3   Status: TIMEOUT
[00:05:55][OT][TRACE] ID:    0   Request: 80001300   Response:        0   Attempt:  4   Status: TIMEOUT
[00:05:56][OT][TRACE] ID:    0   Request: 80001300   Response:        0   Attempt:  5   Status: TIMEOUT
[00:05:56][OT][WARN] Failed receive boiler status: TIMEOUT
[00:05:58][OT][TRACE] ID:    0   Request: 80001300   Response:        0   Attempt:  1   Status: TIMEOUT
[00:05:59][OT][TRACE] ID:    0   Request: 80001300   Response:        0   Attempt:  2   Status: TIMEOUT
[00:06:00][OT][TRACE] ID:    0   Request: 80001300   Response:        0   Attempt:  3   Status: TIMEOUT
[00:06:01][MQTT][INFO] Connecting to 192.168.1.203:1883...
[00:06:01][OT][TRACE] ID:    0   Request: 80001300   Response:        0   Attempt:  4   Status: TIMEOUT
[00:06:02][OT][TRACE] ID:    0   Request: 80001300   Response:        0   Attempt:  5   Status: TIMEOUT
[00:06:02][OT][WARN] Failed receive boiler status: TIMEOUT
[00:06:04][OT][TRACE] ID:    0   Request: 80001300   Response:        0   Attempt:  1   Status: TIMEOUT
[00:06:05][OT][TRACE] ID:    0   Request: 80001300   Response:        0   Attempt:  2   Status: TIMEOUT
[00:06:06][OT][TRACE] ID:    0   Request: 80001300   Response:        0   Attempt:  3   Status: TIMEOUT
[00:06:07][OT][TRACE] ID:    0   Request: 80001300   Response:        0   Attempt:  4   Status: TIMEOUT
[00:06:09][OT][TRACE] ID:    0   Request: 80001300   Response:        0   Attempt:  5   Status: TIMEOUT
```

Laxilef, 2024-11-23:
No need to use ``mqtt://`` prefix

Laxilef, 2024-11-24:
I don't see any logical reasons.
You need to check the port, login and password. Can you connect to the broker with these credentials via mqtt explorer?

Bertus3, 2024-11-24:
For some reason it started working. Don't know why or how. Thanks anyway!

Closed 2024-11-24.

Thread 97 (2024-11-23):

Creating a backup prior to upgrade

Daveblanche, 2024-11-23:
Hi
How does one create a backup and restore of settings when doing an upgrade from 1.4.5 to 1.4.6?
There isn’t anything written here, but that doesn’t mean that I haven’t missed it being somewhere obvious.
I’d there an option to back up and restore when the upgrade button is pushed?

Daveblanche, 2024-11-24:
Thanks! I’ve a few episodes of pushing a button with no way back, lately, so thank you for clearing that up. It didn’t work, in my situation, when trying to update with iPad os…but windows worked fine.

I love this system.

Thread 98 (2024-11-25):

Immergas Victrix Zeus 25 enters summer mode

flexmatics, 2024-11-25:
Hi,

I've previously [reported](https://github.com/Laxilef/OTGateway/issues/3#issuecomment-2453361792) support for this boiler. It worked fine for a while, but now noticed that boiler enters summer mode without any changes to settings. Restart boilder/controller didn't help - only disconnect of controller helps.

What can I try to understand where the issue is?

Laxilef, 2024-11-25:
Hi,

What do you mean by summer mode? What is the boiler's behavior?

flexmatics, 2024-11-27:
This is the behavior of boiler when controller is turned on (see video). Perhaps some logs would help to understand what is happening? The strange thing is that this started happening out of the blue without changing anything in settings/setup.

https://github.com/user-attachments/assets/3bca72a6-427c-4a84-91fd-5ed1d525a1c5

Laxilef, 2024-11-27:
Try turning on the "Summer/Winter mode" option.

flexmatics, 2024-11-27:
1. Tried this with on and off - no changes.
2. No, no reaction neither with short press, nor long press.

Perhaps telnet log suggests anything?

> [00:01:57][OT][WARN] Failed receive exhaust temp
[00:01:58][OT][NOTICE] Received boiler status. Heating: 0; DHW: 0; flame: 0; fault: 0; diag: 0
[00:01:59][OT][DHW][NOTICE] Received temp: 54.30
[00:01:59][OT][DHW][WARN] Failed receive flow rate
[00:01:59][OT][HEATING][NOTICE] Received temp: 44.60
[00:01:59][OT][HEATING][NOTICE] Received return temp: 47.50
[00:02:00][OT][WARN] Failed receive exhaust temp
[00:02:01][OT][NOTICE] Received boiler status. Heating: 0; DHW: 0; flame: 0; fault: 0; diag: 0
[00:02:01][OT][DHW][NOTICE] Received temp: 54.30
[00:02:01][OT][DHW][WARN] Failed receive flow rate
[00:02:01][OT][HEATING][NOTICE] Received temp: 44.60
[00:02:02][OT][HEATING][NOTICE] Received return temp: 47.50
[00:02:02][OT][WARN] Failed receive exhaust temp
[00:02:03][OT][NOTICE] Received boiler status. Heating: 0; DHW: 0; flame: 0; fault: 0; diag: 0
[00:02:03][OT][NOTICE] Received min modulation: 0%, max power: 0 kW
[00:02:03][OT][NOTICE] Set max modulation: 100%
[00:02:03][OT][DHW][NOTICE] Received min temp: 10, max temp: 60
[00:02:04][OT][HEATING][NOTICE] Received min temp: 20, max temp: 85
[00:02:04][OT][WARN] Failed receive pressure
[00:02:04][OT][DHW][NOTICE] Received temp: 54.30
[00:02:04][OT][DHW][WARN] Failed receive flow rate
[00:02:05][OT][HEATING][NOTICE] Received temp: 44.50

Laxilef, 2024-11-27:
Hysteresis turns off the heating and this is normal.
Perhaps the boiler interprets the heating being turned off as summer mode. But when the indoor temperature is below the target, the heating should turn on.

What happens if you set the target temperature 2 degrees higher than the indoor temperature? (with equitherm on)

flexmatics, 2024-11-29:
Thanks. I've tested your assumption and it is exactly what happens. If temperature above target, heating is turned back on.

Closed 2024-11-29.

Thread 99 (2024-11-26):

WEB интерфейс

lti1, 2024-11-26:
Добрый день!
Пользуюсь управлением через WEB интерфейс, мне этого достаточно. Только столкнулся со сложностью, на компьютере через Chrome страница Дашборд отображается нормально, на смартфоне ни в Chrome, ни в Safri не отображается установленная температура, тумблер активации в положении выключено и нет реакции на кнопки изменения температуры.
Чистил кэш, включал в настройках браузеров "Версия для ПК", менял ориентацию экрана, перегружал ESP отключением питания - ничего не помогает. Хотя ранее все отображалось нормально.
В чем может быть дело?
Спасибо!
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

Laxilef, 2024-11-26:
Здравствуйте.
1. Какая версия прошивки?
2. Какое разрешение экрана у устройства?

> Хотя ранее все отображалось нормально.

Попробуйте открыть в приватной вкладке, поменялось ли что-то?

lti1, 2024-11-27:
1. 1.4.6
2. iPhone 13, 2532×1170
`Да, не понятно.`

lti1, 2024-11-27:
> 2. Какое разрешение экрана у устройства?
За смартфоне установлен увеличенный интерфейс, сейчас попробовал установить стандартный, отображение текущей температуры выровнялось по центру, но так же не отображается установленная температура, тумблер активации.
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

Laxilef, 2024-11-27:
Айфонами не пользуюсь, попробую найти для тестов. Проблема скорее всего в верстке.
В альбомной ориентации экрана так же себя ведет интерфейс?

lti1, 2024-11-27:
> В альбомной ориентации экрана так же себя ведет интерфейс?

Да, так же.
Спасибо!

Laxilef, 2024-11-27:
> Да, так же.

А вот это странно :( Предполагал, что на экран не влезает просто.

lti1, 2024-11-27:
Все остальные страницы подгружаются нормально, иногда бывает не раскрываются подпункты настроек, это скорее всего какая-то иная причина, например инет подтормаживает или роутер что-то не пропускает.
По моему самое странное, что тумблер включения отопления на компьютере во включённом состоянии, а на телефоне в выключенном, в одно и тоже время и нет никакой реакции на кнопки изменения температуры на телефоне. То есть если я открою страницу сразу и там, и там, на телефоне буду менять температуру, хоть её и не видно, или изменять положение тумблера, то на компьютере никаких изменений температуры и тумблера не происходит, пробовал ждать более минуты.

lti1, 2024-11-27:
Поэкспериментировал, открыл страницу управления во встроенном браузере telegram, в нем отображается и управляется все нормально.
Похоже, что дело в Chrome и Safari.
Правда поймал после этого, что не отображалась температура на компьютере, но после обновления страницы все стало нормально.
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

Laxilef, 2024-11-27:
А есть возможность прошить бету?
Esp какая?

lti1, 2024-11-28:
> А есть возможность прошить бету?

Да, смогу в выходные доехать. По воздуху у меня почему-то не проходит обновление, ошибку выдает.

> Esp какая?

S2 mini
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

Laxilef, 2024-11-28:
> По воздуху у меня почему-то не проходит обновление, ошибку выдает.

Какую?

lti1, 2024-11-28:
> Какую?

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

Laxilef, 2024-11-28:
https://t.me/otgateway/6682

lti1, 2024-11-28:
> А с ПК?

Точно не помню, пробовал или нет. Попробую по воздуху ещё раз с компа, когда поеду заливать бету.

lti1, 2024-11-30:
> А есть возможность прошить бету?

К сожалению обновление не помогло.
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

Повесил для эксперимента на роутер ещё ESP32_C3 не подключенную к котлу, с прошивкой 1.4.5, на ней пока все отображается нормально.

Laxilef, 2024-11-30:
Проверил 1.5.0 через browserstack на iphone 13, проблема не воспроизводится
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

lti1, 2024-12-01:
Могу предоставить доступ к управлению моего котла.
Нашел у себя старенький планшет, на Андройд отображается нормально.

lti1, 2024-12-01:
[Laxilef](https://github.com/Laxilef), я нашел какая настройка влияет на отображение установленной температуры и работу тумблера активации - это Настройки портала -> Требовать аутентификацию. Если отключить аутентификацию, то на iPhone все работает как на ПК и Андройд! К сожалению у себя эту настройку отключить не могу, так как подключаюсь удаленно.
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

Laxilef, 2024-12-01:
Интересно, поэкспериментирую с аутентификацией, спасибо.

lti1, 2024-12-02:
[Laxilef](https://github.com/Laxilef), спасибо! Похоже помогло.

Laxilef, 2024-12-03:
С ios пытались прошить?

lti1, 2024-12-03:
> С ios пытались прошить?

Нет, с ПК на Windows 11, через Chrome.

> рекомендую проверить.

[Laxilef](https://github.com/Laxilef), спасибо! Да, слетели настройки датчиков, настроил сразу после обновления и восстановления настроек.

Laxilef, 2024-12-05:
Попробуйте по ОТА обновиться с альфы на [релиз](https://github.com/Laxilef/OTGateway/releases/tag/1.5.0). Сохраняется ошибка?

lti1, 2024-12-11:
> Попробуйте по ОТА обновиться с альфы на [релиз](https://github.com/Laxilef/OTGateway/releases/tag/1.5.0). Сохраняется ошибка?

Попробовал, ошибки нет, пишет что обновление прошло нормально, но в системе показывает Версия 1.5.0-alpha, Дата: Dec 2 2024 06:32:03.

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

lti1, 2024-12-17:
> И после перезагрузки есп не обновилось?

Нет, тоже самое.

lti1, 2024-12-18:
Похоже мой "косяк", вычитал сегодня в телеграм, что нужно было шить 1.5.0.bin, а я все это время пытался залить 1.5.0.factory.bin. Теперь корректно версия прошивки отображается.

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

Closed 2025-01-07.

Thread 102 (2024-12-04):

Лимит температуры

RYZHOP, 2024-12-04:
Установил настройки отопления мин. 20 макс. 80
ГВС мин.30 макс. 50

Но котел греет больше этих значений. И лимиты показывает он больше.

Vendor:          Viessmann
Member ID:       33
Flags:           81
Type:            100
Version:         30
OT version:      3
Heating limits:  20...80 °C
DHW limits:      30...60 °C

Laxilef, 2024-12-04:
У котла есть свои лимиты и свой гистерезис, которые нельзя изменить через opentherm. Иногда эти значения можно поменять через сервисное меню котла, изучите документацию к котлу.

Closed 2024-12-30.

Thread 103 (2024-12-06):

No MQTT connection after upgrade to 1.5

Pajuris, 2024-12-06:
Strange, but I can not connect to Home assistant Mosquitto broker after update.
After few restarts (HA and OTGateway), opentherm gateway had appeared in HA. But after next OTGateway restart no connection again.
Connection to web interface is working good.

Laxilef, 2024-12-06:
Hi,
Please upload logs

Pajuris, 2024-12-06:
From where?

Pajuris, 2024-12-06:
Solution: need check MQTT enable in Settings. :)
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
Sorry...

Laxilef, 2024-12-06:
> * The names of some settings have been changed in this version. Not all settings will be restored from backup! Check them after restoration.
> * Sensor settings will not be restored automatically; they must be configured again on the Sensors settings page.
> * Very recommended to delete the device in Home Assistant before upgrading to avoid errors in the HA logs (due to the deletion of some entities)

Pajuris, 2024-12-06:
Thanks, Laxilef...
O have one more question. No switches turn on/off heeating and DHW in Home Assistant after update? Removed or I need to reenable its?

Laxilef, 2024-12-06:
Some entities have been removed or renamed. It is better to remove the device and add it again so that only working ones remain. To control heating and DHW, you must use the "climate" entities.

Pajuris, 2024-12-07:
OK. Thanks, Laxilef.

Closed 2024-12-06.

Thread 105 (2024-12-09):

Hysteresis 0 - Heating not stopped

Imaginous, 2024-12-09:
My Intergas Xtreme 30 heater slowly goes into a "thermal runaway" because it's running at modulation level 0% but still producing too much heat.

However the thermostat was set to 19.5 degrees and the current room temperature is also at 19.5 degrees.
I set the hysteresis degrees to 0, I was expecting that when the desired temperature was reached it would stop heating.
But it doesn't.

My possible solutions:

1. If hysteresis is set to 0, directly stop heating when set temperature is reached.
2. If the desired temperature is reached but the current temperature is (slowly) "running away" from the setpoint temperature (or more then 1 degree off) then stop heating.

I wonder what your point of view is on this "feature".

Running the latest V1.50 build.

Imaginous, 2024-12-09:
I don't want any hysteresis, set it to 0.
I expect that the OTGateway will stop heating as soon as it hits the set temperature.

This doesn't happen.

Laxilef, 2024-12-09:
You must correctly adjust the coefficients for pid/equitherm (which is used). Hysteresis should not be used instead.

Imaginous, 2024-12-10:
I will do some more tuning.

When does the system decide to stop heating, when the Equitherm or PID setpoint is below the minimum temperature of the heater?

Laxilef, 2024-12-10:
The boiler will automatically switch off the burner when the heat carrier temperature is above the setpoint.

The regulators do not stop the heating, they calculate the temperature of the heat carrier.

DallasJWilm, 2024-12-14:
I just upgraded to 1.5.0, so I could be wrong, but if it is anything like the previous versions, the setpoint is WATER setpoint, NOT room setpoint.  So probably what is happening is the boiler sees the call for heat (b/c Heat = enable), but is trying to limit the water temp (which it can't because in your case air temp = water temp).  For my Rinnai boiler, it turns the burner off and just cycles on to ~0% mod, to off and back and forth when that happens.  Apparently your boiler throttles to minimum modulation but keeps running.

For my case, heating concrete in a garage, I wanted to limit the the cycling.  So I had Home Assistant set water temp to + 30 deg F from room temp, then command flame = on/  Heat = enable for heat, and then command flame = off/ Heat =disable to turn off heat.  This way I do not have constant burner on/off cycling.  This was working, but for some reason lately I am having wi-fi reliability issues, so Home Assistant cannot get its commands to the ESP32 to tell it heating = enable/ heating = disable.

I believe OP's question/issue is related to a **feature request** of mine: Have the ability to tie Heating Enable to the indoor room temperature.  ESP32 thermostat is then a room temperature thermostat.  In my case, water temp would be a constant and heating = enable is based on room temperature.  This way, I would not be at the mercy of the wi-fi connection with home assistant to control the room temperature.

Laxilef, 2024-12-15:
@Imaginous, when using Equitherm + PID, Equitherm simply calculates the heat carrier temperature based on the outdoor temperature. PID additionally adjusts the heat carrier temperature until the indoor temperature is equal to the setpoint. The influence of the PID on the heat carrier temperature is limited by the minimum and maximum PID temperature settings.
Accordingly, when the indoor temperature is higher than the setpoint, the PID will decrease the temperature of the heat carrier. And increase it when the indoor temperature is lower than the setpoint.

Laxilef, 2024-12-15:
@DallasJWilm, enable and configure Equitherm or PID to regulate indoor temperature.

DallasJWilm, 2024-12-15:
Hi Laxilef,

Thanks, I do realize that equitherm and pid will regulate temperature.  I’d just like the ability to have heat enable be able to be set true/false based on indoor temperature. I think this may help the OP also. In any case, this is great software that gave me great insights to my boiler and I appreciate your hard work!

Laxilef, 2024-12-15:
Hi @DallasJWilm,
Well, you can create automation in your home assistant that will turn on/off the heating depending on the indoor temperature

DallasJWilm, 2024-12-15:
Thanks, I did do that.  It was working well until a couple weeks ago when wi-fi started dropping out and then HA couldn't reach it.  Signal is only about 55% or so, so that could be the problem.  I also tried upgrading to 1.5 to see if that has any effect.

Laxilef, 2024-12-15:
Is this a normal signal level, maybe the problem is something else? Try using static IP instead of DHCP

DallasJWilm, 2024-12-16:
Yes, that is about normal.  I already had a DHCP reservation, but I will try static.

Closed 2025-01-05.

Thread 106 (2024-12-09):

Modulation level doesnt work after upgrade

shaggee, 2024-12-09:
Today I upgraded D1 Mini ESP 32 from 1.4.0 to 1.5.0 and modulation level stays always 0% even boiler flame is on ant its heating.
Any advice to fix it?

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

Laxilef, 2024-12-09:
Hi,

Pls upload logs

shaggee, 2024-12-10:
> Hi,
>
> Pls upload logs

[logs.txt](https://github.com/user-attachments/files/18074718/logs.txt)

I found more missing diagnostic info which were visible in 1.4.0:
Boiler DHW max temp
Boiler DHW min temp
Boiler heating max te
Boiler heating min te
Diagnostic code
Modulation level

Laxilef, 2024-12-10:
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

```
[09:07:33][OT][DHW][NOTICE] Received min temp: 35 (converted: 35), max temp: 65 (converted: 65)
[09:07:33][OT][HEATING][NOTICE] Received min temp: 25 (converted: 25), max temp: 48 (converted: 48)
```

> Modulation level

```
[09:08:10][OT][NOTICE] Received modulation level: 38%, power: 14.46 of 25.00 kW (min: 8.00 kW)
```

> Diagnostic code

Not polled if fault/diag state is inactive

---

I see no problems in the logs.

Closed 2024-12-10.

Thread 107 (2024-12-10):

TEMP1 NOT WORK

freeupmao, 2024-12-10:
TEMP1 is not functioning properly, while TEMP2 is running normally. Using a multimeter to check the voltage, TEMP2 shows 3.3V and TEMP1 shows 0V.

My chip is WeMos Lua D1.
DS18B20

Laxilef, 2024-12-10:
Hi,

What adapter/board is used? Firmware version?

freeupmao, 2024-12-10:
https://oshwlab.com/lazydev/otgateway

freeupmao, 2024-12-10:
Version V.1.4.1 of this project's

> Hi,
>
> What adapter/board is used? Firmware version?

The firmware was upgraded to version 1.5.0 today, but TEMP1 is still not working."

Laxilef, 2024-12-10:
Check R2 on the board. This is a pull-up resistor.

upais, 2024-12-17:
My NTC sensor doesn't work on 1.5.0. ESP WROOM-32 board, connected to T2 (GPIO 26).
There were no problems on 1.4.6.

The logs only show this:
[00:01:48][SENSORS][NTC][WARN] GPIO 26, sensor #0 'Outdoor temp', voltage is out of threshold: 0.000

Laxilef, 2024-12-17:
> My NTC sensor doesn't work on 1.5.0. ESP WROOM-32 board, connected to T2 (GPIO 26).
> There were no problems on 1.4.6.

NTC sensors were not supported on 1.4.6

upais, 2024-12-17:
Sorry, thought it was them. Chose DALLAS and the problem was solved.

Closed 2025-01-06.

Thread 108 (2024-12-12):

Tuning regulator PID

andrey150960, 2024-12-12:
Здравствуйте, решил заморочиться с настройкой PID.
На сколько я понял OpenTherm Gateway PID min temp и OpenTherm Gateway PID max temp - это
температурный диапазон нагрева котла. Это так ?
При нажатии OpenTherm Gateway Tuning ни чего не происходит.
Т.е. автоматически коэффициенты не настраиваются.

Laxilef, 2024-12-12:
Здравствуйте,

Pid тюнер был давно вырезан из прошивки, т.к. нормально не работал и на версии 1.5.0 его нет. Коэффициенты подбираются вручную.

Минимальная и максимальная температура для Pid относится только к Pid, глобальное ограничение в секции Heating/отопление.

andrey150960, 2024-12-13:
Т.е если правильно понял "температура для Pid " это диапазон нагрева теплоносителя для PID.
Прошил на 1.5.0 , некоторые данные не отражаются в НА.
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

Laxilef, 2024-12-13:
> Very recommended to delete the device in Home Assistant before upgrading to avoid errors in the HA logs (due to the deletion of some entities)

andrey150960, 2024-12-14:
Понял спасибо. Можно закрывать.

andrey150960, 2024-12-14:
Понял спасибо

Closed 2024-12-14.

Thread 110 (2024-12-18):

Heating not stopping

cybuletz, 2024-12-18:
Hi,

I would like to understand what is the logic behind starting and stopping heating.
Sometimes, the climate entities stay on heating for up to 10 minutes before the heating starts and also the opposite, sometimes, the heating stops late even though the heating temperature is above the setpoint (see picture below). Histerezis 0.05. in OT GW and 0.1 on the climate.entities.

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

Laxilef, 2024-12-19:
Hi,

This is normal. The burner turns on when the heat carrier temperature is below setpoint-N. And it turns off when the heat carrier temperature is below setpoint+N.

N - boiler hysteresis, sometimes can be changed in the boiler service menu.

Laxilef, 2024-12-19:
https://github.com/Laxilef/OTGateway/wiki#fit-coefficients

Laxilef, 2024-12-19:
Look at the settings in the boiler service menu

Closed 2025-01-08.

Thread 111 (2024-12-21):

Failed receive boiler status: TIMEOUT

kuqqum, 2024-12-21:
Hi,

I have connected the Diylless board and configured as below. Everything looks fine accept the OpenTherm connection. My boiler is ATAG and can work with opentherm communications.
Is there a way to check this configuration.

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

Laxilef, 2024-12-22:
Hi,

1. Check GPIO
2. Also recommend studying the documentation for the boiler; may need to change some settings in the service menu of the boiler for opentherm devices to work.

Without detailed information I can't help.

kuqqum, 2024-12-22:
Hi,

1. GPIO settings are OK.

2. The ATAG boiler is connected (wired) and working over opentherm with "ATAG One"  thermostat. Ther's nothing I found in the documentation to change in the settings that can block communication.
3. The boiler is working properly after removing the thermostat and connecting the openTherm gateway without wornings or errors.

In the logs from MQTT there is a strange ip-address for homassistant after restart. This ip-address is not insite our network.

I hope you can help.

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

Laxilef, 2024-12-22:
Write the exact name of the adapter and ESP board.

> In the logs from MQTT there is a strange ip-address for homassistant after restart. This ip-address is not insite our network.

This is a docker network.

kuqqum, 2024-12-22:
The ESP board is ESP32_Devkitc_V4 with ESP32-VROOM-32D
And OPENTHERM MASTER SHIELD DIYLess.com.

Laxilef, 2024-12-22:
Can you upload a photo?
This shield is mainly used with Wemos type boards.

kuqqum, 2024-12-23:
Hi,
It's my intention to integrate ESP32_Devkitc_V4 with OT gateway into my floor heating system but that wasn't a good idea.  Now I flashed OT gateway into d1_mini32 and it's, standalone, working fine.

DHW in my boiler is only tapwater heating up for direct usage. Is it possible to manage this with OT gateway also?

Laxilef, 2024-12-24:
Any esp32 will work. The problem was probably in the wrong gpio, that's why I asked for a photo.

> DHW in my boiler is only tapwater heating up for direct usage. Is it possible to manage this with OT gateway also?

Of course

kuqqum, 2024-12-24:
Ok. Thanks. Then there is something missing. When I tap water, the boiler doesn’t start heating up. A three way valve has to change floating direction, but I don’t hear changing it. What can I do to find out what is going wrong. JoopOp 24 dec 2024 om 11:28 heeft Yurii ***@***.***> het volgende geschreven:
Any esp32 will work. The problem was probably in the wrong gpio, that's why I asked for a photo.

DHW in my boiler is only tapwater heating up for direct usage. Is it possible to manage this with OT gateway also?

Of course

—Reply to this email directly, view it on GitHub, or unsubscribe.You are receiving this because you authored the thread.Message ID: ***@***.***>

kuqqum, 2024-12-24:
Hi,
It's my intention to integrate ESP32_Devkitc_V4 with OT gateway into my floor heating system but that wasn't a good idea.  Now I flashed OT gateway into d1_mini32 and it's, standalone, working fine.

DHW in my boiler is only tapwater heating up for direct usage. Is it possible to manage this with OT gateway also?

kuqqum, 2024-12-24:
I checked again as you can see below.
DHW is not active after opening a tap.

Dashboard shows this:
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

OpenTherm settings are this:

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

kuqqum, 2024-12-24:
> DHW in my boiler is only tapwater heating up for direct usage. Is it possible to manage this with OT gateway also?

> Of course

Then I don't understand how my system ATAG E325EC knows there's need for hot tapwater. OT is not reporting a DHW flow rate.

kuqqum, 2024-12-24:
I asked chatGPT this question voor a E325EC, this is the answer:
To determine whether there is heat demand for domestic hot water or central heating:

Monitor the status of the boiler via the OpenTherm gateway or other reading device.
Check the status byte (message ID 0):
If Bit 0 (CH enable) is active: there is demand for CH.
If Bit 1 (DHW enable) is active: there is demand for hot water.
Check the current flow temperature and flame status as an additional check.

Laxilef, 2024-12-25:
Try OT option ``Duplicate DHW to CH2`` or/and ``DHW blocking``.

kuqqum, 2024-12-25:
All tree possibilities are with negative results.

Laxilef, 2024-12-26:
Well, I have no other suggestions 🤷‍♂️

kuqqum, 2024-12-26:
OK.
I will try to find out if there is any usage full information coming from the boiler after opening a HW tap.
It's absolutely unclear for me how this boiler detects that there is need for CV or DHW.

Laxilef, 2024-12-26:
There may be a sensor in the boiler that simply tells whether there is flow or not.

kuqqum, 2024-12-26:
In that case will always work independent from thermostat. But with Atag One thermostat DHW works. With OT thermostat not.
So there must be a communication between the Atag One thermostat and the boiler to allow DHW heating.

Is it possible that not all OT commands are visible in the terminal list?

[00:03:53][SENSORS][NOTICE] #3 'Heating return temp' new value 0: 30.00, compensated: 30.00, raw: 30.00
[00:03:54][OT][NOTICE] Received pressure: 1.74 (converted: 1.74)
[00:03:54][SENSORS][NOTICE] #8 'Pressure' new value 0: 1.74, compensated: 1.74, raw: 1.74
[00:03:55][OT][NOTICE] Received boiler status. Heating: 0; DHW: 0; flame: 0; cooling: 0; fault: 0; diag: 0
[00:03:55][SENSORS][NOTICE] #9 'Modulation level' new value 0: 0.00, compensated: 0.00, raw: 0.00
[00:03:55][SENSORS][NOTICE] #10 'Power' new value 0: 0.00, compensated: 0.00, raw: 0.00
[00:03:55][OT][DHW][NOTICE] Received temp: 13.88 (converted: 13.88)
[00:03:55][SENSORS][NOTICE] #5 'DHW temp' new value 0: 13.88, compensated: 13.88, raw: 13.88
[00:03:56][OT][HEATING][NOTICE] Received temp: 30.00
[00:03:56][SENSORS][NOTICE] #2 'Heating temp' new value 0: 30.00, compensated: 30.00, raw: 30.00
[00:03:56][OT][HEATING][NOTICE] Received return temp: 30.00 (converted: 30.00)
[00:03:56][SENSORS][NOTICE] #3 'Heating return temp' new value 0: 30.00, compensated: 30.00, raw: 30.00
[00:03:57][OT][NOTICE] Received pressure: 1.74 (converted: 1.74)
[00:03:57][SENSORS][NOTICE] #8 'Pressure' new value 0: 1.74, compensated: 1.74, raw: 1.74
[00:03:58][OT][NOTICE] Received boiler status. Heating: 0; DHW: 0; flame: 0; cooling: 0; fault: 0; diag: 0
[00:03:58][SENSORS][NOTICE] #9 'Modulation level' new value 0: 0.00, compensated: 0.00, raw: 0.00
[00:03:58][SENSORS][NOTICE] #10 'Power' new value 0: 0.00, compensated: 0.00, raw: 0.00
[00:03:58][OT][DHW][NOTICE] Received temp: 13.62 (converted: 13.62)
[00:03:58][SENSORS][NOTICE] #5 'DHW temp' new value 0: 13.62, compensated: 13.62, raw: 13.62
[00:03:59][OT][HEATING][NOTICE] Received temp: 29.88
[00:03:59][SENSORS][NOTICE] #2 'Heating temp' new value 0: 29.88, compensated: 29.88, raw: 29.88
[00:03:59][OT][HEATING][NOTICE] Received return temp: 30.00 (converted: 30.00)
[00:03:59][SENSORS][NOTICE] #3 'Heating return temp' new value 0: 30.00, compensated: 30.00, raw: 30.00
[00:03:59][OT][NOTICE] Received pressure: 1.74 (converted: 1.74)
[00:03:59][SENSORS][NOTICE] #8 'Pressure' new value 0: 1.74, compensated: 1.74, raw: 1.74
[00:04:00][SENSORS][NOTICE] #4 'Heating setpoint temp' new value 0: 32.14, compensated: 32.14, raw: 32.14
[00:04:01][OT][NOTICE] Received boiler status. Heating: 0; DHW: 0; flame: 0; cooling: 0; fault: 0; diag: 0
[00:04:01][SENSORS][NOTICE] #9 'Modulation level' new value 0: 0.00, compensated: 0.00, raw: 0.00
[00:04:01][SENSORS][NOTICE] #10 'Power' new value 0: 0.00, compensated: 0.00, raw: 0.00
[00:04:01][OT][DHW][NOTICE] Received temp: 13.50 (converted: 13.50)
[00:04:01][SENSORS][NOTICE] #5 'DHW temp' new value 0: 13.50, compensated: 13.50, raw: 13.50
[00:04:01][OT][HEATING][NOTICE] Received temp: 29.75
[00:04:01][SENSORS][NOTICE] #2 'Heating temp' new value 0: 29.75, compensated: 29.75, raw: 29.75
[00:04:02][OT][HEATING][NOTICE] Received return temp: 30.00 (converted: 30.00)
[00:04:02][SENSORS][NOTICE] #3 'Heating return temp' new value 0: 30.00, compensated: 30.00, raw: 30.00
[00:04:02][OT][NOTICE] Received pressure: 1.74 (converted: 1.74)
[00:04:02][SENSORS][NOTICE] #8 'Pressure' new value 0: 1.74, compensated: 1.74, raw: 1.74
[00:04:03][OT][NOTICE] Received boiler status. Heating: 0; DHW: 0; flame: 0; cooling: 0; fault: 0; diag: 0
[00:04:03][SENSORS][NOTICE] #9 'Modulation level' new value 0: 0.00, compensated: 0.00, raw: 0.00
[00:04:03][SENSORS][NOTICE] #10 'Power' new value 0: 0.00, compensated: 0.00, raw: 0.00
[00:04:04][OT][DHW][NOTICE] Received temp: 13.00 (converted: 13.00)
[00:04:04][SENSORS][NOTICE] #5 'DHW temp' new value 0: 13.00, compensated: 13.00, raw: 13.00
[00:04:04][OT][HEATING][NOTICE] Received temp: 29.62
[00:04:04][SENSORS][NOTICE] #2 'Heating temp' new value 0: 29.62, compensated: 29.62, raw: 29.62
[00:04:05][OT][HEATING][NOTICE] Received return temp: 30.00 (converted: 30.00)
[00:04:05][SENSORS][NOTICE] #3 'Heating return temp' new value 0: 30.00, compensated: 30.00, raw: 30.00
[00:04:05][OT][NOTICE] Received pressure: 1.75 (converted: 1.75)
[00:04:05][SENSORS][NOTICE] #8 'Pressure' new value 0: 1.75, compensated: 1.75, raw: 1.75
[00:04:06][OT][NOTICE] Received boiler status. Heating: 0; DHW: 0; flame: 0; cooling: 0; fault: 0; diag: 0
[00:04:06][SENSORS][NOTICE] #9 'Modulation level' new value 0: 0.00, compensated: 0.00, raw: 0.00
[00:04:06][SENSORS][NOTICE] #10 'Power' new value 0: 0.00, compensated: 0.00, raw: 0.00
[00:04:06][OT][DHW][NOTICE] Received temp: 13.62 (converted: 13.62)
[00:04:06][SENSORS][NOTICE] #5 'DHW temp' new value 0: 13.62, compensated: 13.62, raw: 13.62
[00:04:07][OT][HEATING][NOTICE] Received temp: 29.50
[00:04:07][SENSORS][NOTICE] #2 'Heating temp' new value 0: 29.50, compensated: 29.50, raw: 29.50
[00:04:07][OT][HEATING][NOTICE] Received return temp: 30.00 (converted: 30.00)
[00:04:07][SENSORS][NOTICE] #3 'Heating return temp' new value 0: 30.00, compensated: 30.00, raw: 30.00
[00:04:08][OT][NOTICE] Received pressure: 1.76 (converted: 1.76)
[00:04:08][SENSORS][NOTICE] #8 'Pressure' new value 0: 1.76, compensated: 1.76, raw: 1.76
[00:04:09][OT][NOTICE] Received boiler status. Heating: 0; DHW: 0; flame: 0; cooling: 0; fault: 0; diag: 0
[00:04:09][SENSORS][NOTICE] #9 'Modulation level' new value 0: 0.00, compensated: 0.00, raw: 0.00
[00:04:09][SENSORS][NOTICE] #10 'Power' new value 0: 0.00, compensated: 0.00, raw: 0.00
[00:04:09][OT][DHW][NOTICE] Received temp: 14.62 (converted: 14.62)
[00:04:09][SENSORS][NOTICE] #5 'DHW temp' new value 0: 14.62, compensated: 14.62, raw: 14.62
[00:04:09][OT][HEATING][NOTICE] Received temp: 29.50
[00:04:09][SENSORS][NOTICE] #2 'Heating temp' new value 0: 29.50, compensated: 29.50, raw: 29.50
[00:04:10][OT][HEATING][NOTICE] Received return temp: 29.88 (converted: 29.88)
[00:04:10][SENSORS][NOTICE] #3 'Heating return temp' new value 0: 29.88, compensated: 29.88, raw: 29.88
[00:04:10][OT][NOTICE] Received pressure: 1.75 (converted: 1.75)
[00:04:10][SENSORS][NOTICE] #8 'Pressure' new value 0: 1.75, compensated: 1.75, raw: 1.75
[00:04:10][SENSORS][NOTICE] #4 'Heating setpoint temp' new value 0: 32.14, compensated: 32.14, raw: 32.14
[00:04:11][OT][NOTICE] Received boiler status. Heating: 0; DHW: 0; flame: 0; cooling: 0; fault: 0; diag: 0
[00:04:11][SENSORS][NOTICE] #9 'Modulation level' new value 0: 0.00, compensated: 0.00, raw: 0.00
[00:04:11][SENSORS][NOTICE] #10 'Power' new value 0: 0.00, compensated: 0.00, raw: 0.00
[00:04:12][OT][DHW][NOTICE] Received temp: 16.00 (converted: 16.00)
[00:04:12][SENSORS][NOTICE] #5 'DHW temp' new value 0: 16.00, compensated: 16.00, raw: 16.00
[00:04:12][OT][HEATING][NOTICE] Received temp: 29.38
[00:04:12][SENSORS][NOTICE] #2 'Heating temp' new value 0: 29.38, compensated: 29.38, raw: 29.38
[00:04:13][OT][HEATING][NOTICE] Received return temp: 29.88 (converted: 29.88)
[00:04:13][SENSORS][NOTICE] #3 'Heating return temp' new value 0: 29.88, compensated: 29.88, raw: 29.88
[00:04:13][OT][NOTICE] Received pressure: 1.75 (converted: 1.75)
[00:04:13][SENSORS][NOTICE] #8 'Pressure' new value 0: 1.75, compensated: 1.75, raw: 1.75
[00:04:13][OT][DHW][INFO] Set temp: 60.00 (converted: 60.00, response: 60.00)
[00:04:15][OT][NOTICE] Received boiler status. Heating: 0; DHW: 0; flame: 0; cooling: 0; fault: 0; diag: 0
[00:04:15][SENSORS][NOTICE] #9 'Modulation level' new value 0: 0.00, compensated: 0.00, raw: 0.00
[00:04:15][SENSORS][NOTICE] #10 'Power' new value 0: 0.00, compensated: 0.00, raw: 0.00
[00:04:15][OT][DHW][NOTICE] Received temp: 17.12 (converted: 17.12)
[00:04:15][SENSORS][NOTICE] #5 'DHW temp' new value 0: 17.12, compensated: 17.12, raw: 17.12
[00:04:16][OT][HEATING][NOTICE] Received temp: 29.25
[00:04:16][SENSORS][NOTICE] #2 'Heating temp' new value 0: 29.25, compensated: 29.25, raw: 29.25
[00:04:16][OT][HEATING][NOTICE] Received return temp: 29.75 (converted: 29.75)
[00:04:16][SENSORS][NOTICE] #3 'Heating return temp' new value 0: 29.75, compensated: 29.75, raw: 29.75
[00:04:16][OT][NOTICE] Received pressure: 1.74 (converted: 1.74)
[00:04:16][SENSORS][NOTICE] #8 'Pressure' new value 0: 1.74, compensated: 1.74, raw: 1.74
[00:04:17][OT][NOTICE] Received boiler status. Heating: 0; DHW: 0; flame: 0; cooling: 0; fault: 0; diag: 0
[00:04:17][SENSORS][NOTICE] #9 'Modulation level' new value 0: 0.00, compensated: 0.00, raw: 0.00
[00:04:17][SENSORS][NOTICE] #10 'Power' new value 0: 0.00, compensated: 0.00, raw: 0.00
[00:04:18][OT][DHW][NOTICE] Received temp: 17.88 (converted: 17.88)
[00:04:18][SENSORS][NOTICE] #5 'DHW temp' new value 0: 17.88, compensated: 17.88, raw: 17.88
[00:04:18][OT][HEATING][NOTICE] Received temp: 29.12
[00:04:18][SENSORS][NOTICE] #2 'Heating temp' new value 0: 29.12, compensated: 29.12, raw: 29.12
[00:04:19][OT][HEATING][NOTICE] Received return temp: 29.62 (converted: 29.62)
[00:04:19][SENSORS][NOTICE] #3 'Heating return temp' new value 0: 29.62, compensated: 29.62, raw: 29.62
[00:04:19][OT][NOTICE] Received pressure: 1.58 (converted: 1.58)
[00:04:19][SENSORS][NOTICE] #8 'Pressure' new value 0: 1.58, compensated: 1.58, raw: 1.58
[00:04:20][OT][NOTICE] Received boiler status. Heating: 0; DHW: 0; flame: 0; cooling: 0; fault: 0; diag: 0
[00:04:20][SENSORS][NOTICE] #4 'Heating setpoint temp' new value 0: 32.14, compensated: 32.14, raw: 32.14
[00:04:20][OT][NOTICE] Received min modulation: 22%, max power: 0.00 kW
[00:04:21][OT][NOTICE] Set max modulation: 100% (response: 100%)
[00:04:21][OT][DHW][NOTICE] Received min temp: 40 (converted: 40), max temp: 65 (converted: 65)
[00:04:22][OT][HEATING][NOTICE] Received min temp: 20 (converted: 20), max temp: 85 (converted: 85)
[00:04:22][SENSORS][NOTICE] #9 'Modulation level' new value 0: 0.00, compensated: 0.00, raw: 0.00
[00:04:22][SENSORS][NOTICE] #10 'Power' new value 0: 0.00, compensated: 0.00, raw: 0.00
[00:04:22][OT][DHW][NOTICE] Received temp: 18.88 (converted: 18.88)
[00:04:22][SENSORS][NOTICE] #5 'DHW temp' new value 0: 18.88, compensated: 18.88, raw: 18.88
[00:04:22][OT][HEATING][NOTICE] Received temp: 29.00
[00:04:22][SENSORS][NOTICE] #2 'Heating temp' new value 0: 29.00, compensated: 29.00, raw: 29.00
[00:04:23][OT][HEATING][NOTICE] Received return temp: 29.62 (converted: 29.62)
[00:04:23][SENSORS][NOTICE] #3 'Heating return temp' new value 0: 29.62, compensated: 29.62, raw: 29.62
[00:04:23][OT][NOTICE] Received pressure: 1.47 (converted: 1.47)
[00:04:23][SENSORS][NOTICE] #8 'Pressure' new value 0: 1.47, compensated: 1.47, raw: 1.47
[00:04:24][OT][NOTICE] Received boiler status. Heating: 0; DHW: 0; flame: 0; cooling: 0; fault: 0; diag: 0
[00:04:24][SENSORS][NOTICE] #9 'Modulation level' new value 0: 0.00, compensated: 0.00, raw: 0.00
[00:04:24][SENSORS][NOTICE] #10 'Power' new value 0: 0.00, compensated: 0.00, raw: 0.00
[00:04:25][OT][DHW][NOTICE] Received temp: 19.38 (converted: 19.38)
[00:04:25][SENSORS][NOTICE] #5 'DHW temp' new value 0: 19.38, compensated: 19.38, raw: 19.38
[00:04:25][OT][HEATING][NOTICE] Received temp: 29.00
[00:04:25][SENSORS][NOTICE] #2 'Heating temp' new value 0: 29.00, compensated: 29.00, raw: 29.00
[00:04:26][OT][HEATING][NOTICE] Received return temp: 29.50 (converted: 29.50)
[00:04:26][SENSORS][NOTICE] #3 'Heating return temp' new value 0: 29.50, compensated: 29.50, raw: 29.50
[00:04:26][OT][NOTICE] Received pressure: 1.45 (converted: 1.45)
[00:04:26][SENSORS][NOTICE] #8 'Pressure' new value 0: 1.45, compensated: 1.45, raw: 1.45
[00:04:27][OT][NOTICE] Received boiler status. Heating: 0; DHW: 0; flame: 0; cooling: 0; fault: 0; diag: 0
[00:04:27][SENSORS][NOTICE] #9 'Modulation level' new value 0: 0.00, compensated: 0.00, raw: 0.00
[00:04:27][SENSORS][NOTICE] #10 'Power' new value 0: 0.00, compensated: 0.00, raw: 0.00
[00:04:28][OT][DHW][NOTICE] Received temp: 19.75 (converted: 19.75)
[00:04:28][SENSORS][NOTICE] #5 'DHW temp' new value 0: 19.75, compensated: 19.75, raw: 19.75
[00:04:28][OT][HEATING][NOTICE] Received temp: 29.00
[00:04:28][SENSORS][NOTICE] #2 'Heating temp' new value 0: 29.00, compensated: 29.00, raw: 29.00
[00:04:28][OT][HEATING][NOTICE] Received return temp: 29.50 (converted: 29.50)
[00:04:28][SENSORS][NOTICE] #3 'Heating return temp' new value 0: 29.50, compensated: 29.50, raw: 29.50
[00:04:29][OT][NOTICE] Received pressure: 1.44 (converted: 1.44)
[00:04:29][SENSORS][NOTICE] #8 'Pressure' new value 0: 1.44, compensated: 1.44, raw: 1.44
[00:04:30][OT][NOTICE] Received boiler status. Heating: 0; DHW: 0; flame: 0; cooling: 0; fault: 0; diag: 0
[00:04:30][SENSORS][NOTICE] #9 'Modulation level' new value 0: 0.00, compensated: 0.00, raw: 0.00
[00:04:30][SENSORS][NOTICE] #10 'Power' new value 0: 0.00, compensated: 0.00, raw: 0.00
[00:04:30][OT][DHW][NOTICE] Received temp: 20.12 (converted: 20.12)
[00:04:30][SENSORS][NOTICE] #5 'DHW temp' new value 0: 20.12, compensated: 20.12, raw: 20.12
[00:04:30][SENSORS][NOTICE] #4 'Heating setpoint temp' new value 0: 32.14, compensated: 32.14, raw: 32.14
[00:04:31][OT][HEATING][NOTICE] Received temp: 28.88
[00:04:31][SENSORS][NOTICE] #2 'Heating temp' new value 0: 28.88, compensated: 28.88, raw: 28.88
[00:04:31][OT][HEATING][NOTICE] Received return temp: 29.38 (converted: 29.38)
[00:04:31][SENSORS][NOTICE] #3 'Heating return temp' new value 0: 29.38, compensated: 29.38, raw: 29.38
[00:04:31][OT][NOTICE] Received pressure: 1.45 (converted: 1.45)
[00:04:31][SENSORS][NOTICE] #8 'Pressure' new value 0: 1.45, compensated: 1.45, raw: 1.45
[00:04:32][OT][NOTICE] Received boiler status. Heating: 0; DHW: 0; flame: 0; cooling: 0; fault: 0; diag: 0
[00:04:32][SENSORS][NOTICE] #9 'Modulation level' new value 0: 0.00, compensated: 0.00, raw: 0.00
[00:04:33][SENSORS][NOTICE] #10 'Power' new value 0: 0.00, compensated: 0.00, raw: 0.00
[00:04:33][OT][DHW][NOTICE] Received temp: 20.38 (converted: 20.38)
[00:04:33][SENSORS][NOTICE] #5 'DHW temp' new value 0: 20.38, compensated: 20.38, raw: 20.38
[00:04:33][OT][HEATING][NOTICE] Received temp: 28.88
[00:04:33][SENSORS][NOTICE] #2 'Heating temp' new value 0: 28.88, compensated: 28.88, raw: 28.88
[00:04:34][OT][HEATING][NOTICE] Received return temp: 29.25 (converted: 29.25)
[00:04:34][SENSORS][NOTICE] #3 'Heating return temp' new value 0: 29.25, compensated: 29.25, raw: 29.25
[00:04:34][OT][NOTICE] Received pressure: 1.43 (converted: 1.43)
[00:04:34][SENSORS][NOTICE] #8 'Pressure' new value 0: 1.43, compensated: 1.43, raw: 1.43
[00:04:35][OT][NOTICE] Received boiler status. Heating: 0; DHW: 0; flame: 0; cooling: 0; fault: 0; diag: 0
[00:04:35][SENSORS][NOTICE] #9 'Modulation level' new value 0: 0.00, compensated: 0.00, raw: 0.00
[00:04:35][SENSORS][NOTICE] #10 'Power' new value 0: 0.00, compensated: 0.00, raw: 0.00
[00:04:36][OT][DHW][NOTICE] Received temp: 20.62 (converted: 20.62)
[00:04:36][SENSORS][NOTICE] #5 'DHW temp' new value 0: 20.62, compensated: 20.62, raw: 20.62
[00:04:36][OT][HEATING][NOTICE] Received temp: 28.88
[00:04:36][SENSORS][NOTICE] #2 'Heating temp' new value 0: 28.88, compensated: 28.88, raw: 28.88
[00:04:37][OT][HEATING][NOTICE] Received return temp: 29.25 (converted: 29.25)
[00:04:37][SENSORS][NOTICE] #3 'Heating return temp' new value 0: 29.25, compensated: 29.25, raw: 29.25
[00:04:37][OT][NOTICE] Received pressure: 1.44 (converted: 1.44)
[00:04:37][SENSORS][NOTICE] #8 'Pressure' new value 0: 1.44, compensated: 1.44, raw: 1.44

Laxilef, 2024-12-27:
Pls try with Master member ID = 48

Laxilef, 2024-12-27:
> Is it possible that not all OT commands are visible in the terminal list?

Yes
Change log level to VERBOSE to display all messages

kuqqum, 2024-12-27:
I switch off the flowrate in the acceptation there isn't one, but I studied te electrical drawing and find out that there is a flow rate sensor present in the system, OT is not returning a value.
`[03:25:42][OT][VERB] ID:   19   Request: 80130000   Response: 70130000   Attempt:  1   Status: INVALID`
`[03:25:42][OT][DHW][WARN] Failed receive flow rate`

kuqqum, 2024-12-27:
>
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

Laxilef, 2024-12-27:
The boiler may not report the flow rate, but this does not mean that the DHW will not work.
The firmware does not control the operation of the burner, we simply tell the boiler what temperature it needs to maintain.

Laxilef, 2024-12-27:
I don't know why your DHW doesn't work. For other boilers this code works correctly. Try to set the Master member ID = 48

kuqqum, 2024-12-27:
WOW, you dit a great job. Flow rate is still not working but wat the heck. We don't have to shoer anymore with cold water...
Wat is the meaning of member ID = 48?
Thank you so much...

Laxilef, 2024-12-27:
> Wat is the meaning of member ID = 48?

This is the member id of the original ATAG thermostat.
Probably, there is a vendor lock in your boiler software. Thus, they prohibit the use of non-original ATAG thermostats.

kuqqum, 2024-12-30:
Oké. I'l do that. Gif me sum time. I'm very happy now.
Thanks again.

Closed 2025-01-19.

Thread 112 (2024-12-24):

Добавить округление значений в сенсоры

upais, 2024-12-24:
Приветствую.
Переработка настройки сенсоров отличная и удобная. Предлагаю добавить еще и округление значений после запятой. Значение той же температуры в виде 0.13 градусов не особо имеет смысл в такой точности, особенно с учетом погрешности измерений сами датчиков.

Laxilef, 2024-12-24:
Здравствуйте.
Значения округляются до 2 знаков после запятой, потому что просили в чате для сбора статистики. В home assistant можете выбрать округление до целого числа в настройках сущности.

upais, 2024-12-24:
1) Кому нужна статистика могли бы округлять до нужного им.
2) Home Assistant не обязательное ПО и не единственный УД.
3) В Home Assistant округление не работает в кастомных касточках, если в них нет такой поддержки. Либо шаблоны.
Тогда уж и коррекцию с фильтрацией можно было на HA переложить.

Ладно, дело автора.

Laxilef, 2024-12-25:
> Кому нужна статистика могли бы округлять до нужного им.

Если мы округлим в прошивке, то потом разокруглить значение не получится)

> Home Assistant не обязательное ПО и не единственный УД.

Это верно, поэтому сделано универсально. Если в другой системе УД есть возможность округления, то там это тоже можно сделать.

> В Home Assistant округление не работает в кастомных касточках, если в них нет такой поддержки.

В т.ч. в кастомных карточках же просто отображается значение сущности, если в настройках сущности поменять округление, то там оно не применяется?
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

upais, 2024-12-27:
> В т.ч. в кастомных карточках же просто отображается значение сущности, если в настройках сущности поменять округление, то там оно не применяется?

Как понимаю, HA не округляет значение до формирования самого сенсора, а делает это уже после и отображает в карточках. Но значение самого сенсора не меняется.
Вот пример. В панели разработчика тоже без округления.
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

Да, я понимаю, что сама доработка не имеет большой ценности, но она логично вписывается и если не трудозатратна, то почему бы и нет.

Closed 2024-12-24.

Thread 113 (2024-12-26):

Channel 1 and 2 independent activation based on indoor thermometer additional entity

Daveblanche, 2024-12-26:
Hi there,
With the changes you made recently to the firmware, does it look like it might be possible to make it so that channel 1 and channel 2 can call for heat independently based on the same equitherm settings?
My reason for asking:
System is ufh on channel 1…very slow and stable. Very efficient. Very smooth.
Channel 2 is a radiator based circuit which functions really when mirrored to channel 1, except for 1 room which has the garage underneath it so cools down much more quickly.

What this sometimes causes is the heating downstairs to switch off, if we are cooking or partying/creating heat, and that one room gets a lot colder.
I can cheat by just setting the basic equitherm curve to the heat loss for the home, with no k and T values, but then I am missing out on all the shift and other sexy settings the laxilef system provides.

all radiators have tado thermostats on them acting as temperature limiters only.

Laxilef, 2024-12-26:
Hi @Daveblanche
Does your boiler support two separate heating circuits?

Daveblanche, 2024-12-26:
Thanks for the quick response!

Yes, I think so. The system runs two circuits separately. Viessmann B1hc. So the radiator circuit (tado) can call for heat and the ufh (Heatmiser) can do so too…when not using the open therm system.

Laxilef, 2024-12-26:
Can you take a photo of the pipes connecting to the boiler? I knew that the protocol supports a second channel (circuit), but I have not seen such a boiler. Usually only DHW and one heating circuit.

Daveblanche, 2024-12-26:
Ok. Will do. It is an s-plan, I think.

I’ve drawn onto the pictures for a bit of clarity, I hope. Just remember that I do bones and biomechanics.

Viessmann B1hc
Top right is the motorized valve that controls just the underfloor heating.
the main pipe coming out the boiler on the left side is the one that runs the ufh.
The one bottom right horizontal, is the dhw priority motorised valve which also (I think) connects with the demand box for dhw, and the internal selector valve on the boiler.

So if the boiler is running just for the radiators, the top right valve is open.
If no heat is required for the ufh, then the separate pump for the ufh does not turn on, so no flow to ufh. (I think)

if ufh only is needed then the pump for ufh turns on and the channel 2 (radiator valve closes).

if both are needed then the ufh pump runs and the channel 2 valve opens.  Boiler main pump is running in all cases above.
the ufh pump only turns on when needed.

I also have the install manual for the boiler.
Happy to play sacrificial lamb here as a I think you should be getting these built and sold for income.
Also happy to help with any literature for users.

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

Laxilef, 2024-12-26:
Wow thanks
I need time to research this 😅

Laxilef, 2025-01-08:
Hi @Daveblanche

So far I don’t have any ideas on how this could be easily implemented. If we add another "thermostat" to control the second channel, we will have to add new indoor temperature sensors, Equitherm and PID instances for calculating the heat carrier temperature.
Implementing this feature requires a huge refactoring of the code, and unfortunately I don’t have free time for that right now.

If you have experience in programming, you can try to implement this feature and create a PR :) Or, if you have ideas on how this can be implemented, pls write them.

Daveblanche, 2025-01-11:
Hiya. I will have a look at this in a couple of weeks. I’ve never done any coding, but will have a go!
Will buy another Diyless thermostat and OpenTherm board.
I might need some pointers though, if you can sense check me.

Daveblanche, 2025-01-11:
Closed

Closed 2025-01-11.

Thread 114 (2024-12-27):

Strange problem

salvo76, 2024-12-27:
Hi, I installed the card on a Ferroli Bluehelix 24, I configured everything so that it can be seen by home assistant, and so far everything is ok, I can read all the water flow and return values, the burner, if I use hot water (DHW) I have the correct values   etc. etc. But on the heating part there is something that I can't get to work: all the values   seem correct, the opentherm reads the boiler but the heating doesn't start at all, I tried both equiterm, pid, or native of the boiler, but nothing, I attach a screen shot, could someone suggest something?

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

Laxilef, 2024-12-27:
Hi,
Show your OT settings

Laxilef, 2024-12-27:
Set:

✅ DHW present
❌ Summer/winter mode
✅ Heating CH2 always enabled
❌ Duplicate heating CH2 to CH2
❌ Duplicate DHW to CH2
❌ DHW blocking
❌ Sync modulation with heating
✅ Get min/max temp from boiler
❌ Native heating control

Restart the ESP, set the heating to 50 degrees and wait 5-10 minutes

Laxilef, 2024-12-27:
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
Have you removed the jumper from contacts 1-2?

salvo76, 2024-12-27:
Thanks, now the heating has started, already for 10 minutes but as a reference it has the temperature of the water in the radiators (50 C°), how can I manage it with the internal and external thermostats? The jumper is certainly removed

Laxilef, 2024-12-27:
Enable and configure Equitherm or/and PID.

salvo76, 2024-12-27:
Ok, thanks, I thought so too. One last thing, regarding the modulation percentage and the power in Kw, they are always at 0, is there a way to display them? It would be useful for me to have this data in heating.

Laxilef, 2024-12-27:
If the boiler does not report the modulation level, it is impossible to calculate the power in kW

salvo76, 2024-12-27:
On the DHW part, I can see the modulation percentage and it works, it oscillates according to the water required, but when I turn on the heating, it starts at about 37% and then drops to 0% after about 30 seconds, and it doesn't move anymore.

Laxilef, 2024-12-27:
It's normal. 0% modulation is the minimum power.
Configure minimum and maximum power in OT settings to display the current power in kW.

Closed 2025-01-16.

Thread 115 (2024-12-28):

1.5.0 Stability issues when boiler is not supporting enabled sensors

SanFable, 2024-12-28:
Hello,

I’ve been using OTGateway with my Beretta Ciao Green 25 C.S.I. boiler for about a year. It works fine with smart TRVs and Home Assistant, although the functionality is somewhat limited.

Recently, I updated to version 1.5.0 and switched to an ESP32-S3 (I also tried the ESP32-C3 with the same results). Previously, I was using version 1.4.5 with an ESP8266.

**The Issue**
After the update, the system became unstable:

- After about a minute, the OpenTherm Gateway status shows "problematic," and everything becomes unavailable.

- The ESP32-S3 seems to struggle:

- The web interface is very slow and unresponsive.
- Logs over Telnet are delayed and limited.
- With the ESP32-C3, the system was completely unreachable.

**What I Found**
I think the issue is caused by new sensors/IDs, such as:

- Return temperature
- Flow rate
- Exhaust temperature
- Pressure
- Minimum modulation
- Maximum power

In the logs, I saw warnings like:
`[WARN] Failed to receive ...`

It looks like the boiler doesn’t support these IDs, and they might be overloading the OpenTherm communication, causing it to crash.

**What Worked**
I turned off these new sensors and reconnected the OTGateway to the boiler. Since then, it’s been running stable for over 30 minutes, and the OpenTherm Gateway status is "OK."

Attaching [logs_1.txt](https://github.com/user-attachments/files/18266836/logs_1.txt) from a setup where I didn’t disable all the mentioned sensors (minimum modulation and maximum power were still enabled).
In the end, the ESP32 crashed, and the Telnet connection was lost.

I just realized that even after turning off the mentioned sensors in my successful run, I’m still seeing invalid request IDs 15 and 14 (minimum modulation, maximum power, and maximum modulation).

Attaching [logs_2.txt](https://github.com/user-attachments/files/18266837/logs_2.txt) from over 30 minutes of stable operation. However, there are still warnings in the logs from sensors that should be disabled. Could it be that something is overlapping when these sensors are enabled?

EDIT:
After about 6h I had few reconnections:
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

PS is there anything that I could do to improve support for my boiler?

tincanpete, 2024-12-29:
I believe I'm having the same issue. The symptoms are the same, and I have also recently upgraded to 1.5.0 but have not been able to get it running in any stable or reliable way.

I think the issue might have something to do with MQTT as I get better results with it turned OFF but have not absolutely verified this yet.

Daveblanche, 2024-12-29:
Hi both,
Quick question, but did you delete the HA instance of OpenTherm gateway on  mqtt before updating the firmware or chipset. Yuri warned of potential errors, if this was not done.

tincanpete, 2024-12-29:
Thanks @Daveblanche for the tip, but yes I definitely did do that as recommended. I think the issue is on the OT Gateway end not the HA end though. I'm going to continue to try to figure this out and will post more here as I make progress.

SanFable, 2024-12-29:
@Daveblanche
Before setup I have went to HA settings ->devices and services->mqtt->devices, selected opentherm and removed it. Then after installing new one I removed and added new cards in dashboard.

Regarding my stability, I had few reconnections yesterday, but at 23:00 I disabled logging (serial and telnet) and it failed only once a whole day for 40 seconds.

Laxilef, 2024-12-31:
Anyone who has problems with losing connection, test this build.
[1.5.1-testing.zip](https://github.com/user-attachments/files/18281198/1.5.1-testing.zip)

**And happy holidays!**

tincanpete, 2024-12-31:
Thank you @Laxilef I will give it a try!

SanFable, 2024-12-31:
@Laxilef @tincanpete

I have tested 1.5.1,
I have setup it like normal, kept telnet logs enabled, for 20mins I stayed with default settings and warns because boiler low support (just filled the mqtt section) and everything was stable. After that I have disabled sensors that are not existing in my boiler (thats shame its lacking some useful sensors...)

no reconnection since 2 hour, it works now. Page is responsive. No complaints. This state was not achievable on 1.5.0, Good job :)

I'm interested about @tincanpete feedback.

tincanpete, 2024-12-31:
Hello, I have also just tested 1.5.1 and while I thought there was some initial success, its seems no. Having MQTT enabled definitely makes things significantly worse.

I have attached a file showing repeated 'ping' to the board. When it's working well, I always see about 10-50ms. However as you can see it quickly becomes unstable and unresponsive; and will eventually sort-of come back to life but it seems quite random.

During the time when ping is very slow or dropped, the UI is also unresponsive, and if connected, the MQTT server will report the device is off-line. Sometimes my boiler will also report an OpenTherm communication error on its display.

When the problem goes away, everything goes back to normal and works OK, but often not long enough to be useful.

I'm using S2-mini board, and this ping trace was done with the gateway serial port, telnet, and logging all turned OFF to try and make sure that high level logging wasn't causing high load to be part of the problem.

[ping example.txt](https://github.com/user-attachments/files/18282836/ping.example.txt)

Thanks for your help!

SanFable, 2024-12-31:
@tincanpete
try following:
download current settings backup
reflash whole esp32 using PC (flash factory image and filesystem like new one)
when connecting to esp32 for the first time restore settings.
connect esp32 to the boiler.

In my case esp32-s3 seems fine, but when I changed to weaker esp-c3 it was nightmare, just not working. I guess I would have similar results as you.

If you still have problems maybe try disabling sensors that are not available on your boiler (to minimize warnings in logs)

I belive my [pings.txt](https://github.com/user-attachments/files/18282880/pings.txt) are fine, its wifi with signal 68-76% reported on OTG page.

tincanpete, 2024-12-31:
@SanFable I will try that, I did not use the "factory" image, just the normal one and upgraded via the UI.
I will report back my progress!
Thanks

tincanpete, 2025-01-01:
Still no joy unfortunately even after fully erasing and re-flashing the S2 and using the factory bin.

I have attached a larger log but just look at this extract from the end:

[00:02:55][SENSORS][NOTICE] #5 'DHW temp' new value 0: 11.20, compensated: 11.20, raw: 11.20
[00:02:56][OT][DHW][NOTICE] Received flow rate: 0.00 (converted: 0.00)
[00:02:56][SENSORS][NOTICE] #6 'DHW flow rate' new value 0: 0.00, compensated: 0.00, raw: 0.00
[00:02:56][OT][HEATING][NOTICE] Received temp: 10.00
[00:02:56][SENSORS][NOTICE] #2 'Heating temp' new value 0: 10.00, compensated: 10.00, raw: 10.00
[00:02:57][OT][HEATING][NOTICE] Received return temp: 10.60 (converted: 10.60)
[00:02:57][SENSORS][NOTICE] #3 'Heating return temp' new value 0: 10.60, compensated: 10.60, raw: 10.60
[00:02:58][OT][NOTICE] Received exhaust temp: 10.00 (converted: 10.00)
[00:02:58][SENSORS][NOTICE] #7 'Exhaust temp' new value 0: 10.00, compensated: 10.00, raw: 10.00
[00:02:58][OT][NOTICE] Received pressure: 0.80 (converted: 0.80)
[00:02:58][SENSORS][NOTICE] #8 'Pressure' new value 0: 0.80, compensated: 0.80, raw: 0.80
[00:02:59][OT][NOTICE] Received boiler status. Heating: 0; DHW: 0; flame: 0; cooling: 0; fault: 0; diag: 0
[00:02:59][SENSORS][NOTICE] #9 'Modulation level' new value 0: 0.00, compensated: 0.00, raw: 0.00
[00:02:59][SENSORS] #10 'Power' new value 0: 0.00, compensated: 0.00, raw: 0.00
[00:03:11][SENSORS][NOTICE] #4 'Heating setpoint temp' new value 0: 30.00, compensated: 30.00, raw: 30.00
[00:03:11][OT][DHW][NOTICE] Received temp: 11.00 (converted: 11.00)
[00:03:18][SENSORS][NOTICE] #5 'DHW temp' new value 0: 11.00, compensated: 11.00, raw: 11.00
[00:03:28][SENSORS][NOTICE] #4 'Heating setpoint temp' new value 0: 30.00, compensated: 30.00, raw: 30.00
[00:03:37][OT][DHW][NOTICE] Received flow rate: 0.00 (converted: 0.00)
[00:03:38][SENSORS][NOTICE] #6 'DHW flow rate' new value 0: 0.00, compensated: 0.00, raw: 0.00
[00:03:44][OT][HEATING][NOTICE] Received temp: 10.20
[00:03:53][SENSORS][NOTICE] #2 'Heating temp' new value 0: 10.20, compensated: 10.20, raw: 10.20
[00:03:55][SENSORS][NOTICE] #4 'Heating setpoint temp' new value 0: 30.00, compensated: 30.00, raw: 30.00
[00:03:55][OT][HEATING][NOTICE] Received return temp: 10.80 (converted: 10.80)
Connection closed by foreign host.

Note the time stamps from 2:59 onwards, there's a big delay between each one.

At the same time, the pings to the board are looking like this screenshot:

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

Full log file below:
[1.5.1 log.txt](https://github.com/user-attachments/files/18285697/1.5.1.log.txt)

All of this was with MQTT turned OFF by the way, which I thought would be better, but did not help actually.

thanks!
Pete

tincanpete, 2025-01-01:
To add to my previous comment, I did try disabling the "power" sensor which my boiler does not support, but it didn't seem to make any difference.

SanFable, 2025-01-01:
From my side, I had 2 reconnections every 24h using esp32s3. I assume esp32 s3 is powerful enough to handle something bad thats going on in the background. C3 was not usable.

Laxilef, 2025-01-01:
Guys, I can assume that the problem may be in the router. Let's check it: check how the web interface works when connected to the ESP access point, i.e. when the network is not yet configured on the ESP.

SanFable, 2025-01-01:
I'm using ubiquiti U7 pro. Everything was fine on previous versions (1.4.5 in my case with mini D1).

When first time configuring connected to ESP access point web interface is blazing fast. I will try to differ if it slows down after connecting to boiler or not.

UniFi controller doesn't show me problems, it says wifi experience excellent (95%+), some spikes to good (88%)

Laxilef, 2025-01-01:
> Everything was fine on previous versions (1.4.5 in my case with mini D1).

Test 1.5.0 on your D1 mini. Now you are testing on ESP32, these are different boards and there is a different SDK.

tincanpete, 2025-01-01:
Interesting idea, I had considered it might be a wifi/router issue, however the network is stable and has been for a long time, running Home Assistant and many other ESP-based devices (Shelly Relays and similar) without a problem. Do you think there's a chance my Wemos S2-mini board just "doesn't like" the wifi network? The problem was present, although not as severe, with software 1.4.5.

Daveblanche, 2025-01-01:
I’m on UniFi, too. Check your retry rates on the front page of UniFi network app. I had an issue a few weeks ago, with high retries, and it was down to channel choice/availability.

My network is incredibly stable, too.

Laxilef, 2025-01-01:
Something similar, and there was UniFi there too: https://community.home-assistant.io/t/opentherm-gateway-thermostat-with-full-integration-for-home-assistant/617228/128

SanFable, 2025-01-01:
I just have only one U7 Pro, no meshing.
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
TX retries, I would say opentherm is in the very middle of the devices. I just have noisy 2.4ghz. I'm on channel 1 20mhz which unifi auto choosen. I will experiment with others and check TX rate.

I will try d1 mini tomorrow.

Laxilef, 2025-01-02:
ESP32 C3 connected to mikrotik, OT not connected

[esp c3.webm](https://github.com/user-attachments/assets/1515f37c-fdbd-4ea9-acfe-92ee6973ef0e)

tincanpete, 2025-01-04:
I've not had a chance to try with Wireless AP only as the hardware is running in a shop we own and I've not been there for a couple of days. However, remotely monitoring it I have just noticed the "Uptime" on the UI homepage has been reset and the "Last Reset Reason" is showing "Reset due to other watchdogs". Does this offer any clues to you?

Laxilef, 2025-01-04:
> Does this offer any clues to you?

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

tincanpete, 2025-01-04:
No, "save debug data" just gives me this:
```

{
  "build": {
    "version": "1.5.1-testing",
    "date": "Dec 31 2024 02:02:27",
    "env": "s2_mini",
    "core": "3.1.0",
    "sdk": "v5.3.2-174-g083aad99cf-dirty"
  },
  "heap": {
    "total": 188452,
    "free": 55288,
    "minFree": 48052,
    "maxFreeBlock": 30708,
    "minMaxFreeBlock": 25588
  },
  "chip": {
    "model": "ESP32-S2",
    "rev": 100,
    "cores": 1,
    "freq": 240
  },
  "flash": {
    "size": 4194304,
    "realSize": 4194304
  },
  "crash": {
    "reason": "Reset due to other watchdogs",
    "core": 0,
    "heap": 58416,
    "uptime": 680780475
  }
}

```

Under what circumstances will Watchdog cause a reboot?

Laxilef, 2025-01-04:
Hmm, strange, there is no backtrace in the debug data. Without a backtrace it is impossible to find out the reason.
There may be many reasons, sometimes it is related to poor power supply of the ESP.

Symon84, 2025-01-05:
Hi, I have a similar issue with system instability (frequent disconnections).
The system seems to get saturated.
This happens exactly after modifying the values related to Emergency mode.

By default, I have these parameters:

    Target temperature: 40
    Threshold time: 120

My system is configured with a minimum flow temperature of 50 degrees.
If I change the target temperature to 50 degrees in Emergency mode and set the threshold to 120, the system stops working, becomes unstable, connects and disconnects continuously, and constantly activates Emergency mode.

I’ve tried this three times (always with firmware 1.5.0), and the issue has replicated every time.
The only way to restore the system is to erase the firmware and flash it again.

If I leave the Emergency mode values unchanged (40°C and 120 seconds), everything works correctly.

I hope this can help.
Thank you so much for the amazing work!

Symon84, 2025-01-05:
Never mind… the problem has now reappeared even without modifying the parameters.
I’ll try replacing the ESP8266 (D1 Mini) to see if it’s a hardware issue. I’ll keep you updated.
For the record, it worked perfectly for four consecutive days.

The disconnection issue occurs even if the device is not connected to the boiler.

Laxilef, 2025-01-05:
If your ESP is powered via USB, try replacing the power supply with a different one.

Symon84, 2025-01-07:
> If your ESP is powered via USB, try replacing the power supply with a different one.

Initially, the D1 mini was connected with an external stabilized power supply (via 5V pin).
I tried replacing the power supply with a USB type power supply but the problem persists.
I also tried to change the D1 mini with a new one, but I still have the same problem.
Today I give it a try by disabling the 5G wifi network, but I have many other devices (including D1 mini) connected, which never have data connection problems.

Laxilef, 2025-01-08:
Guys, I'm not saying there is no problem. But I don't know what causes the problem and how to fix it because I can't reproduce it.

Symon84, 2025-01-08:
Ok, I’ve run all the tests I could, including using version 1.5.1 and disabling the 5G WiFi network, but I haven’t seen any improvement.
I’ll try setting up an S2 mini to see if things get better.

Sorry for the question, but on the release page, what’s the difference between these two firmware files:

firmware_s2_mini_1.5.1.bin
firmware_s2_mini_1.5.1.factory.bin
Thank you very much!

Daveblanche, 2025-01-08:
Hi thereSorry, I’m travelling for work and don’t have great internet access. I’m making a massive assumption that this plugin is based on esphome?If so, have a look on the esphome site. It covers connection issues whilst using the single wire thermostat recommended in this project. But I may be wrong, obviously. D

Sent from Sky Yahoo Mail for iPhone

On Wednesday, January 8, 2025, 8:56 am, Simone ***@***.***> wrote:

Ok, I’ve run all the tests I could, including using version 1.5.1 and disabling the 5G WiFi network, but I haven’t seen any improvement.
I’ll try setting up an S2 mini to see if things get better.

Sorry for the question, but on the release page, what’s the difference between these two firmware files:

firmware_s2_mini_1.5.1.bin
firmware_s2_mini_1.5.1.factory.bin
Thank you very much!

—
Reply to this email directly, view it on GitHub, or unsubscribe.
You are receiving this because you were mentioned.Message ID: ***@***.***>

Laxilef, 2025-01-08:
> Sorry for the question, but on the release page, what’s the difference between these two firmware files:
>
> firmware_s2_mini_1.5.1.bin firmware_s2_mini_1.5.1.factory.bin

Factory for flashing via esptool, not factory for OTA.

Symon84, 2025-01-08:
> Maybe you have some other wifi router to compare with it?
>

Yes, but replacing the router is not a simple operation (I have many devices connected, including 4 D2 mini that have been working without problems for about a year..)
I keep this option as the "final" test..

>
> Factory for flashing via esptool, not factory for OTA.
> >
Ok! I've tried with an wemos s2 mini, but I have the same problem..
I've also disabled telnet, serial port and log without any improvement..

As soon as I have some free time I will do more tests..

Symon84, 2025-01-09:
> You can just turn on another router, connect the ESP and your computer to it. You do not need to configure Internet access for this router. To test, you don't need to change the router for all devices :)

In this case I will try as soon as possible and I will check through a ping, even if it will not be connected to home Assistant via MQTT. Thanks!

Symon84, 2025-01-10:
Guys, I found the issue in my case.
Even though the Wemos is installed just 2 meters away from the router and the RSSI signal is -54 dBi, the frequent disconnections are due to the placement of the device (near the boiler).
The boiler has a metal casing, which probably interferes with the signal in some way, even though the Wemos is close to it.
I’ll have to modify the Wemos by adding an external antenna.

It didn’t occur to me immediately because I have other D1 Minis inside walls, near mains voltage, and even 8 meters away from the router, which have no issues at all. Probably, the area near the boiler (even though very close to the router) is subject to interference.

In the following image, you can see how moving the D1 changes the situation: the red zone is where it was near the boiler, while even moving it just a few centimeters makes the connection stable enough.
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

Laxilef, 2025-01-10:
Well, if you placed the ESP inside the boiler, then you made a shielded box for it 😄
In fact, there are many electronics in the boiler that can interfere with the ESP if the ESP is located near the boiler electronics. For example, the ignition works from high voltage, which can sometimes even interfere with the bus.

Now I wonder if other users from this issue have the same reason or not.

Laxilef, 2025-01-10:
@SanFable can you try moving the ESP further away from the boiler?

Symon84, 2025-01-10:
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

😅 No, the ESP is outside the boiler, about 20 cm away inside a plastic box, but it is probably still too close to the boiler that somehow interferes with wireless communication.

Symon84, 2025-01-15:
I need to revise my previous statement. The connection actually remained stable for almost two days, but then the same issues resurfaced. I tried moving the device closer to the router, but the problem persists. I downgraded to version 1.4.6, but this didn’t bring any improvements.

I’m investigating other possible causes. It seems that the Wemos gradually slows down over time, eventually causing intermittent Wi-Fi disconnections. I’ll share an update if I find a solution to the issue.

Laxilef, 2025-01-16:
> It seems that the Wemos gradually slows down over time, eventually causing intermittent Wi-Fi disconnections.

In case of memory leaks, ESP restarts would occur.

inediblepotato, 2025-01-18:
I appear to have similar stability issues after upgrading from 1.4.6 to 1.5.1 on my DIYless (D1 mini 32).

I had backed up, upgraded, restored as in the instructions and I deleted the old MQTT device in HA and let it reappear after the upgrade. Then re-added the indoor and outdoor reporting automations, which appear to work.

HA shows the Opentherm gateway status as problem every few mins, and all other entities unavailable, screenshot attached.
I disabled any sensors that were coming back as failed-to-receive in the logs (pressure, exhaust temp, etc.), though the failed to receive exhaust temp, DHW temp and flow rate were also present in 1.4.6.  I also tried disabling telnet temporarily but did not observe any improvement in stability.

I saved some logs from telnet over a few mins during problem status moments but I dont see anything revealing. I attach them too.

To make sure it wasn't a WiFi strength connection issue, I restarted the router, and tried another model (both openWRT), re positioned the device away from anything, it was already well positioned and close to the router. But nothing has improved the stability. No other devices have connection issues.

I've had to revert to 1.4.6 to keep the house warm, which seems to be working fine again.
Very grateful for the software, been working for months without issue, so please let me know if I can help or provide or do any testing.

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

[OpenThermTelnetLog.txt](https://github.com/user-attachments/files/18465189/OpenThermTelnetLog.txt)

Laxilef, 2025-01-18:
Hi @inediblepotato

Thanks for the detailed information. I looked at the log and don't see any problems, so I have a few questions:
1. Does the device lose connection to wifi?
2. Does the web interface work when entities are "unavailable" in HA?
3. Are there reboots caused by watchdog?

Symon84, 2025-01-19:
I think I’ve solved it in my case.
It wasn’t just an issue of the Wemos D1 Mini being too close to the boiler, but also a problem with the Wi-Fi network.
In some cases, I had an X-Sense smoke detector, which didn’t have a static IP assigned, randomly taking the IP address of the Wemos where I have the OpenTherm Gateway installed.
After fixing the IP addresses, the system started to remain stable!
I cared a lot about this because I really love this project!
Thank you.

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

SanFable, 2025-01-19:
@Symon84 log it for few days. In my case I could have few days ok then one random problem once a day.

I have static ip assigned.

Unfortunately I couldn't move away esp because it's glued :c

Symon84, 2025-01-19:
> log it for few days

Certainly, I’ll let you know in a few days if everything is going well.

Symon84, 2025-01-24:
@SanFable at the moment I have had no problems for 80 hours.
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
The version installed is v1.5.1

inediblepotato, 2025-01-24:
Hi @Laxilef ,

I got a chance to test the 1.5.2 release today and tried to get answers to your questions.
I did the same procedure, deleting the old device in HA, upgrading, restoring settings, re-enabling sensors updates.
The system was similarly unstable as before. I attach a similar HA screenshot.
I recorded telnet logs and ping logs for half an hour roughly but again nothing illuminating.

1. No the device doesn't lose connection to wifi, ping logs shows that but also in router logs, no disconnects.
2. The web interface works during the whole period. It was responsive, no issues.
3. There were no unprompted reboots that I could see in the logs. I changed the verbosity of the log output half way but still nothing indicating a problem.
4. I'm using an up to date eclipse-mosquitto MQTT server running in a docker image. Not much config change from vanilla. Anonymous messages are permitted so I can debug things. I see in the logs that many clients exceed timeout and disconnect only to be directly connected again, opentherm gateway included. But I see these messages when opentherm 1.4.6 is running also. This timeout duration is set by the client as far as I know, not by the server. No other MQTT device on the networks appears to have stability issues. I include an example of the grepped mosquitto logs and my mosquitto.config.

The mosquitto docker stats show no issues, its not taxed, and other than the frequent disconnects from timeouts no other issues in the MQTT logs.

I tried the firmware_d1_mini32_1.5.2.bin, and the firmware_d1_mini32_1.5.2.factory.bin but same behaviour. The attached logs are from the firmware_d1_mini32_1.5.2.bin firmware.

For completeness of info, the device has a static IP set by the router. The traffic on the rest of the network during the testing period is low.

I reverted back to 1.4.6 and all is working well again. Let me know if I can collect anything else.

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

[OpenThermTelnetLog2.txt](https://github.com/user-attachments/files/18539308/OpenThermTelnetLog2.txt)
[pingLog.txt](https://github.com/user-attachments/files/18539309/pingLog.txt)

Laxilef, 2025-01-24:
Hi @inediblepotato
Thanks. Yes, it seems to have something to do with mqtt keep alive, although it should send a ping packet to keep the connection alive. Since LWT (Last Will and Testament) is triggered when disabled, all entities are marked as unavailable.

It's not very clear why ping doesn't work, but we can try increasing the timeout. Can you compile the firmware from the master branch and test it?

Symon84, 2025-02-05:
At certain times of the day, I still experience peaks of continuous disconnections of the device (even with version 1.5.3).
After analyzing the Home Assistant Core log, it appears that the disconnection times align with the following error:

`Registratore: homeassistant.helpers.template
Fonte: helpers/template.py:821
Prima occorrenza: 12:39:04 (106 occorrenze)
Ultimo accesso: 15:42:02

Error parsing value: 'value_json' is undefined (value: {"heating":{"enabled":true,"turbo":false,"target":20.5,"hysteresis":0.5,"turboFactor":7.5,"minTemp":50,"maxTemp":65},"dhw":{"enabled":true,"target":50,"minTemp":35,""enabled":true,"p_factor":4.5,"i_factor":0.07,"d_factor":0.3,"dt":1800,"minTemp":-10,"maxTemp":10,"deadband":{"enabled":true,"p_multiplier":1,"i_multiplier":0.07,"d_multiplier":1,"thresholdHigh":0.5,"thresholdLow":0.5}}}1R
opentherm/sensors/outdoor_temp{"connected":true,"signalQuality":100,"value":9.5}1R
ope, template: {{ value_json.heating.minTemp|float(0)|round(1) }})
Error parsing value: 'value_json' is undefined (value: {"heating":{"enabled":true,"turbo":false,"target":20.5,"hysteresis":0.5,"turboFactor":7.5,"minTemp":50,"maxTemp":65},"dhw":{"enabled":true,"target":50,"minTemp":35,""enabled":true,"p_factor":4.5,"i_factor":0.07,"d_factor":0.3,"dt":1800,"minTemp":-10,"maxTemp":10,"deadband":{"enabled":true,"p_multiplier":1,"i_multiplier":0.07,"d_multiplier":1,"thresholdHigh":0.5,"thresholdLow":0.5}}}1R
opentherm/sensors/outdoor_temp{"connected":true,"signalQuality":100,"value":9.5}1R
ope, template: {{ value_json.pid.p_factor|float(0)|round(3) }})
Error parsing value: 'value_json' is undefined (value: {"heating":{"enabled":true,"turbo":false,"target":20.5,"hysteresis":0.5,"turboFactor":7.5,"minTemp":50,"maxTemp":65},"dhw":{"enabled":true,"target":50,"minTemp":35,""enabled":true,"p_factor":4.5,"i_factor":0.07,"d_factor":0.3,"dt":1800,"minTemp":-10,"maxTemp":10,"deadband":{"enabled":true,"p_multiplier":1,"i_multiplier":0.07,"d_multiplier":1,"thresholdHigh":0.5,"thresholdLow":0.5}}}1R
opentherm/sensors/outdoor_temp{"connected":true,"signalQuality":100,"value":9.5}1R
ope, template: {{ value_json.pid.dt|int(0) }})
Error parsing value: 'value_json' is undefined (value: {"heating":{"enabled":true,"turbo":false,"target":20.5,"hysteresis":0.5,"turboFactor":7.5,"minTemp":50,"maxTemp":65},"dhw":{"enabled":true,"target":50,"minTemp":35,""enabled":true,"p_factor":4.5,"i_factor":0.07,"d_factor":0.3,"dt":1800,"minTemp":-10,"maxTemp":10,"deadband":{"enabled":true,"p_multiplier":1,"i_multiplier":0.07,"d_multiplier":1,"thresholdHigh":0.5,"thresholdLow":0.5}}}1R
opentherm/sensors/outdoor_temp{"connected":true,"signalQuality":100,"value":9.5}1R
ope, template: {{ value_json.pid.maxTemp|float(0)|round(1) }})
Error parsing value: 'value_json' is undefined (value:
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

Thread 116 (2024-12-29):

Maximum temperature settings bug(s) in UI

culdaraul, 2024-12-29:
The newly set temperature is not saved after it is changed in UI.

I think initially after flashing, it was changed after the 1st attempt. Afterwards, it cannot be changed anymore. After a few (dummy) retries, sometimes is changed, sometimes not. Also, changing it via MQTT from Home Assistant has no effect.

HW Setup: ESP32 D1 Mini w/ Opentherm D1 shield. Opentherm comm is established. Indoor/Outdoor sensors fed via MQTT from HomeAssistant via the provided Blueprint in the docs.

There are several bugs, mainly in the UI:
- if there's a sensor configured via GPIO, even if it is disabled, you cannot configure the OpenTherm IN/OUT ports to that GPIO
- for some reason, the "RX Led" in the Opentherm settings had the same GPIO default value as the Rx PIN. Changing it to "blank" / not used is not taken into consideration unless HW Reset is performed. Checked with scope, that Rx PIN had a strong Pull-Down configuration before issuing the reset.
- Switching between Fahrenheit and Celsius would mess all the temperature settings. I ended-up with a hysteresis of 15 and min temperature with "minus"
- Changing the max temp obviously doesn't work. Somehow after a few tens of retries, I could change from 21 to 38 deg C but I'm not able to set it to 45.

Laxilef, 2024-12-30:
Hi,

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

Can you upload the video? I don't quite understand.

> Changing it to "blank" / not used is not taken into consideration unless HW Reset is performed. Checked with scope, that Rx PIN had a strong Pull-Down configuration before issuing the reset.

Thanks, I'll check it.

> if there's a sensor configured via GPIO, even if it is disabled, you cannot configure the OpenTherm IN/OUT ports to that GPIO

The project code does not check for the used GPIOs, this is the responsibility of the user. But there is a validation of the GPIO. If you try to set a non-existent GPIO, the system will not accept these settings.

Laxilef, 2024-12-31:
> * for some reason, the "RX Led" in the Opentherm settings had the same GPIO default value as the Rx PIN. Changing it to "blank" / not used is not taken into consideration unless HW Reset is performed. Checked with scope, that Rx PIN had a strong Pull-Down configuration before issuing the reset.

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

culdaraul, 2025-01-02:
Turns out that the issue with the "maximum temperature" was due to the option named "Get min/max temp from boiler" which was by default activated after I flashed the board. Solved for now.

Symon84, 2025-01-19:
I’d like to add that in the latest version 1.5.1, it’s not possible to manually enter a negative temperature for the PID minimum temperature, but if I copy and paste it from text, it works.
Thank you.

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

Laxilef, 2025-01-20:
Hi @Symon84
Test it with the master branch. Thx.

Symon84, 2025-01-28:
> Hi @Symon84
> Test it with the master branch. Thx.

Ok, in this case, the possibility of inserting the comma appeared, but not the minus symbol. In any case, through the Home Assistant interface there are no problems..

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

Closed 2025-02-17.

Thread 117 (2024-12-30):

Error 00 (diagnostics)

Symon84, 2024-12-30:
Hi, congratulations on the excellent project!
I’m writing regarding a small issue:
I have a Baxi Duo-Tec compact E 24 boiler.
I’m receiving an error code 00 (0x00) from the diagnostics.
The gateway is installed on an ESP8266 (Wemos D1 Mini clone).
The system communicates with Home Assistant via MQTT.
Everything seems to be working fine anyway.

Thank you very much!

Laxilef, 2024-12-30:
Hi,

Pls show a screenshot

Laxilef, 2024-12-30:
Thanks. Yes, it seems to be a trick of your boiler (although my Duo-Tec does not have this).
Usually the diagnostic flag does not affect anything, but sometimes the diagnostic code can be a fault code.

> Heating blocked (I think it’s normal when the room reaches the set temperature)

Yes

Symon84, 2024-12-30:
OK, thank you! I thought it was due to the power set because changing it sometimes the error disappears and it doesn't come back for hours.. I configured MAX 24 kW and MIN 3.5 kW, is that correct? I attach a photo of the boiler label:

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

Laxilef, 2024-12-30:
For condensing boilers, I prefer to calculate the average value (of 80/60 and 50/30).

Min power: (3.4 + 3.7) / 2 = 3.55 kW
Max power: (20 + 21.8) / 2 = 20.9 kW

Symon84, 2024-12-30:
Ok! Thanks!!!
But there's a little bug in the UI:
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

In the form, it is not possible to enter a number with double precision (it’s not a big issue).
If I access the interface using an iPhone (Safari), it’s not possible to enter numbers with a decimal point (the keyboard doesn’t show it); the only way is to write it somewhere else and copy-paste it.
Sorry for mentioning it here even though it’s unrelated to the post’s title.

Laxilef, 2024-12-30:
> In the form, it is not possible to enter a number with double precision (it’s not a big issue).
> If I access the interface using an iPhone (Safari), it’s not possible to enter numbers with a decimal point (the keyboard doesn’t show it); the only way is to write it somewhere else and copy-paste it.

Thanks, fixed

Symon84, 2024-12-31:
> Thanks, fixed

🔝 thanks!! 🤗

Closed 2025-01-08.

Thread 118 (2024-12-30):

Make switch possible

kuqqum, 2024-12-30:
It woud be great if it can be made possible to select as purpose "Switch"   and as type "on/off" and make this available as entity in HA.
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

Daveblanche, 2024-12-30:
To switch heating on and off? It is already available.
Switch.opentherm_heating/turbo/pid/equitherm are there in mqtt for you to play with.

unless I misunderstand you?

kuqqum, 2024-12-31:
Yes you missed the clou!

Daveblanche, 2024-12-31:
Hmmm

kuqqum, 2024-12-31:
To independently manage the vast and complex world of available (energy) systems, regardless of the manufacturer, there is insufficient control equipment available.
When a basic energy solution is implemented and a specific manufacturer is chosen, it is often logical to continue expanding with the same manufacturer. However, not every manufacturer can provide the most optimal solution for every situation. This frequently results in a combination of equipment from different manufacturers, which are not easily integrated due to inadequate or non-functional communication between control systems. Examples include heating/hot water systems, solar energy installations, home batteries, charging systems for electric vehicles, and energy management systems.

Home Assistant is a platform that can bring all these elements together into a unified and coherent system.
Unfortunately, good interfaces such as OpenTherm Gateway are often lacking. Moreover, there is a need not only for sensors but also for switches that can turn elements on or off. Hence my request.

Laxilef, 2024-12-31:
I recommend you to look at zigbee relay and esphome to solve this problem. Inside Home Assistant you can control different devices and create automations with them.

Trying to implement all possible functionality in one device is not a good idea. In the project, I try to implement only those features that relate to heating.

Closed 2025-01-20.

Thread 119 (2024-12-31):

Logging changes don't persist across restarts

tincanpete, 2024-12-31:
Hi, while experimenting with both 1.5.0 and 1.5.1 trying to resolve #115 , I have noticed another issue.

Changing the following options in the UI:
* enable serial port
* enable telnet
* Log level
* and possibly others, I haven't tested

The options save OK and if the page is refreshed, the new values are shown.

However, when the board is restarted, the have gone back to the original, earlier values.

I wonder if this issue is related to #116 possibly since that one was also reporting "newly set temperature is not saved after it is changed in UI".

Thanks
Pete

Laxilef, 2024-12-31:
Hi,

> However, when the board is restarted, the have gone back to the original, earlier values.

How long after saving do you restart the ESP and how?
Settings are saved in EEPROM no more than once every 60 seconds.

tincanpete, 2024-12-31:
Oh that's interesting, no I wasn't waiting that long. I was trying to re-enable Telnet when I discovered the issue which says it needs a restart, so did that right away. Restart by disconnect USB power and reconnect.  I'll try again after waiting and will let you know if the issue can be closed. Thanks!

Laxilef, 2024-12-31:
You can restart the ESP with a button from the web, then the settings will be saved before restarting

tincanpete, 2025-01-01:
OK there's no issue here after all, I've tested as you suggest and everything is saved OK. Thanks for your help.

Closed 2025-01-01.

Thread 120 (2025-01-08):

Can not build ESP32 in platformio

Phunkafizer, 2025-01-08:
I can not build the project for all ESP32 targets. ESP8266 targets are building fine.
Tried on two different machines running Win11 with VS code. Other projects with ESP32 build just fine.

********************************************************************************
If you like PlatformIO, please:
- star it on GitHub > https://github.com/platformio/platformio-core
- follow us on LinkedIn to stay up-to-date on the latest project news > https://www.linkedin.com/company/platformio/
********************************************************************************

Warning! Ignore unknown configuration option `version` in section [env]
Warning! Ignore unknown configuration option `version` in section [env]
Resolving esp32_c6 dependencies...
Tool Manager: Installing https://github.com/espressif/arduino-esp32/releases/download/3.1.0/esp32-3.1.0.zip
Downloading 0% 10% 20% 30% 40% 50% 60% 70% 80% 90% 100%
Unpacking 0% 10% 20% 30% 40% 50% 60% 70% 80% 90% 100%
Tool Manager: framework-arduinoespressif32@3.1.0 has been installed!
Tool Manager: Installing https://github.com/espressif/esp32-arduino-lib-builder/releases/download/idf-release_v5.3/esp32-arduino-libs-idf-release_v5.3-083aad99-v2.zip
Downloading 0% 10% 20% 30% 40% 50% 60% 70% 80% 90% 100%
Unpacking 0%Unpacking...
FileNotFoundError: Traceback (most recent call last):
  File "C:\Users\post\.platformio\penv\Lib\site-packages\platformio\package\manager\_install.py", line 37, in unpack
    return fu.unpack(dst, with_progress=with_progress)
           ^^^^^^^^^^^^^^^^^^^^^^^^^^^^^^^^^^^^^^^^^^^
  File "C:\Users\post\.platformio\penv\Lib\site-packages\platformio\package\unpack.py", line 185, in unpack
    self._archiver.extract_item(item, dest_dir)
  File "C:\Users\post\.platformio\penv\Lib\site-packages\platformio\package\unpack.py", line 49, in extract_item
    self._afo.extract(item, dest_dir)
  File "C:\Users\post\.platformio\python3\Lib\zipfile.py", line 1664, in extract
    return self._extract_member(member, path, pwd)
           ^^^^^^^^^^^^^^^^^^^^^^^^^^^^^^^^^^^^^^^
  File "C:\Users\post\.platformio\python3\Lib\zipfile.py", line 1735, in _extract_member
    open(targetpath, "wb") as target:
    ^^^^^^^^^^^^^^^^^^^^^^
FileNotFoundError: [Errno 2] No such file or directory: 'c:\\Users\\post\\Desktop\\OTGateway\\.pio\\.cache\\tmp\\pkg-installing-ggasz_jk\\esp32-arduino-libs\\esp32\\include\\espressif__esp_matter\\connectedhomeip\\connectedhomeip\\src\\app\\clusters\\boolean-state-configuration-server\\BooleanStateConfigurationTestEventTriggerHandler.h'

During handling of the above exception, another exception occurred:

Traceback (most recent call last):
  File "C:\Users\post\.platformio\penv\Lib\site-packages\platformio\__main__.py", line 103, in main
    cli()  # pylint: disable=no-value-for-parameter
    ^^^^^
  File "C:\Users\post\.platformio\penv\Lib\site-packages\click\core.py", line 1157, in __call__
    return self.main(*args, **kwargs)
           ^^^^^^^^^^^^^^^^^^^^^^^^^^
  File "C:\Users\post\.platformio\penv\Lib\site-packages\click\core.py", line 1078, in main
    rv = self.invoke(ctx)
         ^^^^^^^^^^^^^^^^
  File "C:\Users\post\.platformio\penv\Lib\site-packages\platformio\cli.py", line 85, in invoke
    return super().invoke(ctx)
           ^^^^^^^^^^^^^^^^^^^
  File "C:\Users\post\.platformio\penv\Lib\site-packages\click\core.py", line 1688, in invoke
    return _process_result(sub_ctx.command.invoke(sub_ctx))
                           ^^^^^^^^^^^^^^^^^^^^^^^^^^^^^^^
  File "C:\Users\post\.platformio\penv\Lib\site-packages\click\core.py", line 1688, in invoke
    return _process_result(sub_ctx.command.invoke(sub_ctx))
                           ^^^^^^^^^^^^^^^^^^^^^^^^^^^^^^^
  File "C:\Users\post\.platformio\penv\Lib\site-packages\click\core.py", line 1434, in invoke
    return ctx.invoke(self.callback, **ctx.params)
           ^^^^^^^^^^^^^^^^^^^^^^^^^^^^^^^^^^^^^^^
  File "C:\Users\post\.platformio\penv\Lib\site-packages\click\core.py", line 783, in invoke
    return __callback(*args, **kwargs)
           ^^^^^^^^^^^^^^^^^^^^^^^^^^^
  File "C:\Users\post\.platformio\penv\Lib\site-packages\platformio\project\commands\init.py", line 106, in project_init_cmd
    install_project_dependencies(
  File "C:\Users\post\.platformio\penv\Lib\site-packages\platformio\package\commands\install.py", line 107, in install_project_dependencies
    already_up_to_date = not install_project_env_dependencies(env, options)
                             ^^^^^^^^^^^^^^^^^^^^^^^^^^^^^^^^^^^^^^^^^^^^^^
  File "C:\Users\post\.platformio\penv\Lib\site-packages\platformio\package\commands\install.py", line 132, in install_project_env_dependencies
    _install_project_env_platform(project_env, options),
    ^^^^^^^^^^^^^^^^^^^^^^^^^^^^^^^^^^^^^^^^^^^^^^^^^^^
  File "C:\Users\post\.platformio\penv\Lib\site-packages\platformio\package\commands\install.py", line 149, in _install_project_env_platform
    PlatformPackageManager().install(
  File "C:\Users\post\.platformio\penv\Lib\site-packages\platformio\package\manager\platform.py", line 62, in install
    p.install_required_packages(force=force)
  File "C:\Users\post\.platformio\penv\Lib\site-packages\platformio\platform\_packages.py", line 76, in install_required_packages
    self.install_package(name, force=force)
  File "C:\Users\post\.platformio\penv\Lib\site-packages\platformio\platform\_packages.py", line 70, in install_package
    return self.pm.install(spec or self.get_package_spec(name), force=force)
           ^^^^^^^^^^^^^^^^^^^^^^^^^^^^^^^^^^^^^^^^^^^^^^^^^^^^^^^^^^^^^^^^^
  File "C:\Users\post\.platformio\penv\Lib\site-packages\platformio\package\manager\_install.py", line 47, in install
    pkg = self._install(spec, skip_dependencies=skip_dependencies, force=force)
          ^^^^^^^^^^^^^^^^^^^^^^^^^^^^^^^^^^^^^^^^^^^^^^^^^^^^^^^^^^^^^^^^^^^^^
  File "C:\Users\post\.platformio\penv\Lib\site-packages\platformio\package\manager\_install.py", line 97, in _install
    pkg = self.install_from_uri(spec.uri, spec)
          ^^^^^^^^^^^^^^^^^^^^^^^^^^^^^^^^^^^^^
  File "C:\Users\post\.platformio\penv\Lib\site-packages\platformio\package\manager\_install.py", line 191, in install_from_uri
    self.unpack(dl_path, tmp_dir)
  File "C:\Users\post\.platformio\penv\Lib\site-packages\platformio\package\manager\_install.py", line 42, in unpack
    return fu.unpack(dst, with_progress=False)
           ^^^^^^^^^^^^^^^^^^^^^^^^^^^^^^^^^^^
  File "C:\Users\post\.platformio\penv\Lib\site-packages\platformio\package\unpack.py", line 178, in unpack
    self._archiver.extract_item(item, dest_dir)
  File "C:\Users\post\.platformio\penv\Lib\site-packages\platformio\package\unpack.py", line 49, in extract_item
    self._afo.extract(item, dest_dir)
  File "C:\Users\post\.platformio\python3\Lib\zipfile.py", line 1664, in extract
    return self._extract_member(member, path, pwd)
           ^^^^^^^^^^^^^^^^^^^^^^^^^^^^^^^^^^^^^^^
  File "C:\Users\post\.platformio\python3\Lib\zipfile.py", line 1735, in _extract_member
    open(targetpath, "wb") as target:
    ^^^^^^^^^^^^^^^^^^^^^^
FileNotFoundError: [Errno 2] No such file or directory: 'c:\\Users\\post\\Desktop\\OTGateway\\.pio\\.cache\\tmp\\pkg-installing-ggasz_jk\\esp32-arduino-libs\\esp32\\include\\espressif__esp_matter\\connectedhomeip\\connectedhomeip\\src\\app\\clusters\\boolean-state-configuration-server\\BooleanStateConfigurationTestEventTriggerHandler.h'

============================================================

An unexpected error occurred. Further steps:

* Verify that you have the latest version of PlatformIO using
  `python -m pip install -U platformio` command

* Try to find answer in FAQ Troubleshooting section
  https://docs.platformio.org/page/faq/index.html

* Report this problem to the developers
  https://github.com/platformio/platformio-core/issues

============================================================

Laxilef, 2025-01-08:
Hi,
Try moving the project folder to the root of the disk.
Example: ``C:\OTGateway``

Same problem: https://github.com/pioarduino/platform-espressif32/issues/41

Phunkafizer, 2025-01-08:
This fixed the issue! Thank you very much!

Closed 2025-01-08.

Thread 121 (2025-01-08):

Terms explanation

michalbizon, 2025-01-08:
Hi
I am confused about some terms in the settings, so I want to be sure before connecting to my heating system.
Thank you
Michal

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

Laxilef, 2025-01-08:
Hi,

Yes, this is the minimum and maximum setpoint heating temperature. The pipe from the boiler goes to the underfloor heating system without a mixing unit, so the temperature is limited from 40 to 50 degrees. 40 degrees is the minimum possible setpoint temperature of this boiler (bosch gaz 6000).

Closed 2025-01-28.

Thread 124 (2025-01-09):

Problem switch Heating MQTT Home Assistant

manuelcanfarotta, 2025-01-09:
Good morning
I updated the firmware from 1.4 to 1.5.1.
The switch for turning on the heating has changed.
I attach a photo.
While before the ignition was a classic switch....now these 2 lightning bolts are present, but clicking on them doesn't change anything.
For now I have activated them directly from the gateway on the web page and it works...

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

Laxilef, 2025-01-09:
Hi,

Read the release notes for 1.5.0:
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

In 1.5.x you can turn heating on and off via the ``climate.opentherm_heating`` entity

Closed 2025-01-29.

Thread 125 (2025-01-10):

Missing documentation

cybuletz, 2025-01-10:
Hello,
Is there any place where I can find more details about these options:

Thanks in advance!

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

bredy73, 2025-01-10:
I think all voice request a description. Not only this.

Laxilef, 2025-01-11:
Hi,

Next to each checkbox there is a parameter description.

Some of them (Cooling support, Summer/winter mode, DHW blocking) are used "as is" when [setting the boiler status](https://github.com/Laxilef/OTGateway/blob/5b7da4ed2a0c264352b9317b6f6f98a0e8eded70/src/OpenThermTask.h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). There is no documentation for these options because they can do different things on different boilers.

bredy73, 2025-01-19:
My boiler for example have the summer winter mode, but if I select this what change in the board? I don't see new button for select this option. Which is real function? Thanks

Laxilef, 2025-01-20:
> My boiler for example have the summer winter mode, but if I select this what change in the board? I don't see new button for select this option. Which is real function? Thanks

Visually nothing will change. This flag is transmitted “as is”, respectively, if the option is enabled, then the ``true`` flag is sent to the boiler, if disabled, then ``false``.

Closed 2025-02-09.

Thread 126 (2025-01-10):

Weekly program

michalsimek, 2025-01-10:
Hi,

is it possible to program weekly schedule directly to OT Gateway without homeassistant? There is minimum value but I would like to turn off heating at 10pm and keeping off till 7am because heater is close to our bedroom.

Is there also any plan to support connecting i2c display and show information about status, temperature, etc?
My parents would also prefer option for local control of temperature just via gpio button.

Thanks

Laxilef, 2025-01-10:
Hi,

No, these features are not planned. The project was initially designed for integration into a home assistant.
You can use HMI displays or android tablet with [kiosk mode](https://github.com/NemesisRE/kiosk-mode) for this. See [example](https://github.com/Laxilef/OTGateway/issues/86#issuecomment-2433157416).

Laxilef, 2025-01-10:
You can implement this yourself and create PR :)

michalsimek, 2025-01-12:
ok. Will look. And is there any way to sense temperature from two sensors instead of just one. The reason is that I have fireplace in living room and when I use it I would like to sense temperature from different room to keep the whole house warm. Via HA and mqtt that can be done but is there any logic directly in gateway?

Laxilef, 2025-01-12:
Add one more sensor with Purpose = Indoor temperature. The room temperature will then be calculated as the average of all sensors.

michalsimek, 2025-01-12:
thanks.

Closed 2025-01-12.

Thread 129 (2025-01-17):

Sensor in Add Alternative...

frank-35, 2025-01-17:
Hello Laxilef,
Big thanks and congratulations for sharing this project with us! I have been using your code on a ESP32S with Diyless-shield to control my Intergas boiler for several months now :).

I would like to have these 2 additions:

Firstly, when I open a door or window I would like to prevent the boiler from starting, this would prevent execssive wear on the boiler. This should be easily attainable with a timer to prevent the boiler from starting immediatly.

Secondly, the default return temperature is defined as MsgID=28 in the print summary section, however my Intergas returns this value as AddAlternative MsgID=28. It would be a great improvement if this could be customizable in the sensor settings?

Many thanks for your project so far and keep up the good work.

Greetings,
Frank

Laxilef, 2025-01-18:
Hi,

What is ``AddAlternative MsgID=28``?

> Firstly, when I open a door or window I would like to prevent the boiler from starting, this would prevent execssive wear on the boiler. This should be easily attainable with a timer to prevent the boiler from starting immediatly.

You can create an automation that will turn off the heating when you open the door, and turn it back on after 10 minutes, for example.

frank-35, 2025-01-18:
Hello,
Here the link I found about the return water temperature in the AA-section, hope this helps:

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

http://otgw.tclcode.com/firmware.html#configuration

Your project with DS18B20 runs the heater independently, which makes it very reliable (spare ESP32 S3 standby). Interfering in the control-cycle with HA undermines this reliability so a no go for me.

Greetings,
Frank

Laxilef, 2025-01-18:
ID 28 - this is return water temp. This ID is already being polled, so I don't quite understand what the problem is. The boiler may not physically have this sensor, so there is no value for this sensor.

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

Laxilef, 2025-01-18:
> Your project with DS18B20 runs the heater independently, which makes it very reliable (spare ESP32 S3 standby). Interfering in the control-cycle with HA undermines this reliability so a no go for me.

Well, you can increase the hysteresis in the heating settings or increase the interval between burner starts in the boiler service menu. I also recommend enabling filtering for the DS18B20 sensor to smooth out sudden temperature changes.
Adding a delay timer is not a good idea.

Closed 2025-02-09.

Thread 130 (2025-01-18):

Vitodens 100W B1HC-26 Heating temperature setup

michalsimek, 2025-01-18:
Hi,
I have finally made a connection to heater which also have hot water boiler connected. Hot water configuration is working properly and it is also properly reported. Firmware is on 1.5.1.
But I have an issue with heater itself. Control is working but I have issue with temperature configuration. I have connected 1-wire sensor for indoor temperature (also purpose Indoor temperature) and it is reporting proper values.

I want to setup heater to be active till temperature 20.5 C but in heating tab current temperature is heating temperature not temperature from 1wire sensor. Then my expectation is that based on hysteresis setting temperature will be kept.

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

Setup which I would like to have is that when heater is enabled all the time and automation only control target temperature to reach via indoor temperature. And maximum water heating temperature should be around 50 C.

Here are information about heater:
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
And current setup:
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

In main project README.md I see correct values for heating which is reflecting temperature on indoor sensor but not really value from heater water temperature.

Do you have any idea what's wrong?

Laxilef, 2025-01-18:
Hi,

To control the temperature by air, you must enable and configure Equitherm and/or PID.

michalsimek, 2025-01-18:
That did the trick! Thanks.

Closed 2025-01-18.

Thread 132 (2025-01-18):

Italian language

bredy73, 2025-01-18:
Hi, I love your project and I translate it in italian. If you want to ad to your next update.

[it.json](https://github.com/user-attachments/files/18465823/it.json)

Laxilef, 2025-01-18:
Hi,

This file is identical to en.json in content. Are you sure you uploaded the right file?

P.S. You can create PR instead of issue.

bredy73, 2025-01-18:
[it.json](https://github.com/user-attachments/files/18466211/it.json)

Laxilef, 2025-01-19:
Added, thanks!

bredy73, 2025-01-19:
thank you for your patience. I'm sorry but I 'm not practice with github

Laxilef, 2025-01-20:
It's not difficult. In the future, you can edit the file directly via Github and then create a PR.

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

Closed 2025-01-20.

Thread 133 (2025-01-27):

DWH startup time

michalsimek, 2025-01-27:
I am using OTgateway for a one week and found one issue with DWH. Output from HA is showing what it is happening. Setup in gateway is minimum temperature 45, maximum 50. That's working properly as is visible around 1am where temperature goes down and then it is heated.
But we see the issue where water consumption is higher that heater is not able to start and it takes quite a long time to start.

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

Here is a zoom of it.

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

It means reaction time is quite slow. DHW temperature sensor is connected directly to Viessmann 100w that's why heater should be aware about it. Before OTgateway heater was able to keep up much better but I don't have statistics about it.

What exactly DHW blocking is doing? Is it just disabling hot water or is it a way to let heater to deal with hot water instead of controlling it via OTgateway?

michalsimek, 2025-01-28:
I found this one which is likely the one which shows behavior only for hot water. When I zoom it I see at 22:48:34 hot water is below 45 and at 22:50:53 start heating at that time hot water is at around 37. It is more then 2 mins gap.

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

I will experiment with options to see what they do with my heater.

Laxilef, 2025-01-29:
Hi,
Maximum modulation level in opentherm settings 100%?
I also recommend that you check the boiler service settings. It is possible that the power for heating the DHW is limited there.

michalsimek, 2025-01-30:
Hi,
yes max modulation level is 100%.
I don't think there is power limitation because I only exchange relay regulator to OTgateway. Nothing else has changed.

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

Laxilef, 2025-02-02:
> Setup in gateway is minimum temperature 45, maximum 50.

These parameters affect only the DHW setpoint limits. That is, if you set min=40, max=50, then you will not be able to set the temperature below 40 or above 50.
To set the desired DHW temperature, you must set it in ``climate.opentherm_dhw`` or via the Dashboard page.

So, on the graphs I see that your DHW setting is most likely 50 degrees. The burner turned on when the DHW temperature dropped to ~37 degrees. This means that the hysteresis for turning on the burner for DHW is ~13 degrees. Perhaps this is a lot for your situation, but this parameter can only be configured in the boiler service menu and in no other way.
This is why I recommend that you study the boiler documentation and service menu.

OTGatway does not control the burner in any way and cannot influence the operation of the boiler: we simply transmit the desired temperature to the boiler and it must maintain it.

Closed 2025-02-18.

Thread 134 (2025-01-27):

Unable to change minimum temperature

FDM-dotcom, 2025-01-27:
Hi,

I'm unable to change the minimum heating temperature. It's set to 20, but when I adjust it to any lower value and save, it returns to 20 immediately.
It is possible to set a higher temperature, just nothing lower than 20.

Furthermore, I'm not able to update the room temperature using MQTT, though HA does say it is publishing and I'm using the HA Blueprint.

Hope someone can help me out with this.
Thanks

Laxilef, 2025-01-27:
Hi,

If you do not use PID/Equitherm, you will not be able to set the temperature lower than the boiler allows.

Closed 2025-02-17.

Thread 135 (2025-01-27):

Boiler keeps on running when mqtt sensor stuck

culdaraul, 2025-01-27:
Hello,

Today I had a Zigbee coordinator crash due to a bug in core ESP32 firmware (SLZB-07p). Therefore, all temperature sensors were stuck for almost 12h while I was away. Boiler was heating the entire house on a sunny day :).

Proposal: introduce a setting to turn off the boiler if no feedback from the indoor temp sensor is received in a certain timeframe.

Thanks.

Laxilef, 2025-01-27:
Hi,

You can additionally connect ds18b20 or ble sensor to esp with ``Purpose`` = ``Indoor temperature``.
Therefore, when all sensors with ``Purpose`` = ``Indoor temperature`` are disconnected (even if it is one), the emergency mode is activated.

Closed 2025-02-17.

Thread 136 (2025-01-28):

Temperature synchronization

kroll1349, 2025-01-28:
It's a problem that I don't understand, I set an internal sensor through mqtt and if I use pid or Equitherm, the sensor shows me 2 to 5 degrees more than it should be, if I set it to the Dallas sensor on the opentherm board it shows it exactly. Is it a bug or what? I haven't found any solution. Thanks

Laxilef, 2025-01-29:
Hi,

I didn't understand anything :) Please upload screenshots/videos that show the problem.

Closed 2025-02-09.

Thread 139 (2025-02-04):

ESP32-S3 dev-kit can you please release binaries for the most used esp-32 s3 kit?

t19j79, 2025-02-04:
Hi. Can you please release compiled binaries for the most used esp32 s3 devkit?
nowadays its most common used esp32 version as a base for many projects, it is added to many ready deviced like HMI etc.
Can you please add pins in config to match esp32 s3 devkit

Thanks a lot!

Laxilef, 2025-02-04:
Hi,

Use binaries for wemos s3 mini. GPIO choose at your discretion.

Thread 140 (2025-02-09):

The boiler does not turn on even when the temperature drops by 1 degree or more.

Pajuris, 2025-02-09:
Desired temperature is set to 22.5. Now room temperature is 20.9 and boiler is off - not heating.

latest 1.5.3 version. Turbo mode is not working too (can not turn on it - button back to off after few seconds).

Laxilef, 2025-02-14:
Hi,

Show a screenshot of the dashboard page with open tabs.

Pajuris, 2025-02-14:
Sorry, but restored to original firmware (it was cold at home) And it works.
Downgrade to 1.5.1 didn't help either. I think it was hardware problem maybe... A few hours ago, thermostat stop responding at all. Power off/on helped to start device, but boiler was never turned on after that.

Laxilef, 2025-02-14:
Can you test with other hardware (esp/adapter)?

Pajuris, 2025-02-14:
Sorry... i have one Thermostat with WeMos D1 Mini ESP32 and Master OpenTherm Shield only. And I do not use power adapter. Thermostat is connected to Odroid mini PC USB. Now, with original firmware and connected to Odroid USB it works. And it always worked with you firmware.

Closed 2025-03-12.

Thread 141 (2025-02-24):

Zones support?

dimis7, 2025-02-24:
Hi!

I have a very old Immergas EOLO Star 24 boiler in my home that might be compatible with OT protocol (not sure).

I'm planning to build the circuit to test it, but before i spend my time i want to ask if it's possible to use this project in a multi-zone system.

Currently there are 2x dry contact thermostats in 2 rooms, each controlling an electronic valve.
When the valve if fully open, it is sending a command to the boiler to turn on.

The boiler doesn't know the room temperature. Only know the temperature of the water that is returning from radiators.
Temperature is set to a fixed value and the boiler will slow down when the water temperature is close to the set point, even if the valves are still open and demanding hot water for the radiators.

Now I'm planning the replace the dry contact thermostats with 2x Sonoff NSPanels, flashed with ESPHome (this firmware: https://github.com/Blackymas/NSPanel_HA_Blueprint)

The original idea was to put the 2x NSPanels as temperature sensors and 1x Sonoff dual WiFi relay and create 2x Generic thermostats in Home Assistant that will control the relays based of the temperature sensors, sending the command to the electronic valves to open / close and the valves will continue to give the command to the boiler to turn on / off.

But it would be nice if i can have the boiler directly connected to home assistant and change the parameters from there, also very useful if i can read the diagnostics (for example I'm using bottles of gas, and when the bottles are empty the boiler is showing error 01 if i remember correctly, meaning ignition failure)

Any ideas are welcome!
Thanks

Laxilef, 2025-02-25:
Hi,

Multi-zones as such are not supported. You can pass the coldest temperature from HA [via automation](https://github.com/Laxilef/OTGateway/wiki#reporting-indooroutdoor-temperature-from-any-home-assistant-sensor) and [turn off the heating](https://github.com/Laxilef/OTGateway/issues/54#issuecomment-1975272298) when all TRVs are closed.

dimis7, 2025-02-27:
Thanks. What about the use of 2x additional GPIO to control the valves via relays? Is this possible?

Laxilef, 2025-02-27:
No, the project does not have such functionality.

Closed 2025-03-19.

Thread 143 (2025-02-26):

Stability S2 mini vs D1 mini32

pksoft585, 2025-02-26:
Interesting difference in stability on different platforms. Tested on the same device, simple replacement of the board. Same firmware version (latest), only different pin settings due to different GPIO layout.

**S2 mini** - spontaneous reboots from 5, 10 to max. 20 hours.

**D1 mini32** - runs without any failures, Restart only when changing firmware or power failure.

The difference in stability is quite significant. The question is whether only for me or in general. I suppose that this can be caused by the fact that **D1 mini32** has a more powerful processor. According to my experience it is a really well tuned board.

Please take this as information and not as a complaint. In any case, I would like to thank you for a great job and a perfectly developing product.

Thank you.
Petr

mihsu81, 2025-02-27:
Maybe your board has issues. My S2 mini doesn't reboot randomly.

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

pksoft585, 2025-02-27:
Thanks for the information. That is a possible explanation. It's good to know that it works well elsewhere. I don't have an S2 to replace yet and will stick with the D1 mini32.

Closed 2025-03-04.

Thread 149 (2025-03-15):

Status: INVALID & TIMEOUT

sanderversteegh, 2025-03-15:
I have recently started connecting Home Assistant to my boiler. Flashing and setup was easy and the interface and documentation were also very clear, compliments for that.

My setup is a bit special; I use an ESP32 and DIYLess Master shield but have a Nefit boiler that does not support OpenTherm. That is why I have a conferter that goes from Ems to Opentherm. (https://www.robbshop.nl/nefit-ems-opentherm-converter)
Unfortunately, the connection from OpenTherm to my boiler is not stable, it only has a connection for seconds after which it loses the connection and it takes a while before it gets the connection back. In the log I get a lot of INVALID and TIMEOUT messages.

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

If it did not work at all I would understand that, but is there anything I can do to prevent those TIMEOUT's?

Laxilef, 2025-03-15:
Hi @sanderversteegh,

It is difficult to guess why this converter at some point in time stops responding (TIMEOUT - no response within the allowed time).
What is the length of the cable from the converter to DIYLESS? What cable is used? Are there any other power cables nearby?

What board do you use with the DIYLESS adapter?

sanderversteegh, 2025-03-16:
The cable length to DIYLESS to converter is about 5cm and from converter to boiler about 10cm.
I now use a esp32-wroom-32 nodemcu 30pin. Bud i gone try a different board today.

Thank you for you're help!

Laxilef, 2025-03-17:
Pls test with this build

[build.zip](https://github.com/user-attachments/files/19277766/build.zip)

sanderversteegh, 2025-03-17:
I tried the build. It seems a lot better but still flaky. Especially reading data seems to be something it has trouble with. Switching the heating on/off and sending the temperature to the boiler seems to work quite well.

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

Thread 151 (2025-05-01):

ESP8266 stuck in restarting state when in critical heap

cifred98, 2025-05-01:
Hello,

I've just started using OTGateway with an Immergas Victrix Extra 32. It works well except for the flow sensor, so you can add that model to the compatibility list.

Setup:

Hardware: Wemos D1 Mini ESP8266 with a DIYLESS board

Firmware: Version 1.5.4, MQTT enabled, connected to Home Assistant

Issue: After running fine for a few hours, MQTT updates stop, and while the web UI works, it returns 503 errors when saving settings. Restarting the ESP from the UI fixes it temporarily.

Investigation: It appears this condition in MainTask.h (line 197) triggers a “restarting” state, which blocks MQTT and settings updates. However, because restartSignalReceived isn't set, the ESP never actually reboots.

I’m not sure if this relates to issue 115 or a memory leak, but at minimum the device should fully restart and resume normal operation when that condition occurs.

Laxilef, 2025-05-07:
Hi @cifred98,

Thanks, I'll test this next week. However, I am puzzled by the fact that your free heap drops below 2048 bytes. Can you upload the log from the moment ESP started until the moment it crashed from log level verbose?

Thread 152 (2025-05-04):

OTGateway keeps heating (it's summer)

dxlbnl, 2025-05-04:
Hi, Thanks for you're awesome project.

I recently installed the otgateway on my intergas kombikompact hre. And integrated it with Homeassistant. I've setup the blueprint for logging the internal temperature to it.

Currently it's warm outside, the temperature logged is 22 C, but the heating state stays enabled. In the dashboard control I disabled heating.
I don't seem to be able to set the desired temperature.

I'm sure stuff is misconfigured, but I'm usure where to begin

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

I also see a 503 when calling POST /settings happening, and a reset due to watchdogs

```json
{
  "build": {
    "version": "1.5.4",
    "date": "Mar  6 2025 19:26:16",
    "env": "s3_mini",
    "core": "3.1.3",
    "sdk": "v5.3.2-584-g489d7a2b3a-dirty"
  },
  "heap": {
    "total": 307768,
    "free": 75464,
    "minFree": 2780,
    "maxFreeBlock": 31732,
    "minMaxFreeBlock": 2780
  },
  "chip": {
    "model": "ESP32-S3",
    "rev": 1,
    "cores": 2,
    "freq": 240
  },
  "flash": {
    "size": 4194304,
    "realSize": 4194304
  },
  "crash": {
    "reason": "Reset due to other watchdogs",
    "core": 166,
    "heap": 1058299551,
    "uptime": 151756331
  }
}
```

dxlbnl, 2025-05-04:
I noticed a restart due to watchdogs:

```json
{
  "build": {
    "version": "1.5.4",
    "date": "Mar  6 2025 19:26:16",
    "env": "s3_mini",
    "core": "3.1.3",
    "sdk": "v5.3.2-584-g489d7a2b3a-dirty"
  },
  "heap": {
    "total": 307768,
    "free": 75464,
    "minFree": 2780,
    "maxFreeBlock": 31732,
    "minMaxFreeBlock": 2780
  },
  "chip": {
    "model": "ESP32-S3",
    "rev": 1,
    "cores": 2,
    "freq": 240
  },
  "flash": {
    "size": 4194304,
    "realSize": 4194304
  },
  "crash": {
    "reason": "Reset due to other watchdogs",
    "core": 166,
    "heap": 1058299551,
    "uptime": 151756331
  }
}
```

Laxilef, 2025-05-07:
Hi @dxlbnl,
For equitherm to work, you need to transmit indoor temperature. Since you have selected the ``Manual via MQTT/API`` type, you must configure automation as described [here](https://github.com/Laxilef/OTGateway/wiki#reporting-indooroutdoor-temperature-from-any-home-assistant-sensor).

dxlbnl, 2025-05-07:
I did, I didn't enable equitherm, just the PID controller. So the OTGateway would work as a thermostat. But I'm not sure how to send the desired temperature

Laxilef, 2025-05-07:
For PID it is also necessary to transmit indoor temperature. The link to the instructions is above.

andrey150960, 2025-05-28:
[dxlbnl](https://github.com/dxlbnl)
How was the esp 32 s3 flashed? I can't do it

Laxilef, 2025-06-09:
> Though there is no way to set a proper target temp, so I'm unsure what value it uses as target. I'd expect HA also to be able to set target temp too.

Why? Use ``climate.opentherm_heating`` to set the desired indoor temp

Closed 2025-06-29.

Thread 153 (2025-05-10):

GPIO pin access through MQTT?

yellius, 2025-05-10:
Great project! I'm using it perfectly with a Remeha Calenta gas heater.

Feature request: could one or more of the unused GPIO pins be configured as input or output and exposed as a senor or switch in HA?
This would be great for some custom (hardware) hacking and optimisation.

Laxilef, 2025-05-12:
Hi,

Thanks! You can connect additional sensors (NTC, Dallas) to free compatible GPIOs.
But there is no support for additional switches. What can this be useful for?

yellius, 2025-05-12:
Hi, I was thinking of using it to control a three-way water valve to switch
tapwater between electric boiler and gas boiler, depending on electric
boiler temperature.

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

yellius, 2025-05-13:
Ok - thanks for having considered!

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

Closed 2025-06-02.

Thread 154 (2025-05-28):

ESP32-S3 (QFN56) (revision v0.2)

andrey150960, 2025-05-28:
Здравствуйте. Столкнулся с такой проблемой.
платаESP32-S3 (QFN56) (revision v0.2) после отключения от источника питания прошивка не запускается
пишет
ESP-ROM:esp32s3-20210327
Build:Mar 27 2021
rst:0x1 (POWERON),boot:0x8 (SPI_FAST_FLASH_BOOT)
SPIWP:0xee
mode:DIO, clock div:1
load:0x3fce2810,len:0x1074
load:0x403c8700,len:0x4
load:0x403c8704,len:0xac0
load:0x403cb700,len:0x2e58
entry 0x403c8890
E (315) quad_psram: PSRAM ID read error: 0x00ffffff, PSRAM chip not found or not supported, or wrong PSRAM line mode
E (685) wifi_init_default: netstack cb reg failed with 12308
После очистки флеш и заливки любого скеча в ардуино прошить получается , но при перезагрузке по питанию прошива не запускается.

andrey150960, 2025-05-30:
Да все именно так. Спасибо буду копать. Если получится отпишусь.

Closed 2025-06-16.

Thread 155 (2025-05-31):

Heat and DHW constantly off but burner sometimes runs

kriskristoferson, 2025-05-31:
I have a gateway connected to a Vitodens 100 boiler (an older model from around 2011). Sometimes, for completely unknown reasons, it starts periodically activating the burner, even though both Heat and DHW are turned off the entire time. Occasionally, it manages to stay off for a longer period (possibly after a restart or shutdown, though I'm not sure how or why), but then it returns to this periodic heating again. I have both indoor and outdoor temperature sensors connected via MQTT to Home Assistant.
I’m attaching a burner modulation graph (Heat and DHW remain off the whole time).

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

Laxilef, 2025-06-03:
I see that the setpoint temp is always around 20 degrees. Are you sure that your boiler correctly accepts this temperature? What is the minimum temperature you can set from the boiler panel?

kriskristoferson, 2025-06-05:
Short logs with pid and equiherm off
[pid_equitherm_off.txt](https://github.com/user-attachments/files/20603335/pid_equitherm_off.txt)

Laxilef, 2025-06-05:
Ok, thanks
Could you upload longer logs that would include the moments when the burner was turned on?

> 1. Your boiler does not actually accept the 20 degree setpoint, and the minimum temperature for it is ~40 degrees. But this requires confirmation: either from the boiler documentation (but for this you need the exact model name), or by indirect signs: indication on the boiler panel, etc. For this reason, the boiler heats up to ~40 degrees.

Not confirmed:
```[00:13:00][OT][HEATING][NOTICE] Received min temp: 20 (converted: 20), max temp: 80 (converted: 80)```

Laxilef, 2025-06-06:
If the heating is off, it should not start even when using pid/equitherm.

kriskristoferson, 2025-06-09:
About 15 minutes, during which time the heating was activated; unfortunately, the clock on the module could not be set via NTP.
[otgw.zip](https://github.com/user-attachments/files/20657649/otgw.zip)

Laxilef, 2025-06-13:
Thanks

This is very unusual:
```
[00:03:54][OT][NOTICE] Received boiler status. Heating: 0; DHW: 0; flame: 1; cooling: 0; fault: 0; diag: 0
...
[00:04:31][OT][NOTICE] Received boiler status. Heating: 0; DHW: 0; flame: 1; cooling: 0; fault: 0; diag: 0
```

Even though we turned off the heating and DHW, the boiler still ignites the burner...
Can you try changing the options in opentherm settings and test again?
``Summer/winter mode`` = off
``Heating state as summer/winter mode`` = on

Laxilef, 2025-06-28:
Or try with ``Duplicate heating to CH2``

Laxilef, 2025-07-03:
Can you take a screenshot of your opentherm settings and upload the log again, which will show the moments when the burner was turned on?
I think the burner may be turning on because channel 2 is on.

kriskristoferson, 2025-07-03:
These are the current settings and logs from the burner start. I was hoping that since outside the heating season the PID and equitherm are unnecessary, I would try turning them off, but it didn’t help. In any case, PID is currently off and equitherm is off.

[otgw3.zip](https://github.com/user-attachments/files/21032437/otgw3.zip)

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

Laxilef, 2025-07-03:
The log looks normal, channel 2 is disabled. But the boiler still turns on the burner, I have no idea why this happens :(

I read in the instructions for your boiler that when connecting an opentherm thermostat, jumper D must be removed. Have you done this?
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

kriskristoferson, 2025-07-04:
Hmmm, that’s strange — my manual looks like this. I had jumper D on X9, I’ve removed it now, so we’ll see.
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

kriskristoferson, 2025-07-07:
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

I interpreted it as meaning that instead of the jumper on X9, you connect an on/off thermostat — but maybe it really should be understood in the context of Opentherm thermostats. Anyway, the important thing is that the issue seems to be resolved. I’ve already seen at least two temperature levels where previously the burner would have definitely turned on, and nothing happened this time. If it gets worse again, I’ll let you know. For now, everything is fine — the domestic hot water heating works, and I can patiently wait for the heating season to test the central heating temperature control.

kriskristoferson, 2025-07-19:
There’s still some issue. I hadn’t touched the boiler for a few days — the burner only operated when I turned on DHW. Yesterday, there was a brief power outage, and a few hours later I noticed the burner was again caught in a startup loop. I briefly turned off the power to the boiler and the gateway. That seemed to help. The jumper is still removed.
So it seems once again like some strange behavior related to powering on the boiler and the module.
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

Laxilef, 2025-07-19:
Damn. I hoped the problem was solved...
Were there any faults on the boiler panel? Or did it just start firing the burner?

kriskristoferson, 2025-07-21:
No, I don't think so. I didn't check at the time, but the boiler was serviced a month ago and I didn't notice any issues or error messages. It was just a brief power outage in the whole house after which the problem appeared. When I noticed it, I turned the boiler and the module off and on again — the problem disappeared and so far everything is fine. Other than that, I haven’t touched either the boiler or the module configuration for several days.

koodergit, 2025-08-06:
Hi, not sure if this is the correct place to post this but I have exactly the same boiler and of the same vintage (2011) and I too get this problem. I need to collect the logs like you have done already but I didn't want the issue to go stale if indeed it is an issue and not just a settings thing.

Happy to help and support as needed.

koodergit, 2025-08-08:
These settings for me completely remove the issue you are seeing.

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

The boiler does not fire unless directed by the automations which is exactly as it should be.

Note that I still have priority dhw with a separate thermostat but this does not interfere with the open therm commands as long as I turn it below the point of OTG.

Maybe give them a try and see if it fixes your issue.

kriskristoferson, 2025-08-09:
For me, the problem comes back every few days, usually after a power outage at home. It seems the key point is when both devices start up together. That’s what happened the day before yesterday, I think — I noticed that for several hours the burner was switching on and off cyclically. I turned the boiler off for a moment (the module remained on), and the problem disappeared.

Laxilef, 2025-08-10:
If the problem occurs when the boiler and ESP are turned off, use an inexpensive UPS.
I have no idea why the boiler behaves this way and I have not seen such behavior on other boilers.

Closed 2025-08-30.

Thread 156 (2025-06-05):

release 1.5.5 :  number of sensors

Minims, 2025-06-05:
I can't get more than 20 sensors, is this is a hard limit ?

Laxilef, 2025-06-05:
Yes, but you can build a firmware with a different number of sensors. But you need to consider that this will increase the amount of statically used memory. On esp8266 it is not recommended to use more than 20.

Minims, 2025-06-05:
Ok thanks, maybe the variable can be different  between ESP8266 & ESP32 in that case.
Or maybe we can allow 40 by default, but only 20 enable.

In my case i try to activate all available sensors to see which one are working, then i disable the one where there is no DATA are found

Laxilef, 2025-06-06:
Add to platformio.ini and build firmware
```ini
build_flags =
	-D SENSORS_AMOUNT=40
...
```

Laxilef, 2025-06-06:
> Or maybe we can allow 40 by default, but only 20 enable.

The size of statically allocated memory will still increase

Closed 2025-06-06.

Thread 157 (2025-06-10):

Emergency mode starts even when Heating is disabled

mihsu81, 2025-06-10:
Hi @Laxilef ,

Emergency mode starts even though Heating is disabled. It should consider whether Heating is actually enabled or not.
Would it be possible to make this adjustment?

Thank you in advance.

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

Laxilef, 2025-06-13:
Hi,

This is normal behavior.

Laxilef, 2025-06-13:
It may seem strange, but an emergency mode can prevent your home from freezing someday. Just add additional sensors (wired ones are possible).

mihsu81, 2025-06-13:
I'm sorry if I wasn't clear. I'm not debating the usefulness of Emergency mode. It is definitely beneficial.
What looks like an issue, to me at least, is that during the summer, when I turn off the heating, the thermostat shouldn't start heating the house just because there was a communication issue with Home Assistant and it went into Emergency mode.
I expect the Emergency Mode algorithm to check if the user has already turned off the heating before turning it on.

Laxilef, 2025-06-16:
Ok, I'll think about it.

ZHcom, 2025-07-10:
> Slightly changed the logic of the emergency mode. Now he doesn't turn on the heating.
>
> However, there are now freeze protection settings: now the heating will be automatically turned on if the temperature of the heat carrier/indoor temperature drops below the set threshold (`Heating settings` > `Freeze protection` > `Low temperature threshold`).

**where can I download a new version of the firmware to enable this function or how to enable it on version 1.5.5?**

ZHcom, 2025-09-26:
Good afternoon, I installed the new firmware 1.5.6 but didn't see where to enable or disable emergency mode. Where can I find this function? Or how does it work?

Thread 158 (2025-06-16):

TokenExpiredError

garnierph, 2025-06-16:
Hello,

After months of usage, I just noticed that I am no more able to run any command, due to token expiration.
My understanding is that I do not manage this token myself: I just need to provide Somfy account credentials.
I just checked that I am still able to address my alarm from my iOS dedicated app. I remember that Somfy said some days ago that their service will be nonoperational for a while. Did they changed something in their APIs, like authorization features ?

Thanks,
Philippe

philippe@raspberrypi3:~/Scripts/Somfy $ python3 ./somfy_status.py
Traceback (most recent call last):
  File "/home/philippe/.local/lib/python3.7/site-packages/somfy_protect_api/api/somfy_protect_api.py", line 342, in _request
    return getattr(self._oauth, method)(url, **kwargs)
  File "/usr/lib/python3/dist-packages/requests/sessions.py", line 548, in get
    return self.request('GET', url, **kwargs)
  File "/home/philippe/.local/lib/python3.7/site-packages/requests_oauthlib/oauth2_session.py", line 484, in request
    url, http_method=method, body=data, headers=headers
  File "/usr/local/lib/python3.7/dist-packages/oauthlib/oauth2/rfc6749/clients/base.py", line 198, in add_token
    raise TokenExpiredError()
oauthlib.oauth2.rfc6749.errors.TokenExpiredError: (token_expired)

During handling of the above exception, another exception occurred:

Traceback (most recent call last):
  File "./somfy_status.py", line 38, in <module>
    sites = api.get_sites()
  File "/home/philippe/.local/lib/python3.7/site-packages/somfy_protect_api/api/somfy_protect_api.py", line 72, in get_sites
    response = self.get("/v3/site")
  File "/home/philippe/.local/lib/python3.7/site-packages/somfy_protect_api/api/somfy_protect_api.py", line 268, in get
    return self._request("get", path)
  File "/home/philippe/.local/lib/python3.7/site-packages/somfy_protect_api/api/somfy_protect_api.py", line 344, in _request
    self._oauth.token = self.refresh_tokens()
  File "/home/philippe/.local/lib/python3.7/site-packages/somfy_protect_api/api/somfy_protect_api.py", line 319, in refresh_tokens
    token = self._oauth.refresh_token(SOMFY_PROTECT_TOKEN)
  File "/home/philippe/.local/lib/python3.7/site-packages/requests_oauthlib/oauth2_session.py", line 452, in refresh_token
    self.token = self._client.parse_request_body_response(r.text, scope=self.scope)
  File "/usr/local/lib/python3.7/dist-packages/oauthlib/oauth2/rfc6749/clients/base.py", line 421, in parse_request_body_response
    self.token = parse_token_response(body, scope=scope)
  File "/usr/local/lib/python3.7/dist-packages/oauthlib/oauth2/rfc6749/parameters.py", line 431, in parse_token_response
    validate_token_parameters(params)
  File "/usr/local/lib/python3.7/dist-packages/oauthlib/oauth2/rfc6749/parameters.py", line 438, in validate_token_parameters
    raise_from_error(params.get('error'), params)
  File "/usr/local/lib/python3.7/dist-packages/oauthlib/oauth2/rfc6749/errors.py", line 405, in raise_from_error
    raise cls(**kwargs)
oauthlib.oauth2.rfc6749.errors.InvalidGrantError: (invalid_grant)

Laxilef, 2025-06-16:
What is this about and how does it relate to the project?

Closed 2025-06-17.

Thread 160 (2025-06-18):

Viessman vitopend 100-W

RastopchinSS, 2025-06-18:
Hello!

I have a Viessman vitopend 100-W A1HB-34 gas boiler installed.
I have connected an OpenTherm controller with firmware 1.5.5
The boiler detects an OpenTherm connection.
In the Web interface, I see readings of the current coolant temperature, the set temperature, the burner status, and the maximum and minimum temperature settings.
But the boiler does not accept the target temperature of the coolant. He sets it at 40 degrees Celsius.
The burner turns on for a few seconds and turns off before reaching the set temperature on OpenTherm.

Please help me figure out the settings. What settings should I make so that the boiler operates at a given temperature of the coolant?

Laxilef, 2025-06-18:
Hi,

Try with OT option "Duplicate heating to CH2"

Laxilef, 2025-06-19:
Try disabling the "Sync max heating temp with target temp" option, reset the boiler settings and try setting the temperature to 60 degrees

RastopchinSS, 2025-06-21:
I have the following problem.
I turn off the heating in the controller settings. It is displayed that the heating is turned off. But the heating is active on the boiler and the burner is periodically switched on for a short time.
I can also see it in the Home Assistant - the heating on the boiler is working.

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

RastopchinSS, 2025-06-22:
> `Heating state as summer/winter mode`
> And `Sync max heating temp with target temp` = off

It really worked. Thank you so much!

Closed 2025-07-18.

Thread 161 (2025-06-29):

Configuration sensors

Tonny56, 2025-06-29:
In firmware 1.5.5 the settings for indoor temperature, the type/source option "OpenTherm, indoor temp" is missing, unlike the sensor for "outdoor temp."
Because I use a Zigbee thermometer for indoor temperature, I now select the option "Manual via MQTT/API" for indoor temperature.
In Home Assistant, I use the automation opentherm_interntemp to link the value of the indoor thermometer to the "indoor temp" field.

My question is whether this is the correct way to do it. In the thermostat card in Home Assistant, the current temperature is not showing the "indoor temp," but the "heating temp." I have no idea how to change this.

Another question is: what happened to the "target temperature"? I upgraded directly from version 1.4 to 1.5.5 and now I seem to have lost the ability to set the target temperature.

Laxilef, 2025-06-30:
Hi,

I recommend removing the device from Home Assistant, restarting ESP and setting indoor temperature as [described in the wiki](https://github.com/Laxilef/OTGateway/wiki#reporting-indooroutdoor-temperature-from-any-home-assistant-sensor).

Closed 2025-07-20.

Thread 162 (2025-07-02):

Can I use a Chinese-language interface? How should I operate it?

david2dfs23, 2025-07-02:
I am trying to learn and use this gateway. Your project is really great. I would like to ask: Can I use a Chinese-language interface? How should I operate it?

david2dfs23, 2025-07-04:
[#/](url)

> Thank you very much for your reply, my friend. I'm not very familiar with using this platform. Is this how I should send it? If it's not right, please let me know again.

[cn.json](https://github.com/user-attachments/files/21050477/cn.json)

Laxilef, 2025-07-06:
Hi,
Already added, PR #163

david2dfs23, 2025-07-06:
太棒了👍。正是我需要的。非常感谢您🙏

---- Replied Message ----
| From | ***@***.***> |
| Date | 07/06/2025 22:23 |
| To | ***@***.***> |
| Cc | ***@***.***>***@***.***> |
| Subject | Re: [Laxilef/OTGateway] Can I use a Chinese-language interface? How should I operate it? (Issue #162) |
Laxilef left a comment (Laxilef/OTGateway#162)

Hi,
Already added, PR #163

—
Reply to this email directly, view it on GitHub, or unsubscribe.
You are receiving this because you authored the thread.Message ID: ***@***.***>

Closed 2025-07-06.

Thread 166 (2025-07-06):

Emergency mode target temperature defaults to 40°C

pieczka-marek, 2025-07-06:
Hello, first of all Laxilef and the dev team. Thank you for the great work and keeping my house warm ;)

The issue is that several times the emergency mode kicked in when my HA service was down which started to heat the home with 40°C water overheating it quickly.

I lowered the emergency target temp to 25°C only to find it back at its default value of 40°C (the temp stays at 25 after saving and for some time, not sure when the defaulting happens). This might be partially fixed by https://github.com/Laxilef/OTGateway/issues/157 but in any conditions the temperature of 40°C will be too much. Seems like a bug that the temp is defaulted to some other value.

System info:
boiler: Termet Ecocondens Gold Plus 25kW,
IC: ESP8266 with DIYless shield,
Version 	1.5.5
Build 	Env: d1_mini
Core: 3.1.2
SDK: 3.0.5(b29dcd3)

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

pieczka-marek, 2025-07-06:
Laxilef, thank you for your reply.
I have set the `Get min/max temp from boiler ` only recently the issue is independant from that. I investigated a bit more and I think I know what is happening:
1. I have a automation to increase the minimum heating temp to 35°C for a short time until the flame is detected. I need it to fire the boiler at low heating temp settings. Its a kind of hack to override the equitherm setpoint temp.
2. This automation is run after HA restart
3. The emergency temp target is reset to default value when the target temp is higher than the target (makes sense)

Would it be possible to make the emergency target temp configurable from HA? Do you think it would be a reasonable solution for that issue and something that you would consider as a worthy improvement?

Laxilef, 2025-07-06:
Yes, that's probably what happens.

> Would it be possible to make the emergency target temp configurable from HA?

In previous versions there was such a possibility. But I deleted some entities, including emergency target temp, because there were too many entities.

Not very elegant, but working solution for HA:
```
action: mqtt.publish
data:
  topic: opentherm/settings/set
  payload: |-
    {
      "emergency": {
        "target": 25
      }
    }

```

Closed 2025-07-07.

Thread 171 (2025-09-03):

Wifi connect hang every second start

mipisoft, 2025-09-03:
During every second start wifi cant connect. On first start is everything OK, When lost power supply and then back wifi cant connect and OTGateway working, but no access. Next start is OK
I use D1_Mini chinese version 2 pieces  OtGateway version 1.5.5
Comunicate with Atlantic Loria heat pump  working flawlessy but only basic sensors. DHW - no problem  Heating still not tested.

Laxilef, 2025-09-28:
You can save logs by connecting the ESP via USB cable and connecting to the serial port using PuTTY, for example.

djp3k05, 2025-09-28:
Got a similar issues, with the reconect to the wifi network. The wifi signal is not very good in the room where the wemos d1 mini is. About -65dbm. Every few days the device is loosing the wifi connection and will not reconect back by itself. I have to power it off and back on. For now I've added a zigbee power socket for the wemos. If the wemos is not replying to ping for 2 minutes, HA will power off and then power on the zibee power socket.
Can you add/improve the reconnection logic? To try to connect to wifi indefinitely until it succede?
Thank you for your hard work. This is the first year when I Will use your opentherm implementation.

Laxilef, 2025-10-03:
> I compile soft after the laxilef changes.

After what changes?

Laxilef, 2025-10-03:
> After this change: [14826c1](https://github.com/Laxilef/OTGateway/commit/14826c10cd5c71e2dc0e5b2e7645791d5c930c05)

This does not introduce any changes to the interaction with the network.

Try [this](https://github.com/Laxilef/OTGateway/issues/171#issuecomment-3344266128).

djp3k05, 2025-10-04:
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

I'm using different names for 2.4G and 5G (Asus Router). As I said, my issue is that after few days get's disconnected and the only way is to reboot the Wemos device. Rebooting the router while the wemos is connected - it does reconnect back every time. Rebooting the router while the Wemos lost the connection - does not reconnect back. I also added a 3db gain antenna to the wemos - now I got 100% signal. but still got those disconnects. Maybe the Wemos board is freezing (and not an issue with the OTG networking stack). I got a different Wemos board - so I will test with that in the next days. Currently I got a worse issue, will open a new issue for that.

Laxilef, 2025-10-04:
In my experience, I've seen reboot loops and ESP freezes due to power supply issues. Therefore, I recommended you try a different power supply.

Thread 174 (2025-09-16):

Invalid value for number.opentherm_dhw_target: 60.0 (range 30.0 - 50.0)

pksoft585, 2025-09-16:
Until version 1.51, I had DHW Maximum temperature set to 50 degrees. Now I have it set it to 60 degrees. It is the same in the dashboard, HA interface, and backup.json file - 60. When I want to set the DHW Target temperature to 60 degrees, I get the error message shown. The sensor **number.opentherm_dhw_target** still has the original min and max (50) values set. When changing the range, there is no change via MQTT in HA. It is possible that a similar problem could occur with other numerical sensors when changing min and max values.

pksoft585, 2025-09-17:
Restart doesn't solve the problem. I simply manually changed max parameter in developer tools. I didn't want to delete the device from HA... Thanks for your support. BR.

Laxilef, 2025-09-17:
> I didn't want to delete the device from HA...

Some entities have been removed/renamed. If you are trying to work with ``number`` DHW temp, it will not work with the new version, use ``climate``

Closed 2025-09-17.

Thread 175 (2025-09-18):

Управление шлюзом opentherm

volinvladim, 2025-09-18:
Не знаю где можно задать вопросы. Извините если здесь нельзя.

Не могу найти информацию как задать поддерживаемую температуру в помещении в режиме PID? (ds18b20 в помещении установлен)

Если режимы equiterm и pid не включены, а режим отопления включён, как будет регулироваться температура, по теплоносителю или по сенсору температуры и будет ли в этом режиме работать гистерезис или он только для pid регулятора?

Thread 178 (2025-09-28):

Unable to set DHW temp setpoint or maxTemp to above 60°C

pieczka-marek, 2025-09-28:
Hello Laxilef,

second year with your opentherm integration, looking confident into the upcoming heating season! Thank you for all your hard work :D

I have only one issue that has occurred I think about the time of 1.5.0 release. Before I was able to set the DHW temp to 70°C now that value is capped at 60°C.

Why is this a issue?
I have a anti legionella automation set up which heats the hot water tank to a higher temperature for a short period of time making sure the tank is sterile. Temperature of 60°C is not ideal for that, the recommended range is 70-80°C.

Kindly request to increase the dhw max temp to 70°C.

Regards,
Marek

pieczka-marek, 2025-09-30:
Yeah, so the limits are `DHW limits:   35...65 °C` I guess they are hardcoded in the boiler itself with no possibility to change? Or I can just remove them from OTGateway and set what I want. And also I am able to set DHW max temp to 65°C.

Laxilef, 2025-09-30:
> I guess they are hardcoded in the boiler itself with no possibility to change?

yes

> Or I can just remove them from OTGateway and set what I want.

It's unlikely, the boiler won't accept DHW temp above 65

Thread 179 (2025-09-28):

unexpected behavior with heat pump and gas heater

kht1011, 2025-09-28:
Hello,

I have got a heat pump and a gas heater. The heat pump is the master in this system and controls the gas heater.
I connected today the OTGateway with the opentherm connection of the heat pump for a room unit.

The connection works and i am getting data from the heat pump and the gas heater. unfortinatly, the system now switches to producing heat only with gas heater and not by heat pump.

Regards
Daniel

kht1011, 2025-09-29:
the boiler is a Remeha Calenta Ace 25DS
the heat pump is a Remeha Tensio C 12 kW TR with a Remeha Mercuria H IDU inside unit.
this is the setup, (room unit 3 does not exist, here i added the OTGateway)
It is a setup form a hybrid system
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

kht1011, 2025-09-30:
here you can find the chapter from the screenshot in english
https://www.manualslib.com/manual/3463519/Remeha-Mercuria-E-Mb.html?page=95#manual
still the same behavior
