Laxilef/OTGateway/assets/Schematic.pdf

Power supply | Board A

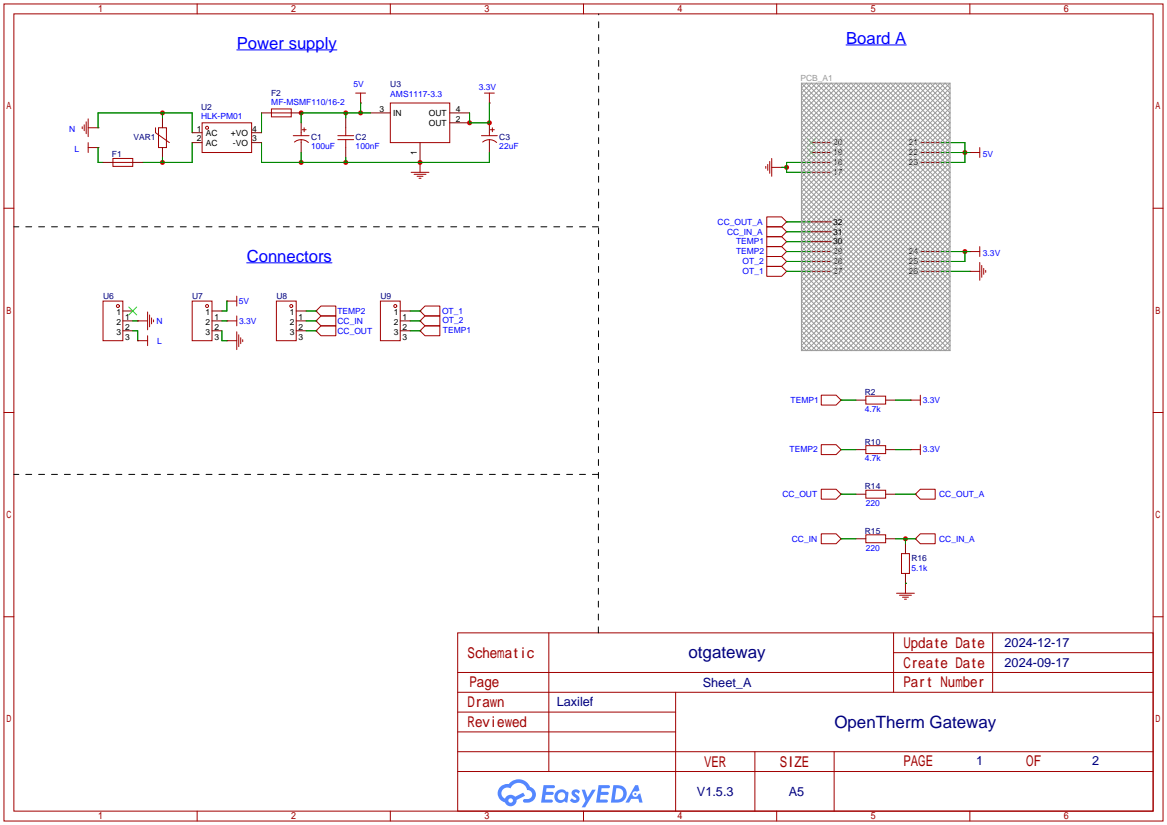
[picture p11: page 1]

OpenTherm adapter | LED's | Board B

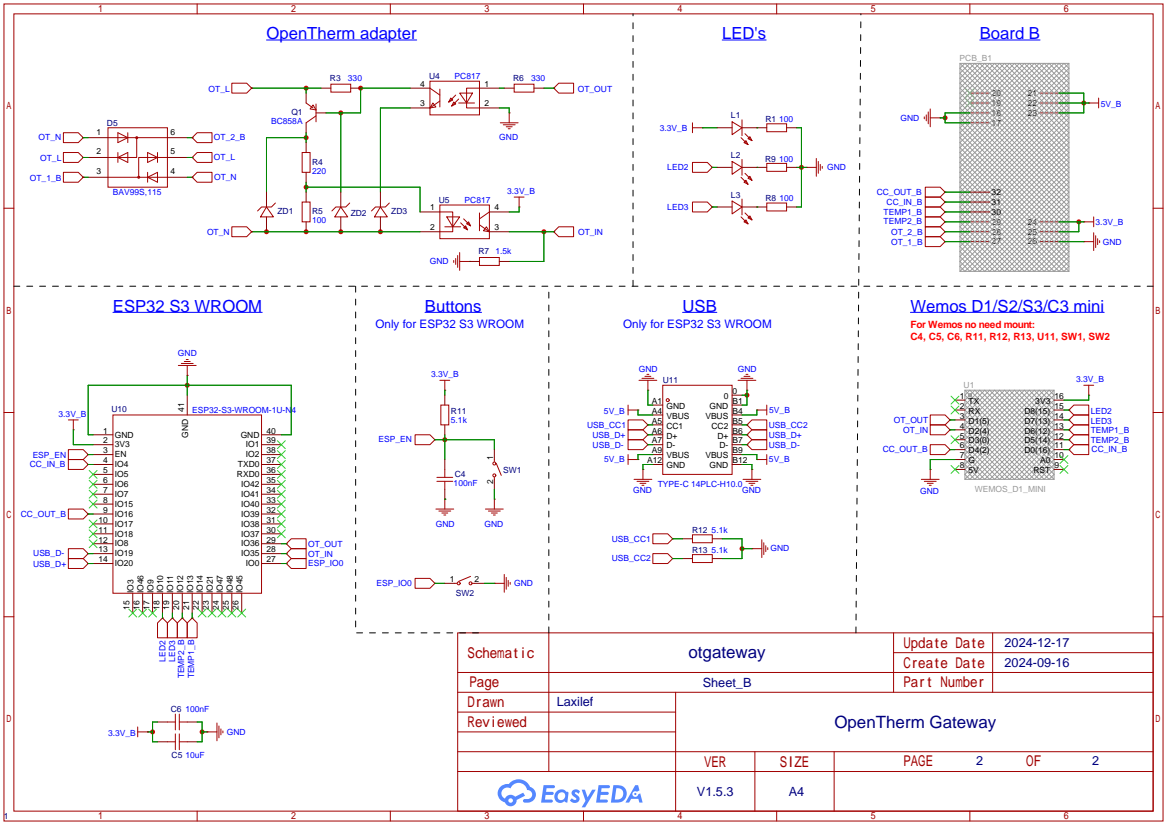
[picture p12: page 2]

For Wemos no need mount:
