Laxilef/OTGateway/assets/sheet.pdf

# PCB B

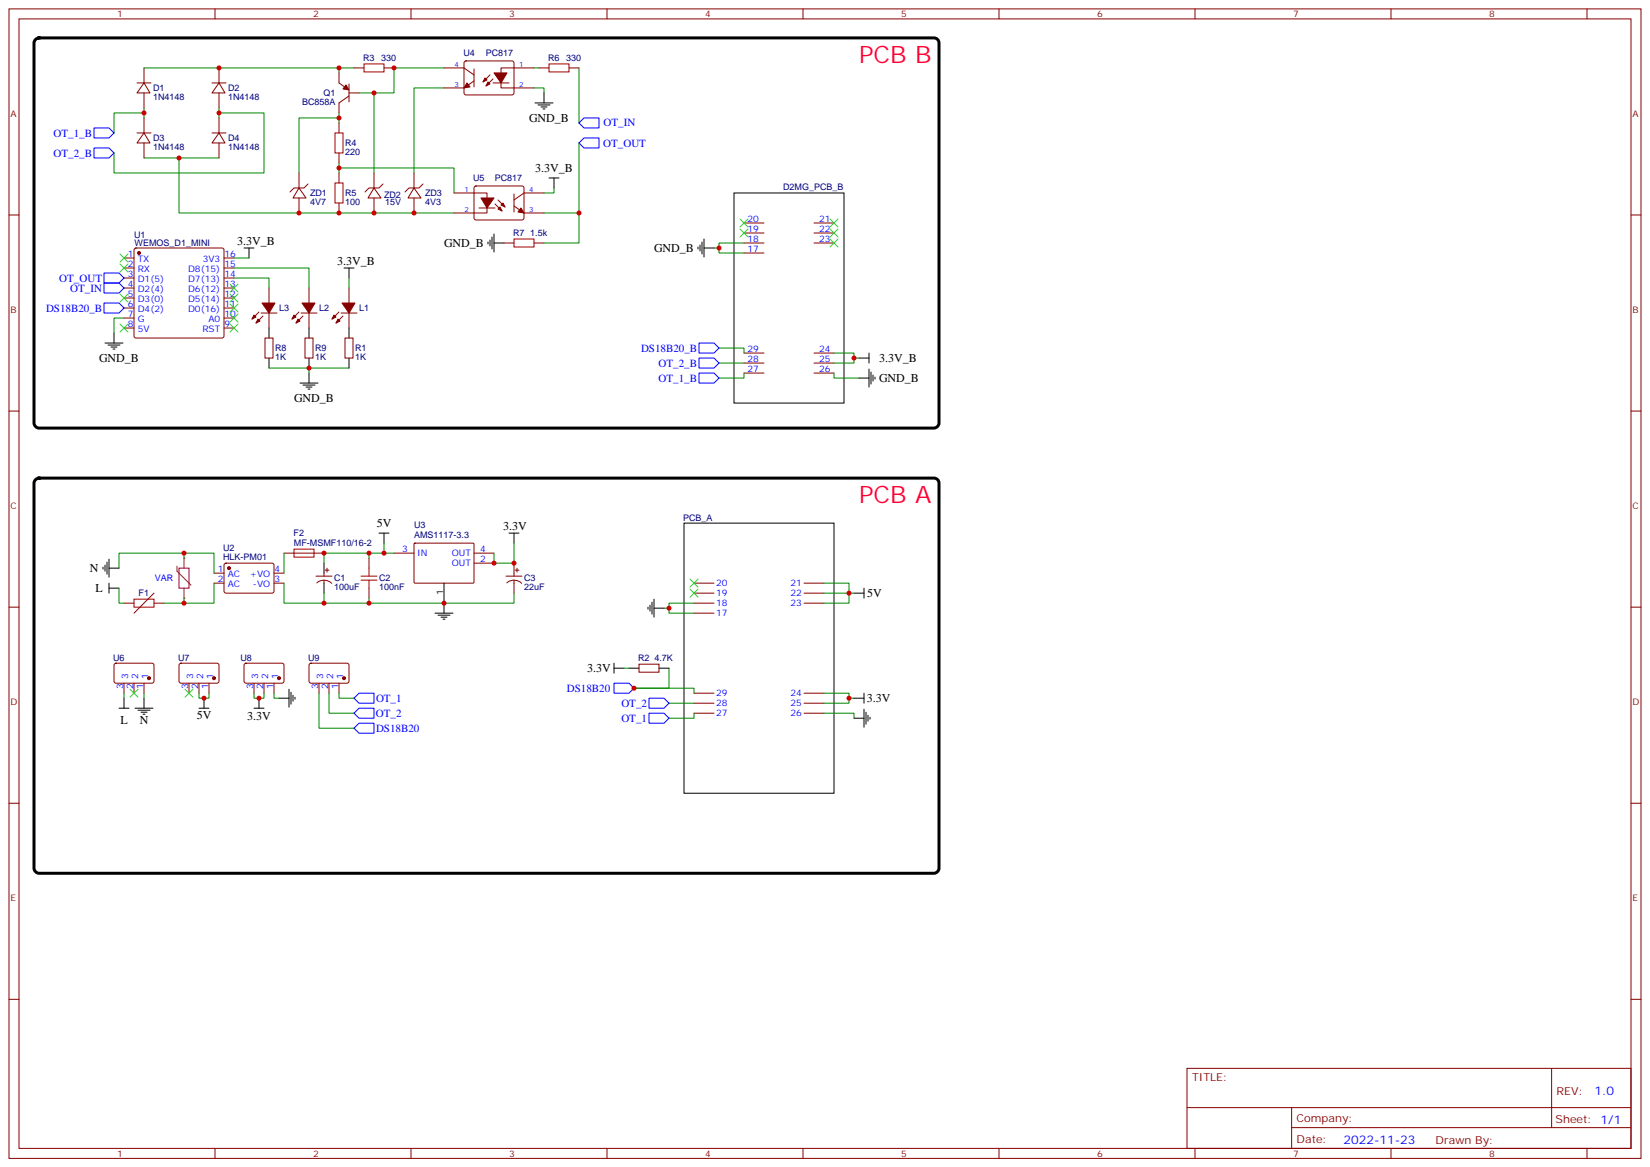
[picture p13: page 1]
