Laxilef/OTGateway/(commit log)

2023-09-16 Use platformio and more updates
    [BOM.xlsx, equitherm calc.xlsx]
2023-09-17 upd readme, added pcb
2023-09-19 upd readme
    [equitherm_calc.xlsx]
2023-09-19 upd readme upd gitignore add ino file for arduino ide
2023-09-21 Many changes.
    1. Migrate from microDS18B20 to DallasTemperature
    2. Refactoring of sensors: added an external temperature sensor inside the house, added an "offset" parameter for sensors
    3. Fixed PID
    4. New parameters added:
    - settings.heating.minTemp
    - settings.heating.maxTemp
    - settings.dhw.minTemp
    - settings.dhw.maxTemp
    - settings.pid.minTemp
    - settings.pid.maxTemp
    - settings.sensors.outdoor.type
    - settings.sensors.outdoor.pin
    - settings.sensors.outdoor.offset
    - settings.sensors.indoor.type
    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
    [MainTask.h, MqttTask.h, OpenThermTask.h, RegulatorTask.h, SensorsTask.h, Settings.h, defines.h, main.cpp]
2023-09-21 upd pcb
    [BOM.xlsx]
2023-09-21 upd readme, small fix
    [RegulatorTask.h]
2023-09-21 upd readme & pcb
2023-10-09 Added DHW present switch
2023-10-11 fix pid
2023-10-17 upd readme, get modulation fix
    [OpenThermTask.h]
2023-10-17 added interval for forced set temperatures
2023-10-18 Fixed get current dhw temp
    [OpenThermTask.h]
2023-10-18 Fix Error ''max' must be > 'min'' when processing MQTT
    [Settings.h]
2023-10-20 fix entity climate.heating
2023-11-11 Compatible with ESP32
2023-11-12 fixed heap size fixed core numbers for esp32 tasks compatible with lolin_c3_mini delete task main loop() for esp32
    [MainTask.h, MqttTask.h, OpenThermTask.h, RegulatorTask.h, SensorsTask.h, defines.h, main.cpp]
2023-11-16 Update the code for the status led
2023-11-17 features * Added new OT parameters * Improved compatibility with the boiler ITALTHERM TIME MAX 30F * Refactoring min/max temp * Fix port forwarding: disable captive portal after connecting to wifi * 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
    [MqttTask.h, OpenThermTask.h, RegulatorTask.h, Settings.h]
2023-11-22 added heating status pin
2023-11-22 fix set min & max dhw temp
    [MqttTask.h]
2023-11-23 added DHW flow rate from OT
2023-11-23 states.faultCode moved to sensors.faultCode, states.rssi moved to sensors.rssi, states.uptime moved to sensors.uptime
2023-11-23 fix state class for uptime
    [HaHelper.h]
2023-11-26 fix when using two sensors, str to flash
    [SensorsTask.h]
2023-11-26 many changes * added parameter "Modulation sync with heating" * refactoring
2023-11-28 upd ha scripts
    [report_outdoor_temp_to_controller_from_weather.yaml, report_temp_to_controller.yaml]
2023-12-02 modify task priority for ESP32, remove attach to core
2023-12-02 bump ESP32Scheduler to 1.0.1
2023-12-04 attach OT task to 1 core
2023-12-05 fix current temperature in climate.heating entity
    [HaHelper.h, MqttTask.h]
2023-12-06 added external pump control
2023-12-06 fix times ext pump
    [MainTask.h]
2023-12-07 fix ha scripts
    [report_outdoor_temp_to_controller_from_weather.yaml, report_temp_to_controller.yaml]
2023-12-07 ha scripts fix bug and compatibility with older versions
    [report_outdoor_temp_to_controller_from_weather.yaml, report_temp_to_controller.yaml]
2023-12-08 Add support for BLE temp sensors
2023-12-08 Prevent using deprecated type
    [OpenThermTask.h]
2023-12-09 fix typo in printf
    [OpenThermTask.h]
2023-12-09 fix exception due to mqtt client
    [MqttTask.h]
2023-12-09 fix publish non static ha entities
    [MqttTask.h]
2023-12-09 revert BufferedTelnetStream to ESPTelnetStream, reduced keep alive timeout for ESPTelnetStream
    [MainTask.h, main.cpp]
2023-12-10 Use `USE_BLE` flag to enable/disable BLE temp sensors
2023-12-13 bump ArduinoJson to 7.x, refactoring MqttTask
2023-12-14 fix heap monitoring on esp32
    [MainTask.h, main.cpp]
2023-12-15 Improve opentherm handling
    * First try setBoilerStatus, if it fails there is no need to request other info
    * Do not retry to get/set non-essential parameters that the boiler does not support
    [OpenThermTask.h]
2023-12-15 Fix Guru Meditation Error on esp32
2023-12-18 fix: change type for mqtt port in settings
    [Settings.h]
2023-12-19 feature: use pid in emergency mode
2023-12-20 fix: PID interval correction #23
    [RegulatorTask.h]
2023-12-20 feature: added settings.pid.dt, editable via mqtt
2023-12-21 fix: disable turbo mode if heating is off
    [RegulatorTask.h]
2023-12-21 fix: correction of PID coefficients limits
    [HaHelper.h, MqttTask.h]
2023-12-21 fix: log messages in RegulatorTask
    [RegulatorTask.h]
2023-12-21 fix: added timeout for wifi client
    [MqttTask.h]
2023-12-22 fix: rounding numbers in MqttTask
    [MqttTask.h]
2023-12-22 fix: rename entities #26 * Current heating min temp => Boiler heating min temp * Current heating max temp => Boiler heating max temp * Current DHW min temp => Boiler DHW min temp * Current DHW max te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
    [HaHelper.h, MqttTask.h]
2023-12-24 fix: correction pressure and DHW flow rate, if the received value is x10
    [OpenThermTask.h]
2023-12-25 fix: set device_class and unit_of_measurement for number.pid_dt
    [HaHelper.h]
2024-01-12 * feat: new portal & network manager * refactor: migrate from PubSubClient to ArduinoMqttClient * refactor: migrate from EEManager to FileData * chore: bump ESP Telnet to 2.2 * chore: bump TinyLogger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
2024-01-12 fix: calculating pid temperature in float, fixed #23
    [RegulatorTask.h]
2024-01-13 fix: automatic reboot if memory is too low
    [MainTask.h]
2024-01-13 refactor: additional checks when initializing sensors
2024-01-14 fix: updated connection logic to MQTT and enable/disable emergency mode
    [MqttTask.h]
2024-01-14 fix: opentherm polling interval reduced
    [main.cpp]
2024-01-14 refactor: sensors type settings moved to portal, entities for HA have been deleted; logging settings moved; bump version
2024-01-17 refactor: network management code moved to MainTask (memory optimization); removed stopping DHCP server and client on reset wifi
    [MainTask.h, MqttTask.h, PortalTask.h, main.cpp]
2024-01-17 chore: pcb upd
    [CPL.csv]
2024-01-17 chore: added partition file for esp32
    [esp32_partitions.csv]
2024-01-18 fix: data output via web server on ESP32 fixed
    [PortalTask.h]
2024-01-19 fix: set mqtt prefix before connection
    [MqttTask.h]
2024-01-22 style: indents changed
    [esp32_partitions.csv]
2024-02-01 fix: revert 20 ms wait before start bit
    [OpenThermTask.h]
2024-02-04 fix: added board_build.ldscript in platformio.ini for esp8266 boards
2024-02-05 fix: change channel to 6 for Wifi AP
    [Settings.h]
2024-02-23 fix: set temperature for sensors in manual mode fixed
    [SensorsTask.h]
2024-03-10 refactor: optimization * names changed: pin => gpio * ability to change OpenTherm GPIO without rebooting
    [MainTask.h, OpenThermTask.h, SensorsTask.h, Settings.h, defines.h, main.cpp, utils.h]
2024-03-14 refactor: added SensorType enum
2024-03-24 fix: revert board_build.ldscript for esp8266, update OpenTherm Library
2024-03-29 feat: polling of exhaust gas temperature (#42) and heating return temperature; added new sensors to HA
2024-03-30 fix: set max temp (ID57) as setpoint heating temp
    [OpenThermTask.h]
2024-03-31 fix: temperature_unit for climate fixed; temp in vars.parameters.* by default fixed
    [HaHelper.h, OpenThermTask.h]
2024-03-31 fix: fixed reading exhaust gas temperature
    [OpenThermTask.h]
2024-03-31 refactor: removed unused methods, replaced some methods to native
    [OpenThermTask.h]
2024-04-06 feat: added setting to enable/disable polling of min and max temperatures via opentherm
2024-04-06 feat: added support unit systems for pressure and flow rate
2024-04-06 fix: memory leak on esp32 fixed
2024-04-07 fix: rounding the DHW flow rate value
    [utils.h]
2024-04-07 chore: updated css framework
2024-04-11 fix: fixing button groups on the mobile version
2024-04-11 fix: reset onewire before begin (fix DS18B20)
    [SensorsTask.h]
2024-04-11 feat: added settings for status led gpio, opentherm rx led gpio, emergency treshold time
2024-04-11 fix: fixed thermostat temperature limits for different unit systems on dashboard
2024-04-14 fix: scan networks on s3 fixed
    [PortalTask.h]
2024-04-15 fix: serial on s2, s3 fixed
    [main.cpp]
2024-04-15 fix: fix set heating temp on ITALTHERM TIME MAX 30F
    [OpenThermTask.h]
2024-04-17 fix: PID optimization, correction of default PID settings
    [HaHelper.h, RegulatorTask.h, Settings.h, utils.h]
2024-04-22 feat: added native heating control by boiler; refactoring; emergency settings removed from HA
2024-04-23 fix: added set target indoor temp to CH2 for native heating control #58
    [OpenThermTask.h]
2024-04-23 feat: added board info on portal
2024-04-25 fix: equitherm with BLE indoor sensor in emergency mode fixed
    [RegulatorTask.h]
2024-05-24 fix: outdoor sensor GPIO validation fixed
    [SensorsTask.h]
2024-05-26 chore: bump platformio/framework-arduinoespressif32 to 2.0.17
2024-06-05 fix: conflicts with sdk 3.x.x for esp32 fixed
    [MainTask.h, PortalTask.h, main.cpp]
2024-06-06 fix: validation GPIO and reset wifi for arduino-esp32 core 3.x.x fixed
    [defines.h]
2024-06-10 feat: migrate to arduino-esp32 core 3.0.1
2024-06-14 chore: added nodemcu v3 board; changed default gpio for nodemcu 32s
2024-06-18 fix: use static IP at startup fixed #70
    [main.cpp]
2024-06-21 chore: Bump NimBLE-Arduino to 1.4.2 (#75)
2024-08-20 fix: text of action buttons fixed
2024-08-20 feat: added feat use of BLE external sensor; added events onIndoorSensorDisconnect and onOutdoorSensorDisconnect for emergency mode; added polling of rssi, humidity, battery for BLE sensors
2024-08-21 chore: bump bblanchon/ArduinoJson from 7.0.4 to 7.1.0
2024-08-22 chore: bump framework-arduinoespressif32 from 3.0.1 to 3.0.4
2024-08-22 fix: compatibility with framework-arduinoespressif32 version 3.0.4
2024-09-03 chore: added blueprints
    [report_outdoor_temp_to_controller_from_weather.yaml, report_temp_to_controller.yaml]
2024-09-06 chore: update files for production
    [BOM.xlsx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]
2024-09-30 chore: switch from espressif/arduino-esp32 to pioarduino/platform-espressif32 for new core
2024-09-30 fix: compatibility with framework-arduinoespressif32 version 3.0.5
2024-09-30 chore: switch from PaulStoffregen/OneWire to pstolarz/OneWireNg
2024-09-30 fix: added delay before start web server
    [PortalTask.h]
2024-09-30 chore: updated platformio.ini for ESP32 C6
2024-10-09 fix: added request for set opentherm version
    [OpenThermTask.h]
2024-10-10 feat: added opentherm option for filtering numeric values
2024-10-10 feat: added correction coeff. settings for pressure and dhw flow rate
    [OpenThermTask.h, Settings.h, defines.h, utils.h]
2024-10-10 fix: added min DHW flow rate of 0.1 l/min
    [OpenThermTask.h]
2024-10-13 refactor: cosmetic changes; added coeff. setting for filtering numeric values
2024-10-14 feat: added polling of min modulation and max boiler power; added sensor for current boiler power
2024-10-14 refactor: more logs; improved sensor of current boiler power: added settings min & max boiler power
2024-10-18 feat: fault state gpio setting replaced with cascade control
    [MainTask.h, OpenThermTask.h, Settings.h, strings.h, utils.h]
2024-10-18 fix: change of log level when wifi is not connected
    [MainTask.h]
2024-10-21 refactor: increased the max value of dt for pid to 1800 sec
2024-10-24 chore: bump framework-arduinoespressif32 from 3.0.5 to 3.0.6
2024-10-24 feat: added crash recorder and ability to save dump
    [CrashRecorder.h, PortalTask.h, main.cpp, utils.h]
2024-10-26 refactor: fix wifi scan on esp32, connection timeouts changed
    [PortalTask.h]
2024-10-26 fix: display of fault code and diag code in logs fixed
    [OpenThermTask.h]
2024-10-27 fix: fixed pressure and flow validation when using correction
    [OpenThermTask.h]
2024-10-30 refactor: reworked emergency mode; reworked hysteresis algorithm; improved detection of connection state for MANUAL & BOILER type sensors
    [HaHelper.h, MainTask.h, OpenThermTask.h, RegulatorTask.h, Settings.h, utils.h]
2024-10-31 feat: try to auto determine the min boiler power
2024-10-31 feat: improved turbo mode - added turbo factor parameter - implemented turbo mode for PID
2024-10-31 fix: fixed crash if BLE service not found #88
    [SensorsTask.h]
2024-10-31 fix: try to auto determine the min boiler power
    [OpenThermTask.h]
2024-10-31 chore: updated equitherm calculator
    [equitherm_calc.xlsx]
2024-10-31 refactor: removed resetting modulation and power if response not valid
    [OpenThermTask.h]
2024-10-31 feat: added entities to HA: connected, rssi, battery, humidity for indoor and outdoor sensors; some entities are disabled by default
2024-11-01 fix: for some HA entities added missing parameter enabled_by_default
    [HaHelper.h]
2024-11-01 feat: ability to use return heat carrier temp as indoor temp
2024-11-01 fix: hysteresis with native heating control has been fixed
    [OpenThermTask.h]
2024-11-09 refactor: dynamic sensors
2024-11-09 fix: polling ntc on esp8266 fixed
    [SensorsTask.h]
2024-11-09 fix: ``Sensors::cleanDallasInstances()`` fixed
2024-11-11 feat: added will msg for mqtt broker
    [MqttTask.h]
2024-11-11 fix: unit of dhw flow rate fixed
    [HaHelper.h]
2024-11-11 refactor: optimizations & fixes
    [HaHelper.h, MainTask.h, MqttTask.h, PortalTask.h, Sensors.h, Settings.h, utils.h]
2024-11-12 fix: display of current heating temp on dashboard
2024-11-12 fix: update target heating temp when restoring settings
    [utils.h]
2024-11-12 refactor: impoved sensors settings page
2024-11-12 refactor: imporved updating OT sensors
2024-11-12 feat: added signal quality for DALLAS sensors
2024-11-12 fix: added ``step`` to HA entities for ``Sensors::Type::MANUAL``
    [HaHelper.h]
2024-11-12 refactor: improved updating OT sensors
2024-11-13 fix: building without BLE fixed
    [main.cpp]
2024-11-14 feat: added more OT polled IDs & reformat code * ID79 - exhaust CO2 * ID84 - exhaust fan speed * ID85 - supply fan speed * ID29 - solar storage temp * ID30 - solar collector temp * ID35 - boiler fan 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
2024-11-14 refactor: rounding sensor values
2024-11-18 fix: fixed power calculation
    [OpenThermTask.h]
2024-11-20 fix: fixed ERR_CONNECTION_RESET for Chrome based browsers
    [PortalTask.h]
2024-11-20 fix: action state for HA ``climate`` entities fixed
    [HaHelper.h]
2024-12-01 feat: display sensor values on dashboard page
2024-12-02 fix: digest auth changed to basic Digest auth not working on ios #99
    [PortalTask.h]
2024-12-04 fix: typo in purpose of sensors for emergency mode
    [MainTask.h]
2024-12-04 fix: negative temperature values from BLE devices
    [SensorsTask.h]
2024-12-04 refactor: improved display of sensors on Dashboard
2024-12-07 chore: update pcb
    [BOM.xlsx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]
2024-12-17 refactor: OT option ``heatingCh2Enabled`` has been renamed to ``ch2AlwaysEnabled``
2024-12-17 chore: bump NimBLE-Arduino from 1.4.3 to 2.1.0
2024-12-17 refactor: compatibility with NimBLE-Arduino 2.1.x
2024-12-18 fix: ``Content-Length`` on esp32 for chunked response
2024-12-18 fix: BLE power 9 dbm with NimBLE-Arduino 2.1.x
    [SensorsTask.h]
2024-12-23 refactor: improved work with clones (not original) of DS18B20 sensors
2024-12-25 feat: added OT option ``Heating state as summer/winter mode``
2024-12-30 chore: bump bblanchon/ArduinoJson from 7.1.0 to 7.3.0
2024-12-30 refactor: compatibility with ArduinoJson 7.3.0
2025-01-04 refactor: added OT bus reset; increased timings for changing OT status
    [OpenThermTask.h]
2025-01-04 chore: update pcb for smt
    [BOM.xlsx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]
2025-01-05 feat: added OT option ``Sync max heating temp with target temp``
2025-01-08 feat: add support board "OT Thing" (#123)
    * Add board "OT Thing"
    * style: formatting
    ---------
2025-01-12 refactor: sensors pos from 1 on ``Sensors settings`` page
2025-01-13 refactor: improved OT bus reset
    [OpenThermTask.h]
2025-01-20 fix: ``inputmode`` attribute fixed for pid min temp on settings page
2025-01-23 feat: added deadband for pid
2025-01-24 refactor: trying to improve connection to BLE devices
2025-01-24 refactor: added ``CONFIG_BT_NIMBLE_EXT_ADV=1`` to ``build_flags`` for esp32 s3, esp32 c3
2025-01-24 fix: sensors pos from 1 on Sensors settings page
2025-01-24 refactor: default pid coefficients changed
2025-01-24 chore: locale correction for pid deadband
2025-01-24 fix: increase keep alive timeout for mqtt #115
    [MqttTask.h]
2025-01-29 refactor: reworked BLE sensors * add clean unused ble instances * moved subscribe to notify to another method * set date/time on BLE sensors
    [SensorsTask.h, utils.h]
2025-02-03 refactor: allow up to 100x correction of sensor values (#137)
    [utils.h]
2025-02-17 fix: working with ``Sensors::Type::MANUAL`` sensors fixed
    [MqttTask.h, PortalTask.h]
2025-03-04 refactor: status BLE sensors
2025-03-06 refactor: heating temperature step changed * step changed to 0.1 * added processing of long presses on thermostats in the dashboard
2025-03-06 refactor: BLE device support for ESP32 C6 (#147)
    Building on ``Arduino``+``ESP-IDF`` with ``h2zero/esp-nimble-cpp`` for ESP32 C6
2025-03-14 refactor: improved work with opentherm on esp32
2025-03-18 fix: ``OpenThermTask::setMaxHeatingTemp(const uint8_t temperature)`` changed to OpenThermTask::setMaxHeatingTemp(const float temperature)
    [OpenThermTask.h]
2025-03-26 refactor: rounding ``heating.setpointTemp``
2025-05-07 fix: restarting on critically low heap #151
    [MainTask.h]
2025-05-18 fix: removed ``device_class`` for signal quality entities for compatibility with HA 2025.7.0
    [HaHelper.h]
2025-05-18 refactor: reworked the setting of the maximum modulation level, added the parameter of the maximum modulation level for DHW
    [OpenThermTask.h, Settings.h, strings.h, utils.h]
2025-05-18 refactor: increased max. target indoor temp. from 30 to 40 degrees (for control by return temperature)
2025-05-18 feat: added OT options: ignore diag state, auto fault reset, auto diag reset
    [OpenThermTask.h, Settings.h, strings.h, utils.h]
2025-05-19 feat: added new purpose (number) for sensors and added polling for OpenTherm statistical IDs New sensor types: * Number of burner starts * Number of burner starts (DHW) * Number of pump starts (heati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
    [OpenThermTask.h, Sensors.h, Settings.h, utils.h]
2025-05-19 fix: set month of date to OT fixed
    [OpenThermTask.h]
2025-05-19 fix: changed default value of slave max modulation to 0
    [Settings.h]
2025-05-20 fix: revert default value of slave max modulation; always set max modulation level Baxi Ampera resets the maximum modulation level to 0 when the heating is turned off
    [OpenThermTask.h, Settings.h]
2025-05-22 fix: build for ESP32 C6
2025-06-08 fix: last sensor was ignored
    [Sensors.h]
2025-06-17 feat: added software overheating protection
    [OpenThermTask.h, Settings.h, strings.h, utils.h]
2025-06-19 fix: added C/F temperature conversion in overheating protection
    [OpenThermTask.h]
2025-06-26 feat: added freeze protection parameter for heating, removed forced start of heating in emergency mode #157
2025-06-28 refactor: added print to log channel 2 activity state #155
2025-06-29 refactor: fixed logo size on mobile devices
2025-06-29 refactor: improved freeze protection & overheat protection; added desc for OT options
    [MainTask.h, OpenThermTask.h, Settings.h, strings.h, utils.h]
2025-07-03 feat: added Chinese locale by @menyuguren #163
    * Add files via upload
    支持中文
    * fix typo
    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
2025-07-04 chore: updated esp32.py to be compatible with new versions of esptool Source: https://raw.githubusercontent.com/letscontrolit/ESPEasy/mega/tools/pio/post_esp32.py
2025-08-04 chore: updated esp32.py Source: https://raw.githubusercontent.com/letscontrolit/ESPEasy/mega/tools/pio/post_esp32.py
2025-09-19 fix: added ``nodemcu_32_160mhz`` env, deadband usage in PID fixed (#176)
    * Small fixes: CPU limit for odemcu_32, deadbamd usage in PID
    * PR review fixes
    * Fix: remove spaces
    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
    [RegulatorTask.h]
2025-09-23 fix: various fixes Found by PVS-Studio
    [Sensors.h, SensorsTask.h, Settings.h, utils.h]
2025-10-03 fix: rollback NimBLE-Arduino from 2.3.6 to 2.3.3
2025-10-03 refactor: not initialize Bluetooth if BLE sensors are not used
2025-10-09 refactor: improved work with BLE sensors
2025-10-14 refactor: reset BLE/DALLAS address if not valid
    [utils.h]
2025-11-02 fix: compatibility with HA 2025.10+ fixed #189
    [HaHelper.h]
2025-11-12 fix: generation of `default_entity_id` for HA fixed
    [HaHelper.h]
2025-12-09 Implementation of the new Equitherm algorithm (#146)
    * feat: new equitherm algorithm and chart for it (#144)
    * refactor: refactoring after #144
    * refactor: cosmetic changes (equitherm chart)
    * chore: fix typo
    * refactor: cosmetic changes
    * chore: remove unused files
    * chore: resolve conflicts
    * refactor: added notes for equitherm parameters
    * fix: decimation for Equitherm chart fixed; chartjs updated
    * style: HTML code formatting
    * chore: added additional description of the ``T`` parameter for Equitherm
    * flx: typo
    * refactor: after merge
    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
    [HaHelper.h, MqttTask.h, RegulatorTask.h, Settings.h, strings.h, utils.h]
2025-12-09 Advanced hysteresis settings (#201)
    * feat: added more hysteresis settings
    * fix: heating hysteresis switch fixed
    * refactor: added localization for hysteresis
    [HaHelper.h, MqttTask.h, OpenThermTask.h, RegulatorTask.h, Settings.h, defines.h, strings.h, utils.h]
2025-12-09 chore: bump h2zero/NimBLE-Arduino from 2.3.3 to 2.3.7
2025-12-12 feat: added OT option `alwaysSendIndoorTemp`, rename `nativeHeatingControl` to `nativeOTC` (#204)
    * added option to always send the current and target indoor temp, even if the current heating mode doesnt officially need it. This is a direct fix for WeHeat heatpumps which seem to require it.
    * add option to AlwaysSendIndoorTemp and rename NativeHeatingControl to
    NativeOTC.
    Updated locals and settings page.
    * change minor order
    [MainTask.h, OpenThermTask.h, RegulatorTask.h, Settings.h, strings.h, utils.h]
2025-12-13 fix: OT protocol version in JSON of slave fixed
    [utils.h]
2025-12-13 feat: added sensor type "OT, Cooling hours"
2025-12-13 refactor: always set temperature to ID 1
2025-12-23 feat: dynamic filenames for backup/debug (#207)
    * feat: generate dynamic filenames for JSON file downloads (backup and debug) based on hostname and timestamp
    * fix: threadsafe getFilename
    [PortalTask.h]
2026-01-22 fix: filtering fake data from ds18b20 (#217)
2026-01-25 refactor: added different timeouts for wired and wireless sensors
2026-01-25 chore: fix ha blueprints to support all source sensors
2026-02-15 fix: `custom_sdkconfig` only for ESP32 C6
2026-02-16 feat: added support DHT11/DHT22 sensors (#223)
    * feat: Added support DHT11/DHT22 sensors
    * chore: formatting
    * fix: typo
    * fix: `HaHelper::publishDynamicSensor()` for DHT sensors fixed
    * refactor: optimization of wired sensors
    [HaHelper.h, MqttTask.h, RegulatorTask.h, Sensors.h, SensorsTask.h, strings.h, utils.h]
2026-05-10 refactor: BLE scanning instead of connecting to BLE devices (#243)
    * refactor: passive scan instead of connecting to BLE devices
    * refactor: increased disconnected timeout for sensors
    * fix: build for nodemcu32, c3, c6 boards; formatting ``platformio.ini``
    * refactor: decreased interval and window for scanning BLE
    * refactor: active + passive BLE scanning
    * refactor: reduced tasks stack size
    * refactor: improved OTA upgrade
    https://github.com/ESP32Async/ESPAsyncWebServer/pull/329
    * chore: fix dependencies
    * chore: reformat `platformio.ini`
    * chore: dependencies fixed
    * feat: added support BTHome v2 format for BLE sensors #215
    * f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
    [MainTask.h, OpenThermTask.h, RegulatorTask.h, SensorsTask.h]
2026-05-16 refactor(translation): updated Russian language (#245)
    Currently translated at 100.0% (346 of 346 strings)
    Translation: OTGateway/Portal
    Translate-URL: https://hosted.weblate.org/projects/otgateway/portal/ru/
2026-05-16 refactor(translation): updated English language
    Translate-URL: https://hosted.weblate.org/projects/otgateway/portal/en/
    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
2026-05-16 refactor(translation): updated Italian language
    Translate-URL: https://hosted.weblate.org/projects/otgateway/portal/it/
    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
2026-05-16 refactor(translation): updated Chinese (Simplified Han script) language
    Translate-URL: https://hosted.weblate.org/projects/otgateway/portal/zh_Hans/
    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
2026-05-16 refactor(translation): updated Dutch language
    Translate-URL: https://hosted.weblate.org/projects/otgateway/portal/nl/
    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
2026-05-16 feat: added choice of averaging type for indoor and outdoor temperatures (#244)
    * feat: added a choice of averaging type for indoor and outdoor temperatures
    * refactor: locales updated
    * refactor: some changes
2026-05-17 refactor: use `localtime_r(...)` for thread safety
2026-05-19 refactor(translation): update translation files (#249)
    * feat(translation): added Estonian language
    * refactor(translation): updated Chinese (Simplified Han script) language
    Currently translated at 100.0% (355 of 355 strings)
    * refactor(translation): updated Russian language
    Currently translated at 100.0% (355 of 355 strings)
    * refactor(translation): updated Dutch language
    Currently translated at 100.0% (355 of 355 strings)
    Translate-URL: https://h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
2026-11-11 feat: Implement W5500 SPI ethernet support (#286)
    * feat: implement feature gate & w5500 SPI ethernet
    * feat: eth conn restart handling, wifi-ap connection type, BLE sensor
    gate
    * fix: bring eth down when disabled
    * fix: disable WiFi scan when ethernet is active
    * feat: refactor uplink types into separate classes
    * fix: compare enum, not string
    * chore: remove dead code
    * fix: remove out of scope persistNow(), move w5500 to networksettings,
    add base for future ethernet implementations
    * fix: keep wifi armed while reconnecting, reset IP when moving from
    static to DHCP, refactor wifi loop to use return
    * fix: clear out connectionType string for enum
